ajisrawi/passive-radar-counter-drone/hardware/antenna/ANTENNA.md

# Antennas — multiband passive radar (TV + 4G + 5G)

Generated by `antenna_design.py` (closed-form design equations and array-factor math; all numbers are in
`design.json`). There is no EM simulation behind these numbers: **every element must be checked on a VNA and
trimmed** (see *Tuning*). The pattern figures use an infinite-reflector model, so they show the front
half-space only.

## What one site needs

Each Board A2 build (one per band group) takes 6 SMA inputs:

| A2 input | Antenna | Points at |
|---|---|---|
| CH0 | Reference LPDA | Stack A's transmitter |
| CH1–CH4 | Surveillance panel, 4 elements | The protected sector, away from the transmitters |
| CH5 (the spare) | Second reference LPDA | Stack B's transmitter, when it is on another mast (e.g. UHF: the TV tower for stack A, an LTE B20 site for stack B). If both stacks use the same mast, split CH0's antenna instead, or use CH5 as an elevation element above CH1 |

| Band group | Services | Surveillance panel | Reference |
|---|---|---|---|
| `uhf` 470–821 MHz | DVB-T, LTE B28/B20, 5G n28 | 4 bowtie dipoles, 180 mm pitch | LPDA-U (aluminium) |
| `mid` 1805–2170 MHz | LTE B3, B1 | 4 dipoles, 69 mm pitch | LPDA-H (PCB) |
| `high` 2496–2690 MHz | LTE B7, 5G n41 | 4 dipoles, 56 mm pitch | LPDA-H (PCB) |
| `n78` 3300–3800 MHz | 5G n78 | 4 dipoles, 39 mm pitch | LPDA-H (PCB) |

One LPDA-H design (1.7–4.0 GHz) serves all three 4G/5G groups. Build one per base-station mast used.

## Polarization: +45° slant everywhere

The DVB-T polarization at the site is unknown, so every element and both LPDAs are tilted +45°:
- **4G/5G:** base stations transmit on ±45° cross-polar ports, so a +45° antenna matches one port fully.
- **DVB-T:** a +45° antenna receives either horizontal or vertical TV with a 3 dB loss. That costs about 16% of TV detection range.

If you later learn the TV polarization, you can rotate the UHF elements' stems by 45° to match it. The reflector and pitch stay the same.

## Surveillance element: slant dipole with built-in balun over a flanged reflector

```
     front-face arm (RF) ◄──────┐┌──────► back-face arm (GND)       rotated +45° in the reflector plane
                                ││  ← stem: front strip widens 2.81 → 4 mm, back ground narrows 12 → 4 mm
                                ││     (microstrip-to-parallel-strip taper over the stem height = the balun)
   ════════════════════════════╡╞════════════════════  reflector, slot 16.4 × 2 mm, notches on the stem mark it
                                └┘ edge-mount SMA, behind the reflector
```

- **Board:** FR-4, 1.6 mm, 2 layers, standing at right angles to the reflector. One T-shaped PCB per element.
- **Type:** a double-sided printed dipole, so no vias are needed in the RF path.
- **Front face (net RF):** a 50 Ω microstrip, 2.81 mm wide by OpenBoard's field solver, runs from the SMA up the stem. It widens to a 4 mm parallel strip and becomes the left arm.
- **Back face (net GND):** the microstrip's 12 mm ground narrows to 4 mm along the stem and becomes the right arm.
- **Balun:** the taper runs over the stem height above the reflector, about λ/4. That taper is the balun.

| | `uhf` | `mid` | `high` | `n78` |
|---|---|---|---|---|
| Arm shape | bowtie (w → 2w) | strip | strip | strip |
| Resonance (MHz) | 559 | 1979 | 2591 | 3541 |
| Dipole length, tip to tip (mm) | 221.6 | 54.4 | 40.6 | 29.1 |
| Arm width w at the gap (mm) | 41.0 | 7.6 | 5.8 | 4.2 |
| Arm centre line above reflector (mm) | 120.7 | 37.9 | 28.9 | 21.2 |
| Balun taper length (mm) | 78.7 | 33.1 | 25.0 | 18.1 |
| Element PCB, overall (mm) | 227.6 × 176.7 | 60.4 × 56.7 | 46.6 × 46.8 | 35.1 × 38.3 |
| Reflector plane, from the top edge (mm) | 164.7 | 44.7 | 34.8 | 26.3 |
| Expected match | VSWR < 2 over ~520–821 MHz, < 3 at 470 MHz | VSWR < 2 | VSWR < 2 | VSWR < 2 |

The 54% UHF band is the hard case. The bowtie is sized to resonate at 0.9 × the band centre (559 MHz), so the bottom of the TV band isn't far below resonance. The expected cost is about 1.2 dB of mismatch loss at 470 MHz.

## Panel (reflector) and array

- **Element positions:** 4 elements on one reflector, at the pitch below (λ/2 at the top of each band).
- **Reflector length:** the array length plus 0.75 × the reflector width.
- **Flanges:** folded back along both long edges. With the reflector width of ≥ 0.8 λ, they are what gives the ≥ 20 dB front-to-back that the direct-signal budget needs (DESIGN.md §5).

| | `uhf` | `mid` | `high` | `n78` |
|---|---|---|---|---|
| Pitch d (mm) | 180 | 69 | 56 | 39 |
| Reflector L × W (mm) | 851 × 415 | 298 × 121 | 237 × 93 | 168 × 68 |
| Flange height (mm) | 72 | 23 | 17 | 13 |

Predicted performance (model, band low / centre / high):

| | `uhf` | `mid` | `high` | `n78` |
|---|---|---|---|---|
| Element gain (dBi) | 7.3 / 6.6 / 6.3 | 6.8 / 6.5 / 6.2 | 6.6 / 6.5 / 6.4 | 6.7 / 6.5 / 6.3 |
| Element beamwidth, azimuth (°) | 85 / 95 / 116 | 93 / 97 / 103 | 95 / 97 / 100 | 94 / 98 / 102 |
| Array beam at broadside (°) | 48 / 36 / 27 | 32 / 29 / 26 | 28 / 27 / 26 | 31 / 29 / 27 |
| Sidelobes at broadside (dB) | −33 / −18 / −12 | −16 / −15 / −13 | −15 / −14 / −14 | −16 / −15 / −14 |
| Sidelobes / scan loss steered to ±50° | −10 / 4.3 dB … −10 / 1.6 dB | ≈ −9 / 3 dB | ≈ −9 / 3 dB | ≈ −9 / 3 dB |
| Grating lobes | none | none | none | none |

**Coverage:** the usable sector per panel is **±50°** (100°). Beyond that, sidelobes rise and scan loss passes 3 dB. For 360°, use **4 panels per band**, or several sites. At the bottom of the UHF band (d = 0.28 λ), the beam widens to 48°, so TV direction finding there is coarser. Bistatic-range multilateration across several transmitters (DESIGN.md §7) covers for it.

Figures: `panel_<band>.png` (front view to scale) and `patterns_<band>.png` (element and array patterns at band low/centre/high, steered 0° and 45°).

## Reference antennas: log-periodic dipole arrays (Carrel design, τ = 0.88, σ = 0.16, α = 10.6°)

| | LPDA-U | LPDA-H |
|---|---|---|
| Band | 450–870 MHz | 1700–4000 MHz |
| Dipoles | 11 | 12 |
| Boom length (mm) | 622 | 168 |
| Longest / shortest dipole (mm) | 323 / 90 | 83.3 / 20.4 |
| Build | aluminium twin boom (below) | printed twin boom, FR-4 1.6 mm, 180.1 × 89.3 mm |
| Gain / front-to-back (typical for these τ, σ) | ≈ 7.5 dBi / ≈ 18 dB | ≈ 7.5 dBi / ≈ 18 dB |

Dipole lengths, longest first (mm):
- **LPDA-U:** 323.1, 284.3, 250.2, 220.2, 193.8, 170.5, 150.1, 132.0, 116.2, 102.3, 90.0
- **LPDA-H:** 83.3, 73.3, 64.5, 56.8, 50.0, 44.0, 38.7, 34.0, 30.0, 26.4, 23.2, 20.4

Spacings, from the long end (mm):
- **LPDA-U:** 103.4, 91.0, 80.1, 70.5, 62.0, 54.6, 48.0, 42.3, 37.2, 32.7
- **LPDA-H:** 26.7, 23.5, 20.6, 18.2, 16.0, 14.1, 12.4, 10.9, 9.6, 8.4, 7.4

How they're built:
- **LPDA-U:**
  - two 12 mm square aluminium booms, 8 mm apart;
  - 4 mm rod half-elements alternating between the booms;
  - semi-rigid coax run inside one boom (an "infinite balun"), fed at the short end, with the booms shorted at the long end.
- **LPDA-H:**
  - the same structure printed on FR-4: a 3 mm boom on each face (RF in front, GND behind), with 1.5 mm half-dipoles;
  - each dipole has one half on the front face and one on the back, swapping sides from one dipole to the next (the feed transposition);
  - fed by an edge-mount SMA at the short end. Run the cable back along the boom's centre line, where the dipoles' fields cancel.

**Mounting:** tilt each reference +45° to match the panels, aim it at its transmitter, and mount it on the far side of the mast from the surveillance panels.

**Gain check:** DESIGN.md §5 assumed a 12 dBi reference Yagi, giving a reference SNR of +70.8 dB. With 7.5 dBi it's about +66 dB. That's still well above the requirement of +53.8 dB, which is the direct-signal level in the surveillance channel plus 10 dB. The 4G/5G cells are usually much closer than the TV tower, so their margin is larger.

## Cables and calibration

Board A2's noise source calibrates everything from its input switch onward. **The antenna cables are outside that calibration.**

- **Cables:** use a phase-matched set for CH1–CH4 (±2° at the top of the band, e.g. LMR-240 or RG-402 cut as one batch), of equal length.
- **Residual cable error:** remove it with a one-time far-field calibration. The direct signal from the transmitter, whose bearing is known from the map, is a free calibration source; repeat it after any cable change.
- **Mutual coupling:** about −15 dB between neighbouring elements at λ/2. The same far-field calibration (a coupling matrix measured at a few known bearings) removes it for DOA.

## Tuning (VNA)

1. **Resonance:** trim both arm tips equally (copper and board together) until S11 has its minimum at the resonance in the table. If the resonance comes out low, that's the fix. If it's high, change `dipole_length_mm` in `antenna_design.py` and regenerate.
2. **Match:** the balun has no stub to trim. If S11 is poor across the band, change the 4 mm parallel-strip width (`W_PS` in `antenna_pcbs.py`). Wider lowers the feed impedance. Target VSWR < 2; for UHF, < 3 at 470 MHz is expected.
3. **Front-to-back:** check against the transmitter with the panel facing away. If it's below 20 dB, raise the flanges, or add an RF fence or terrain shielding (DESIGN.md §6.1).
4. **LPDAs:** if the low end is weak, trim the shortest dipoles last. S11 at the low edge is set by the longest dipole.
5. **Radome:** do steps 1–2 with the radome cover fitted, since it pulls resonance down slightly. See `RADOME.md`.

## Radomes

All four surveillance panels share one radome. The UHF panel is on top, the three 4G/5G panels sit in a row below, and there is one aluminium tray and one moulded GRP cover: 3 mm over UHF, 2 mm over the 4G/5G window, with a rib between. Separate per-panel radomes remain an alternative. The LPDA-H gets an ASA paddle radome. Dry loss is under 0.45 dB in every band out to ±50°, and a water film costs up to 2.9 dB at n78. Sizes, losses, wind loads and renders are in `RADOME.md`.

## Limits of this design

- **No EM simulation:** you chose formulas only. Gain, beamwidth and sidelobes come from a thin-dipole, infinite-reflector model. Real panels will have about 1 dB less gain at band edges, and their front-to-back depends on the flange details.
- **Matching estimates** come from published results for printed dipoles of this kind, not from calculation. Plan one test build per band before ordering a full set.
- **Sheet metal is drawing-only:** the reflectors, flanges and LPDA-U are given as dimensions, not CAD files.

## PCBs (OpenBoard)

Generated by `antenna_pcbs.py` from `design.json`, into `pcb/<name>/`. Each folder has:
- the OpenBoard project;
- `fab/<name>-fab.zip` (Gerbers and drill);
- `fab/<name>-BOM.csv` and `fab/<name>-CPL.csv`;
- a copper preview `<name>.png`;
- `<name>_openems.py`, a full-wave openEMS model of the copper with a port at the SMA. You can run it later if you install openEMS.

| Board | Size (mm) | DRC | Parts |
|---|---|---|---|
| `dipole_uhf` | 227.6 × 176.7 | 0 errors | 1 × edge SMA |
| `dipole_mid` | 60.4 × 56.7 | 0 errors | 1 × edge SMA |
| `dipole_high` | 46.6 × 46.8 | 0 errors | 1 × edge SMA |
| `dipole_n78` | 35.1 × 38.3 | 0 errors | 1 × edge SMA |
| `lpda_h` | 180.1 × 89.3 | 0 errors | 1 × edge SMA |

- **Build:** order as FR-4 1.6 mm, 2 layers, 1 oz, any colour.
- **Antenna copper:** fixed copper shapes (static zones), so the Gerbers carry it exactly as drawn.
- **Connector:** an edge-mount SMA for 1.6 mm boards (Samtec SMA-J-P-H-ST-EM1 footprint), soldered on both faces. Its back legs have their own pads, marked DNP so they stay out of the BOM.
- **Quantities per site:** 4 elements per band and panel (×4 panels for 360°), plus 1 LPDA-H per 4G/5G base-station mast used.
- **50 Ω width:** 2.81 mm, field-solved for this stack-up (εr 4.4, 1.53 mm core). The 3.08 mm Hammerstad estimate earlier in this file is superseded.
