ajisrawi/passive-radar-counter-drone/hardware/antenna/lpda_H.png

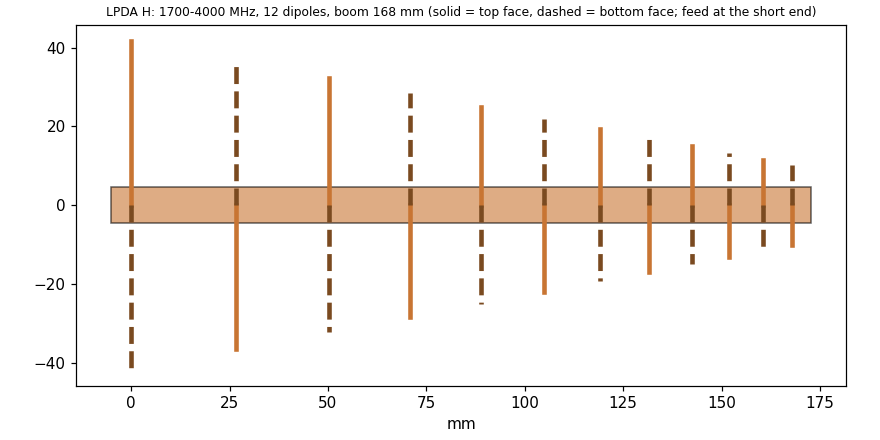
hardware/antenna/lpda_H.png
