ajisrawi/passive-radar-counter-drone/hardware/antenna/lpda_U.png

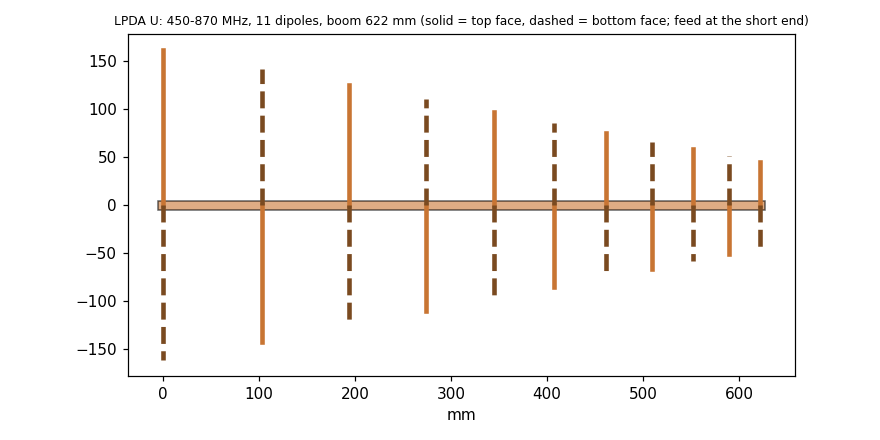
hardware/antenna/lpda_U.png
