ajisrawi/passive-radar-counter-drone/hardware/antenna/panel_high.png

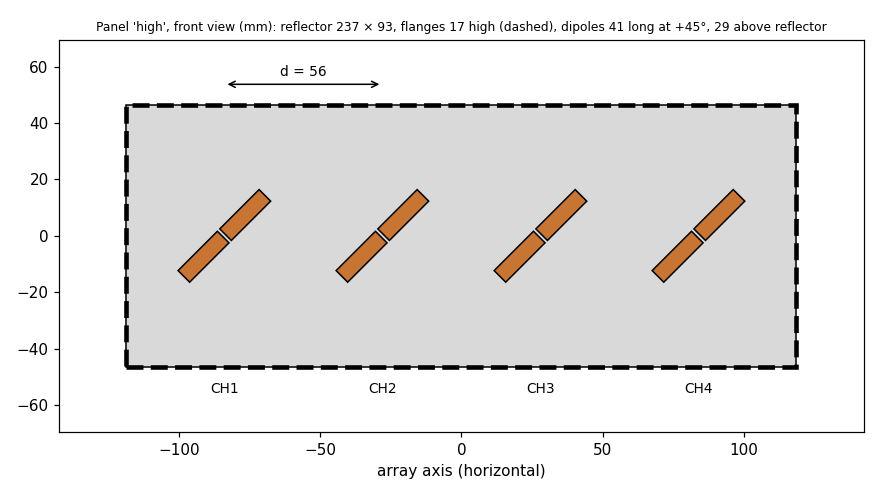
hardware/antenna/panel_high.png
