ajisrawi/passive-radar-counter-drone/hardware/antenna/panel_mid.png

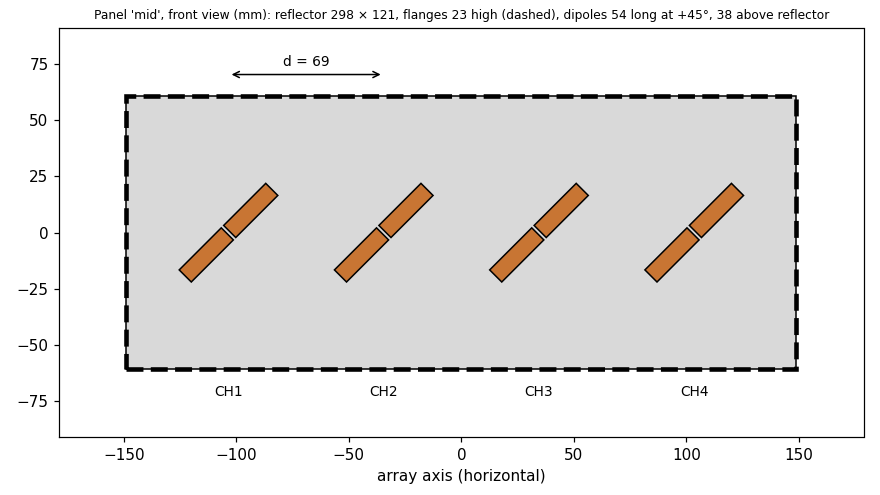
hardware/antenna/panel_mid.png
