ajisrawi/passive-radar-counter-drone/hardware/antenna/panel_n78.png

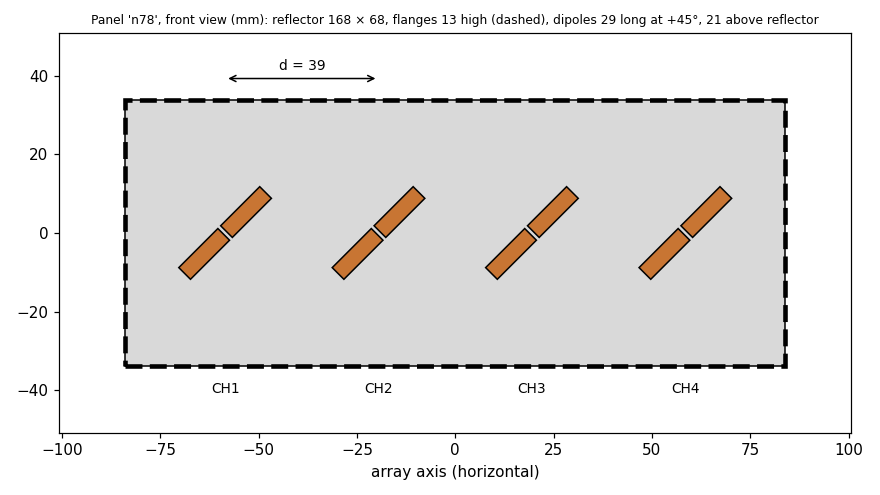
hardware/antenna/panel_n78.png
