ajisrawi/passive-radar-counter-drone/hardware/antenna/panel_uhf.png

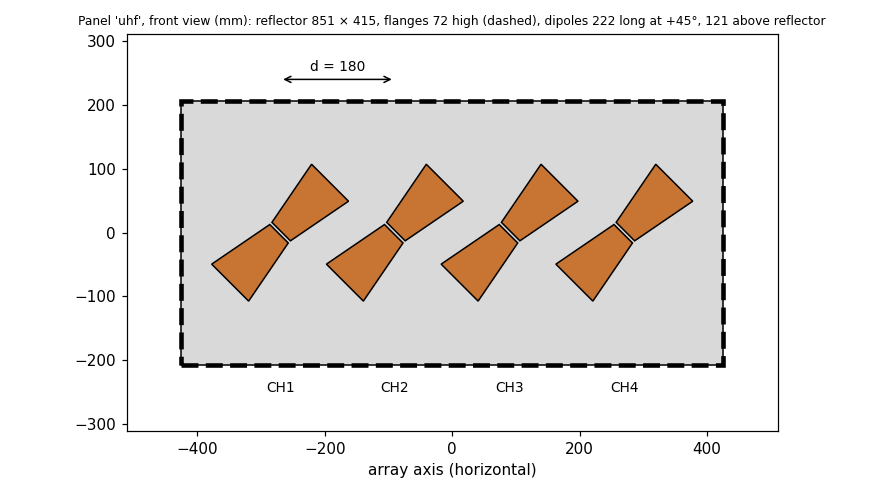
hardware/antenna/panel_uhf.png
