ajisrawi/passive-radar-counter-drone/hardware/antenna/patterns_high.png

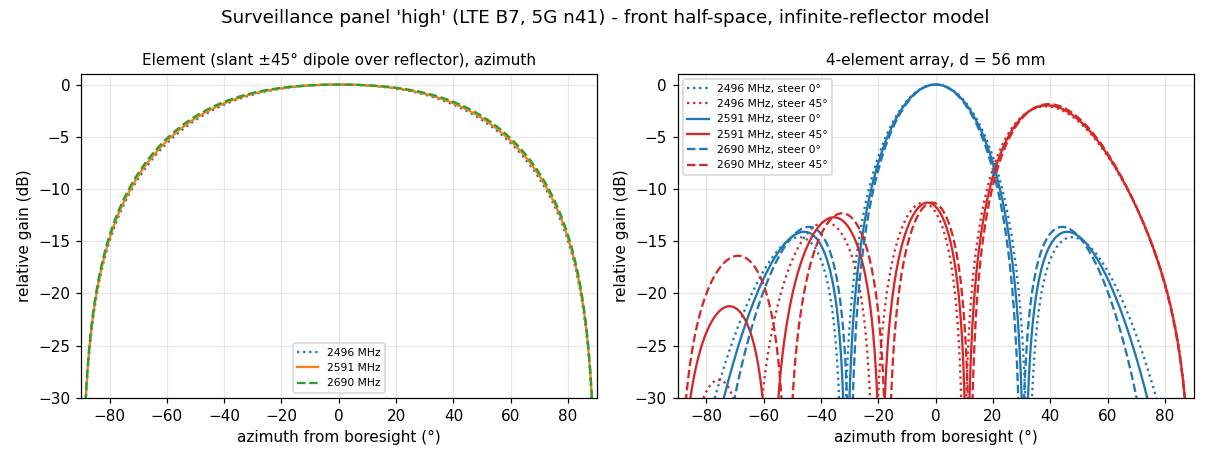
hardware/antenna/patterns_high.png
