ajisrawi/passive-radar-counter-drone/hardware/antenna/patterns_mid.png

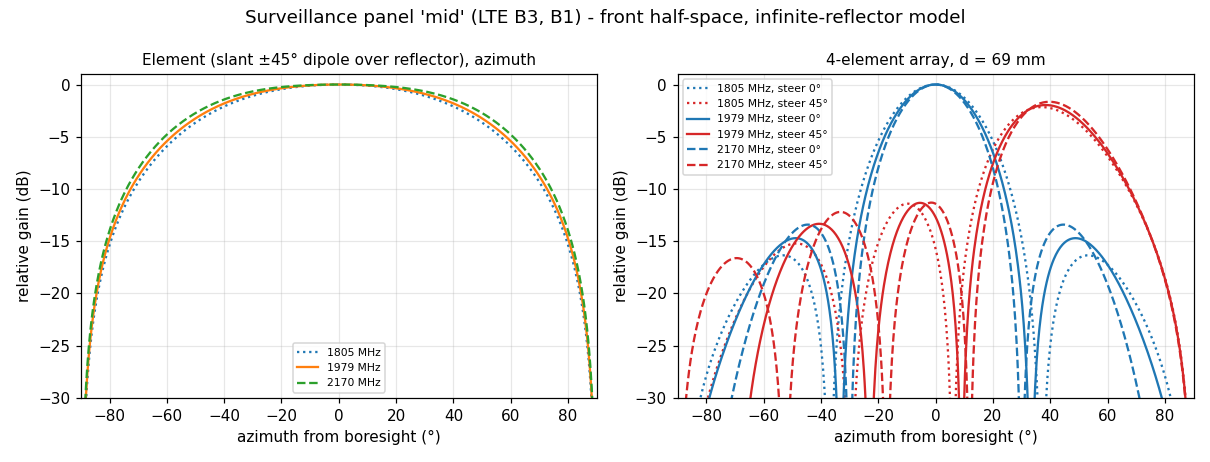
hardware/antenna/patterns_mid.png
