ajisrawi/passive-radar-counter-drone/hardware/enclosure/render_exterior.png

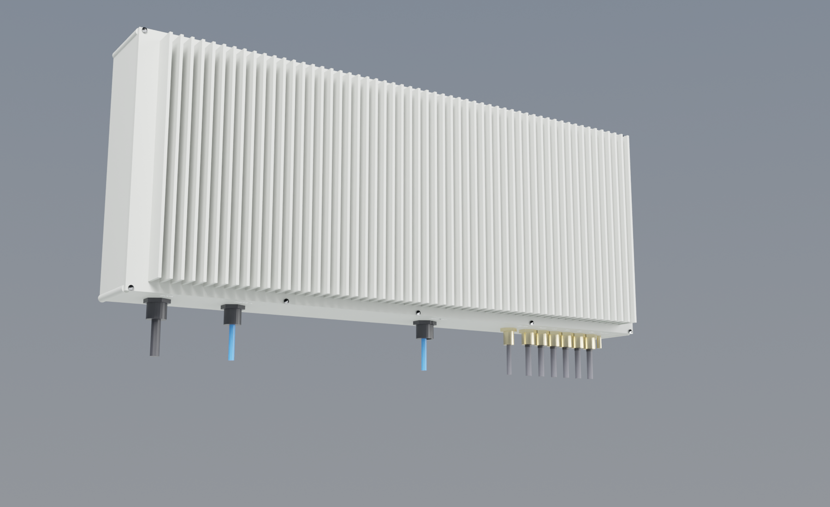
hardware/enclosure/render_exterior.png
