ajisrawi/passive-radar-counter-drone/hardware/enclosure/render_interior.png

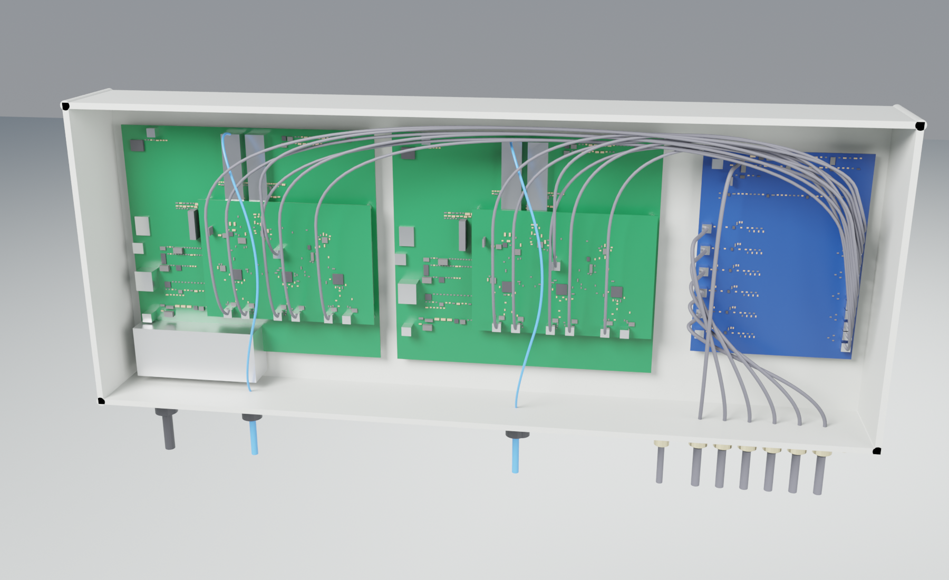
hardware/enclosure/render_interior.png
