ajisrawi/passive-radar-counter-drone/hardware/enclosure/render_mast.png

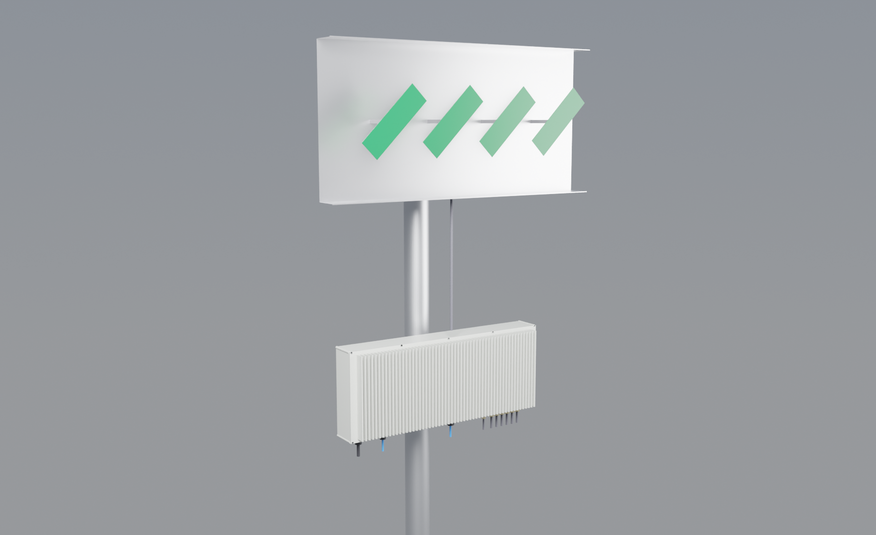
hardware/enclosure/render_mast.png
