ajisrawi/passive-radar-counter-drone/hardware/release/board_a/board_a_bottom.png

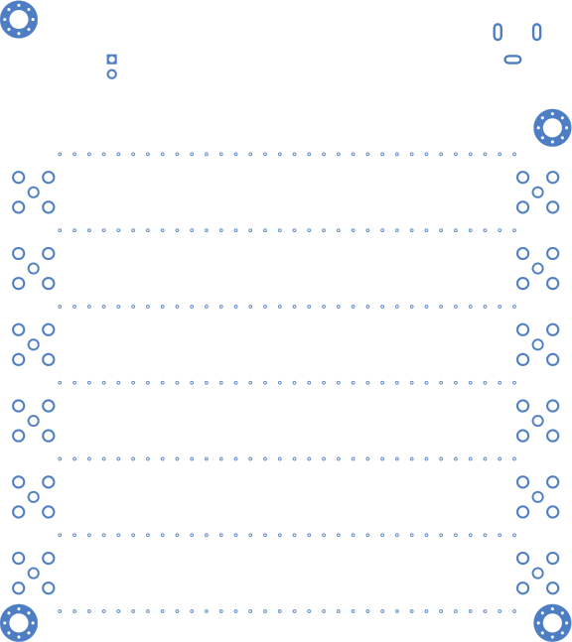
hardware/release/board_a/board_a_bottom.png
