ajisrawi/passive-radar-counter-drone/hardware/release/board_a/board_a_top.png

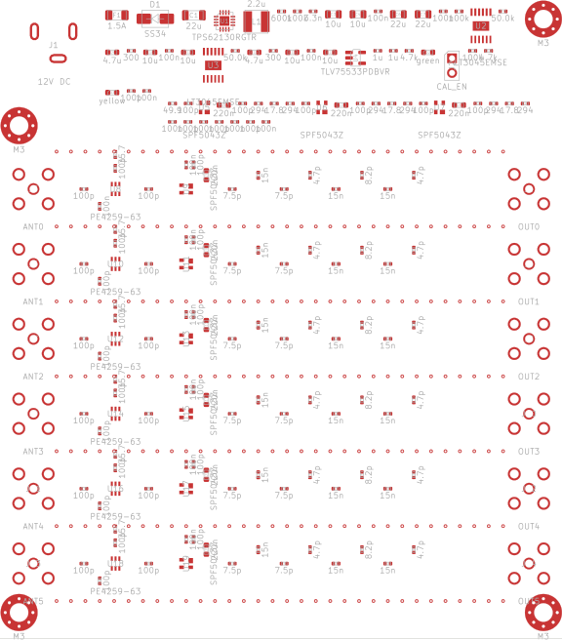
hardware/release/board_a/board_a_top.png
