ajisrawi/passive-radar-counter-drone/hardware/release/board_b/board_b_bottom.png

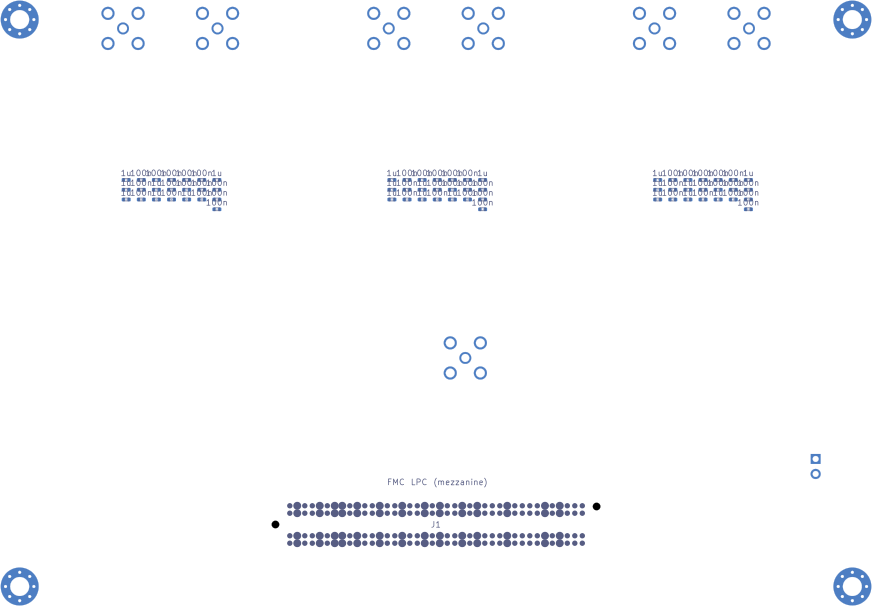
hardware/release/board_b/board_b_bottom.png
