ajisrawi/passive-radar-counter-drone/hardware/release/board_b/board_b_top.png

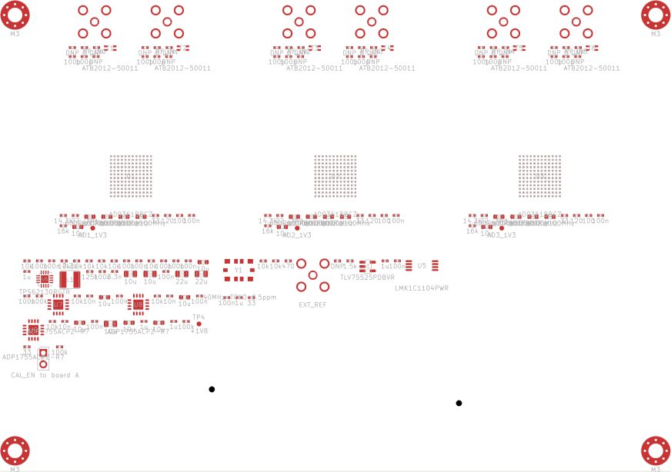
hardware/release/board_b/board_b_top.png
