ajisrawi/passive-radar-counter-drone/hardware/release/board_c/board_c_bottom.png

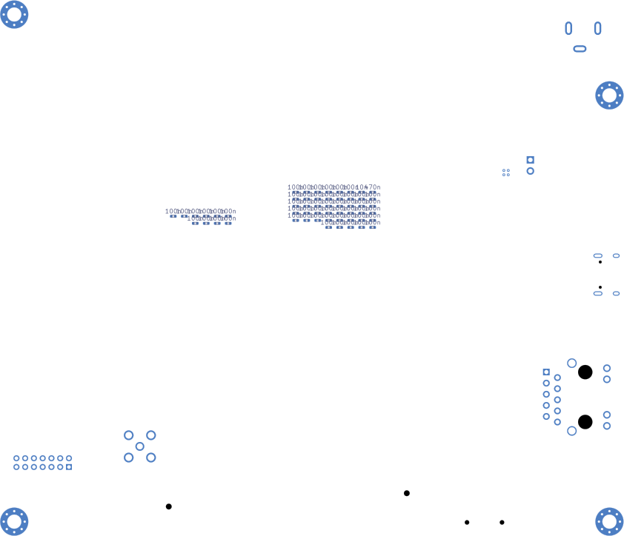
hardware/release/board_c/board_c_bottom.png
