ajisrawi/passive-radar-counter-drone/hardware/release/board_c/board_c_top.png

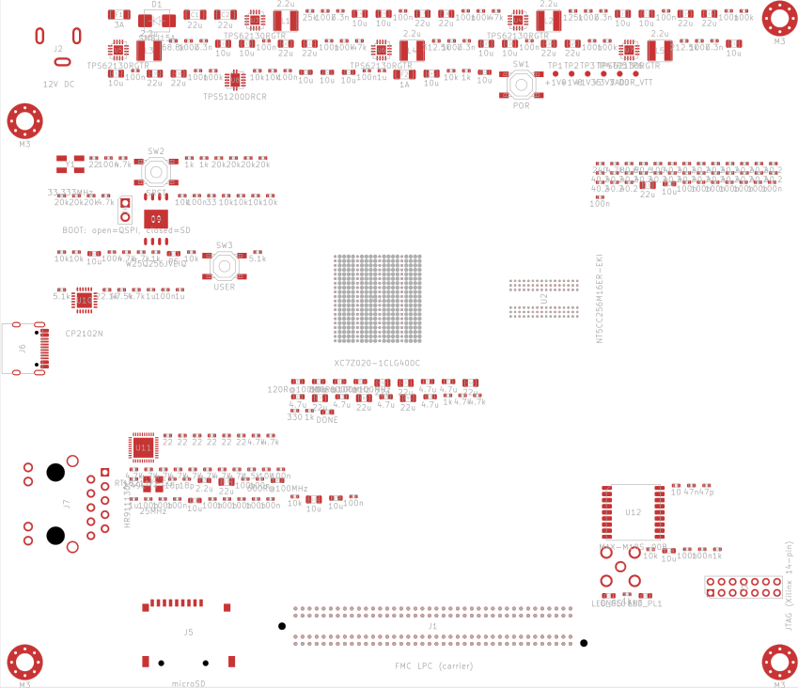
hardware/release/board_c/board_c_top.png
