ajisrawi/passive-radar-counter-drone/hardware/board_c2/basic_fab/board_c2_basic-BOM.csv

Comment | Designator | Footprint | JLCPCB Part #
22u | C1,C2,C3 | C_1206_3216Metric
3.3n | C4,C11,C18,C25,C32,C39,C46 | C_0402_1005Metric
10u | C5,C6,C12,C13,C19,C20,C26,C27,C33,C34,C40,C41,C47,C48,C61,C240 | C_0805_2012Metric
100n | C7,C10,C14,C17,C21,C24,C28,C31,C35,C38,C42,C45,C49,C52,C53,C58,C66,C73,C74,C75,C76,C77,C78,C79,C80,C81,C82,C83,C84,C85,C86,C90,C91,C92,C93,C94,C95,C96,C97,C98,C99,C102,C103,C104,C105,C106,C107,C108,C109,C112,C113,C114,C115,C116,C117,C120,C121,C122,C123,C124,C125,C126,C127,C131,C132,C133,C134,C135,C136,C137,C138,C139,C140,C144,C145,C146,C147,C148,C149,C150,C151,C152,C153,C155,C156,C157,C159,C161,C167,C168,C169,C170,C171,C172,C173,C174,C175,C176,C177,C178,C179,C180,C181,C182,C183,C184,C185,C186,C187,C188,C189,C190,C191,C192,C193,C194,C195,C196,C197,C198,C199,C200,C201,C203,C205,C206,C207,C208,C209,C211,C213,C215,C216,C217,C218,C219,C223,C224,C226,C227,C228,C230,C231,C232,C233,C234,C237,C238,C239,C242 | C_0402_1005Metric | C1525
22u | C8,C9,C15,C16,C22,C23,C29,C30,C36,C37,C43,C44,C50,C51,C59,C69,C70,C87,C100,C110,C118,C128,C141,C163,C164,C202,C204,C210,C212,C222 | C_0805_2012Metric | C45783
10u | C54,C55,C56,C57,C62,C63,C158,C165,C166,C214,C229,C236,C241 | C_0603_1608Metric | C19702
1u | C60,C160,C162,C225 | C_0402_1005Metric | C52923
470n | C64 | C_0402_1005Metric
10n | C65 | C_0402_1005Metric | C15195
47u | C67,C68 | C_1206_3216Metric
4.7u | C71,C72,C88,C89,C101,C111,C119,C129,C130,C142,C143,C154 | C_0603_1608Metric
18p | C220,C221 | C_0402_1005Metric
47p | C235 | C_0402_1005Metric
SMBJ15A | D1 | D_SMB
DONE | D2 | LED_0603_1608Metric
PS | D3 | LED_0603_1608Metric
LED_PL0 | D4 | LED_0603_1608Metric
LED_PL1 | D5 | LED_0603_1608Metric
3A | F1 | Fuse_1206_3216Metric
1A | F2 | Fuse_1206_3216Metric
120R@100MHz | FB1,FB2,FB3,FB4 | L_0603_1608Metric
600R@100MHz | FB5,FB6,FB7 | L_0603_1608Metric
FMC LPC (carrier) | J1 | BGA-160_L56.6-W13.2-R4-C40-P1.27-BR | C2836665
12V DC | J2 | DC-IN-TH_DC-005C-20A | C84007
JTAG (Xilinx 14-pin) | J3 | PinHeader_2x07_P2.00mm_Vertical
BOOT: open=QSPI, closed=SD | J4 | PinHeader_1x02_P2.54mm_Vertical
microSD | J5 | TF-SMD_TF-01A | C91145
USB-C console | J6 | USB_C_Receptacle_HRO_TYPE-C-31-M-12 | C165948
SFP+ port 0 | J7 | Connector_SFP_and_Cage | C305914
SFP+ port 1 | J8 | Connector_SFP_and_Cage | C305914
HR911130C | J9 | RJ45-TH_HR911130C | C50933
GNSS ANT | J10 | SMA-TH_BWSMA-KE-Z001 | C496549
2.2u | L1,L2,L3,L4,L5,L6,L7 | L_Bourns-SRN4018
1u | L8,L9,L10,L11 | L_0805_2012Metric
2.2u | L12 | L_0603_1608Metric
47n | L13 | L_0402_1005Metric
25k | R1,R8 | R_0402_1005Metric
100k | R2,R3,R6,R7,R9,R10,R13,R14,R17,R18,R20,R21,R23,R24 | R_0402_1005Metric | C25741
47k | R4,R11,R15,R25 | R_0402_1005Metric
125k | R5 | R_0402_1005Metric
68.8k | R12 | R_0402_1005Metric
312.5k | R16 | R_0402_1005Metric
212.5k | R19 | R_0402_1005Metric
50k | R22 | R_0402_1005Metric
10k | R26,R27,R28,R29,R30,R31,R52,R54,R55,R56,R57,R58,R59,R65,R118,R136,R139,R142 | R_0402_1005Metric | C25744
1k | R32,R35,R39,R42,R43,R64 | R_0402_1005Metric | C11702
100 | R33,R76,R117 | R_0402_1005Metric
0 | R34 | R_0402_1005Metric | C17168
4.7k | R36,R37,R41,R51,R60,R61,R62,R63,R70,R73,R101,R102,R103,R104,R105,R106,R107,R108,R109,R110,R111,R112,R113,R114,R115,R116,R125,R126,R127,R128,R129,R130,R131,R132,R133,R134 | R_0402_1005Metric | C25900
330 | R38 | R_0402_1005Metric
22 | R40,R119,R120,R121,R122,R123,R124 | R_0402_1005Metric
20k | R44,R45,R46,R47,R48,R49,R50 | R_0402_1005Metric
33 | R53 | R_0402_1005Metric
5.1k | R66,R67 | R_0402_1005Metric | C25905
22.1k | R68 | R_0402_1005Metric
47.5k | R69 | R_0402_1005Metric
240 | R71,R72 | R_0402_1005Metric
80.6 | R74,R75 | R_0402_1005Metric
40.2 | R77,R78,R79,R80,R81,R82,R83,R84,R85,R86,R87,R88,R89,R90,R91,R92,R93,R94,R95,R96,R97,R98,R99,R100 | R_0402_1005Metric
1.5k | R135 | R_0402_1005Metric
2.49k | R137 | R_0402_1005Metric
10 | R138 | R_0402_1005Metric
220 | R140,R141 | R_0402_1005Metric
POR | SW1 | SW_SPST_TL3342
SRST | SW2 | SW_SPST_TL3342
USER | SW3 | SW_SPST_TL3342
XC7Z035-2FFG676I | U1 | FBGA-676_L27.0-W27.0-R26-C26-P1.00-BL | C1884735
NT5CC256M16ER-EKI | U2,U3 | TFBGA-96_L13.0-W8.0-R16-C6-P0.80-TL | C2841153
TPS62130RGTR | U4,U5,U6,U7,U8,U9,U10 | VQFN-16-1EP_3x3mm_P0.5mm_EP1.68x1.68mm | C43590
TPS51200DRCR | U11 | VSON-10-1EP_3x3mm_P0.5mm_EP1.65x2.4mm | C34771
W25Q256JVEIQ | U12 | WSON-8_L8.0-W6.10-P1.27-BL-EP | C97522
CP2102N | U13 | QFN-24_L4.0-W4.0-P0.50-TL-EP2.6 | C969151
TCA9543APWR | U14 | TSSOP-14_L5.0-W4.4-P0.65-LS6.4-BL | C2653307
RTL8211F-CG | U15 | WQFN-40_L5.0-W5.0-P0.4-BL-EP | C187932
MAX-M10S-00B | U16 | ublox_MAX | C4153167
33.333MHz | Y1 | OSC-SMD_4P-L5.0-W3.2-BL_OG8EL89CEI | C5346412
156.25MHz LVDS | Y2 | OSC-SMD_6P-L3.2-W2.5-BL-1 | C7425469
25MHz | Y3 | CRYSTAL-SMD_4P-L3.2-W2.5-BL | C9006
