ajisrawi/passive-radar-counter-drone/hardware/antenna/pcb/dipole_high/fab/dipole_high-BOM.csv

Comment | Designator | Footprint | JLCPCB Part #
SMA edge 1.6mm | J1 | SMA_Samtec_SMA-J-P-H-ST-EM1_EdgeMount
