ajisrawi/passive-radar-counter-drone/hardware/release/board_b/board_b_BOM_JLCPCB.csv

Comment | Designator | Footprint | LCSC Part # | MPN | Qty
100n | C2,C3,C4,C5,C6,C8,C9,C10,C11,C13,C15,C16,C18,C20,C21,C22,C24,C25,C26,C27,C28,C30,C31,C32,C33,C35,C37,C38,C40,C42,C43,C44,C46,C47,C48,C49,C50,C52,C53,C54,C55,C57,C59,C60,C62,C64,C65,C66,C85,C89,C90,C92,C93,C94,C98,C101,C104,C107,C110,C113,C116,C119 | C_0402_1005Metric | C1525 |  | 62
1u | C1,C7,C12,C14,C17,C19,C23,C29,C34,C36,C39,C41,C45,C51,C56,C58,C61,C63,C87,C88,C91,C106,C112,C118,C122,C124 | C_0402_1005Metric | C52923 |  | 26
100p | C67,C68,C70,C71,C73,C74,C76,C77,C79,C80,C82,C83 | C_0402_1005Metric |  |  | 12
10u | C86,C103,C105,C109,C111,C115,C117,C121,C123 | C_0603_1608Metric | C19702 |  | 9
10u | C96,C97,C120 | C_0805_2012Metric |  |  | 3
10n | C102,C108,C114 | C_0402_1005Metric | C15195 |  | 3
22u | C99,C100 | C_0805_2012Metric | C45783 |  | 2
3.3n | C95 | C_0402_1005Metric |  |  | 1
600R@100MHz | FB1,FB2,FB3,FB4,FB5,FB6,FB7,FB8,FB9,FB10,FB11,FB12 | L_0603_1608Metric |  |  | 12
RF_IN0 | J2 | SMA-TH_BWSMA-KE-Z001 | C496549 | BWSMA-KE-Z001 | 1
RF_IN1 | J3 | SMA-TH_BWSMA-KE-Z001 | C496549 | BWSMA-KE-Z001 | 1
RF_IN2 | J4 | SMA-TH_BWSMA-KE-Z001 | C496549 | BWSMA-KE-Z001 | 1
RF_IN3 | J5 | SMA-TH_BWSMA-KE-Z001 | C496549 | BWSMA-KE-Z001 | 1
RF_IN4 | J6 | SMA-TH_BWSMA-KE-Z001 | C496549 | BWSMA-KE-Z001 | 1
RF_IN5 | J7 | SMA-TH_BWSMA-KE-Z001 | C496549 | BWSMA-KE-Z001 | 1
EXT_REF | J8 | SMA-TH_BWSMA-KE-Z001 | C496549 | BWSMA-KE-Z001 | 1
FMC LPC (mezzanine) | J1 | FPC_SMD_ASP-134604-01 | C2830435 | ASP-134604-01 | 1
CAL_EN to board A | J9 | PinHeader_1x02_P2.54mm_Vertical |  |  | 1
2.2u | L1 | L_Bourns-SRN4018 |  | SRN4018-2R2M | 1
10k | R3,R4,R5,R6,R7,R10,R13,R32,R33,R51,R53,R55 | R_0402_1005Metric | C25744 |  | 12
0 | R15,R18,R21,R24,R27,R30 | R_0402_1005Metric | C17168 |  | 6
33 | R37,R40,R43,R46,R57 | R_0402_1005Metric |  |  | 5
100k | R48,R49,R56,R58 | R_0402_1005Metric | C25741 |  | 4
14.3k | R1,R8,R11 | R_0402_1005Metric |  |  | 3
22 | R2,R9,R12 | R_0402_1005Metric |  |  | 3
120 | R38,R41,R44 | R_0402_1005Metric |  |  | 3
100 | R39,R42,R45 | R_0402_1005Metric |  |  | 3
16k | R50,R52,R54 | R_0402_1005Metric |  |  | 3
470 | R34 | R_0402_1005Metric |  |  | 1
1.5k | R36 | R_0402_1005Metric |  |  | 1
125k | R47 | R_0402_1005Metric |  |  | 1
ATB2012-50011 | T1,T2,T3,T4,T5,T6 | XFMR-SMD_ATB2012-50011-T000 | C92015 | ATB2012-50011-T000 | 6
AD9361BBCZ | U1,U2,U3 | CSPBGA-144_L10.0-W10.0-R12-C12-P0.80-BL | C515884 | AD9361BBCZ | 3
ADP1755ACPZ-R7 | U7,U8,U9 | LFCSP-16_L4.0-W4.0-P0.65-BL-EP2.2 | C403695 | ADP1755ACPZ-R7 | 3
TLV75525PDBVR | U4 | SOT-23-5 |  |  | 1
LMK1C1104PWR | U5 | TSSOP-8_L4.4-W3.0-P0.65-LS6.4-TL | C1855734 | LMK1C1104PWR | 1
TPS62130RGTR | U6 | VQFN-16-1EP_3x3mm_P0.5mm_EP1.68x1.68mm | C43590 | TPS62130RGTR | 1
40MHz TCXO 0.5ppm | Y1 | OSC-SMD_10P-L7.0-W5.0-BL | C516506 | BT0507BH3I507BN40B | 1
