ajisrawi/passive-radar-counter-drone/hardware/board_a2/high/fab/board_a2_high-BOM.csv

Comment | Designator | Footprint | JLCPCB Part #
22u | C1 | C_1206_3216Metric
3.3n | C2 | C_0402_1005Metric
10u | C3,C4 | C_0805_2012Metric
100n | C5,C8,C11,C13,C16,C18,C21,C23,C26,C27,C30,C34,C38,C44,C47,C53,C56,C62,C65,C71,C74,C80,C83,C89,C92 | C_0402_1005Metric | C1525
22u | C6,C7 | C_0805_2012Metric | C45783
4.7u | C9,C14,C19 | C_0603_1608Metric
10u | C10,C12,C15,C17,C20,C22 | C_0603_1608Metric | C19702
1u | C24,C25 | C_0402_1005Metric | C52923
22p | C28,C31,C32,C35,C36,C39,C40,C41,C42,C45,C48,C49,C50,C51,C54,C57,C58,C59,C60,C63,C66,C67,C68,C69,C72,C75,C76,C77,C78,C81,C84,C85,C86,C87,C90,C93 | C_0402_1005Metric
100p | C29,C33,C37,C43,C46,C52,C55,C61,C64,C70,C73,C79,C82,C88,C91 | C_0402_1005Metric
SS34 | D1 | D_SMA | C8678
green | D2 | LED_0603_1608Metric
yellow | D3 | LED_0603_1608Metric
1.5A | F1 | Fuse_1206_3216Metric
DEA162495BT-1289A1 | FL1,FL2,FL3,FL4,FL5,FL6 | FILTER-SMD_0603-4P-L1.8-W0.8-L | C432966
12V DC | J1 | DC-IN-TH_DC-005C-20A | C84007
CAL_EN | J2 | PinHeader_1x02_P2.54mm_Vertical
ANT0 | J3 | SMA-TH_BWSMA-KE-Z001 | C496549
OUT0A | J4 | SMA-TH_BWSMA-KE-Z001 | C496549
OUT0B | J5 | SMA-TH_BWSMA-KE-Z001 | C496549
ANT1 | J6 | SMA-TH_BWSMA-KE-Z001 | C496549
OUT1A | J7 | SMA-TH_BWSMA-KE-Z001 | C496549
OUT1B | J8 | SMA-TH_BWSMA-KE-Z001 | C496549
ANT2 | J9 | SMA-TH_BWSMA-KE-Z001 | C496549
OUT2A | J10 | SMA-TH_BWSMA-KE-Z001 | C496549
OUT2B | J11 | SMA-TH_BWSMA-KE-Z001 | C496549
ANT3 | J12 | SMA-TH_BWSMA-KE-Z001 | C496549
OUT3A | J13 | SMA-TH_BWSMA-KE-Z001 | C496549
OUT3B | J14 | SMA-TH_BWSMA-KE-Z001 | C496549
ANT4 | J15 | SMA-TH_BWSMA-KE-Z001 | C496549
OUT4A | J16 | SMA-TH_BWSMA-KE-Z001 | C496549
OUT4B | J17 | SMA-TH_BWSMA-KE-Z001 | C496549
ANT5 | J18 | SMA-TH_BWSMA-KE-Z001 | C496549
OUT5A | J19 | SMA-TH_BWSMA-KE-Z001 | C496549
OUT5B | J20 | SMA-TH_BWSMA-KE-Z001 | C496549
2.2u | L1 | L_Bourns-SRN4018
100n | L2,L3,L4,L5,L6,L7,L8,L9,L10,L11,L12,L13,L14,L15,L16 | L_0603_1608Metric
600k | R1 | R_0402_1005Metric
100k | R2,R3,R11 | R_0402_1005Metric | C25741
50.0k | R4,R6,R8 | R_0402_1005Metric
300 | R5,R7,R9 | R_0402_1005Metric
4.7k | R10,R12 | R_0402_1005Metric | C25900
49.9 | R13 | R_0402_1005Metric
294 | R14,R16,R17,R19,R20,R22 | R_0402_1005Metric
17.8 | R15,R18,R21 | R_0402_1005Metric
35.7 | R23,R24,R25,R26,R27,R28 | R_0402_1005Metric
16.5 | R29,R30,R31,R32,R33,R34,R35,R36,R37,R38,R39,R40,R41,R42,R43,R44,R45,R46 | R_0402_1005Metric
TPS62130RGTR | U1 | VQFN-16-1EP_3x3mm_P0.5mm_EP1.68x1.68mm | C43590
LT3045EMSE | U2,U3,U4 | MSOP-12_L4.0-W3.0-P0.65-LS4.9-BL-EP | C580012
TLV75533PDBVR | U5 | SOT-23-5 | C404027
SN74LVC1G04DBVR | U6 | SOT-23-5_L3.0-W1.7-P0.95-LS2.8-BR | C7827
SPF5043Z | U7,U8,U9,U11,U12,U14,U15,U17,U18,U20,U21,U23,U24,U26,U27 | SOT343_L2.0-W1.3-P1.30-LS2.1-BL | C470902
SKY13351-378LF | U10,U13,U16,U19,U22,U25 | DFN-6_L1.0-W1.0-P0.35-BL-EP0.15 | C129189
