ajisrawi/passive-radar-counter-drone/(list of files, cad)

Other CAD files:
hardware/antenna/radome.blend
hardware/enclosure/enclosure.blend
hardware/enclosure/enclosure_all.blend
