ajisrawi/passive-radar-counter-drone/hardware/board_a/board_a_schematic.pdf

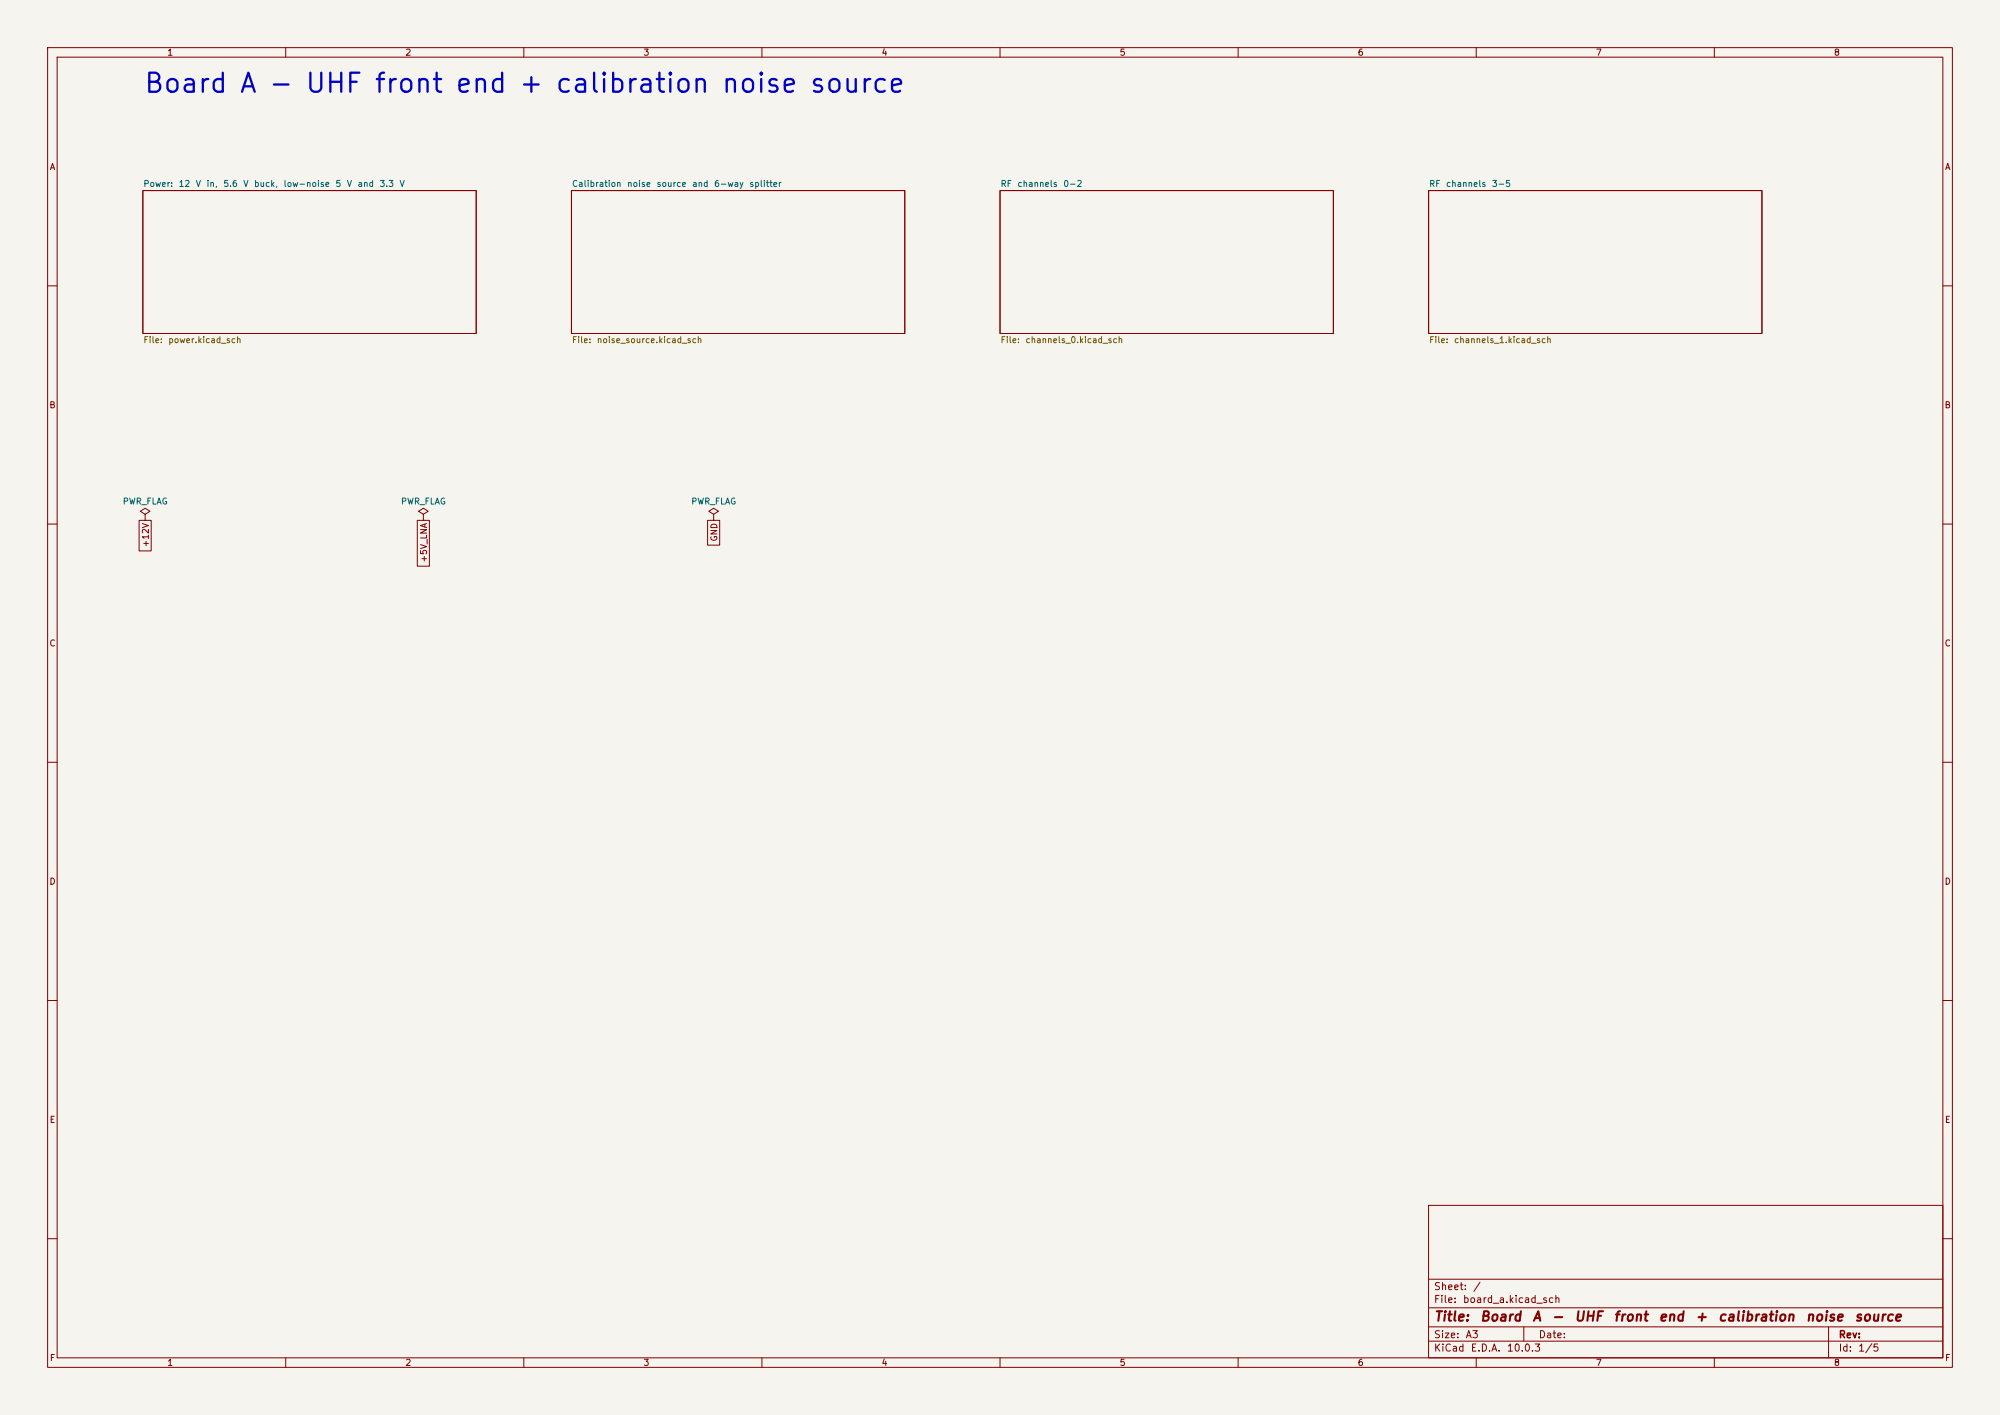
[picture p37: page 1]

Board A - UHF front end + calibration noise source

File: channels_1.kicad_sch Power: 12 V in, 5.6 V buck, low-noise 5 V and 3.3 V

Sheet: /
File: board_a.kicad_sch
Title: Board A - UHF front end + calibration noise source

Size: A3 | Rev:
KiCad E.D.A. 10.0.3 | Id: 1/5 | F Date:

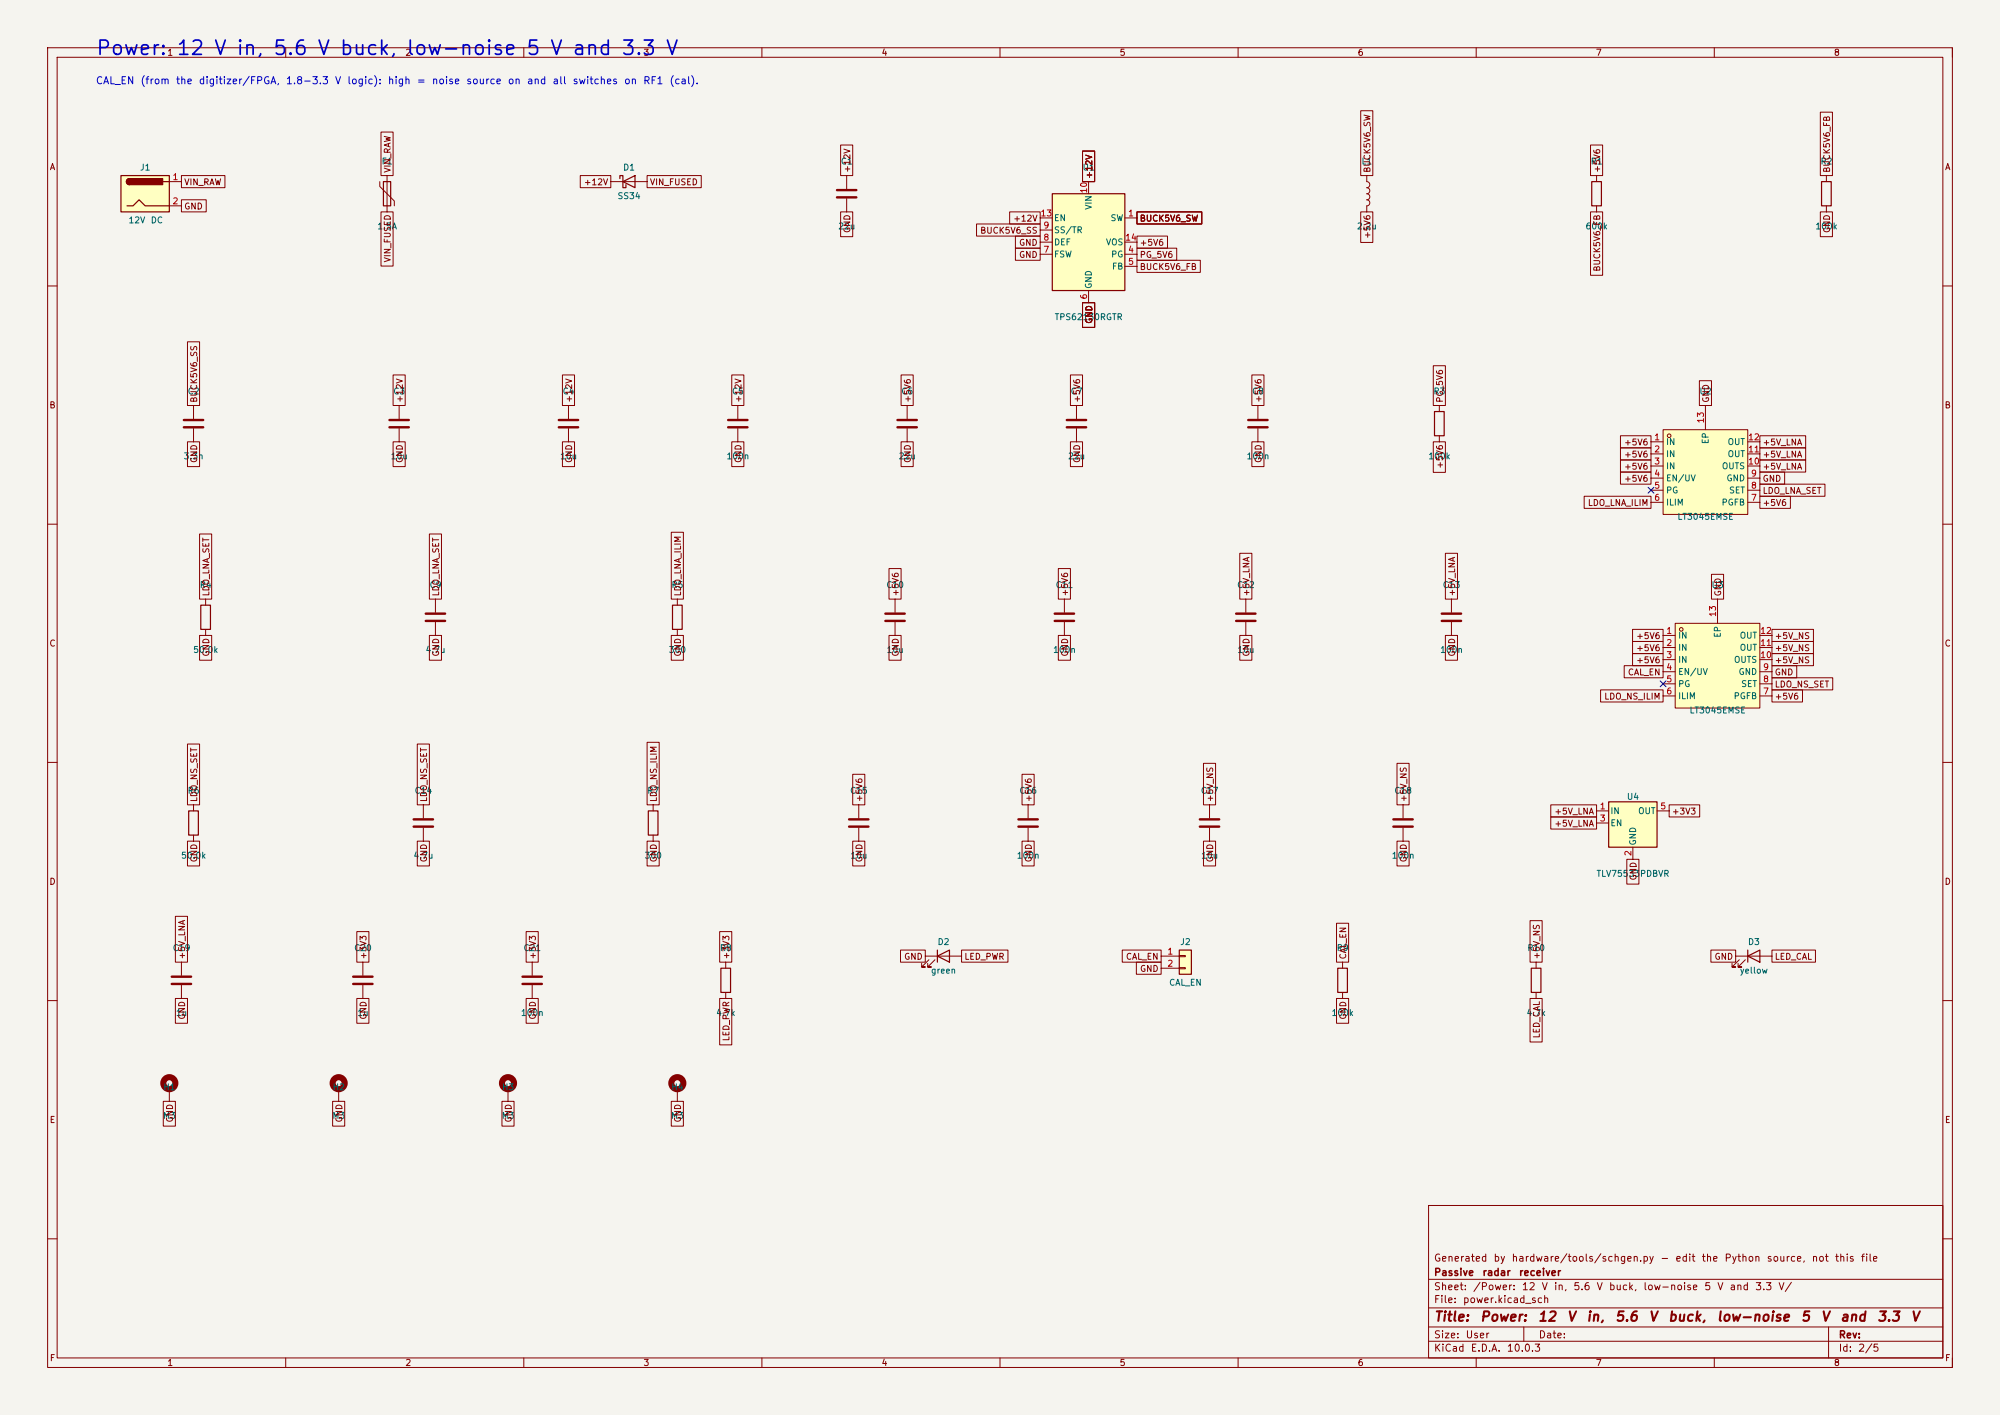
[picture p38: page 2]

CAL_EN (from the digitizer/FPGA, 1.8-3.3 V logic): high = noise source on and all switches on RF1 (cal).

Generated by hardware/tools/schgen.py - edit the Python source, not this file
Passive radar receiver
Sheet: /Power: 12 V in, 5.6 V buck, low-noise 5 V and 3.3 V/
File: power.kicad_sch
Title: Power: 12 V in, 5.6 V buck, low-noise 5 V and 3.3 V

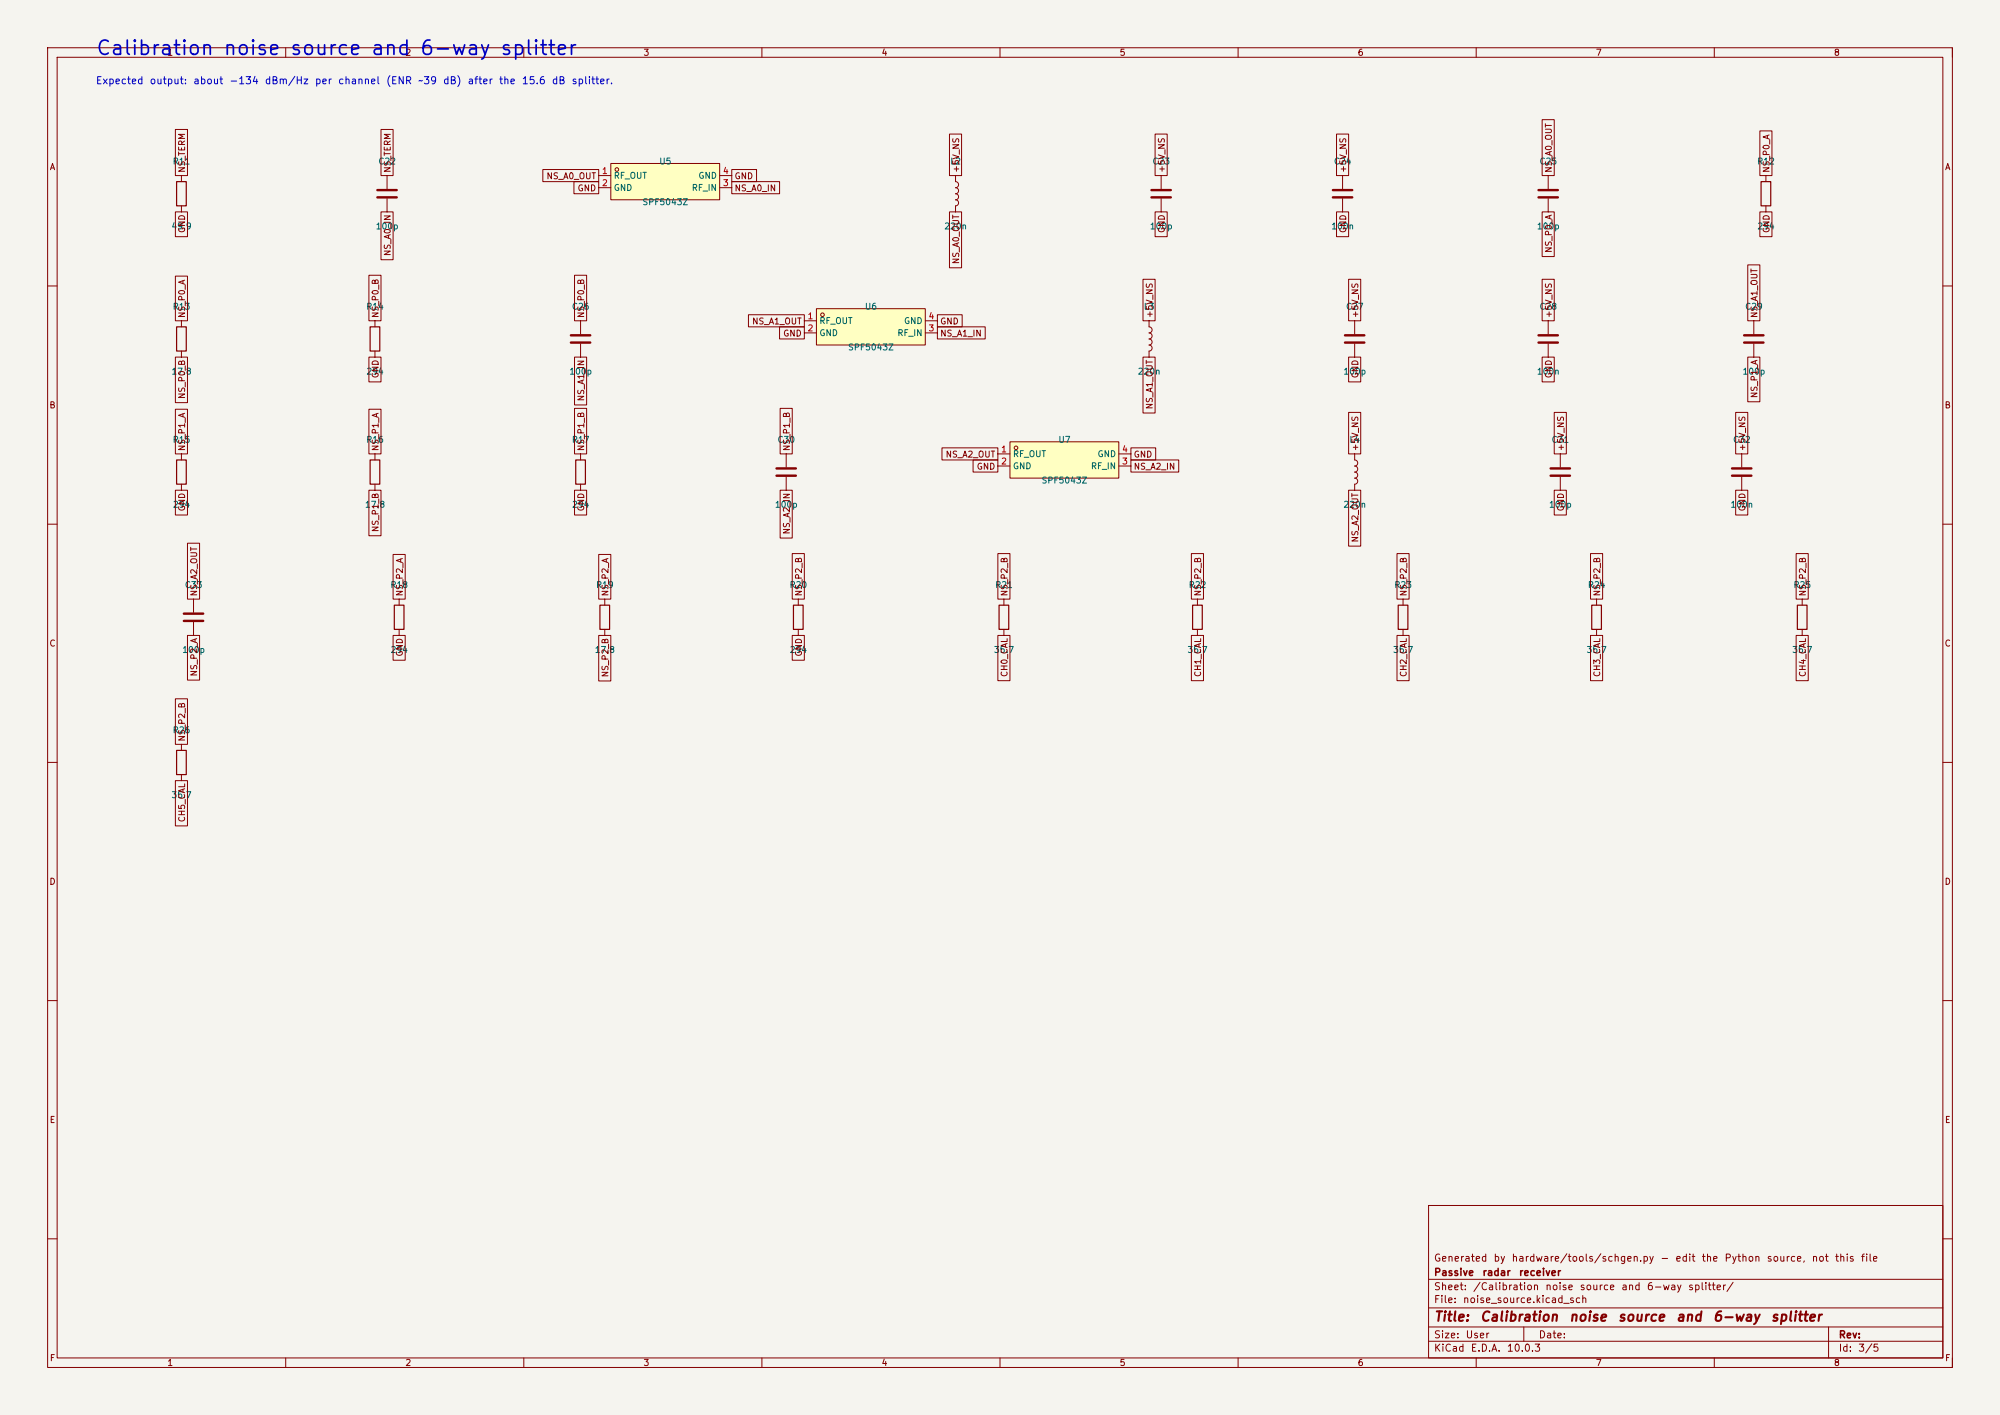
[picture p39: page 3]

Expected output: about -134 dBm/Hz per channel (ENR ~39 dB) after the 15.6 dB splitter.

Generated by hardware/tools/schgen.py - edit the Python source, not this file
Passive radar receiver
Sheet: /Calibration noise source and 6-way splitter/
File: noise_source.kicad_sch
Title: Calibration noise source and 6-way splitter

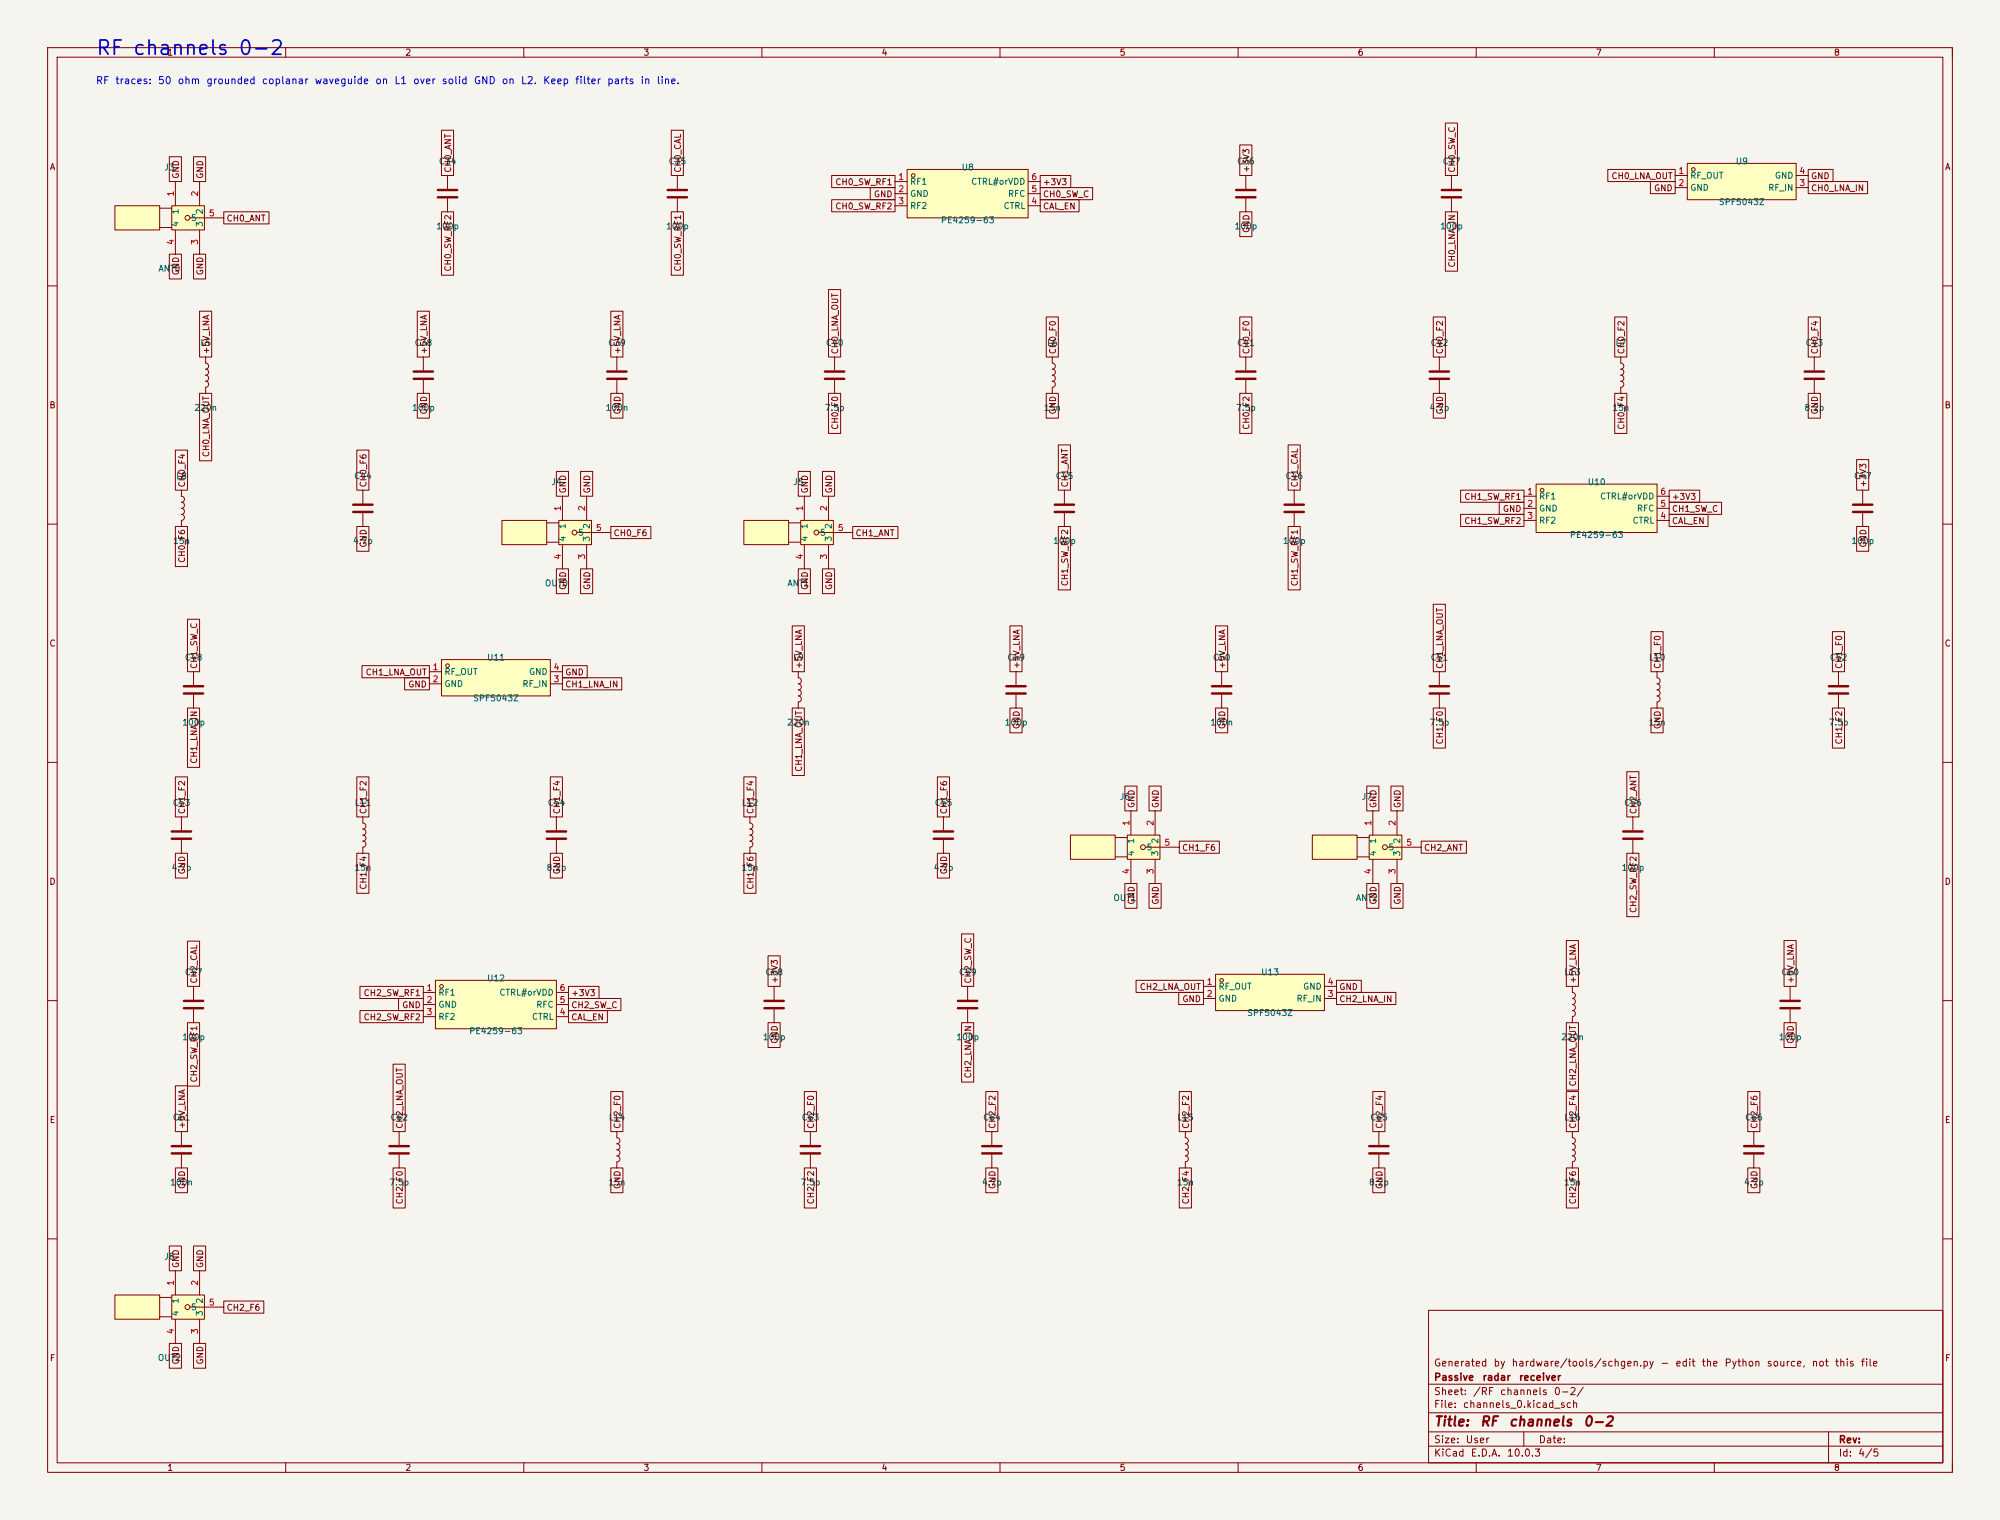
[picture p40: page 4]

RF traces: 50 ohm grounded coplanar waveguide on L1 over solid GND on L2. Keep filter parts in line.

Generated by hardware/tools/schgen.py - edit the Python source, not this file
Passive radar receiver
Sheet: /RF channels 0-2/
File: channels_0.kicad_sch
Title: RF channels 0-2

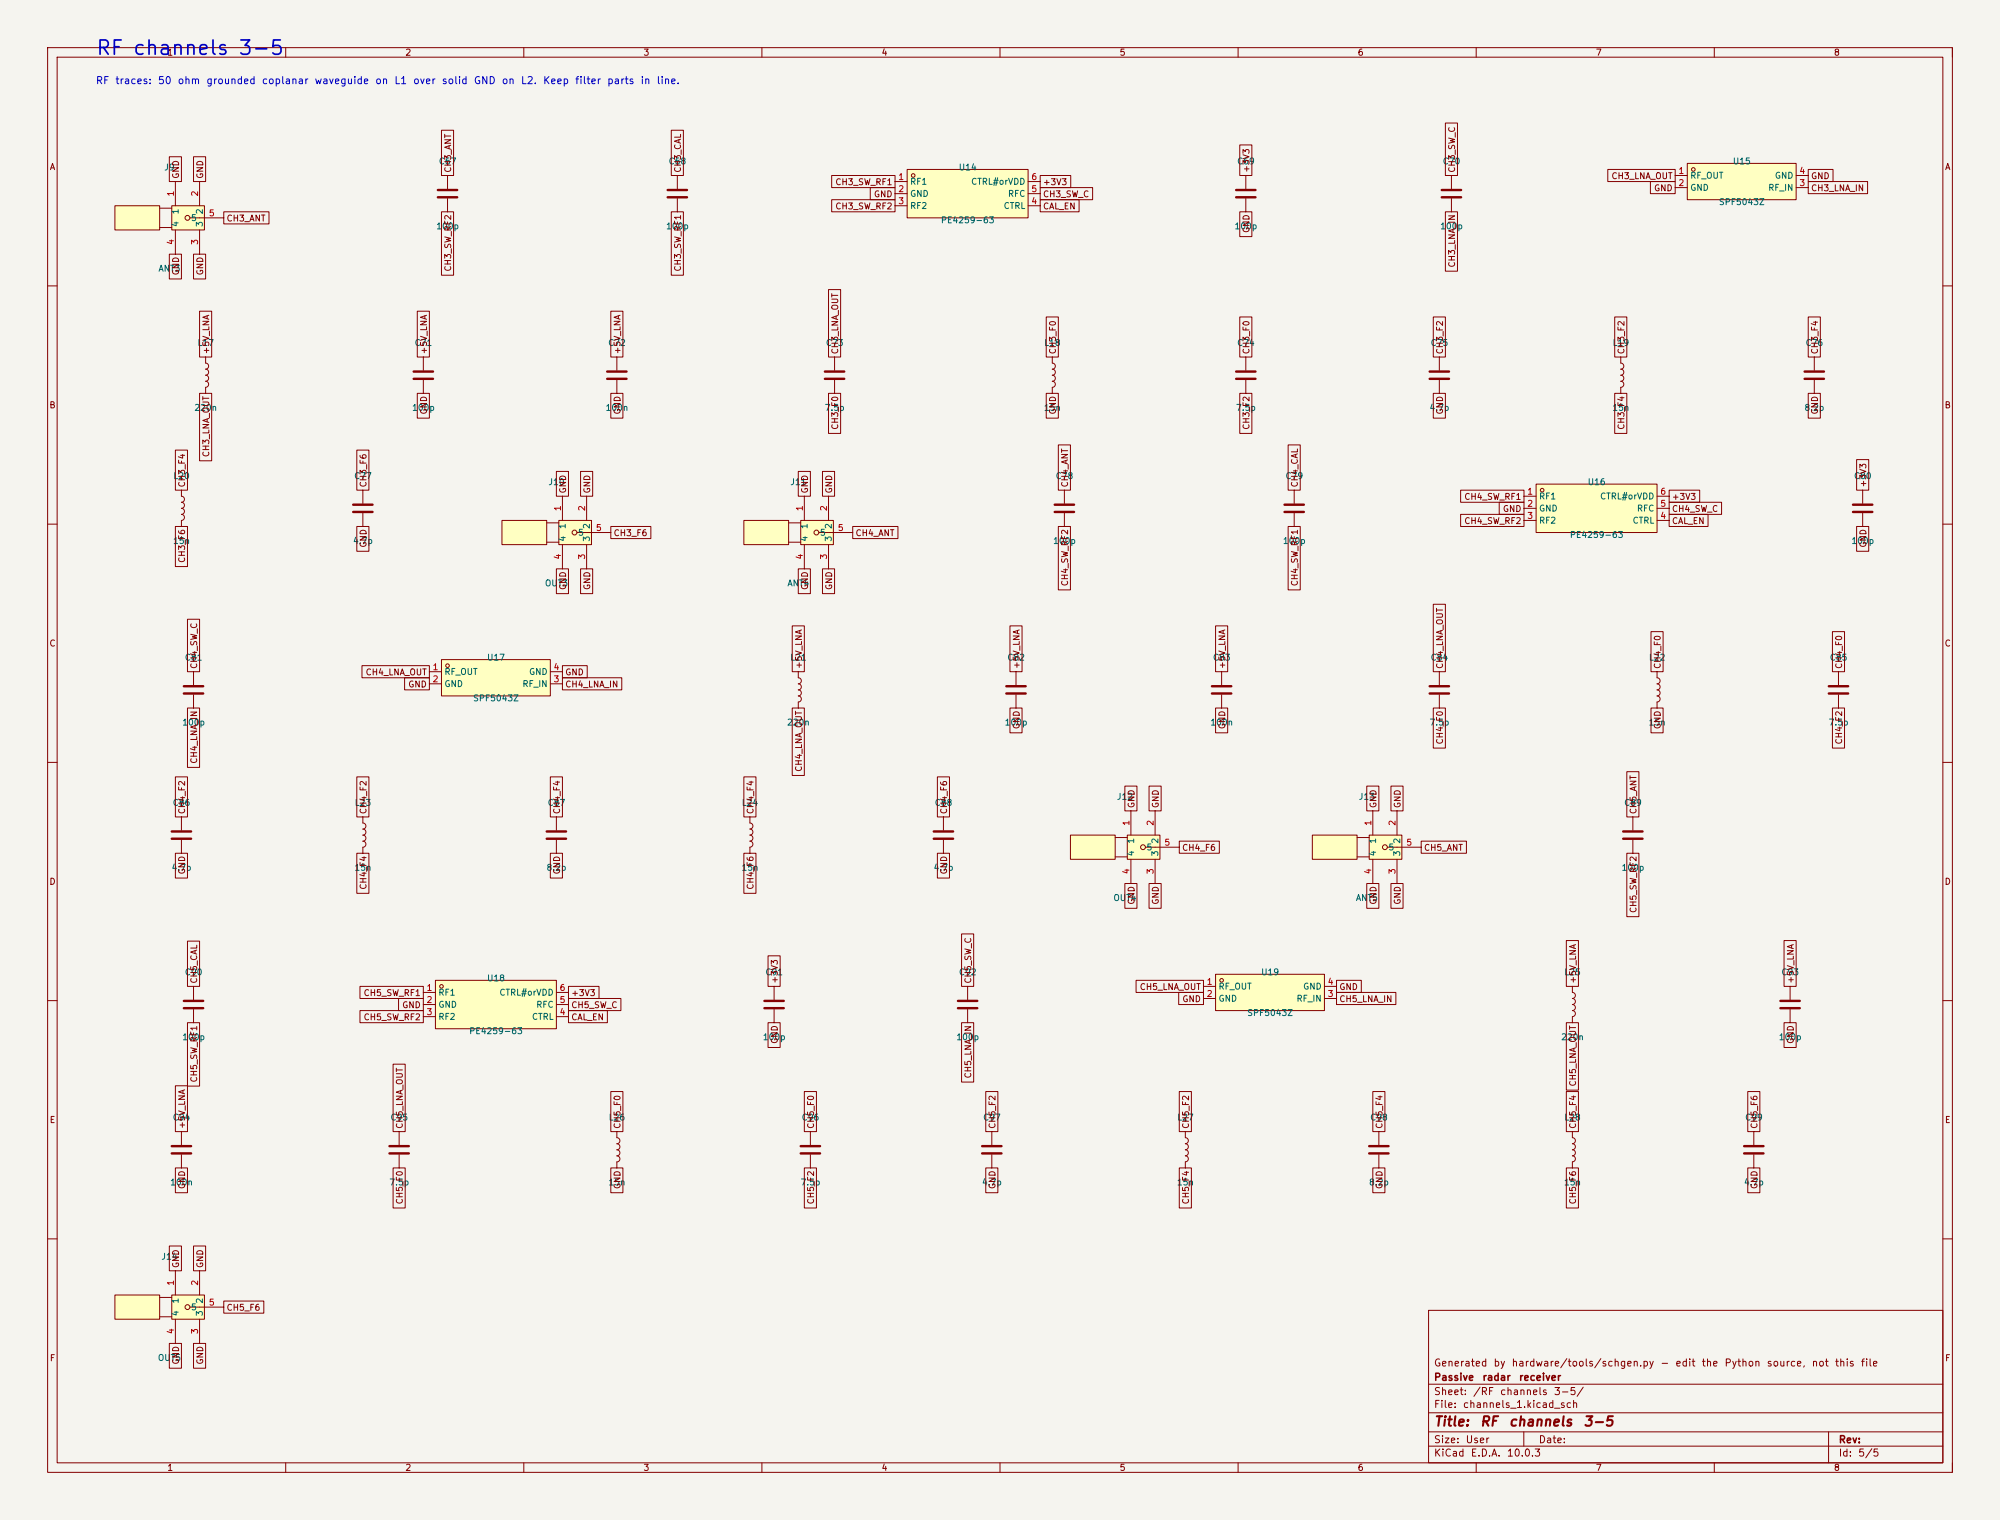
[picture p41: page 5]
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

Generated by hardware/tools/schgen.py - edit the Python source, not this file
Passive radar receiver
Sheet: /RF channels 3-5/
File: channels_1.kicad_sch
Title: RF channels 3-5
