ajisrawi/passive-radar-counter-drone/hardware/release/board_b/board_b_schematic.pdf

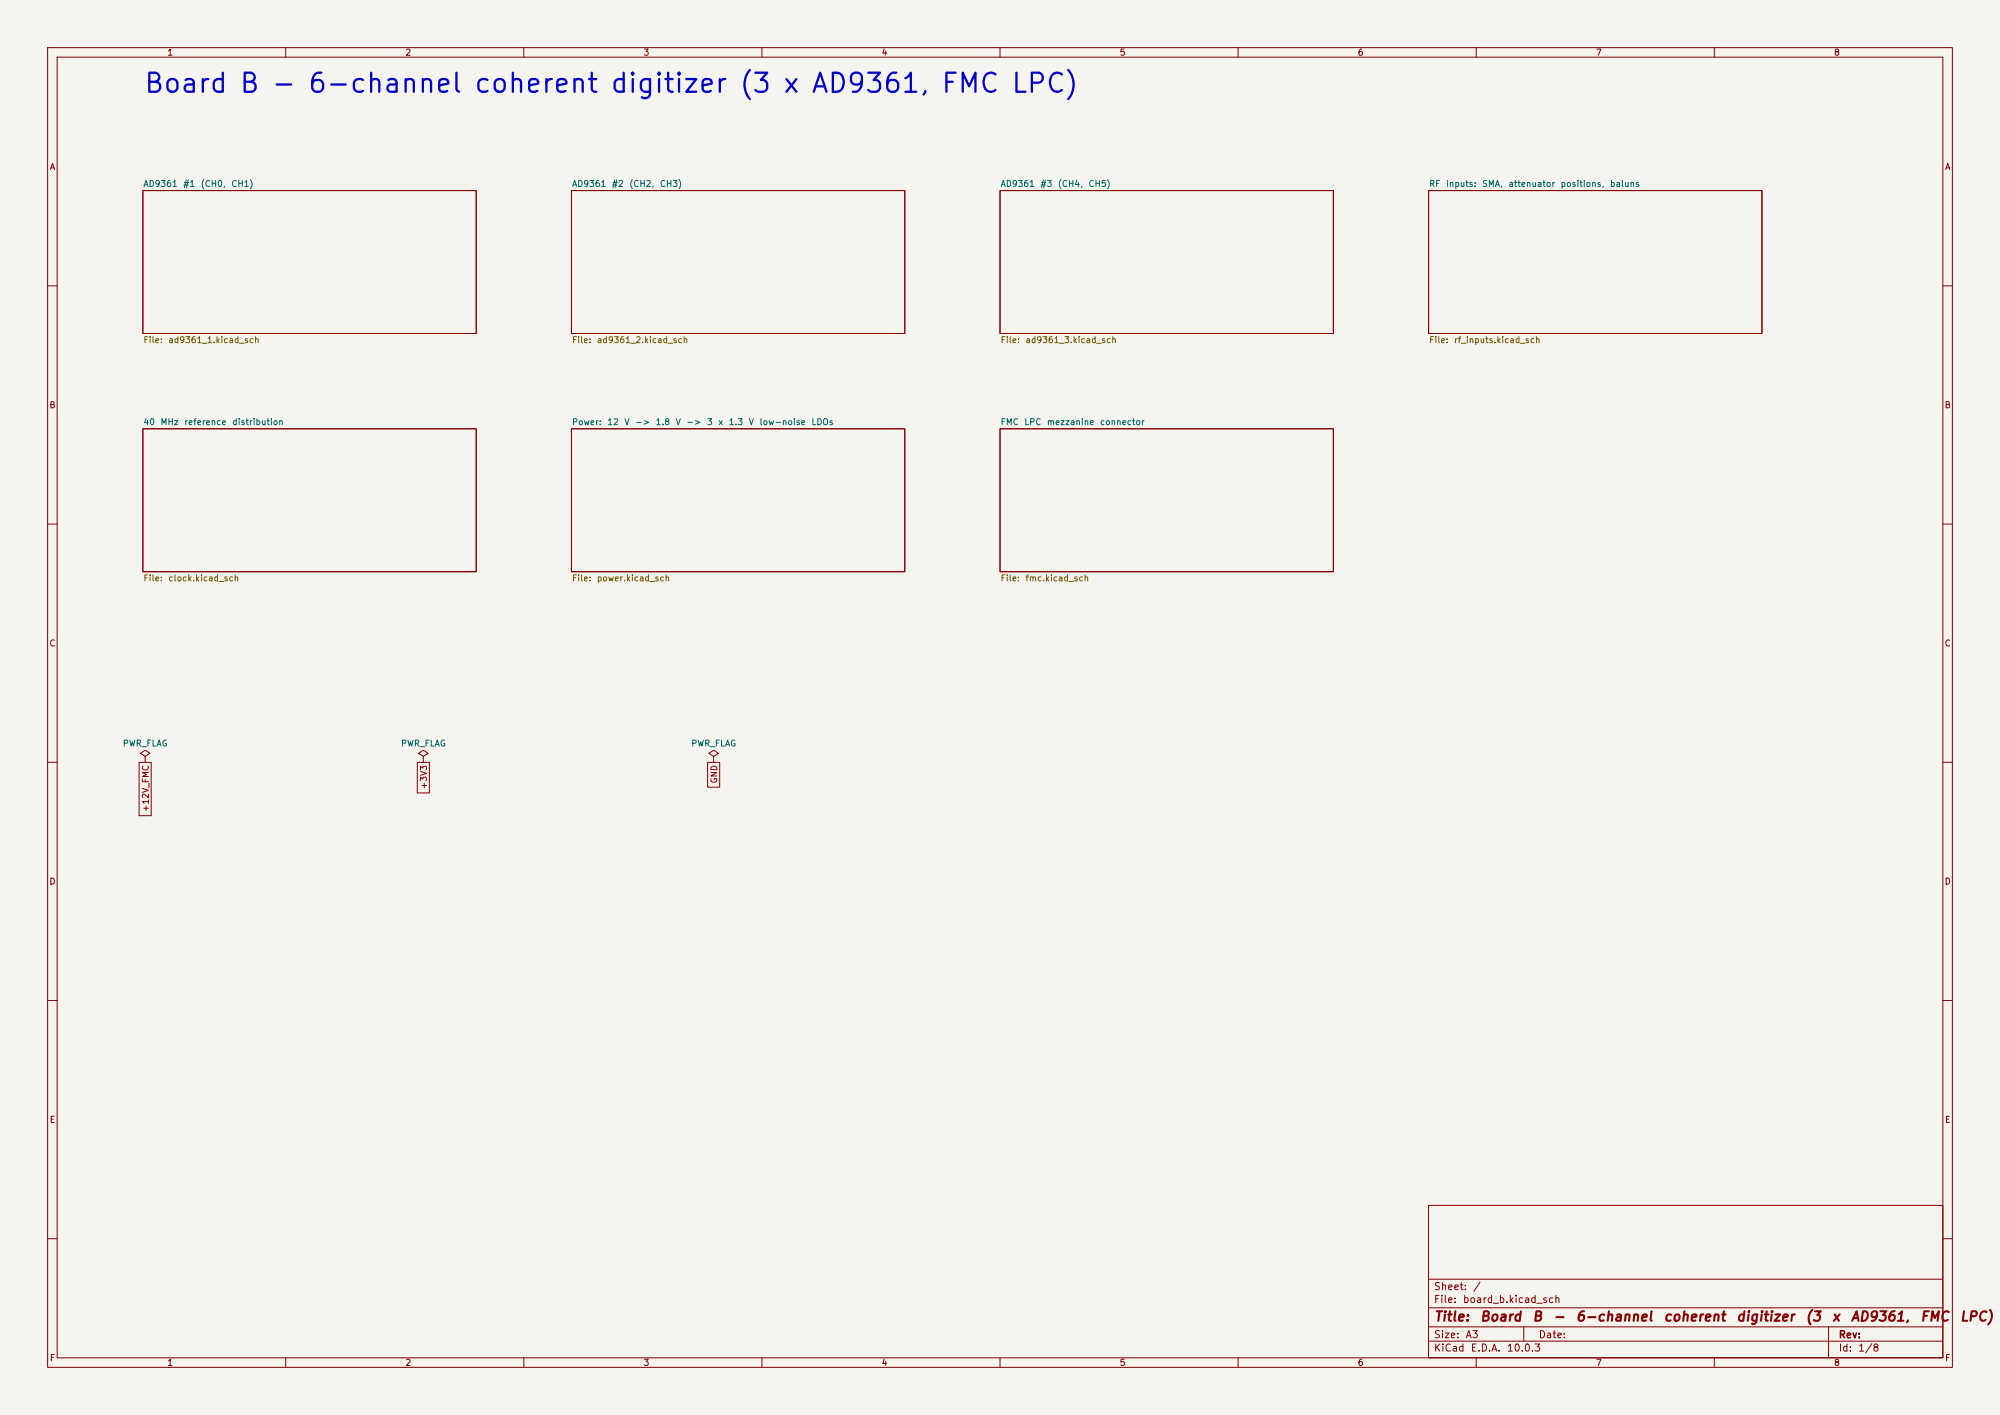
[picture p46: page 1]

Board B - 6-channel coherent digitizer (3 x AD9361, FMC LPC)

AD9361 #1 (CH0, CH1) File: ad9361_1.kicad_sch 40 MHz reference distribution

FMC LPC mezzanine connector File: fmc.kicad_sch

Sheet: /
File: board_b.kicad_sch
Title: Board B - 6-channel coherent digitizer (3 x AD9361, FMC LPC)

Size: A3 | Rev:
KiCad E.D.A. 10.0.3 | Id: 1/8 | F Date:

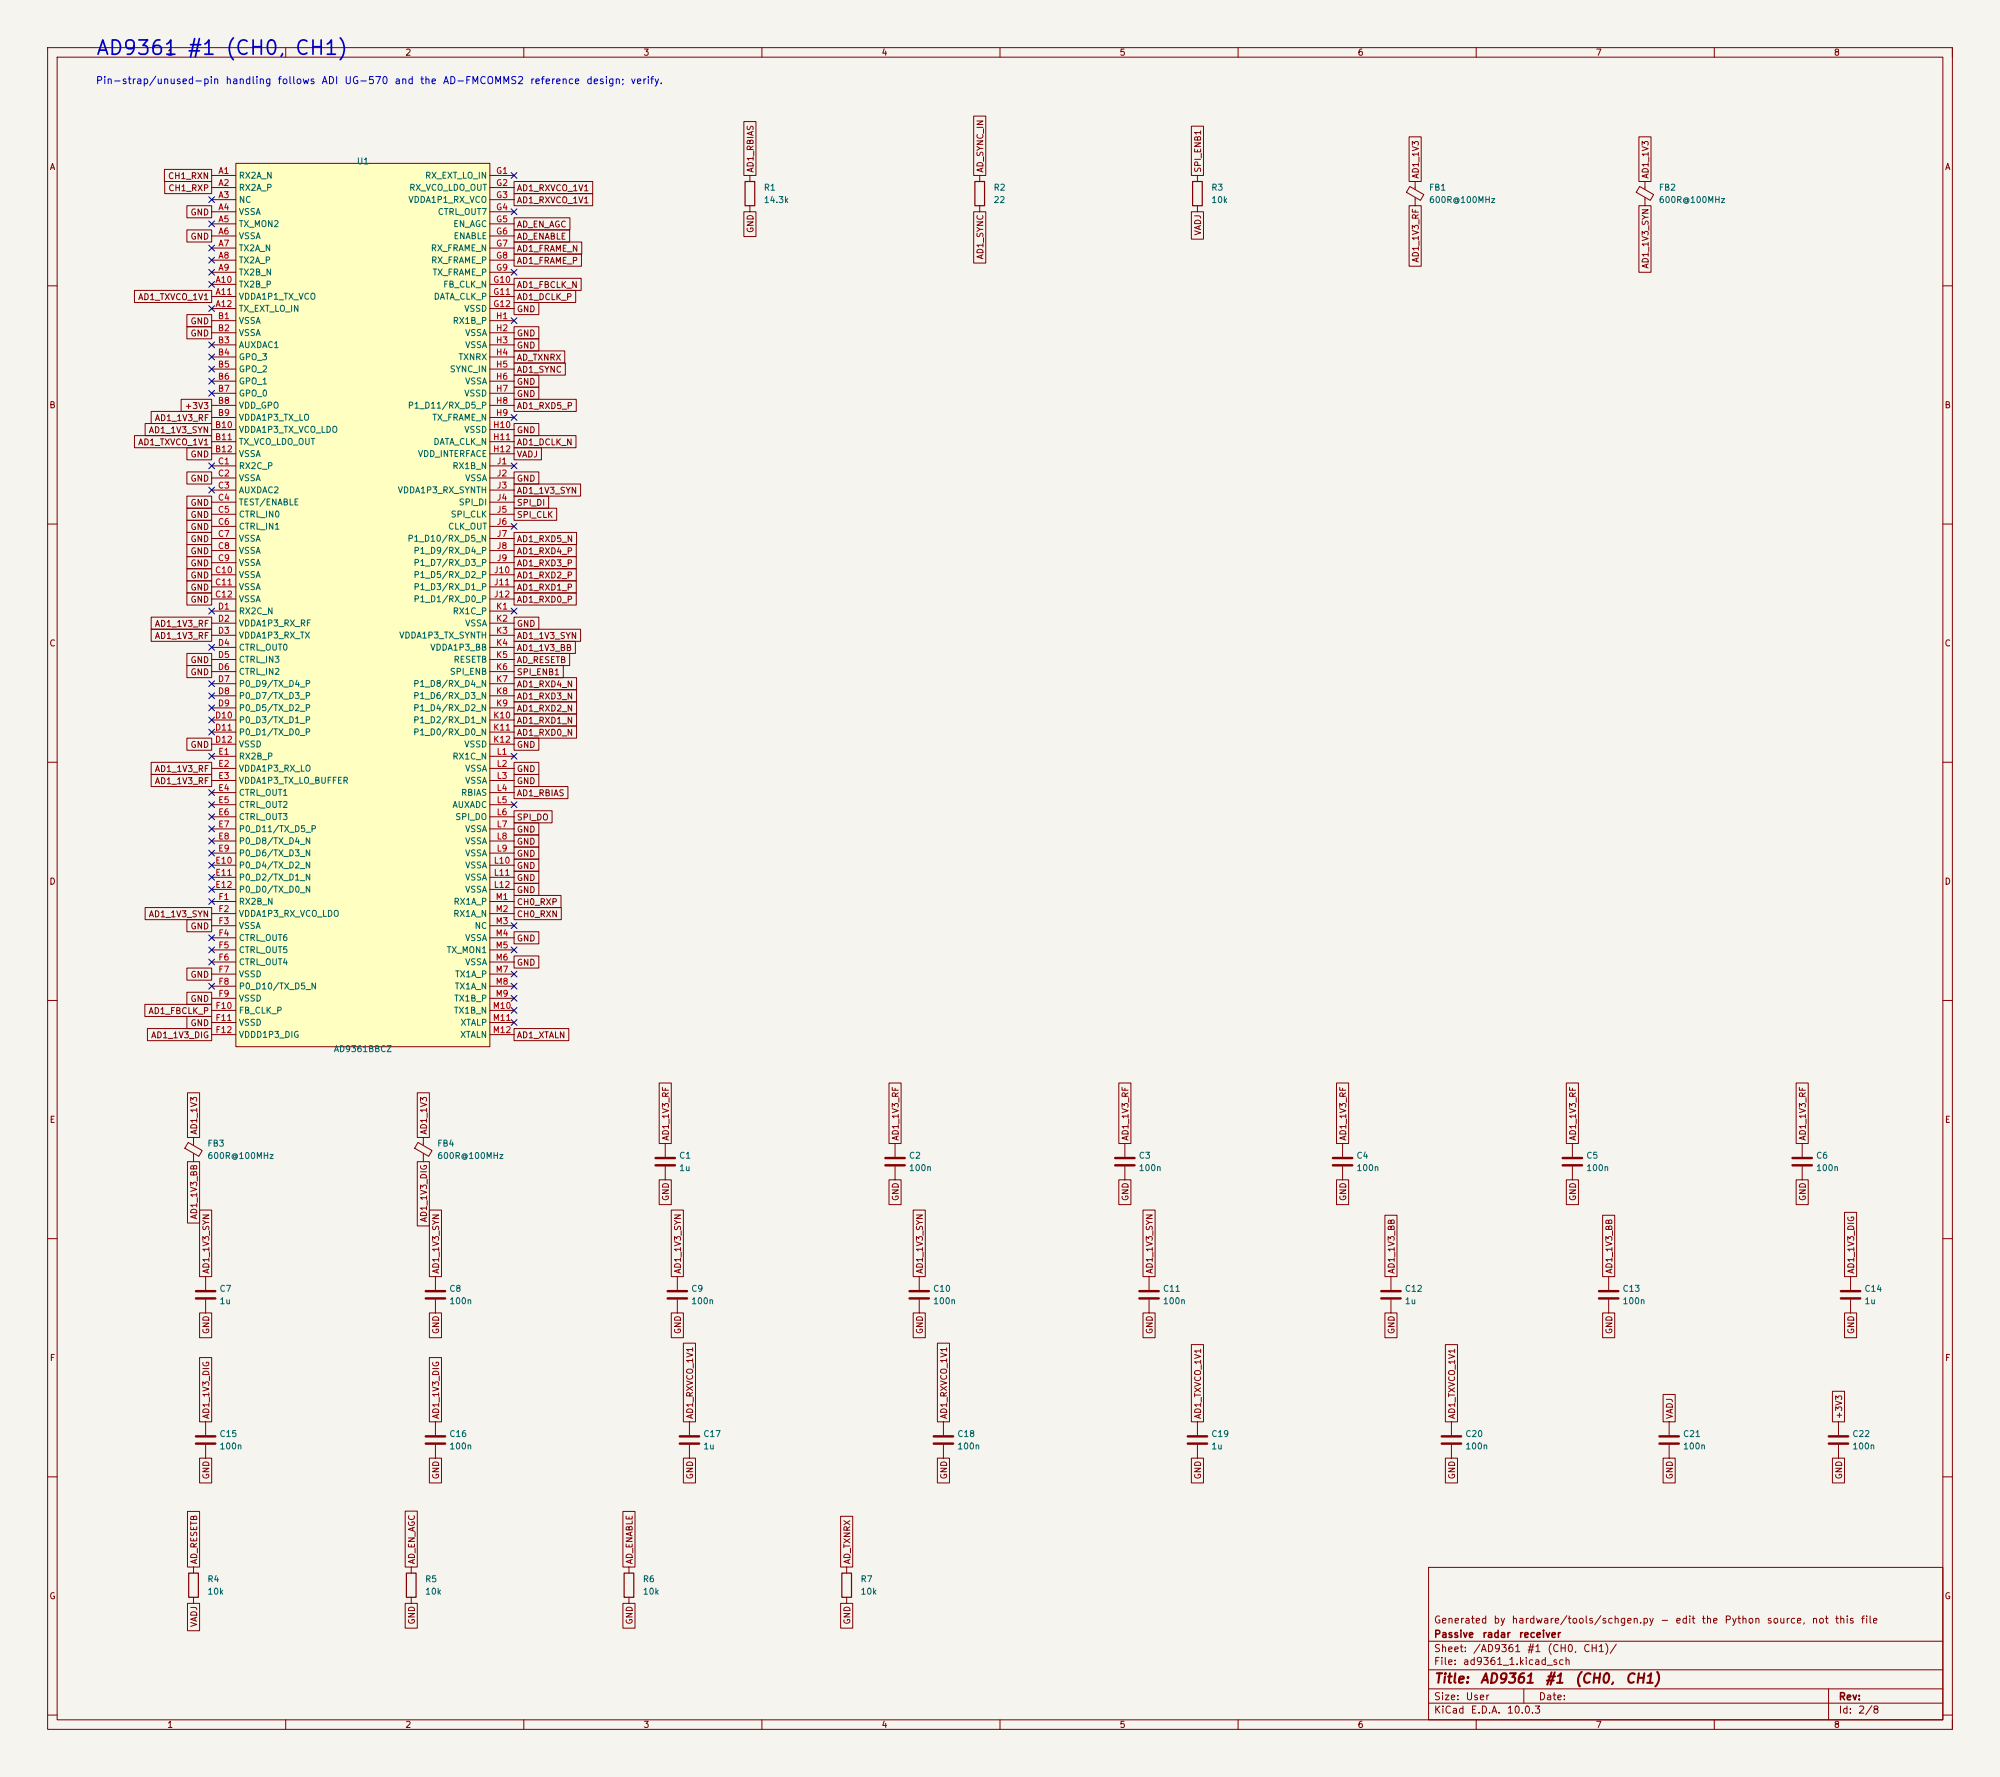
[picture p47: page 2]

Pin-strap/unused-pin handling follows ADI UG-570 and the AD-FMCOMMS2 reference design; verify.

Generated by hardware/tools/schgen.py - edit the Python source, not this file
Passive radar receiver
Sheet: /AD9361 #1 (CH0, CH1)/
File: ad9361_1.kicad_sch
Title: AD9361 #1 (CH0, CH1)

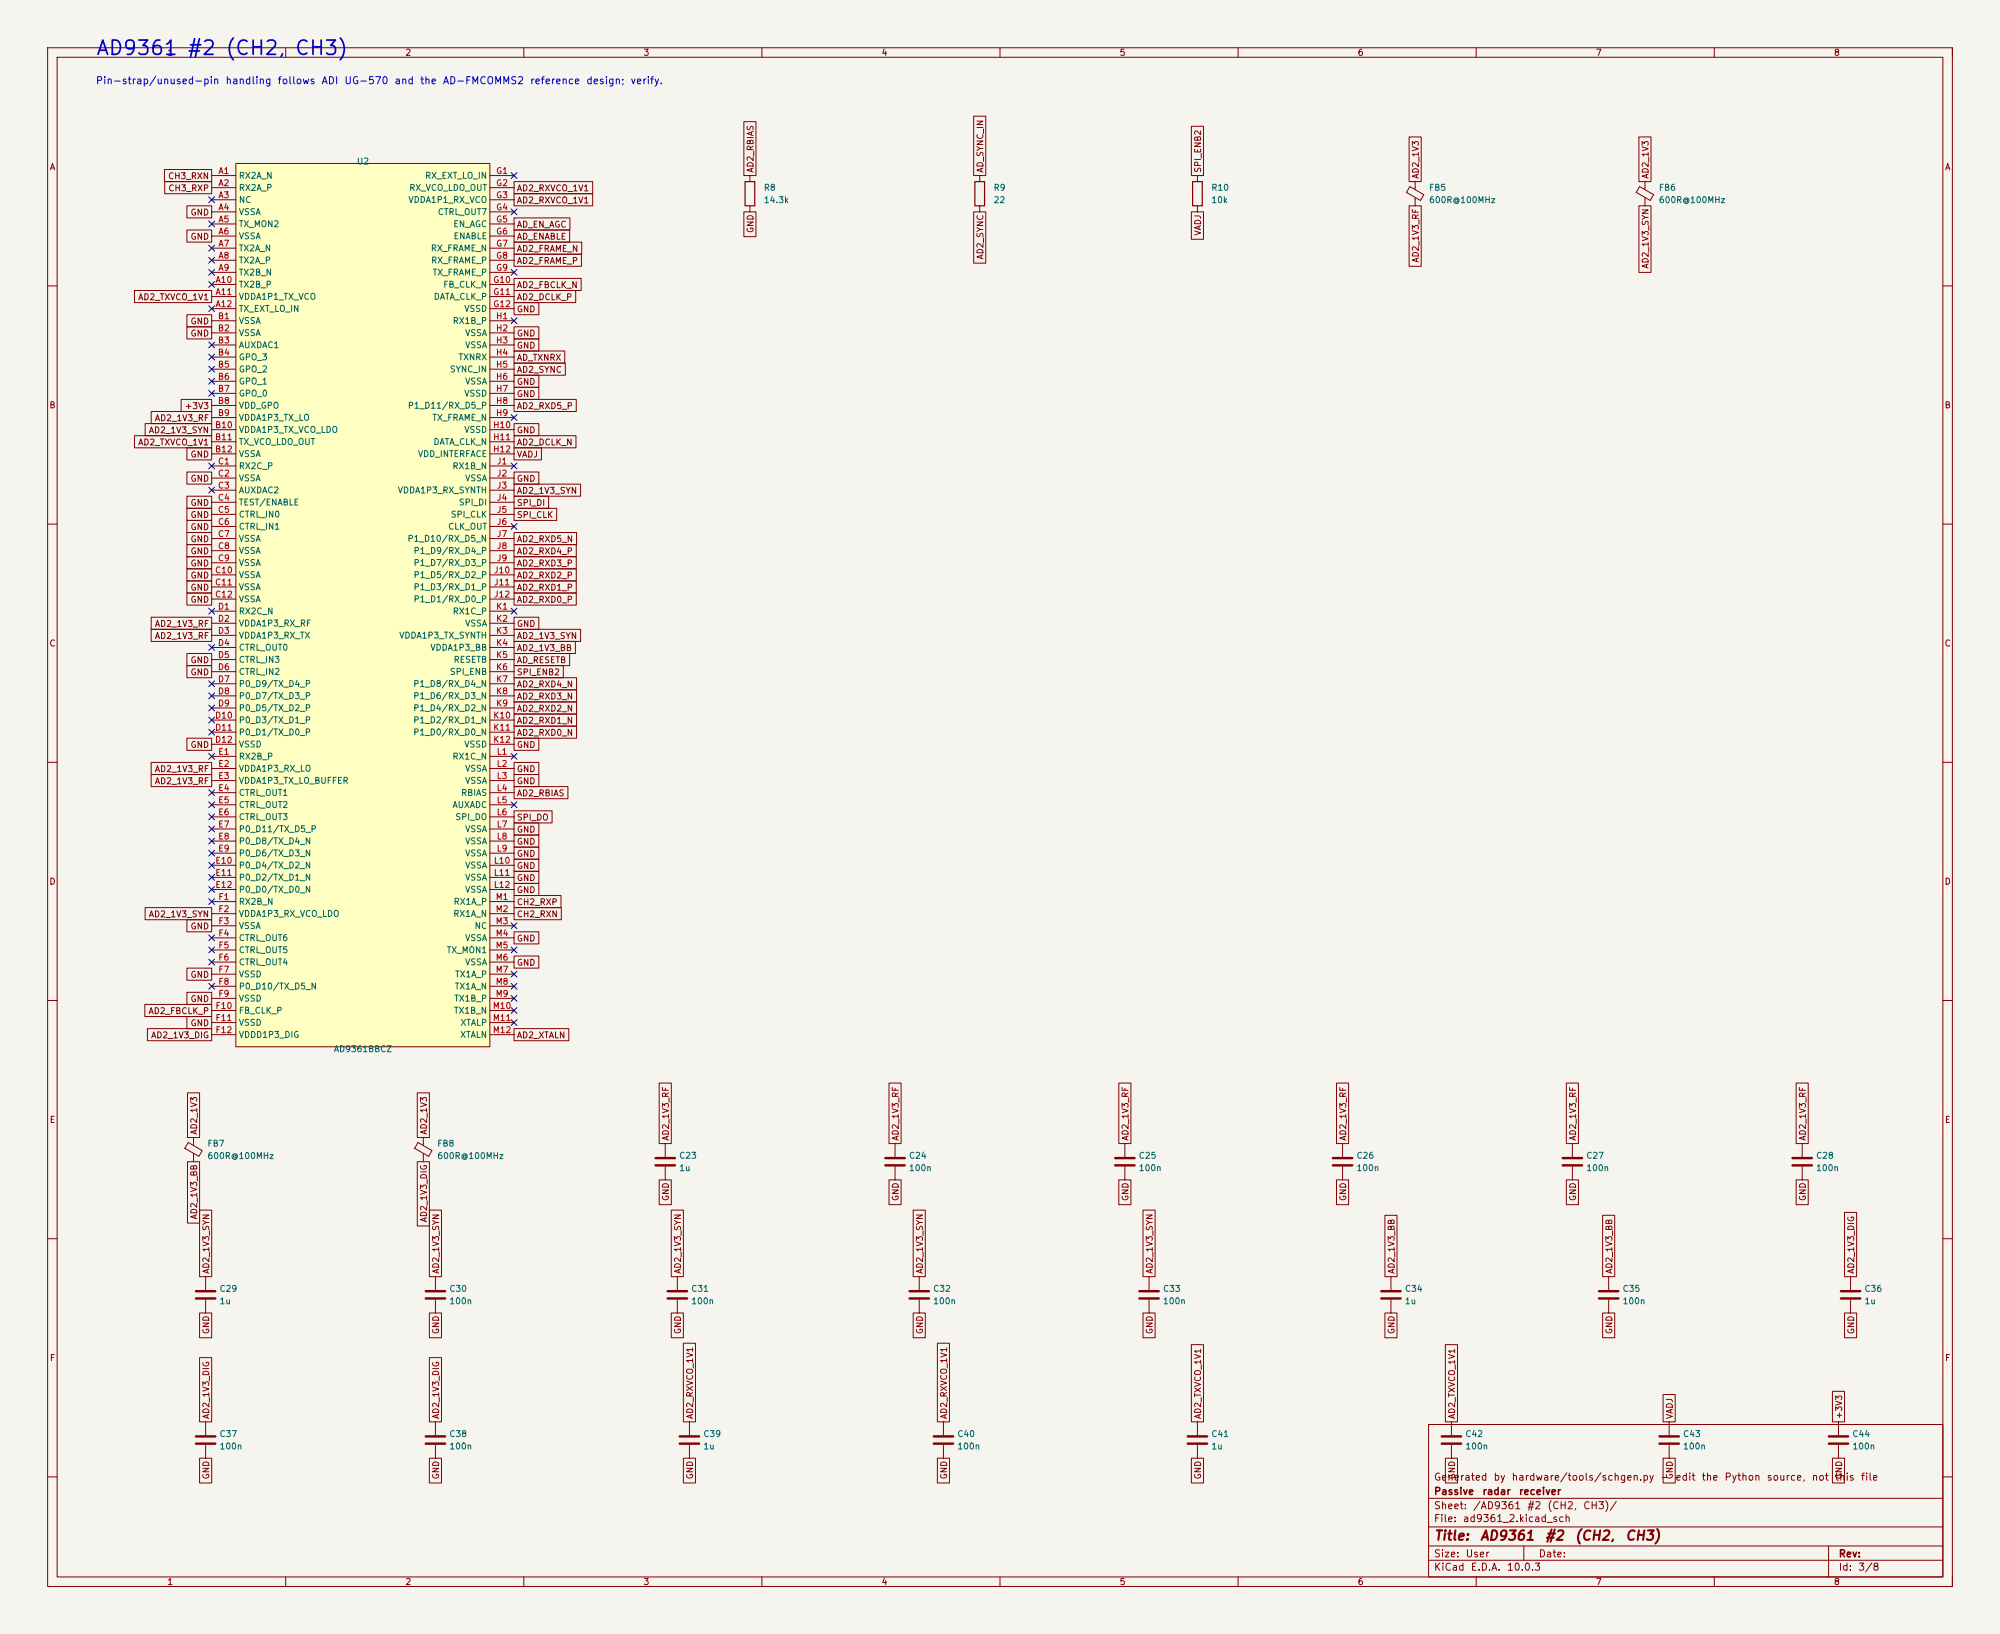
[picture p48: page 3]

Pin-strap/unused-pin handling follows ADI UG-570 and the AD-FMCOMMS2 reference design; verify.

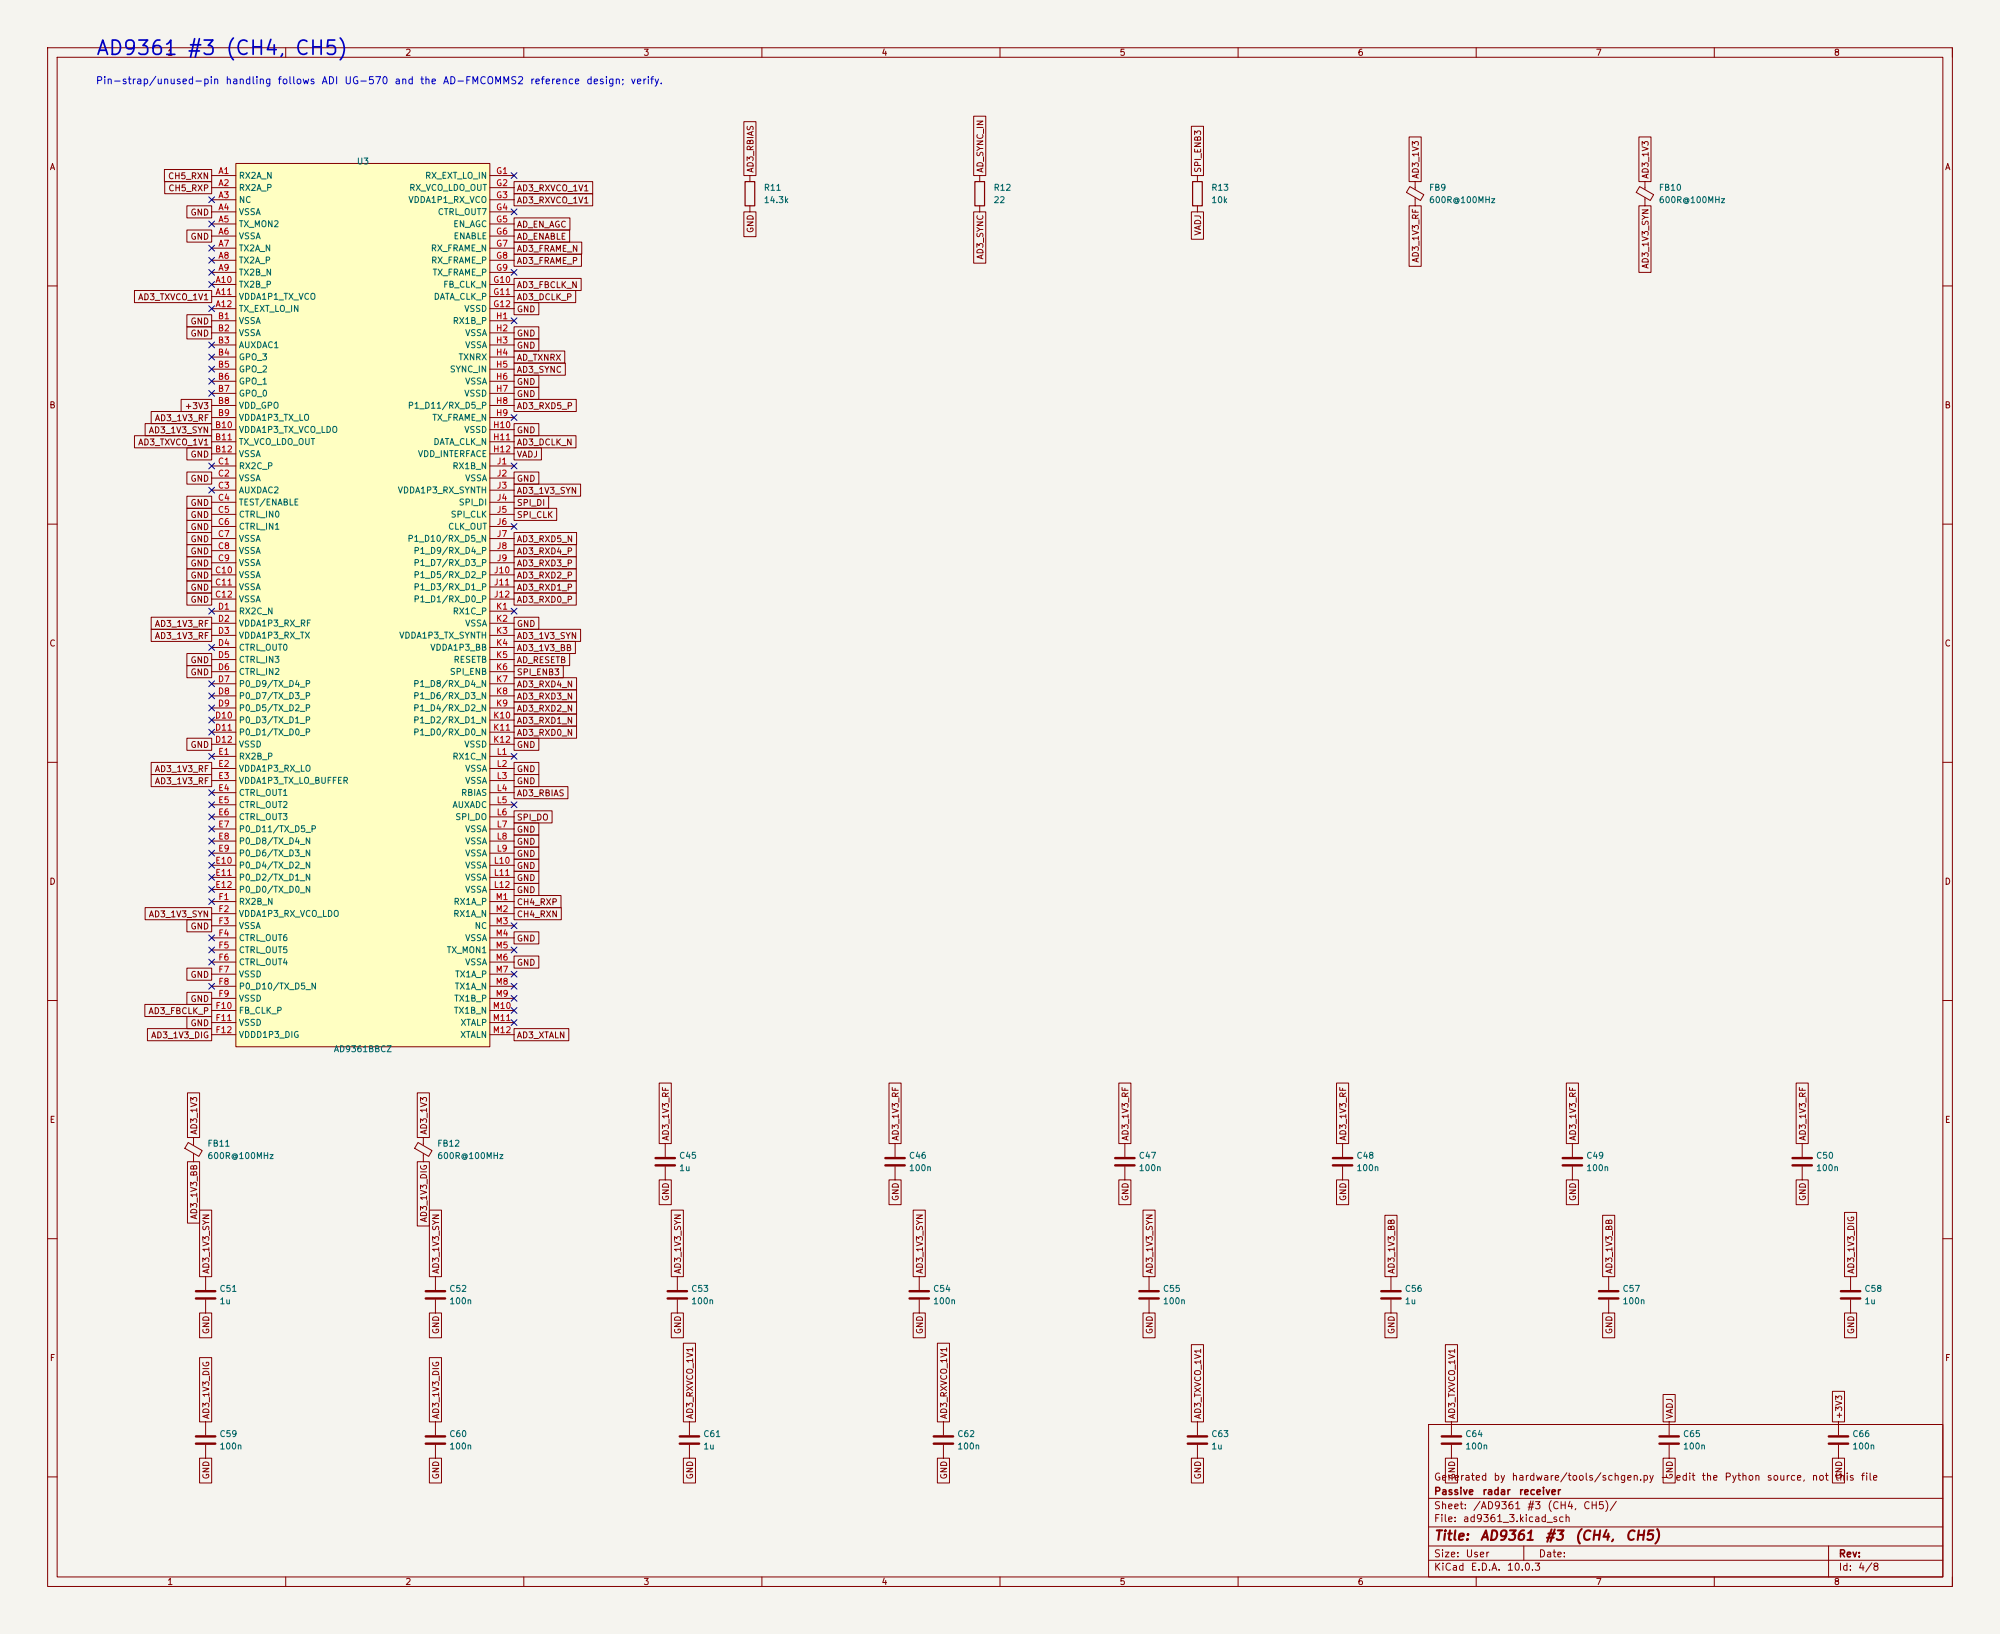
[picture p49: page 4]

Pin-strap/unused-pin handling follows ADI UG-570 and the AD-FMCOMMS2 reference design; verify.

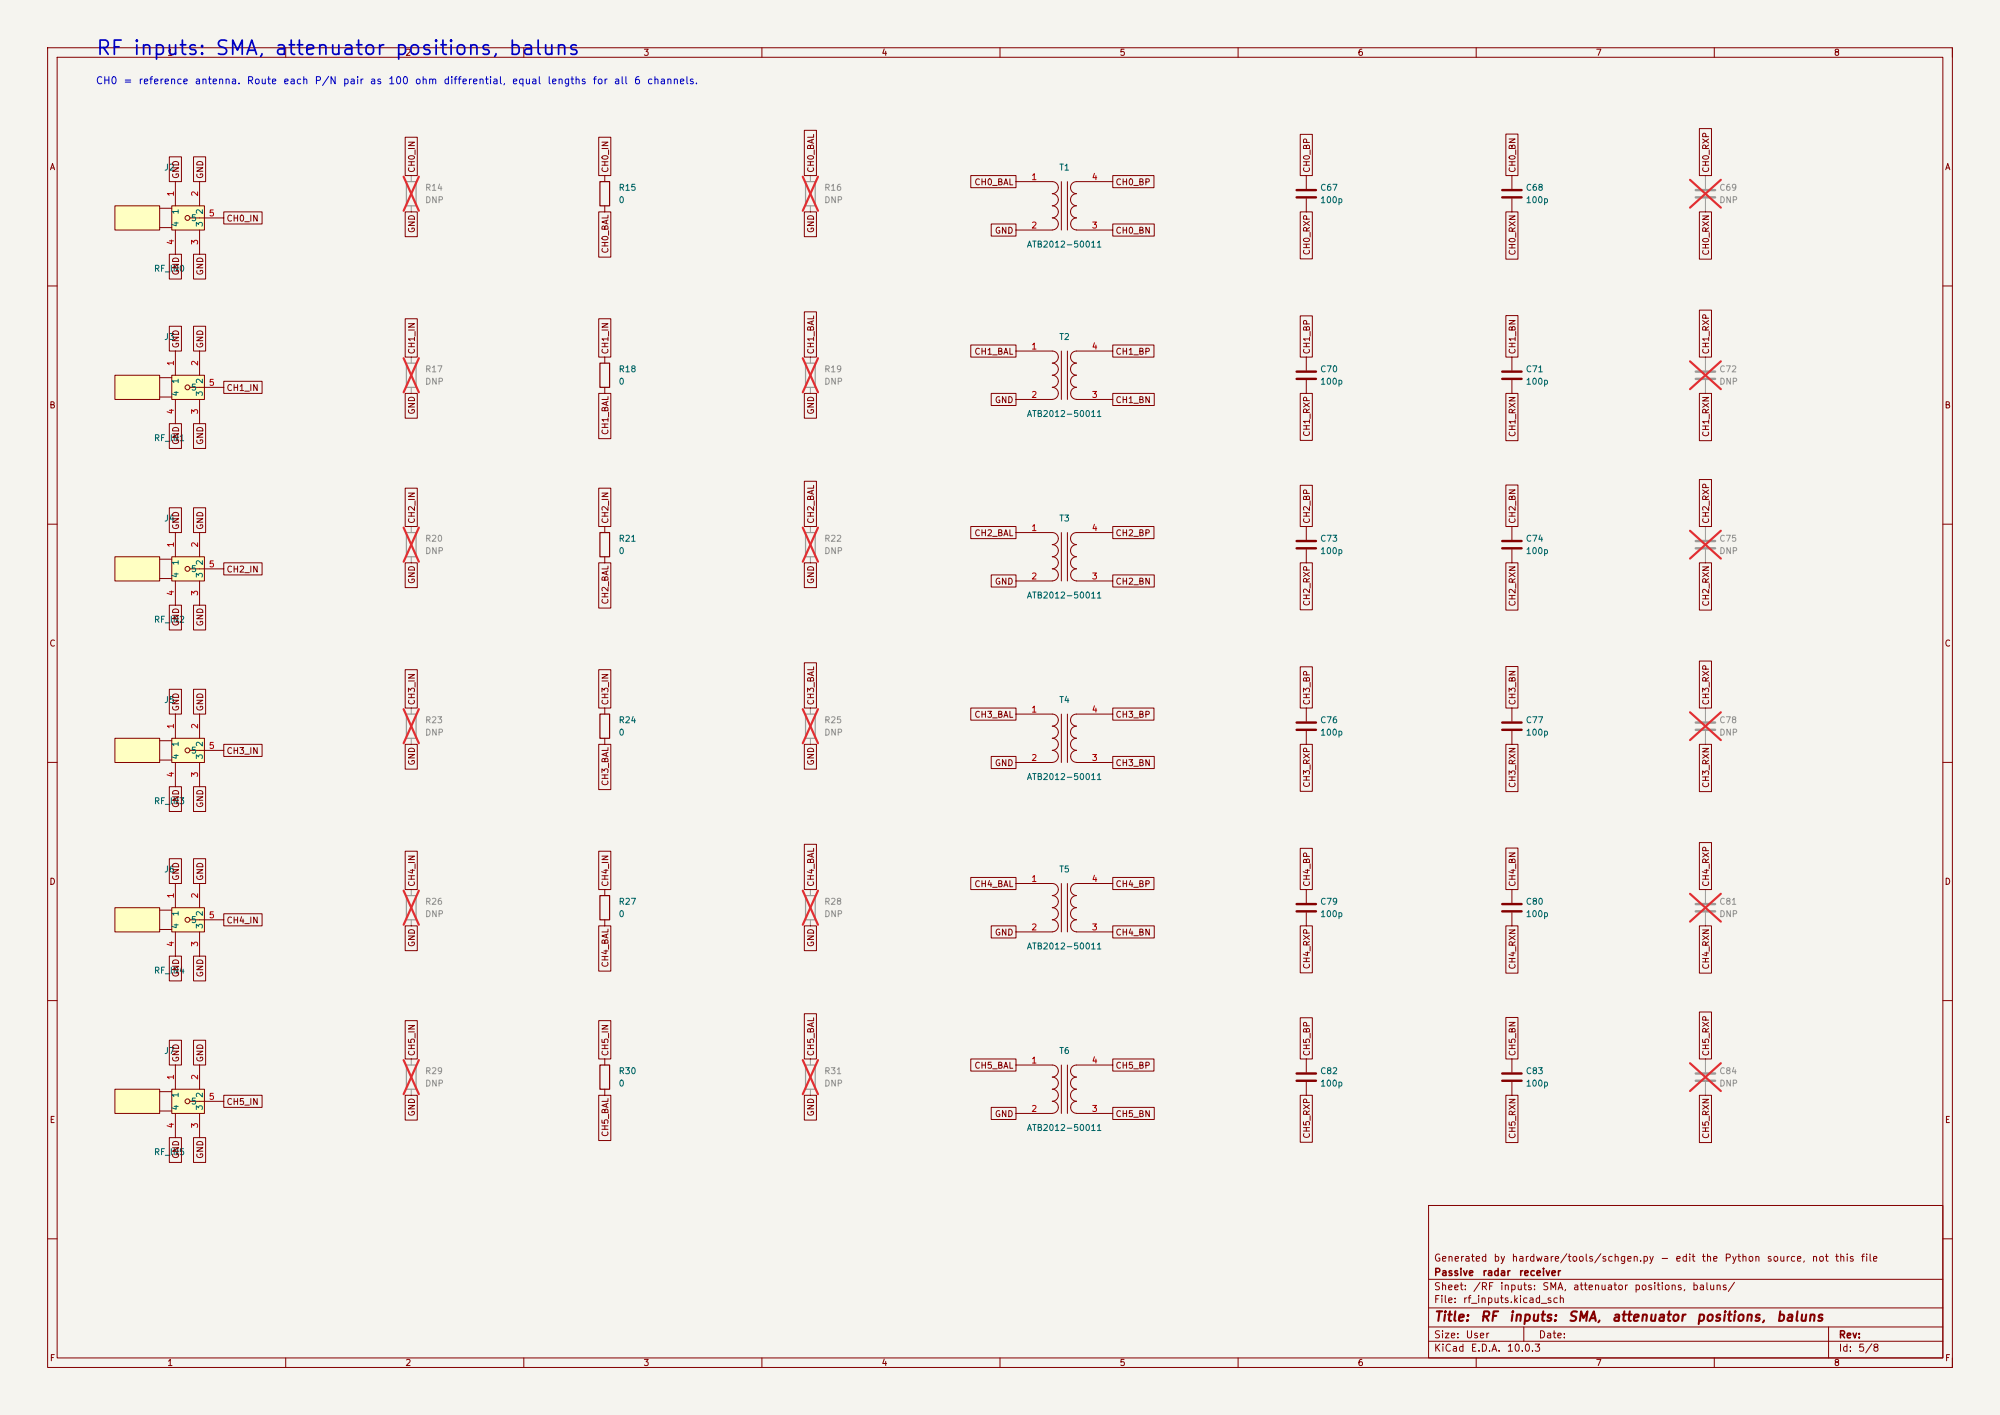
[picture p50: page 5]

RF inputs: SMA, attenuator positions, baluns

CH0 = reference antenna. Route each P/N pair as 100 ohm differential, equal lengths for all 6 channels.

Generated by hardware/tools/schgen.py - edit the Python source, not this file
Passive radar receiver
Sheet: /RF inputs: SMA, attenuator positions, baluns/
File: rf_inputs.kicad_sch
Title: RF inputs: SMA, attenuator positions, baluns

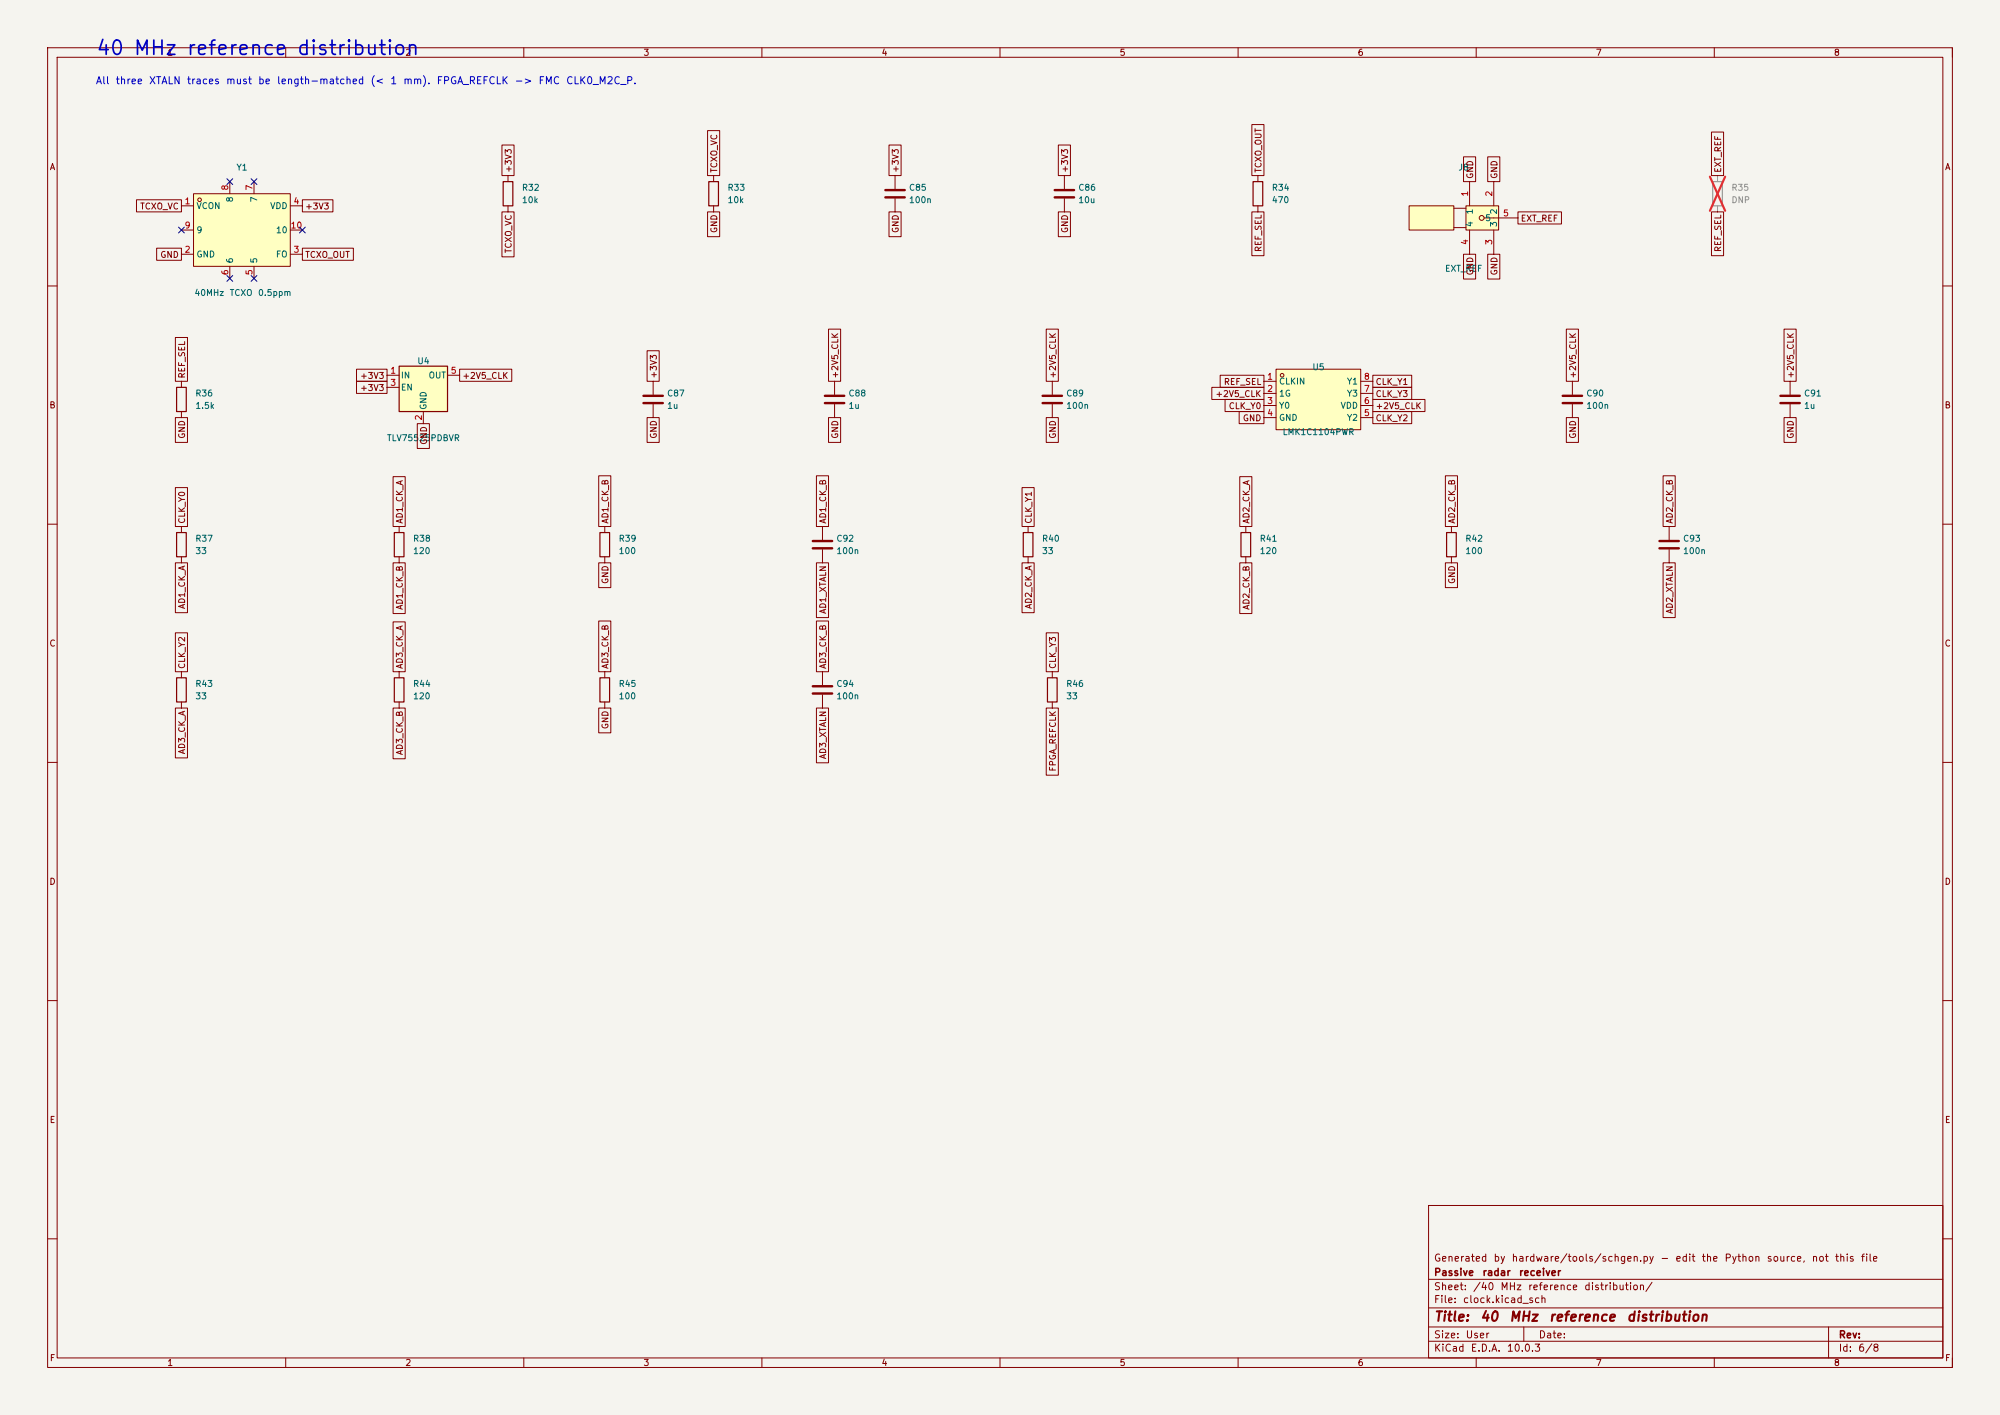
[picture p51: page 6]

All three XTALN traces must be length-matched (< 1 mm). FPGA_REFCLK -> FMC CLK0_M2C_P.

Generated by hardware/tools/schgen.py - edit the Python source, not this file
Passive radar receiver
Sheet: /40 MHz reference distribution/
File: clock.kicad_sch
Title: 40 MHz reference distribution

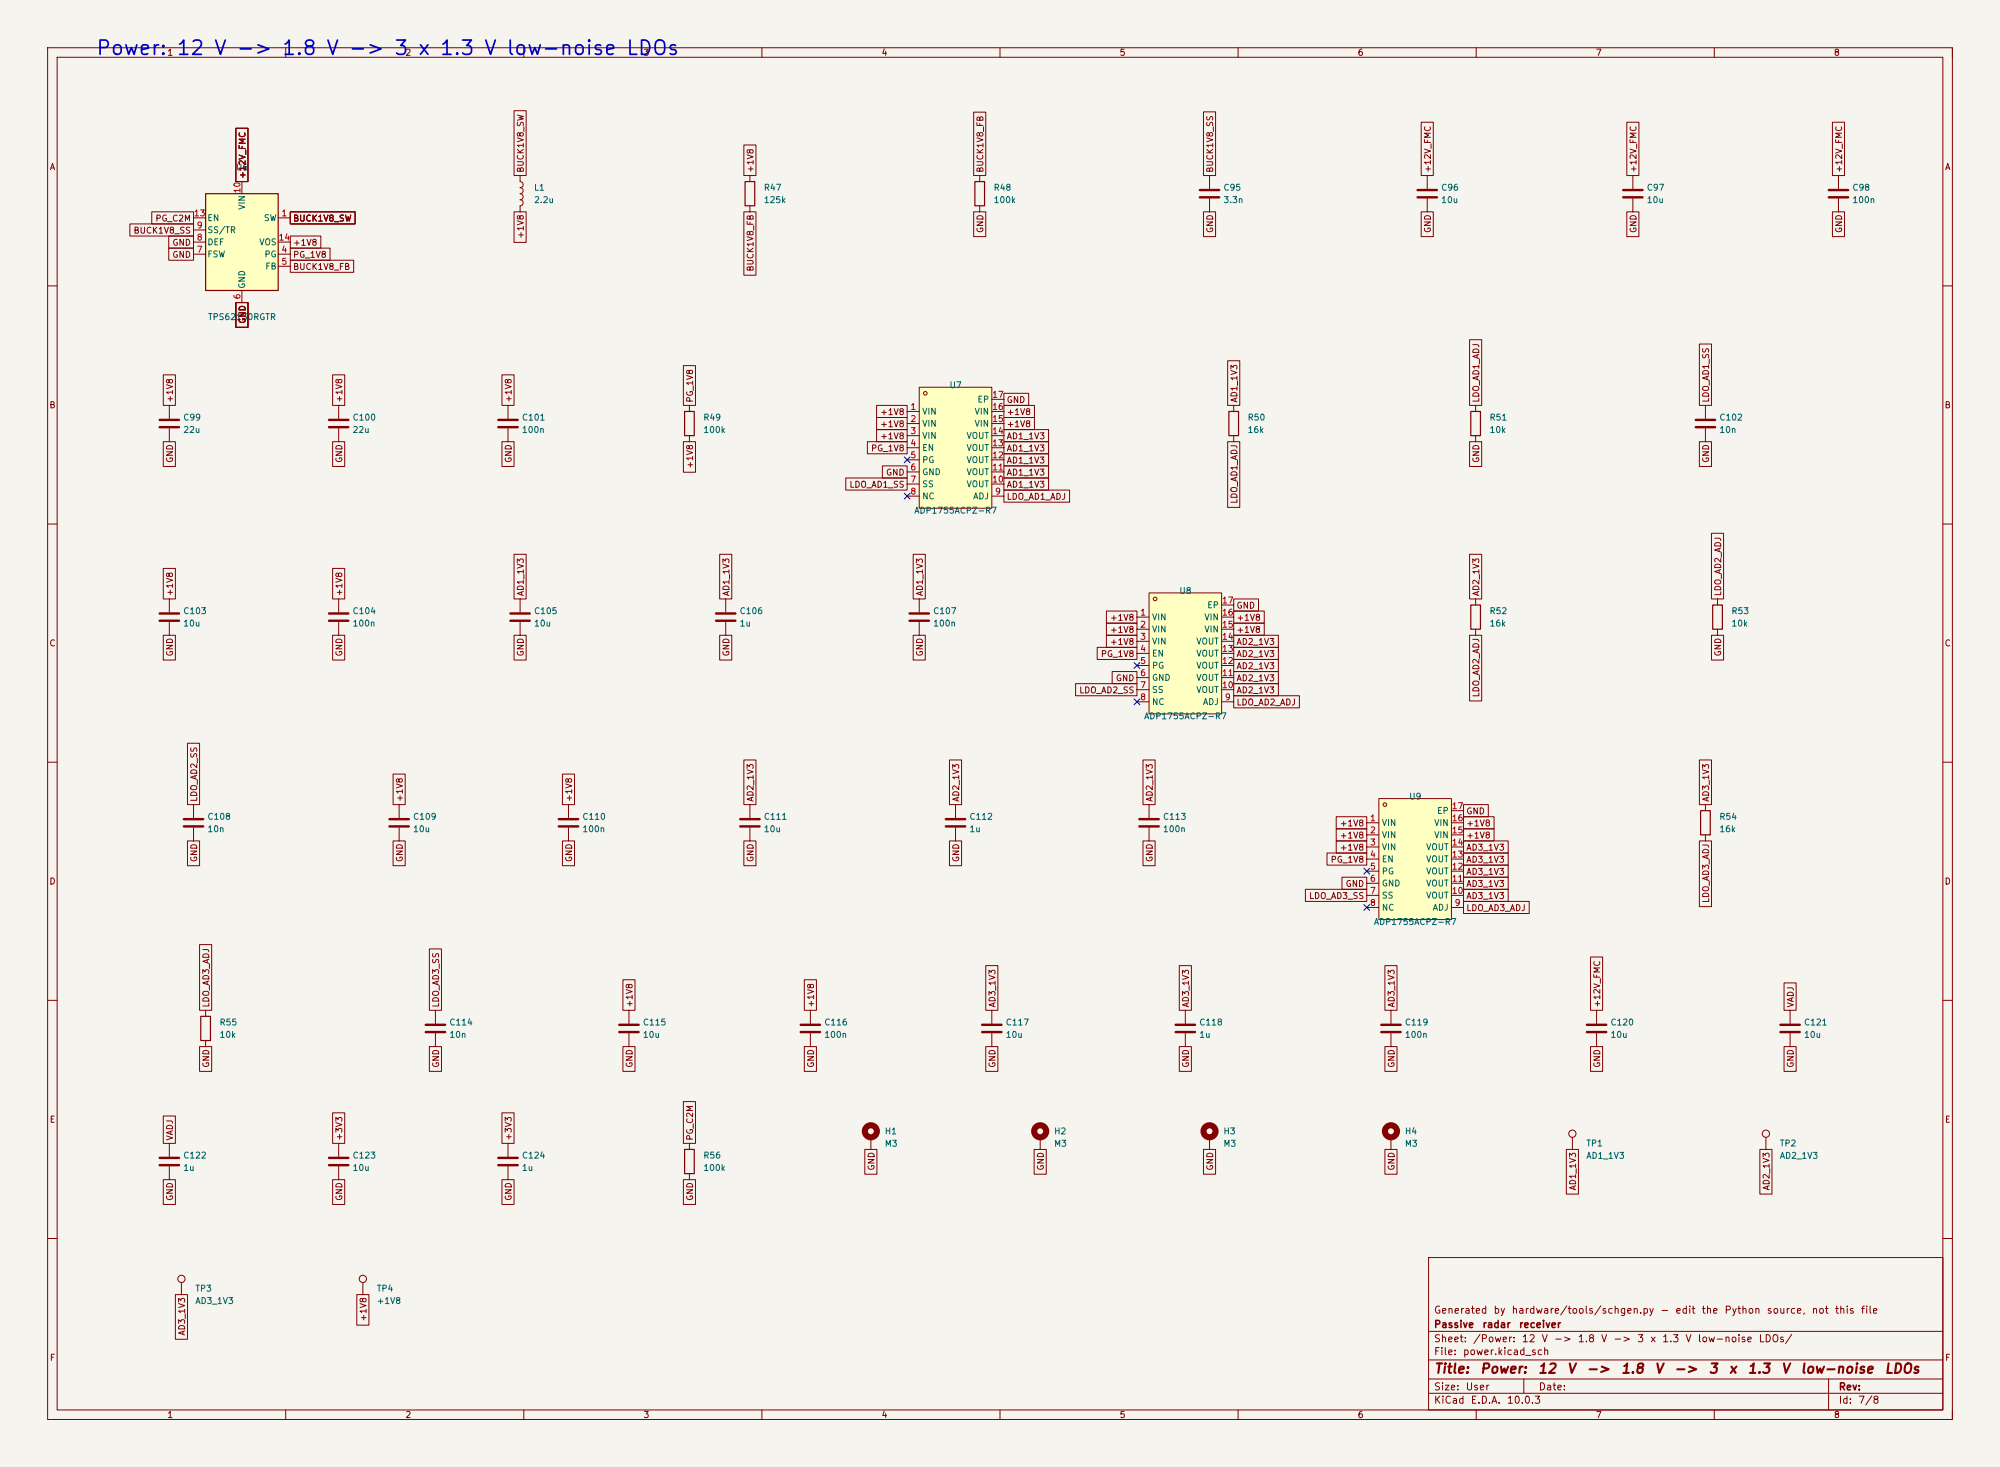
[picture p52: page 7]

Power: 12 V -> 1.8 V -> 3 x 1.3 V low-noise LDOs

VOUT 10 VOUT 11 VOUT 12 VOUT 13 VOUT 14 VIN 15 VIN 16 EP 17 U7

VOUT 10 VOUT 11 VOUT 12 VOUT 13 VOUT 14 VIN 15 VIN 16 EP 17 U8

VOUT 10 VOUT 11 VOUT 12 VOUT 13 VOUT 14 VIN 15 VIN 16 EP 17 U9

Generated by hardware/tools/schgen.py - edit the Python source, not this file
Passive radar receiver
Sheet: /Power: 12 V -> 1.8 V -> 3 x 1.3 V low-noise LDOs/
File: power.kicad_sch
Title: Power: 12 V -> 1.8 V -> 3 x 1.3 V low-noise LDOs

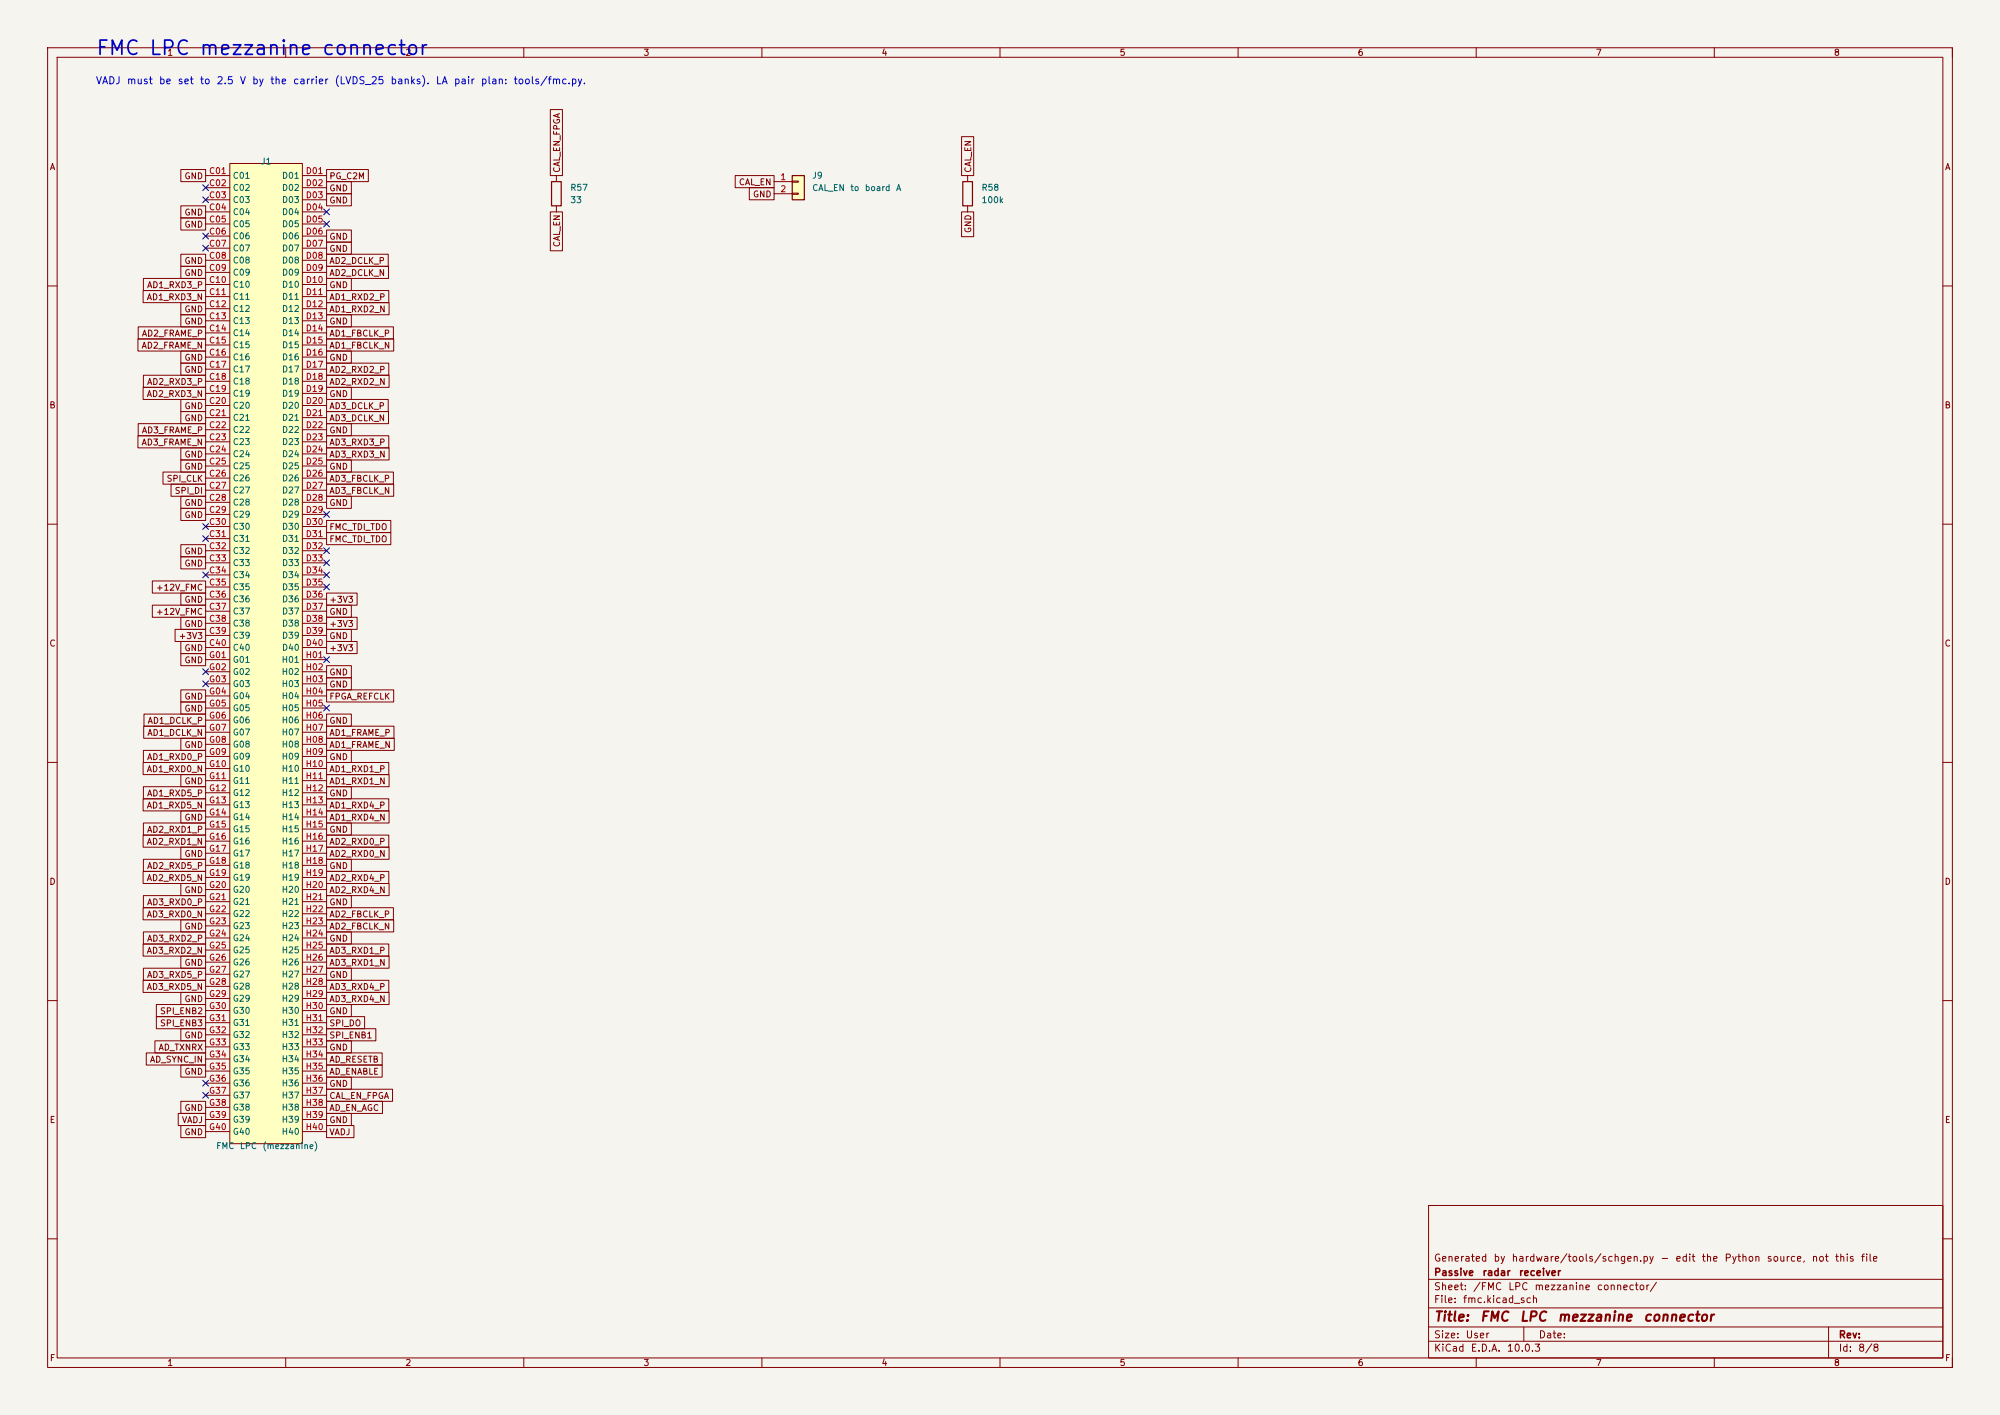
[picture p53: page 8]

FMC LPC mezzanine connector
GND

VADJ must be set to 2.5 V by the carrier (LVDS_25 banks). LA pair plan: tools/fmc.py.

Generated by hardware/tools/schgen.py - edit the Python source, not this file
Passive radar receiver
Sheet: /FMC LPC mezzanine connector/
File: fmc.kicad_sch
Title: FMC LPC mezzanine connector
