ajisrawi/passive-radar-counter-drone/hardware/release/board_c/board_c_schematic.pdf

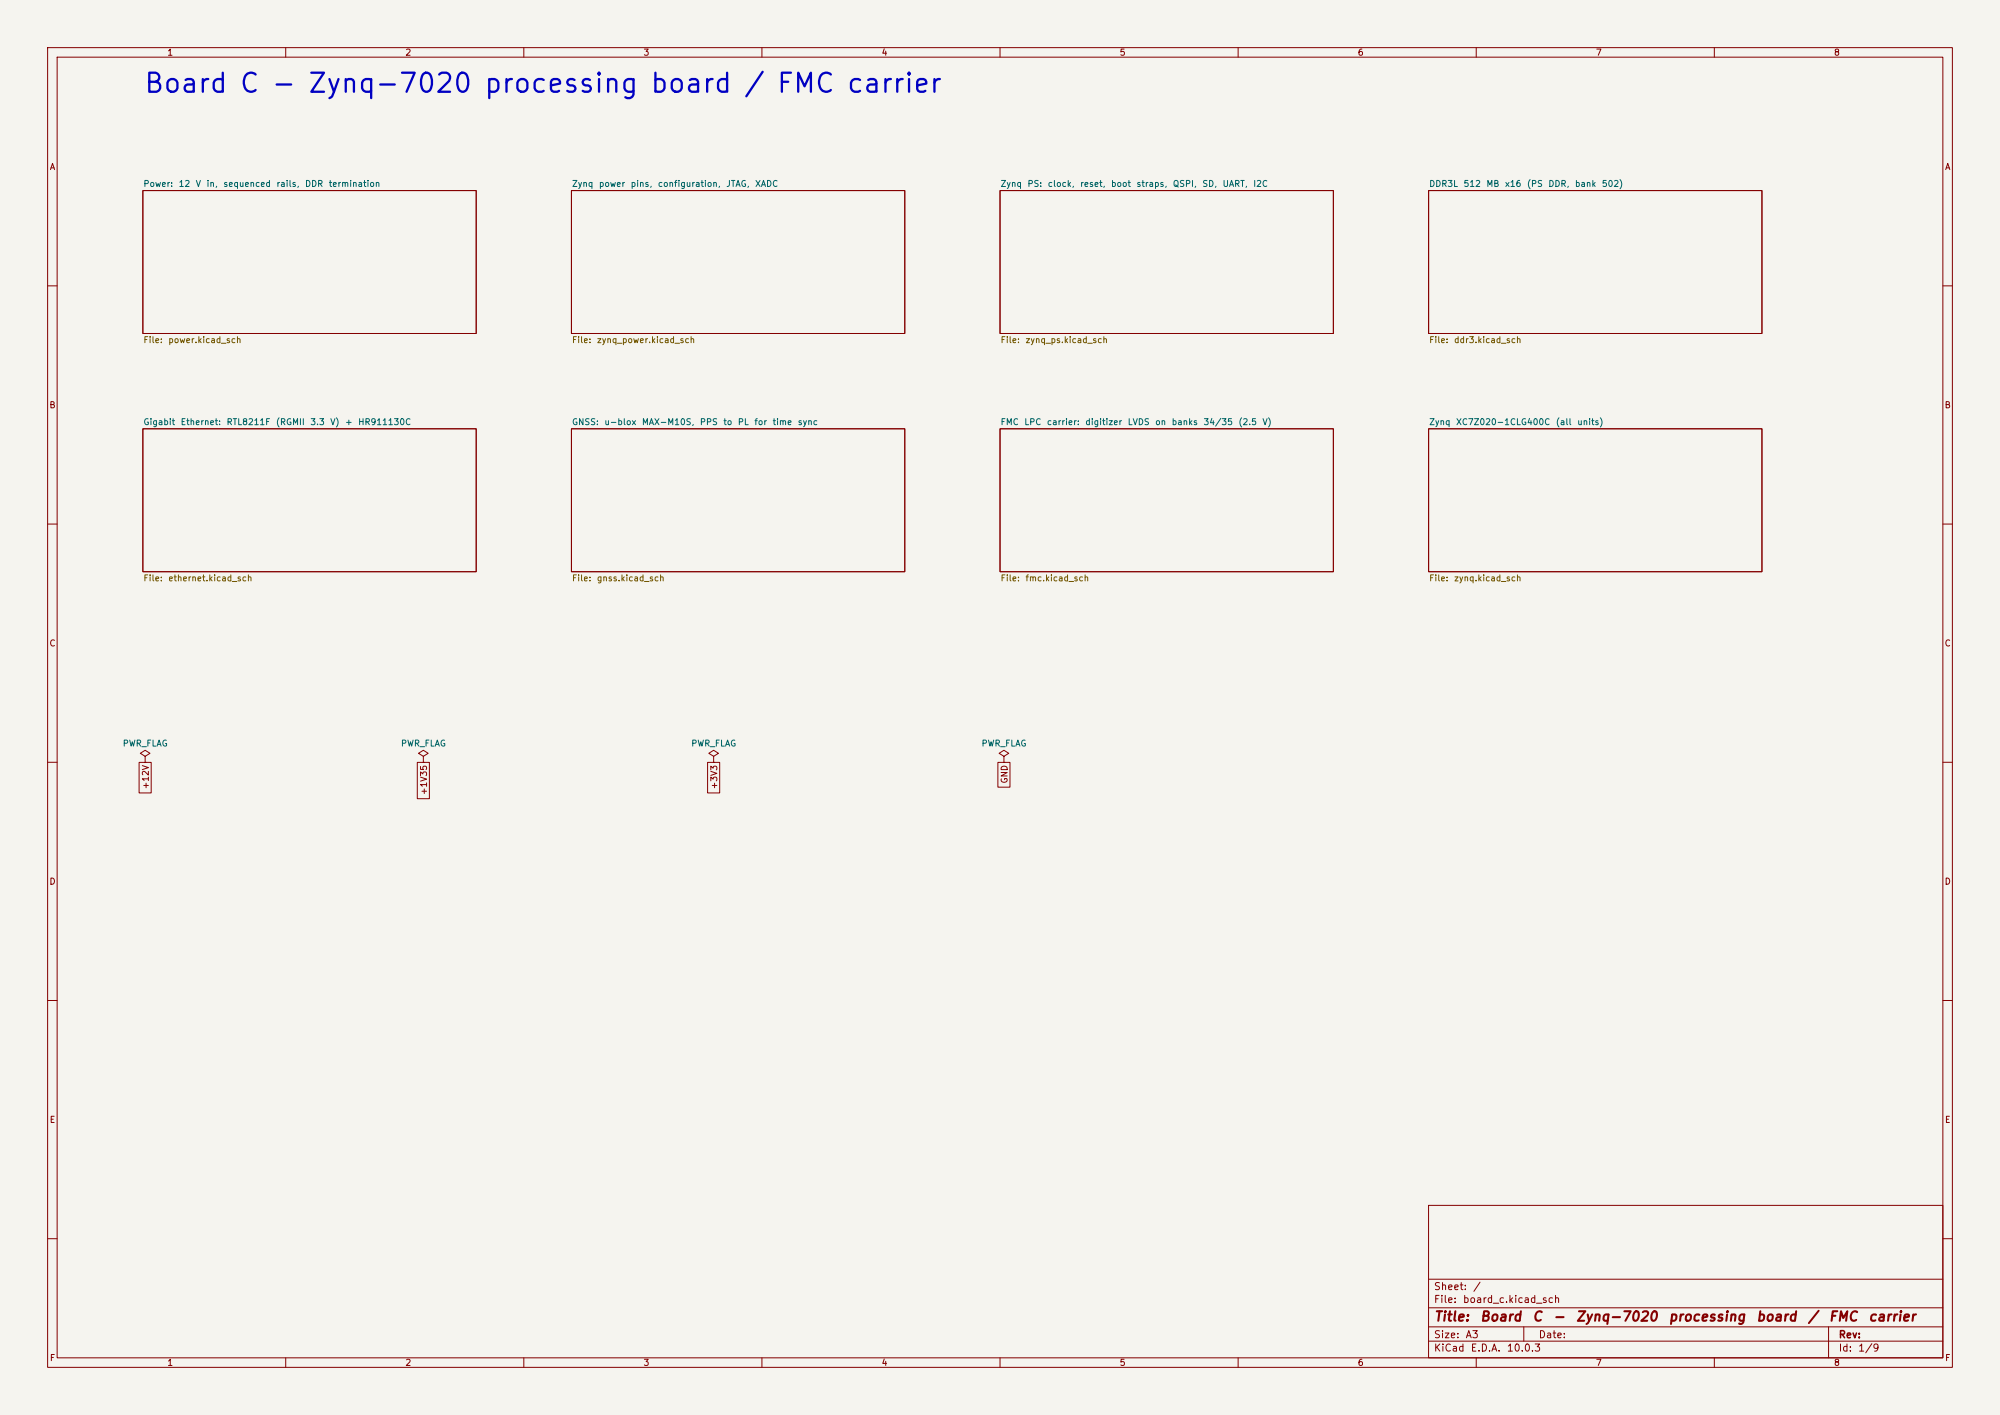
[picture p54: page 1]

Board C - Zynq-7020 processing board / FMC carrier

Zynq power pins, configuration, JTAG, XADC

Zynq PS: clock, reset, boot straps, QSPI, SD, UART, I2C

Sheet: /
File: board_c.kicad_sch
Title: Board C - Zynq-7020 processing board / FMC carrier

Size: A3 | Rev:
KiCad E.D.A. 10.0.3 | Id: 1/9 | F Date:

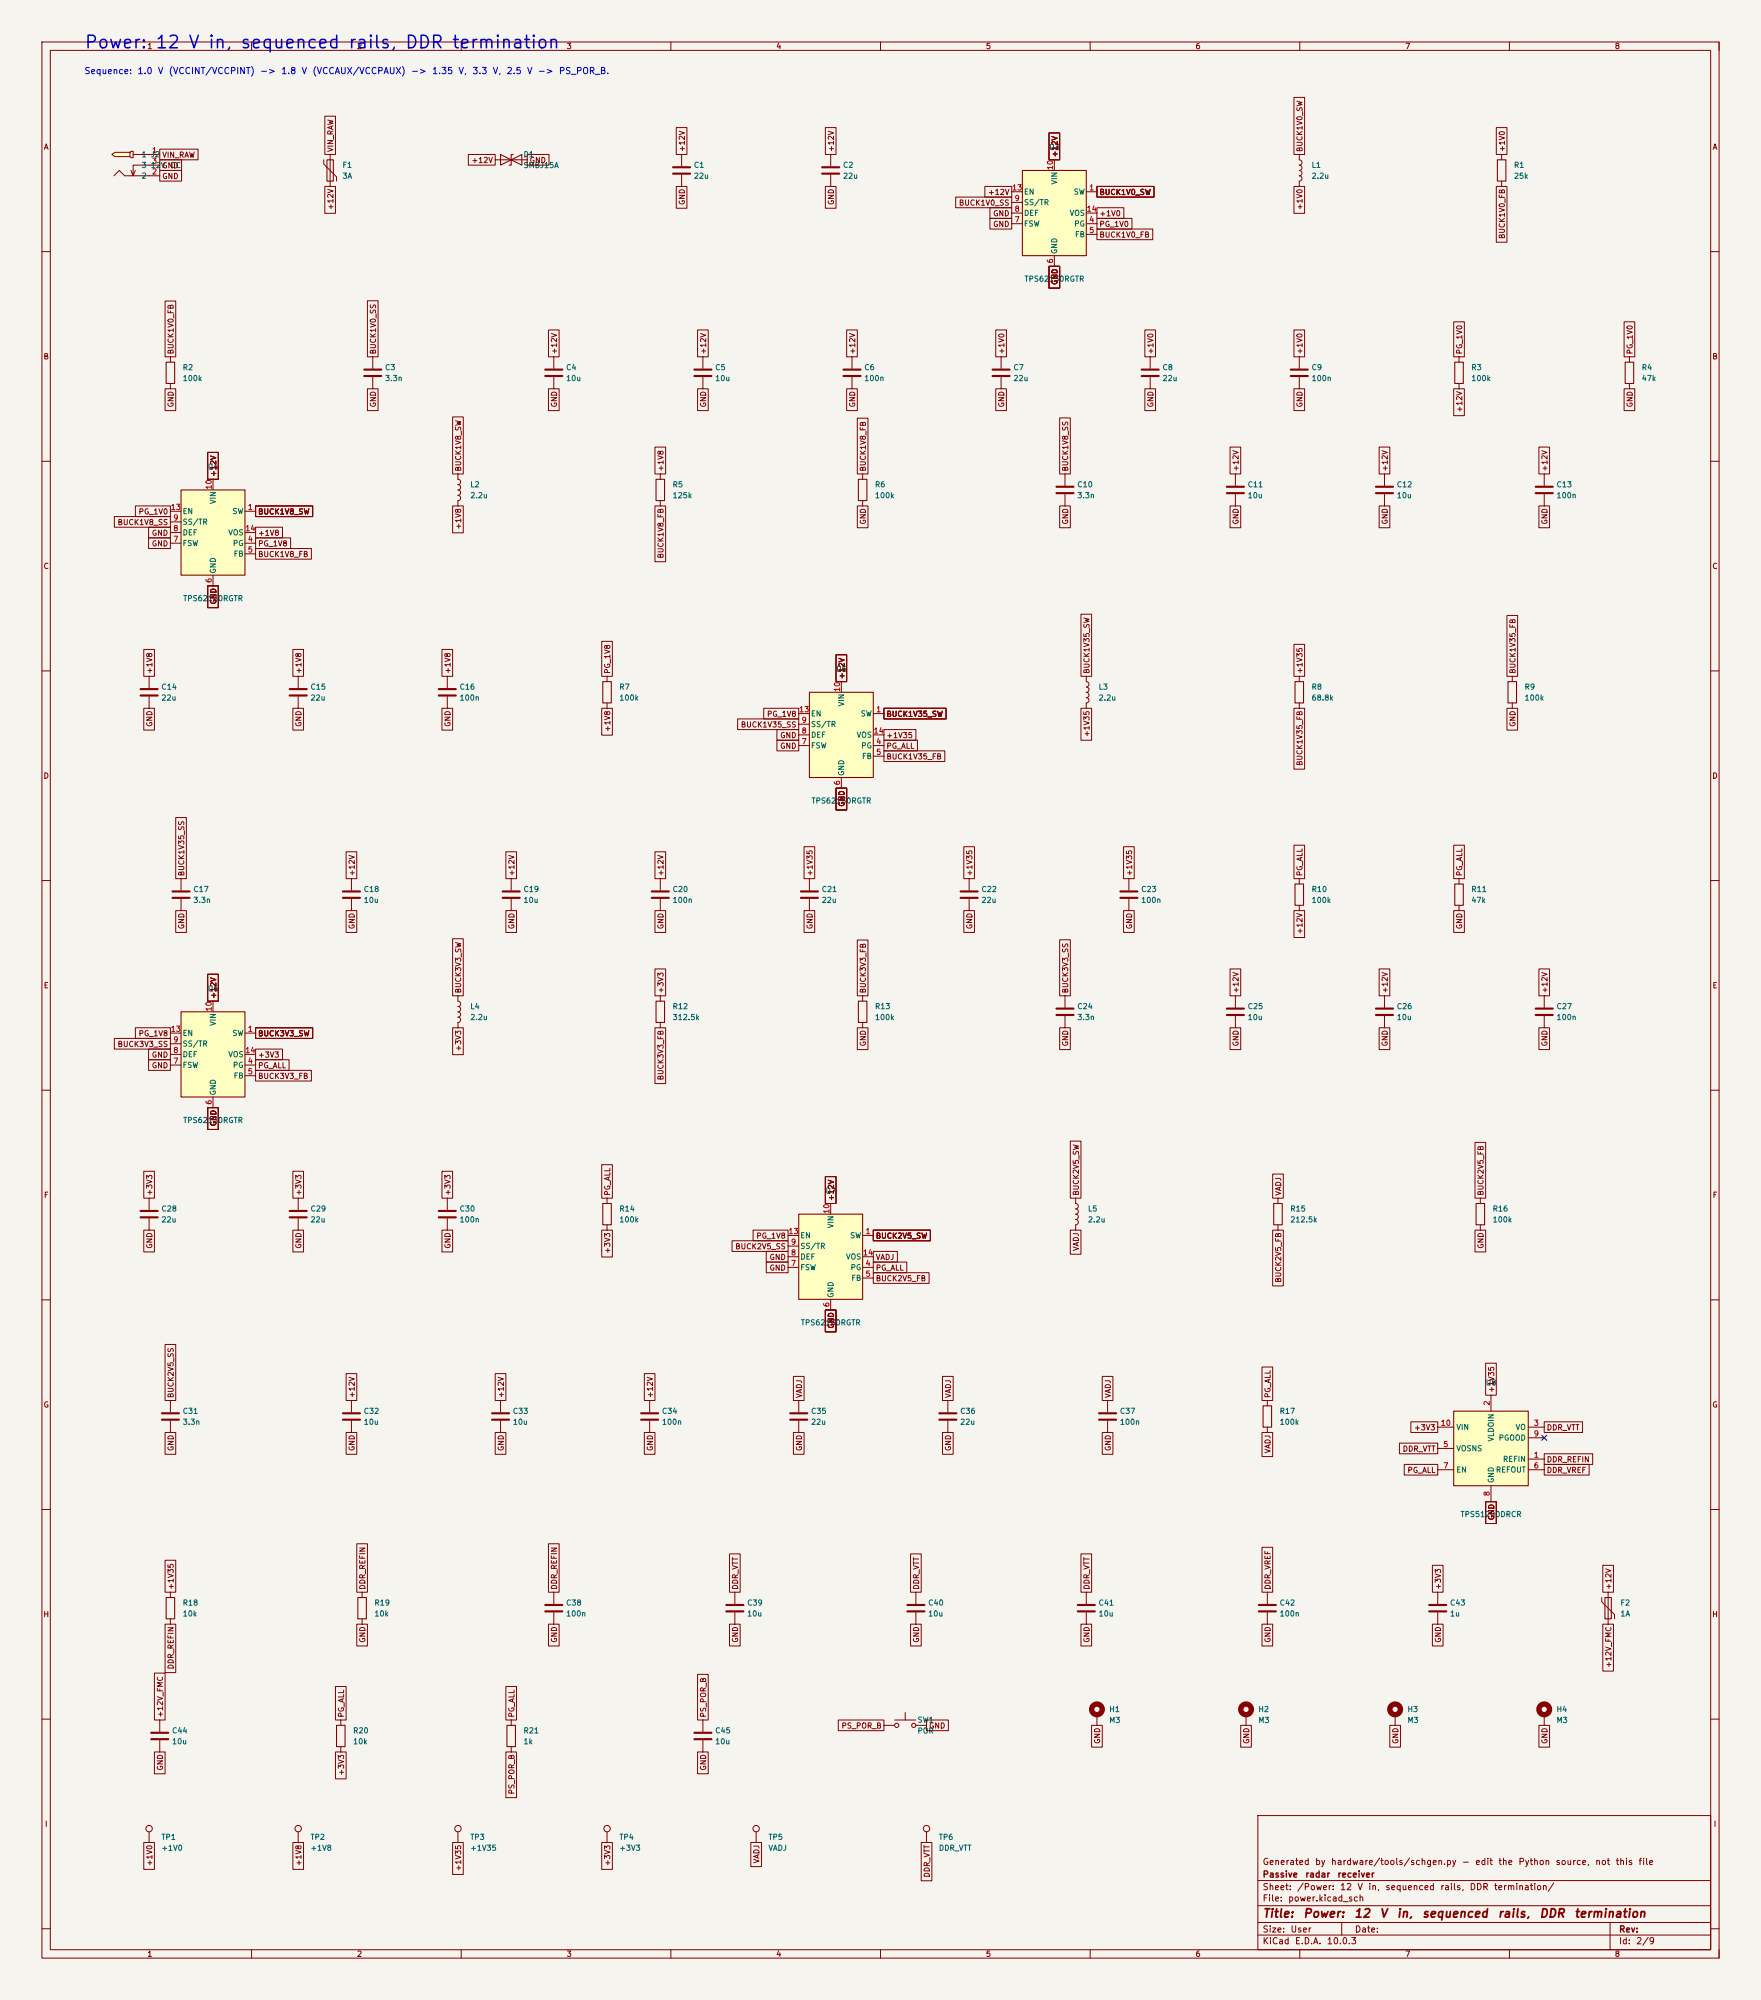
[picture p55: page 2]

Power: 12 V in, sequenced rails, DDR termination

Sequence: 1.0 V (VCCINT/VCCPINT) -> 1.8 V (VCCAUX/VCCPAUX) -> 1.35 V, 3.3 V, 2.5 V -> PS_POR_B.

Generated by hardware/tools/schgen.py - edit the Python source, not this file
Passive radar receiver
Sheet: /Power: 12 V in, sequenced rails, DDR termination/
File: power.kicad_sch
Title: Power: 12 V in, sequenced rails, DDR termination

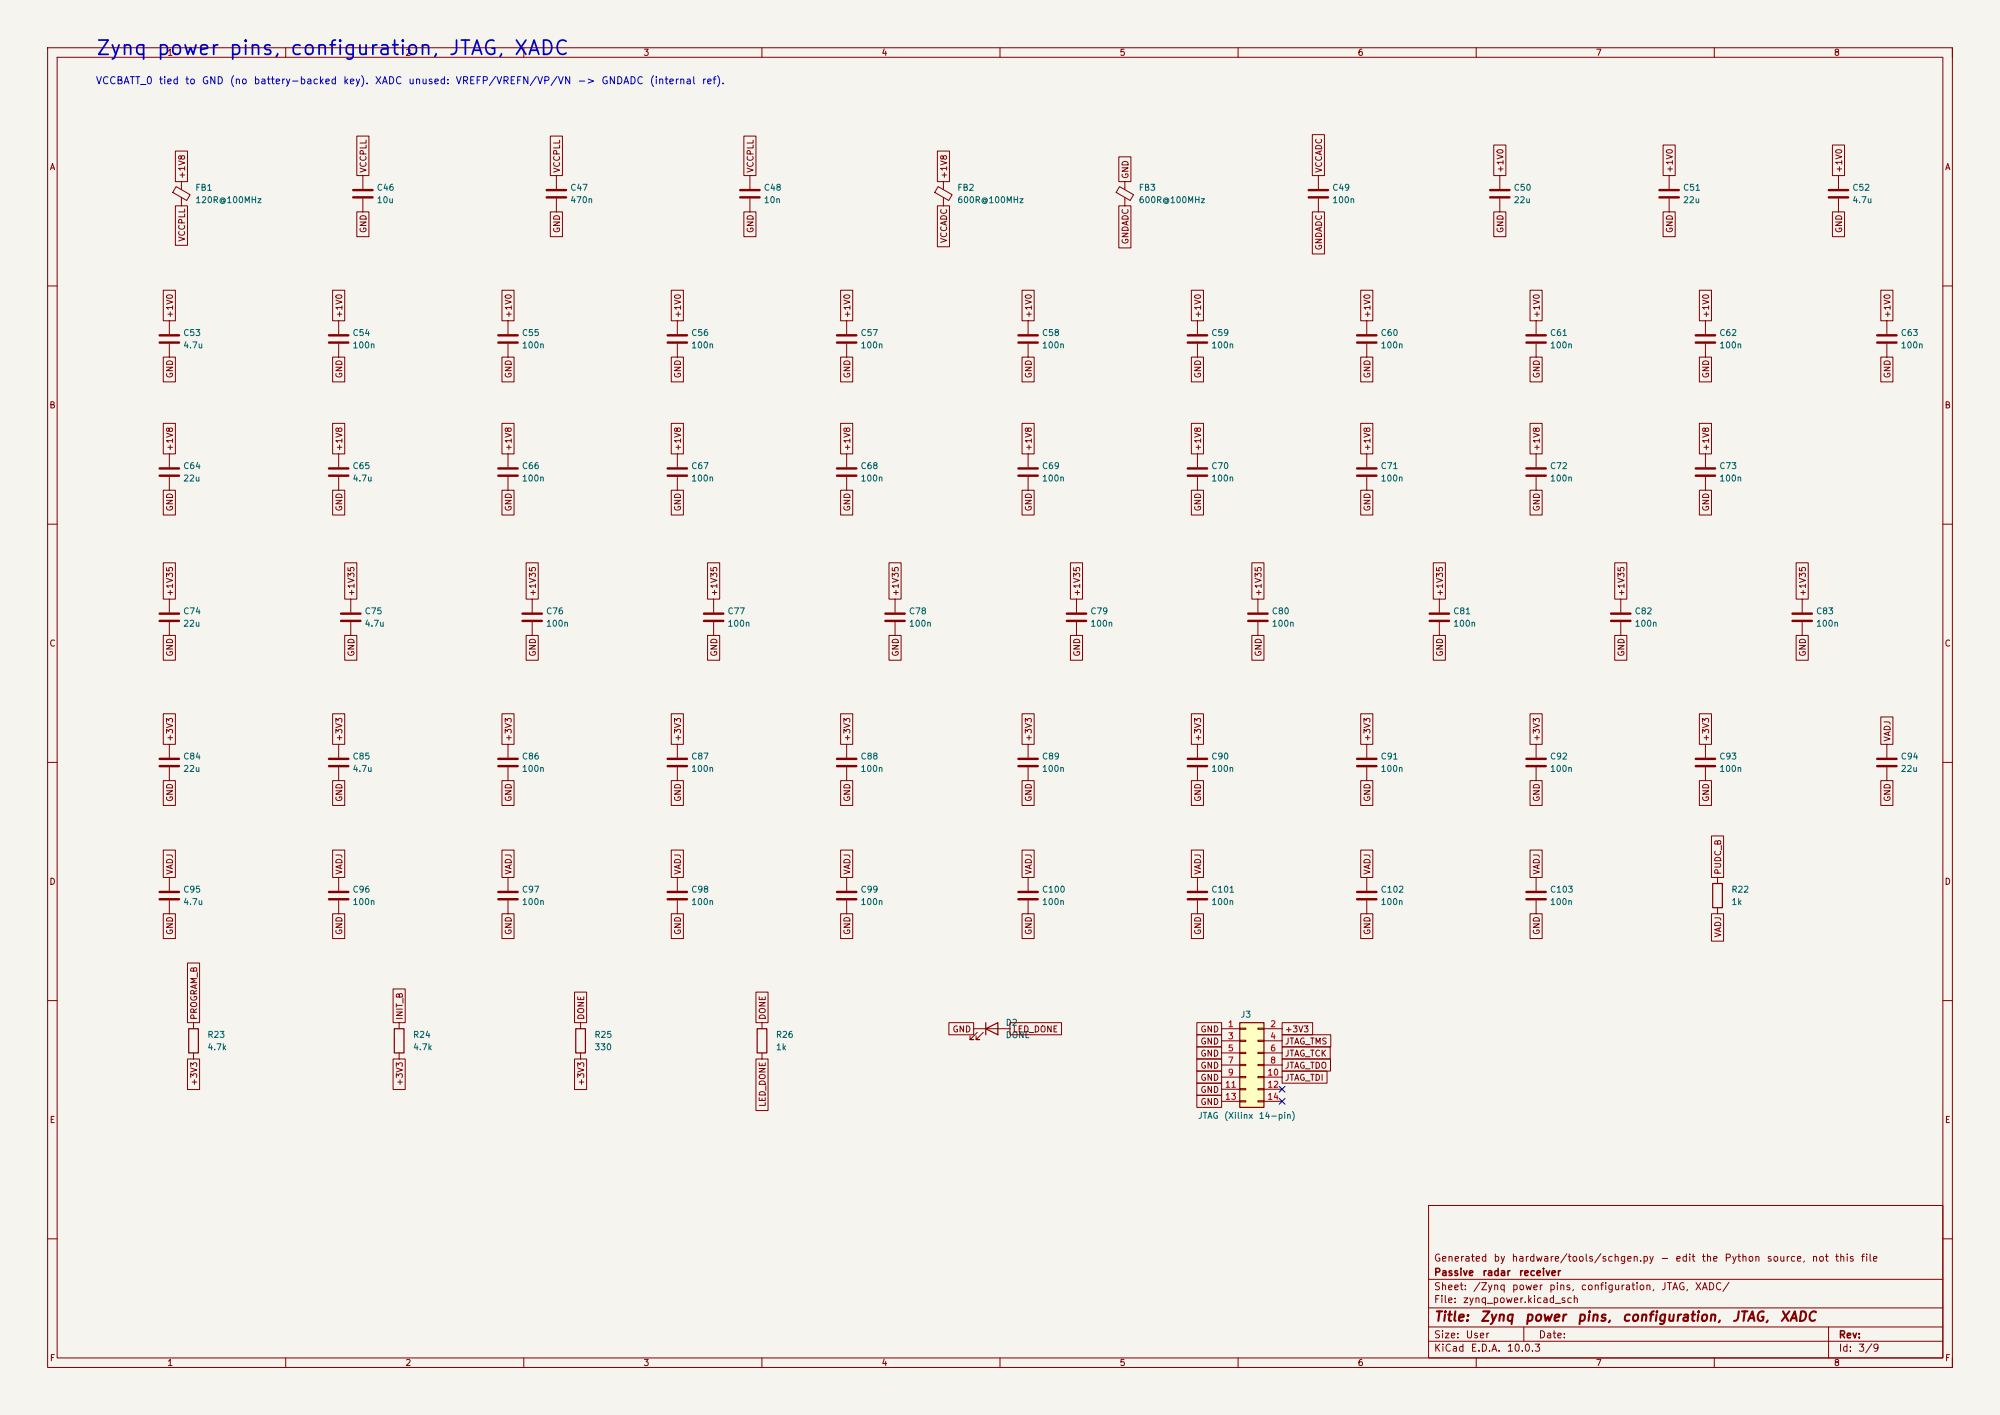
[picture p56: page 3]

VCCBATT_0 tied to GND (no battery-backed key). XADC unused: VREFP/VREFN/VP/VN -> GNDADC (internal ref).

Generated by hardware/tools/schgen.py - edit the Python source, not this file
Passive radar receiver
Sheet: /Zynq power pins, configuration, JTAG, XADC/
File: zynq_power.kicad_sch
Title: Zynq power pins, configuration, JTAG, XADC

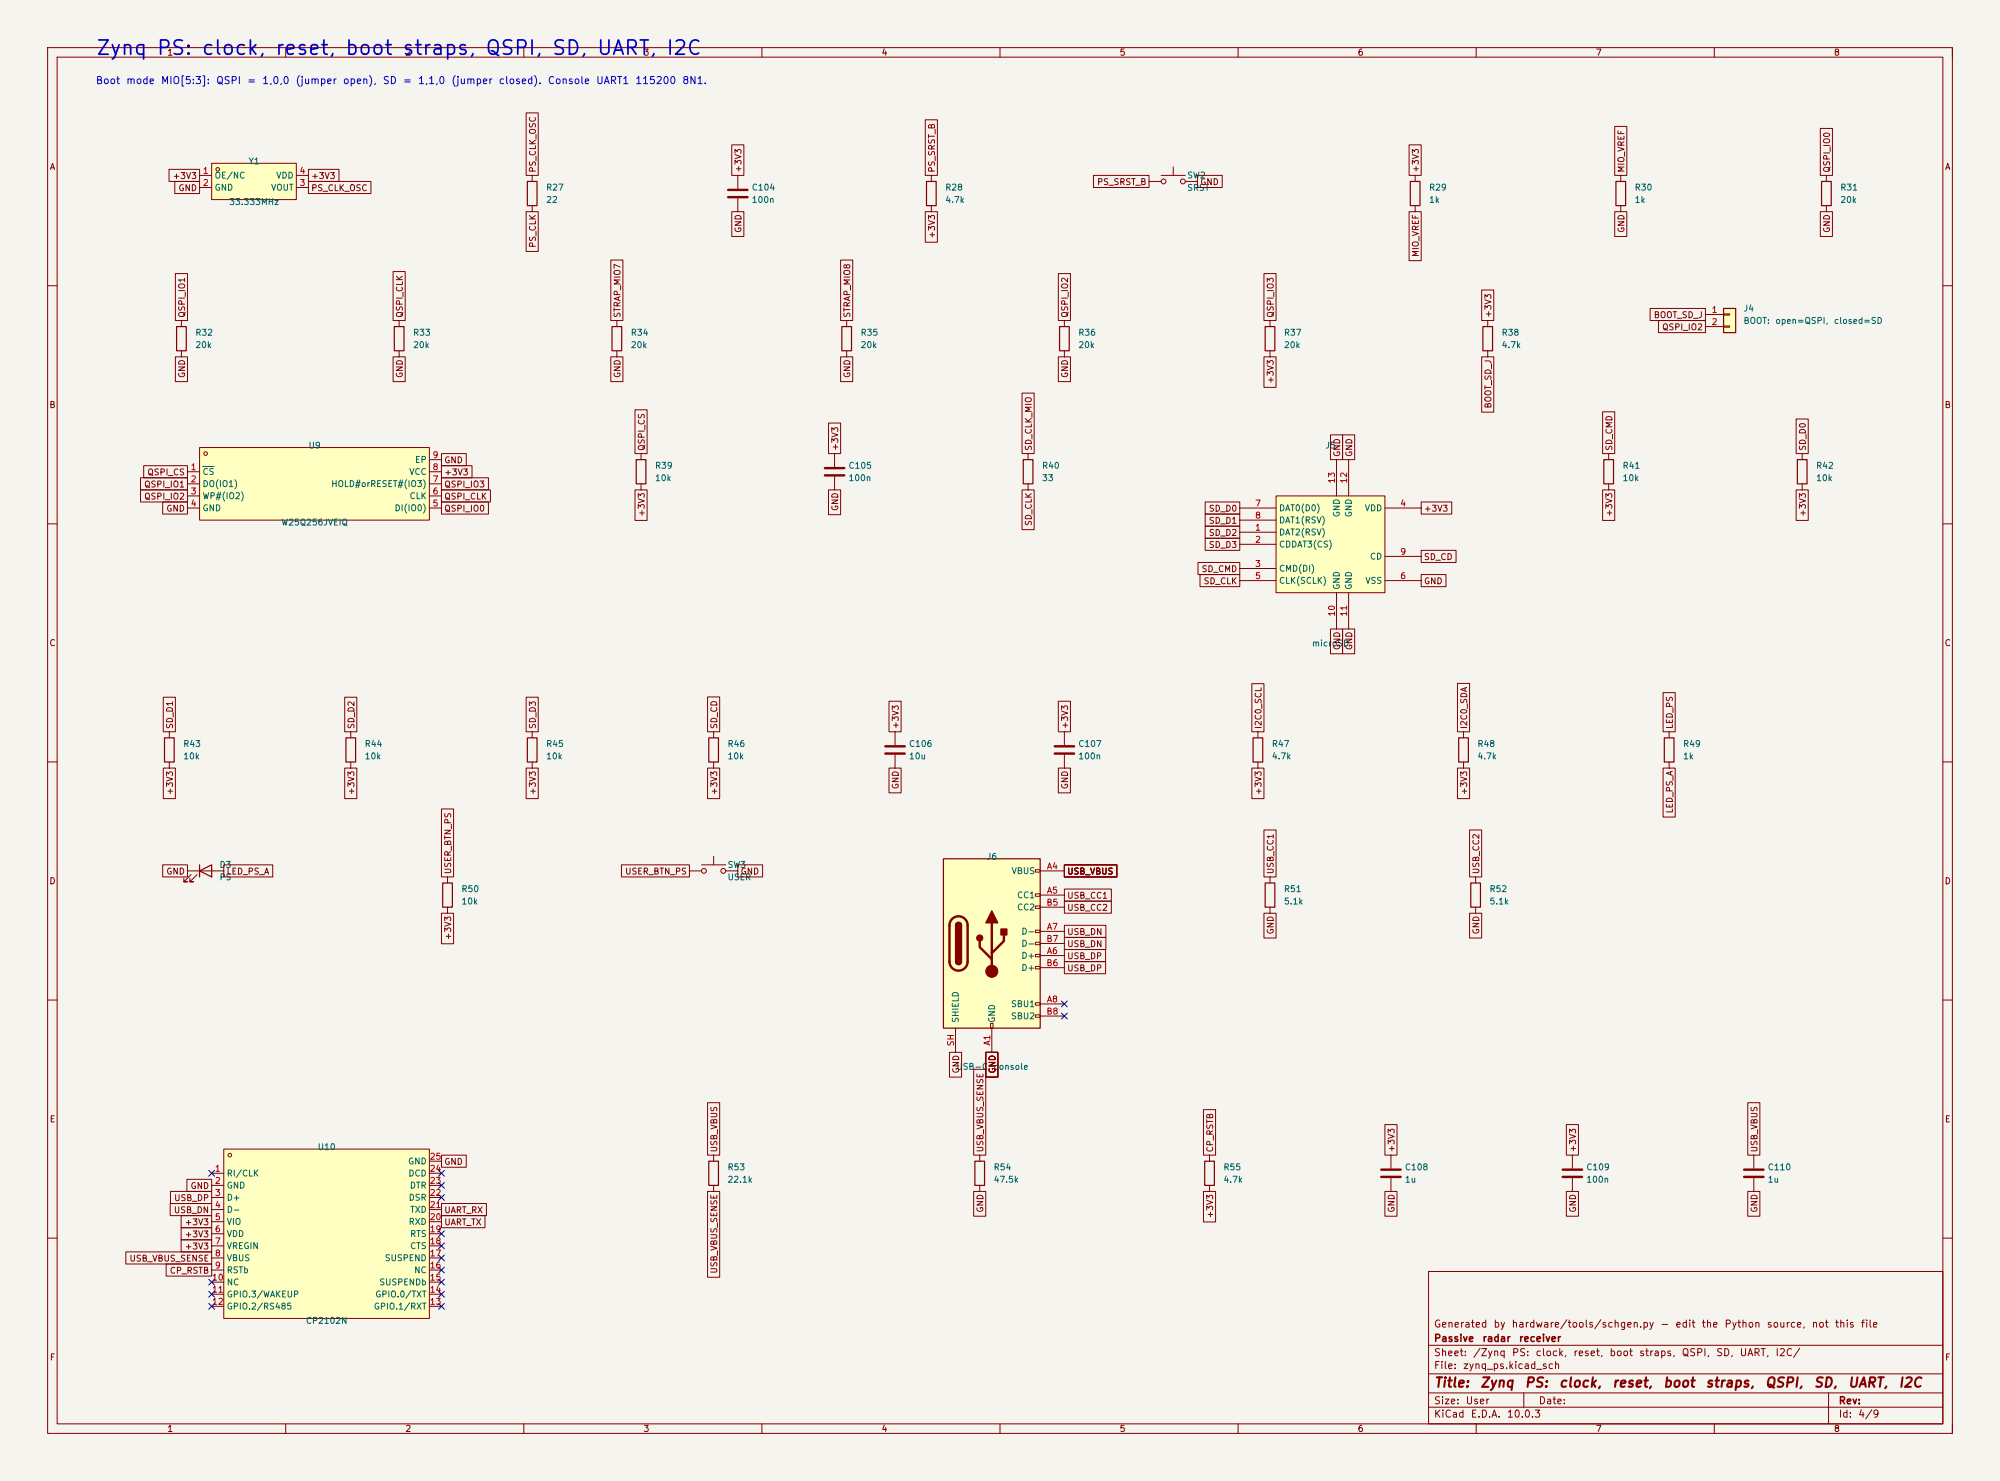
[picture p57: page 4]

Zynq PS: clock, reset, boot straps, QSPI, SD, UART, I2C

Boot mode MIO[5:3]: QSPI = 1,0,0 (jumper open), SD = 1,1,0 (jumper closed). Console UART1 115200 8N1.

J4BOOT: open=QSPI, closed=SD

Generated by hardware/tools/schgen.py - edit the Python source, not this file
Passive radar receiver
Sheet: /Zynq PS: clock, reset, boot straps, QSPI, SD, UART, I2C/
File: zynq_ps.kicad_sch
Title: Zynq PS: clock, reset, boot straps, QSPI, SD, UART, I2C

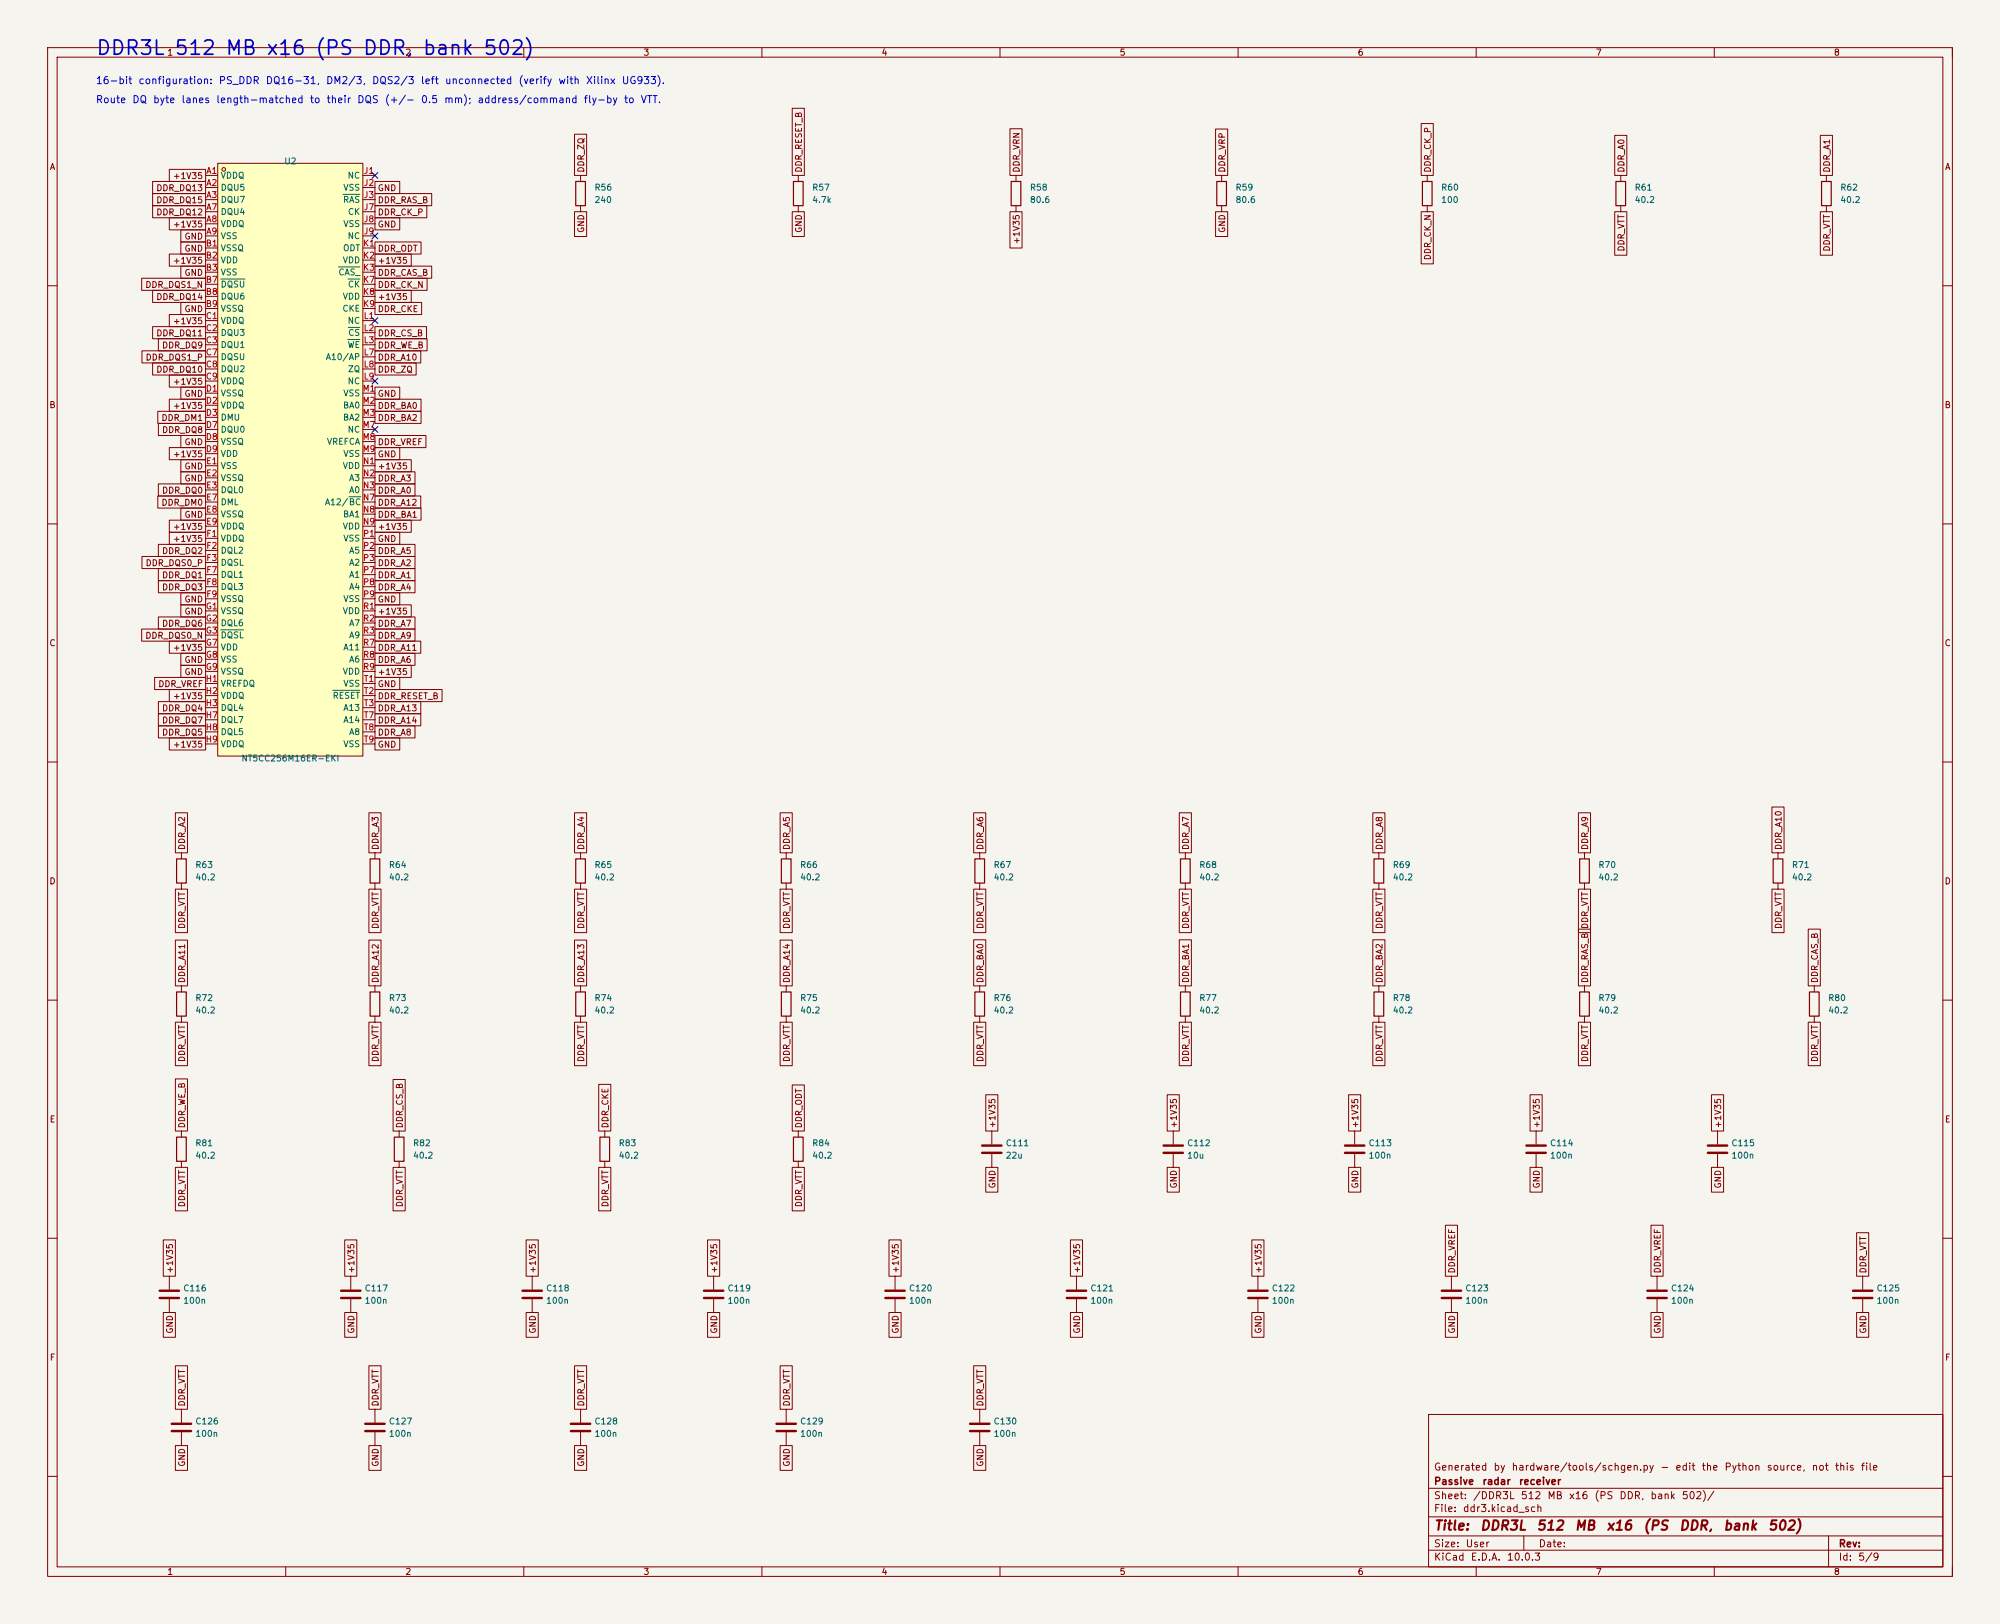
[picture p58: page 5]

DDR3L 512 MB x16 (PS DDR, bank 502)
GND +1V35 DDR_A6 DDR_A11 DDR_A7 DDR_A9 DDR_DQ5 DDR_DQ7 DDR_DQ4 +1V35 DDR_VREF GND

16-bit configuration: PS_DDR DQ16-31, DM2/3, DQS2/3 left unconnected (verify with Xilinx UG933).

Route DQ byte lanes length-matched to their DQS (+/- 0.5 mm); address/command fly-by to VTT.

VDD K8 CKE K9 NC L1 CS L2 WE L3

Generated by hardware/tools/schgen.py - edit the Python source, not this file
Passive radar receiver
Sheet: /DDR3L 512 MB x16 (PS DDR, bank 502)/
File: ddr3.kicad_sch
Title: DDR3L 512 MB x16 (PS DDR, bank 502)

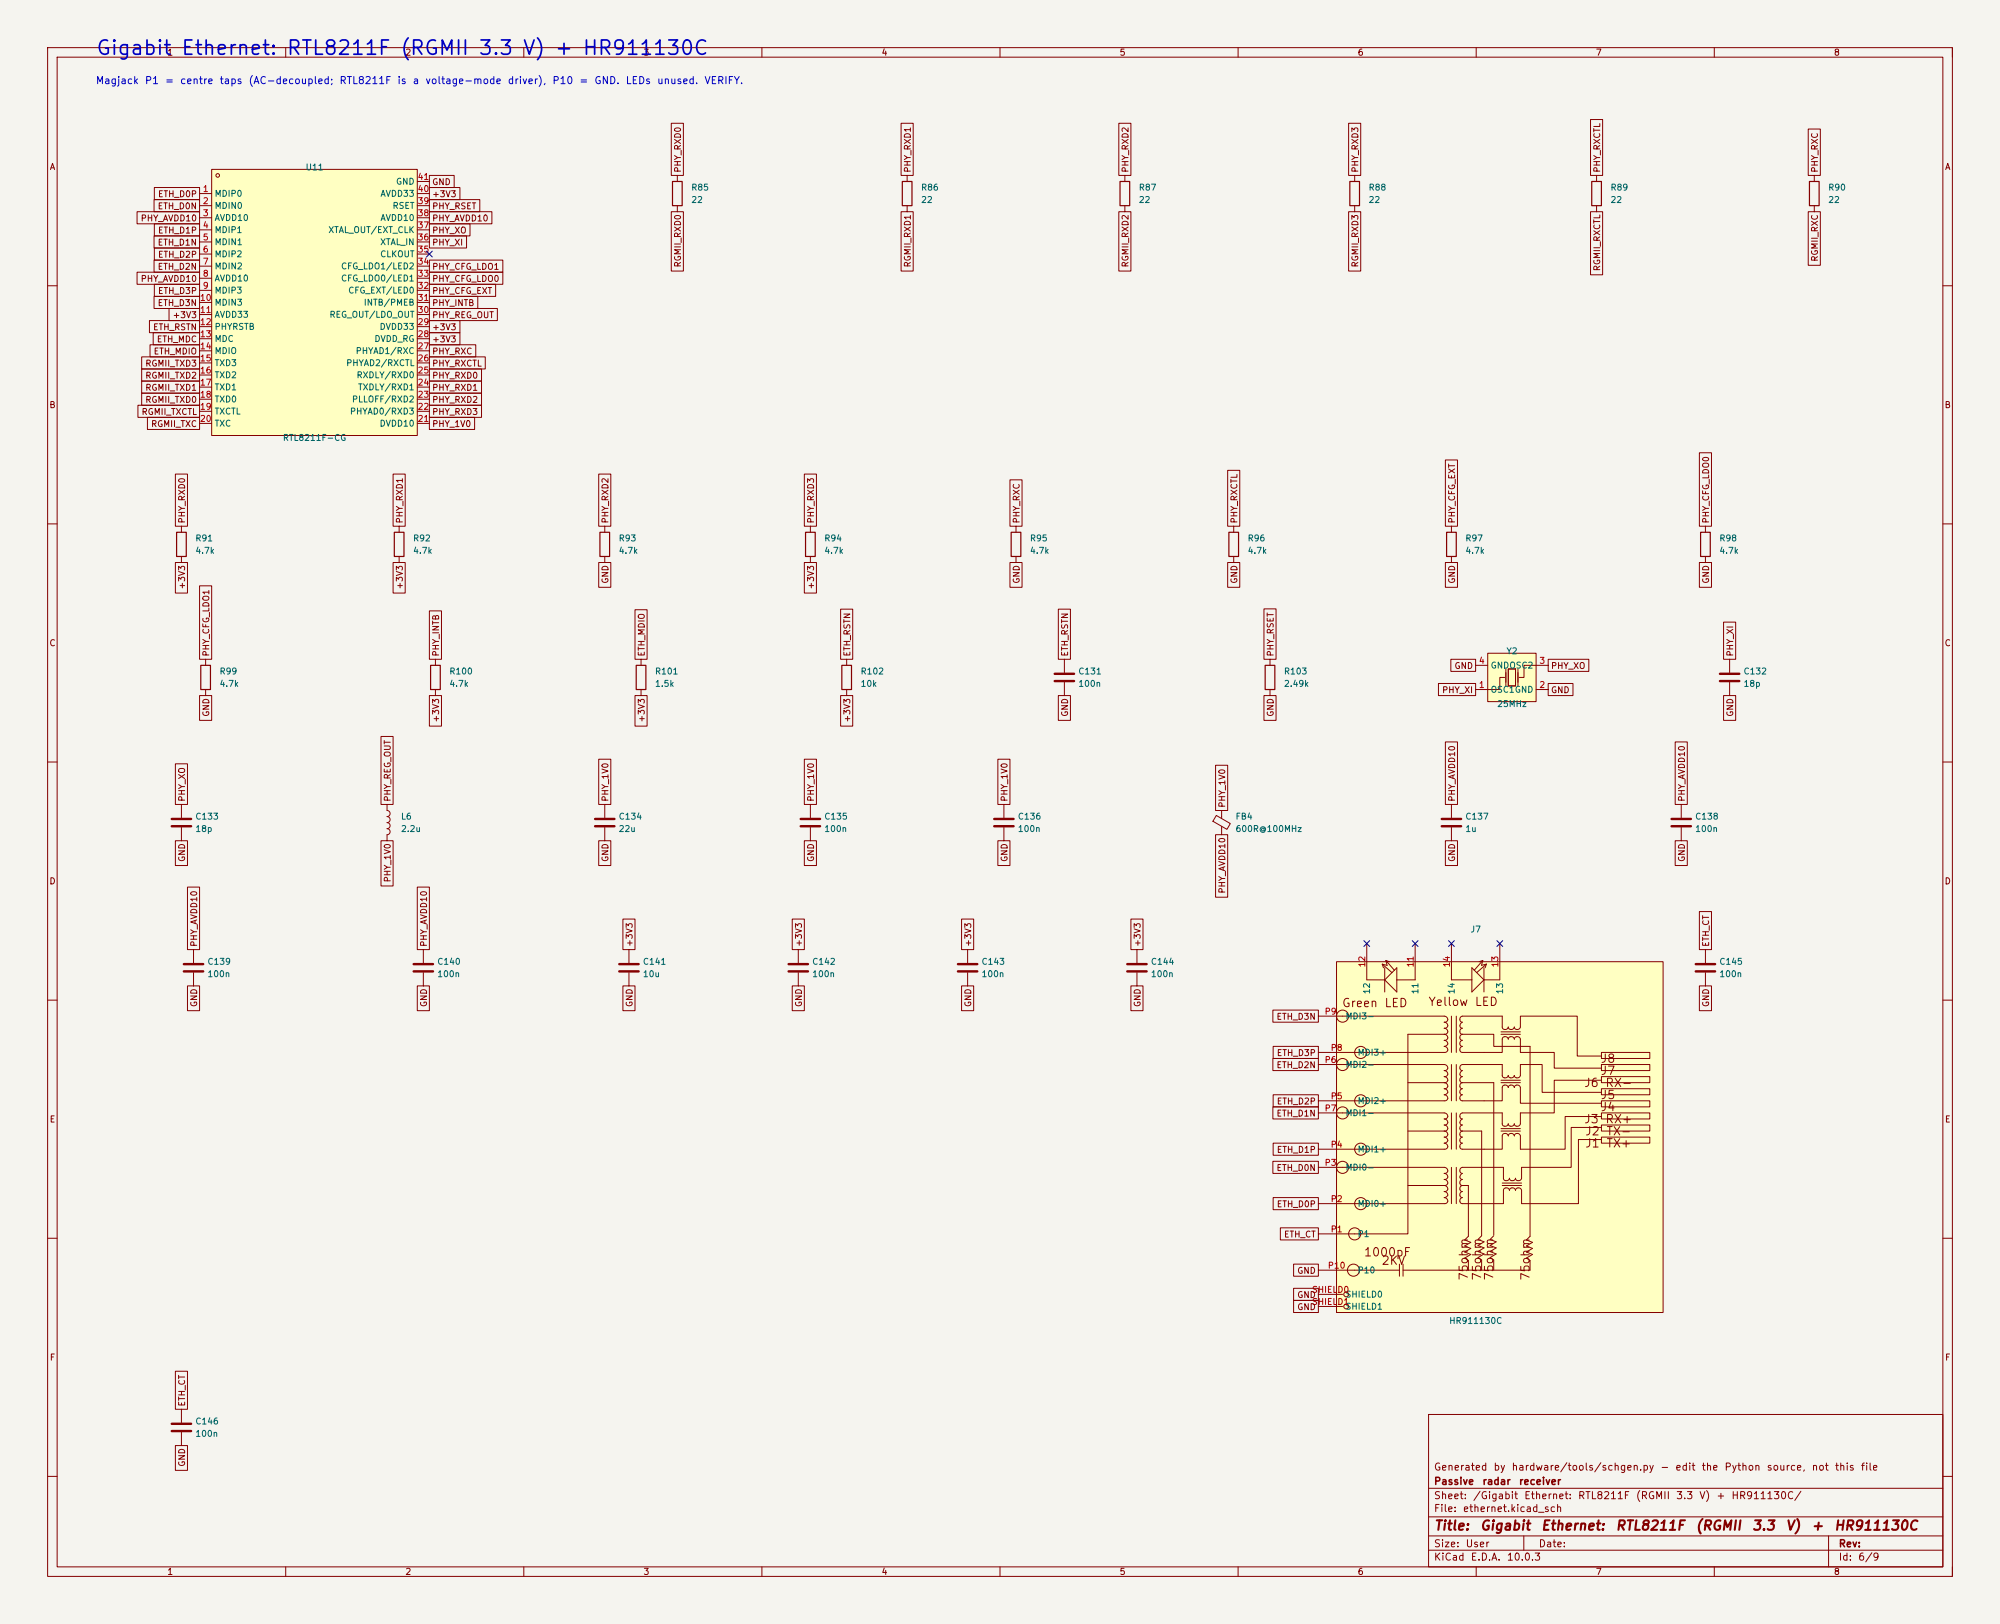
[picture p59: page 6]

Magjack P1 = centre taps (AC-decoupled; RTL8211F is a voltage-mode driver), P10 = GND. LEDs unused. VERIFY.

Generated by hardware/tools/schgen.py - edit the Python source, not this file
Passive radar receiver
Sheet: /Gigabit Ethernet: RTL8211F (RGMII 3.3 V) + HR911130C/
File: ethernet.kicad_sch
Title: Gigabit Ethernet: RTL8211F (RGMII 3.3 V) + HR911130C

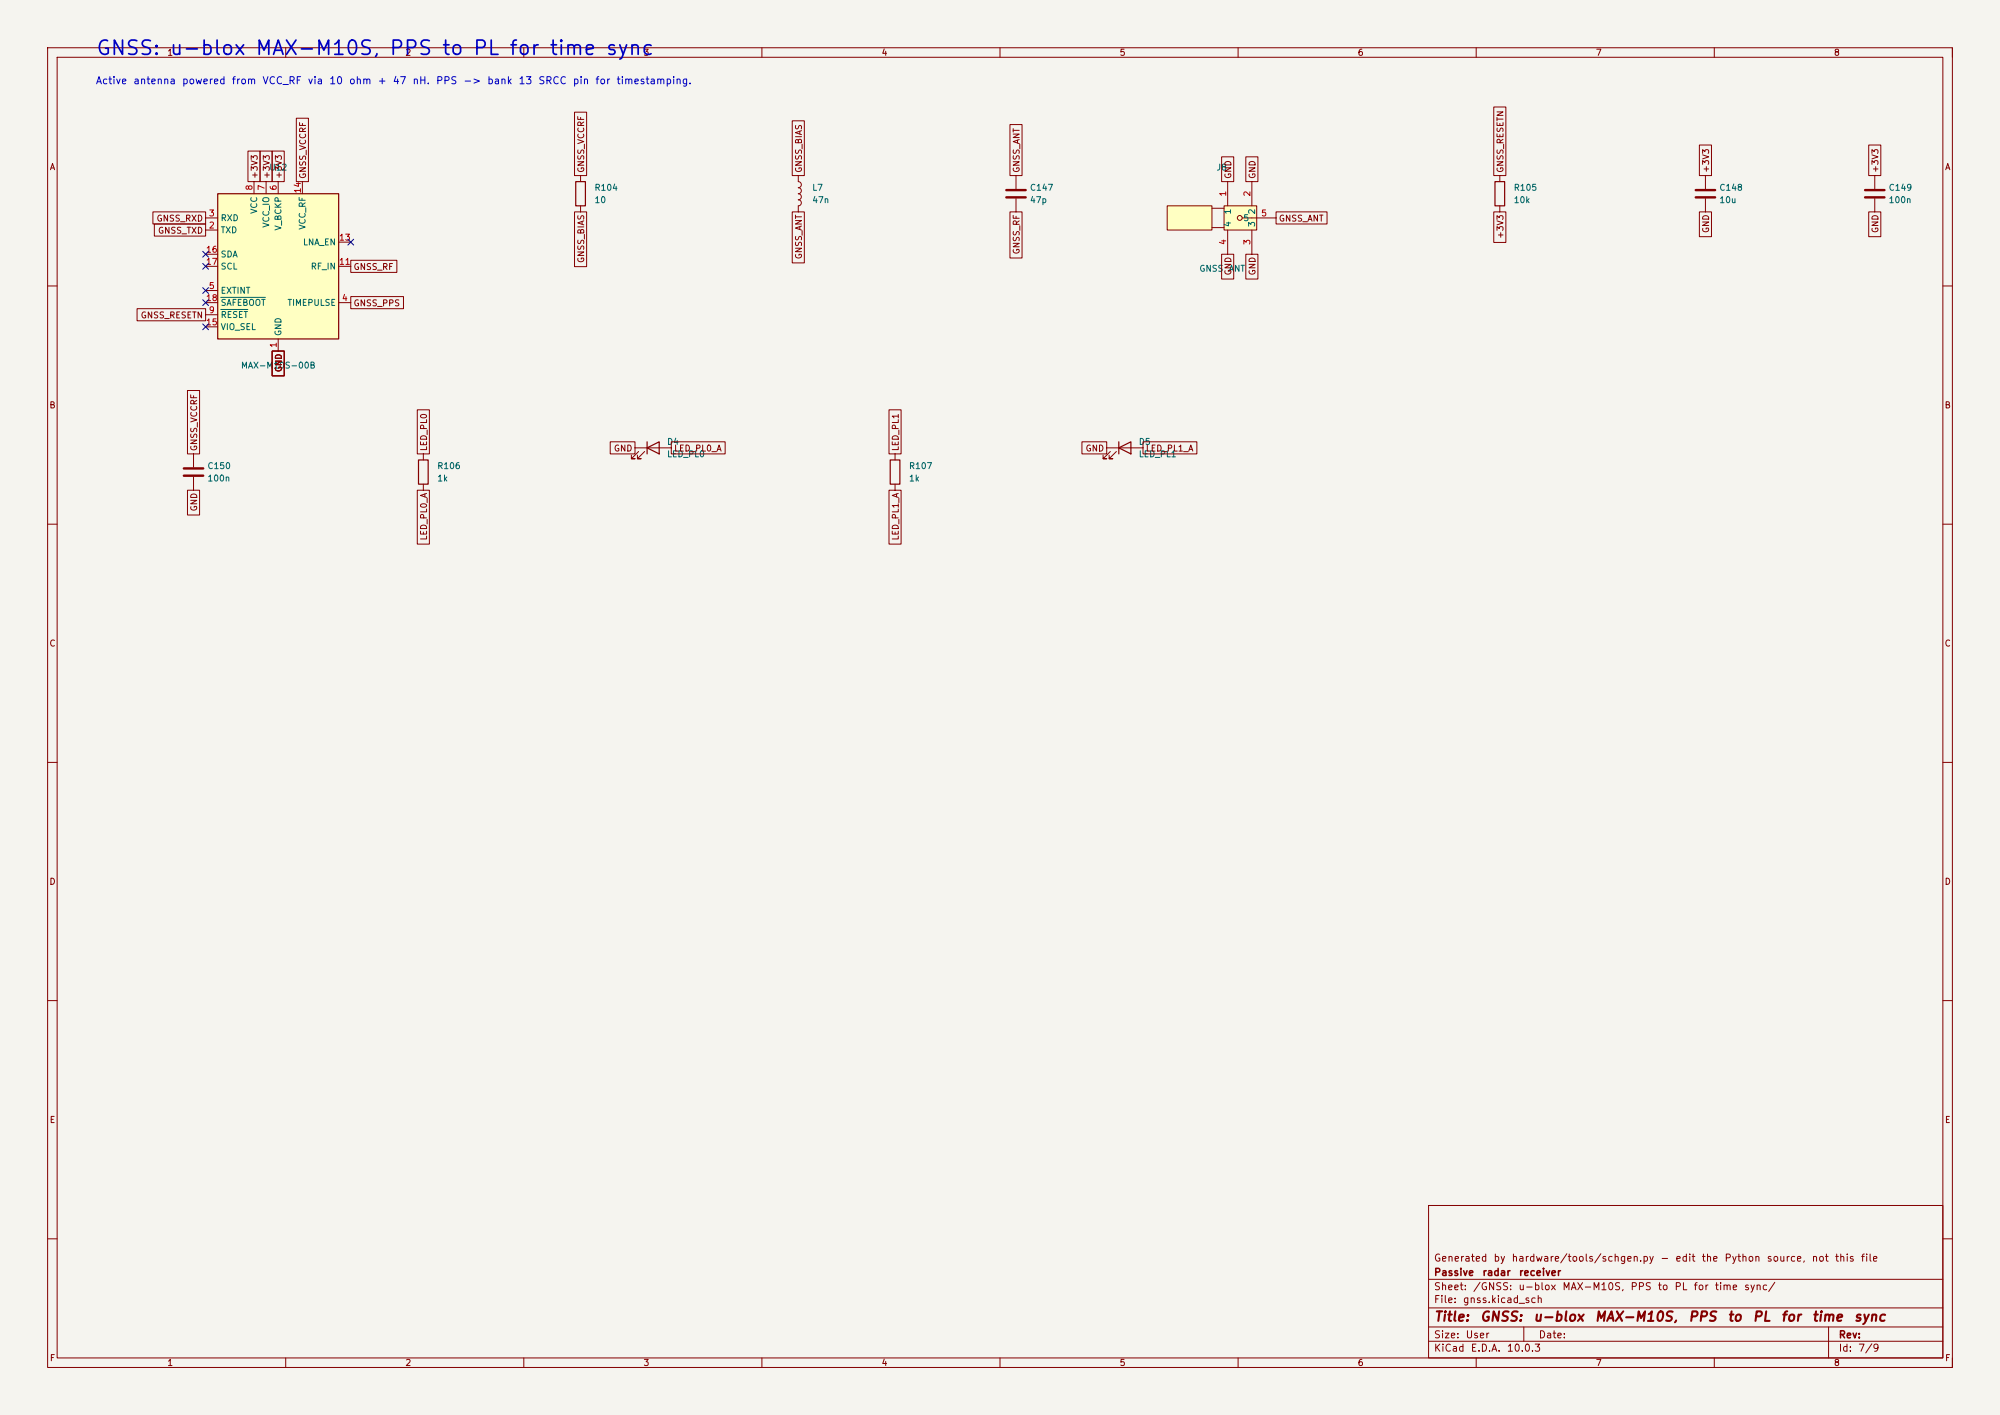
[picture p60: page 7]

GNSS: u-blox MAX-M10S, PPS to PL for time sync

Active antenna powered from VCC_RF via 10 ohm + 47 nH. PPS -> bank 13 SRCC pin for timestamping.

Generated by hardware/tools/schgen.py - edit the Python source, not this file
Passive radar receiver
Sheet: /GNSS: u-blox MAX-M10S, PPS to PL for time sync/
File: gnss.kicad_sch
Title: GNSS: u-blox MAX-M10S, PPS to PL for time sync

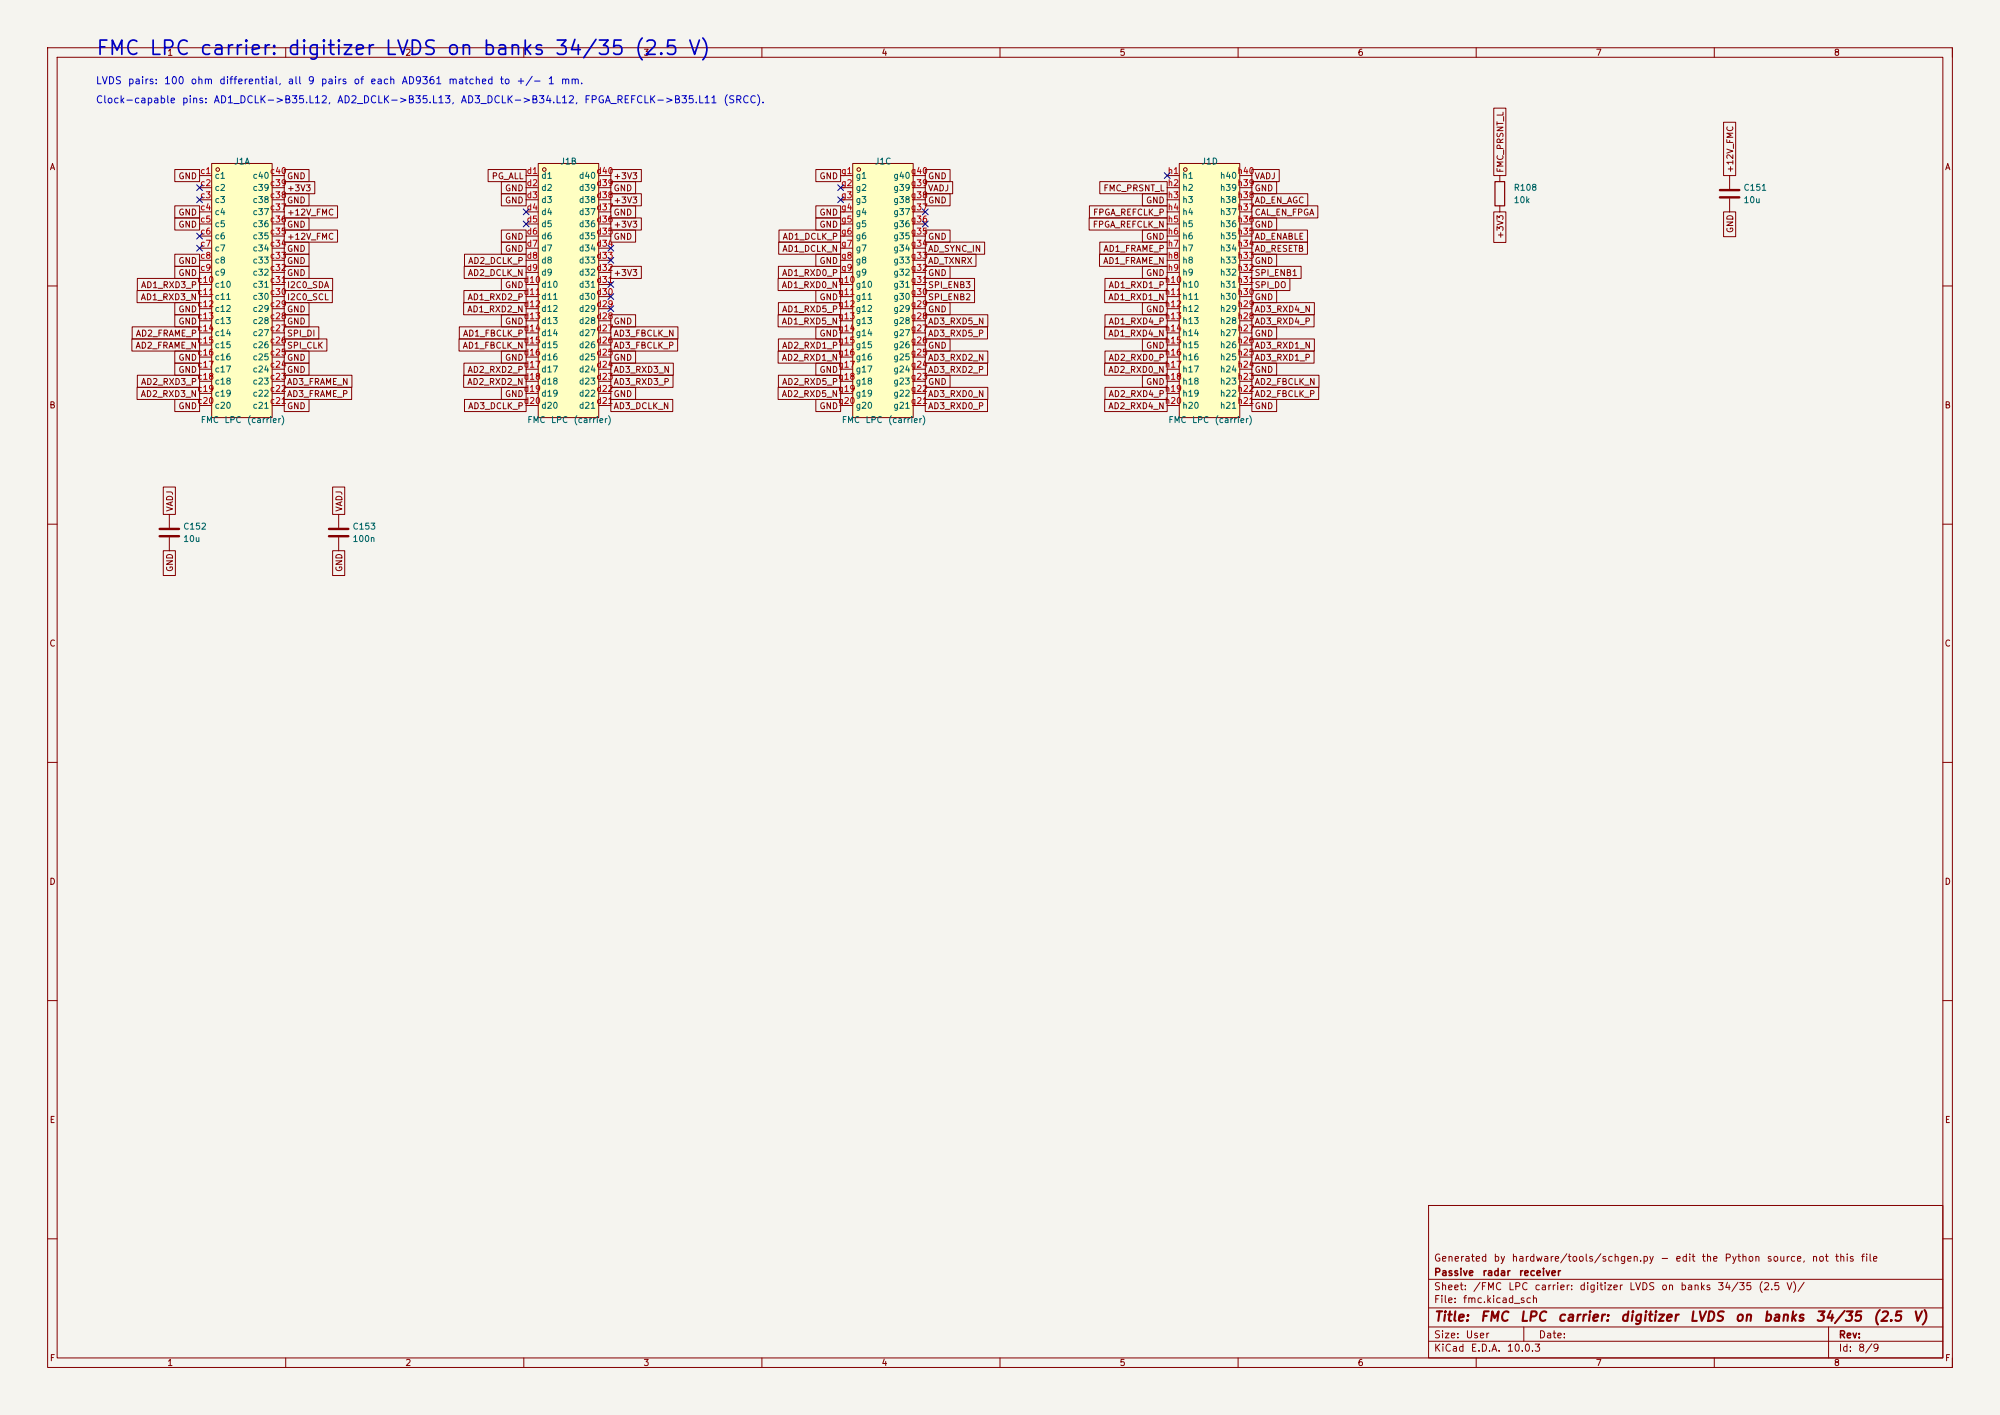
[picture p61: page 8]

LVDS pairs: 100 ohm differential, all 9 pairs of each AD9361 matched to +/- 1 mm. Clock-capable pins: AD1_DCLK->B35.L12, AD2_DCLK->B35.L13, AD3_DCLK->B34.L12, FPGA_REFCLK->B35.L11 (SRCC).

SPI_CLK
FMC LPC (carrier) GND

Generated by hardware/tools/schgen.py - edit the Python source, not this file
Passive radar receiver
Sheet: /FMC LPC carrier: digitizer LVDS on banks 34/35 (2.5 V)/
File: fmc.kicad_sch
Title: FMC LPC carrier: digitizer LVDS on banks 34/35 (2.5 V)

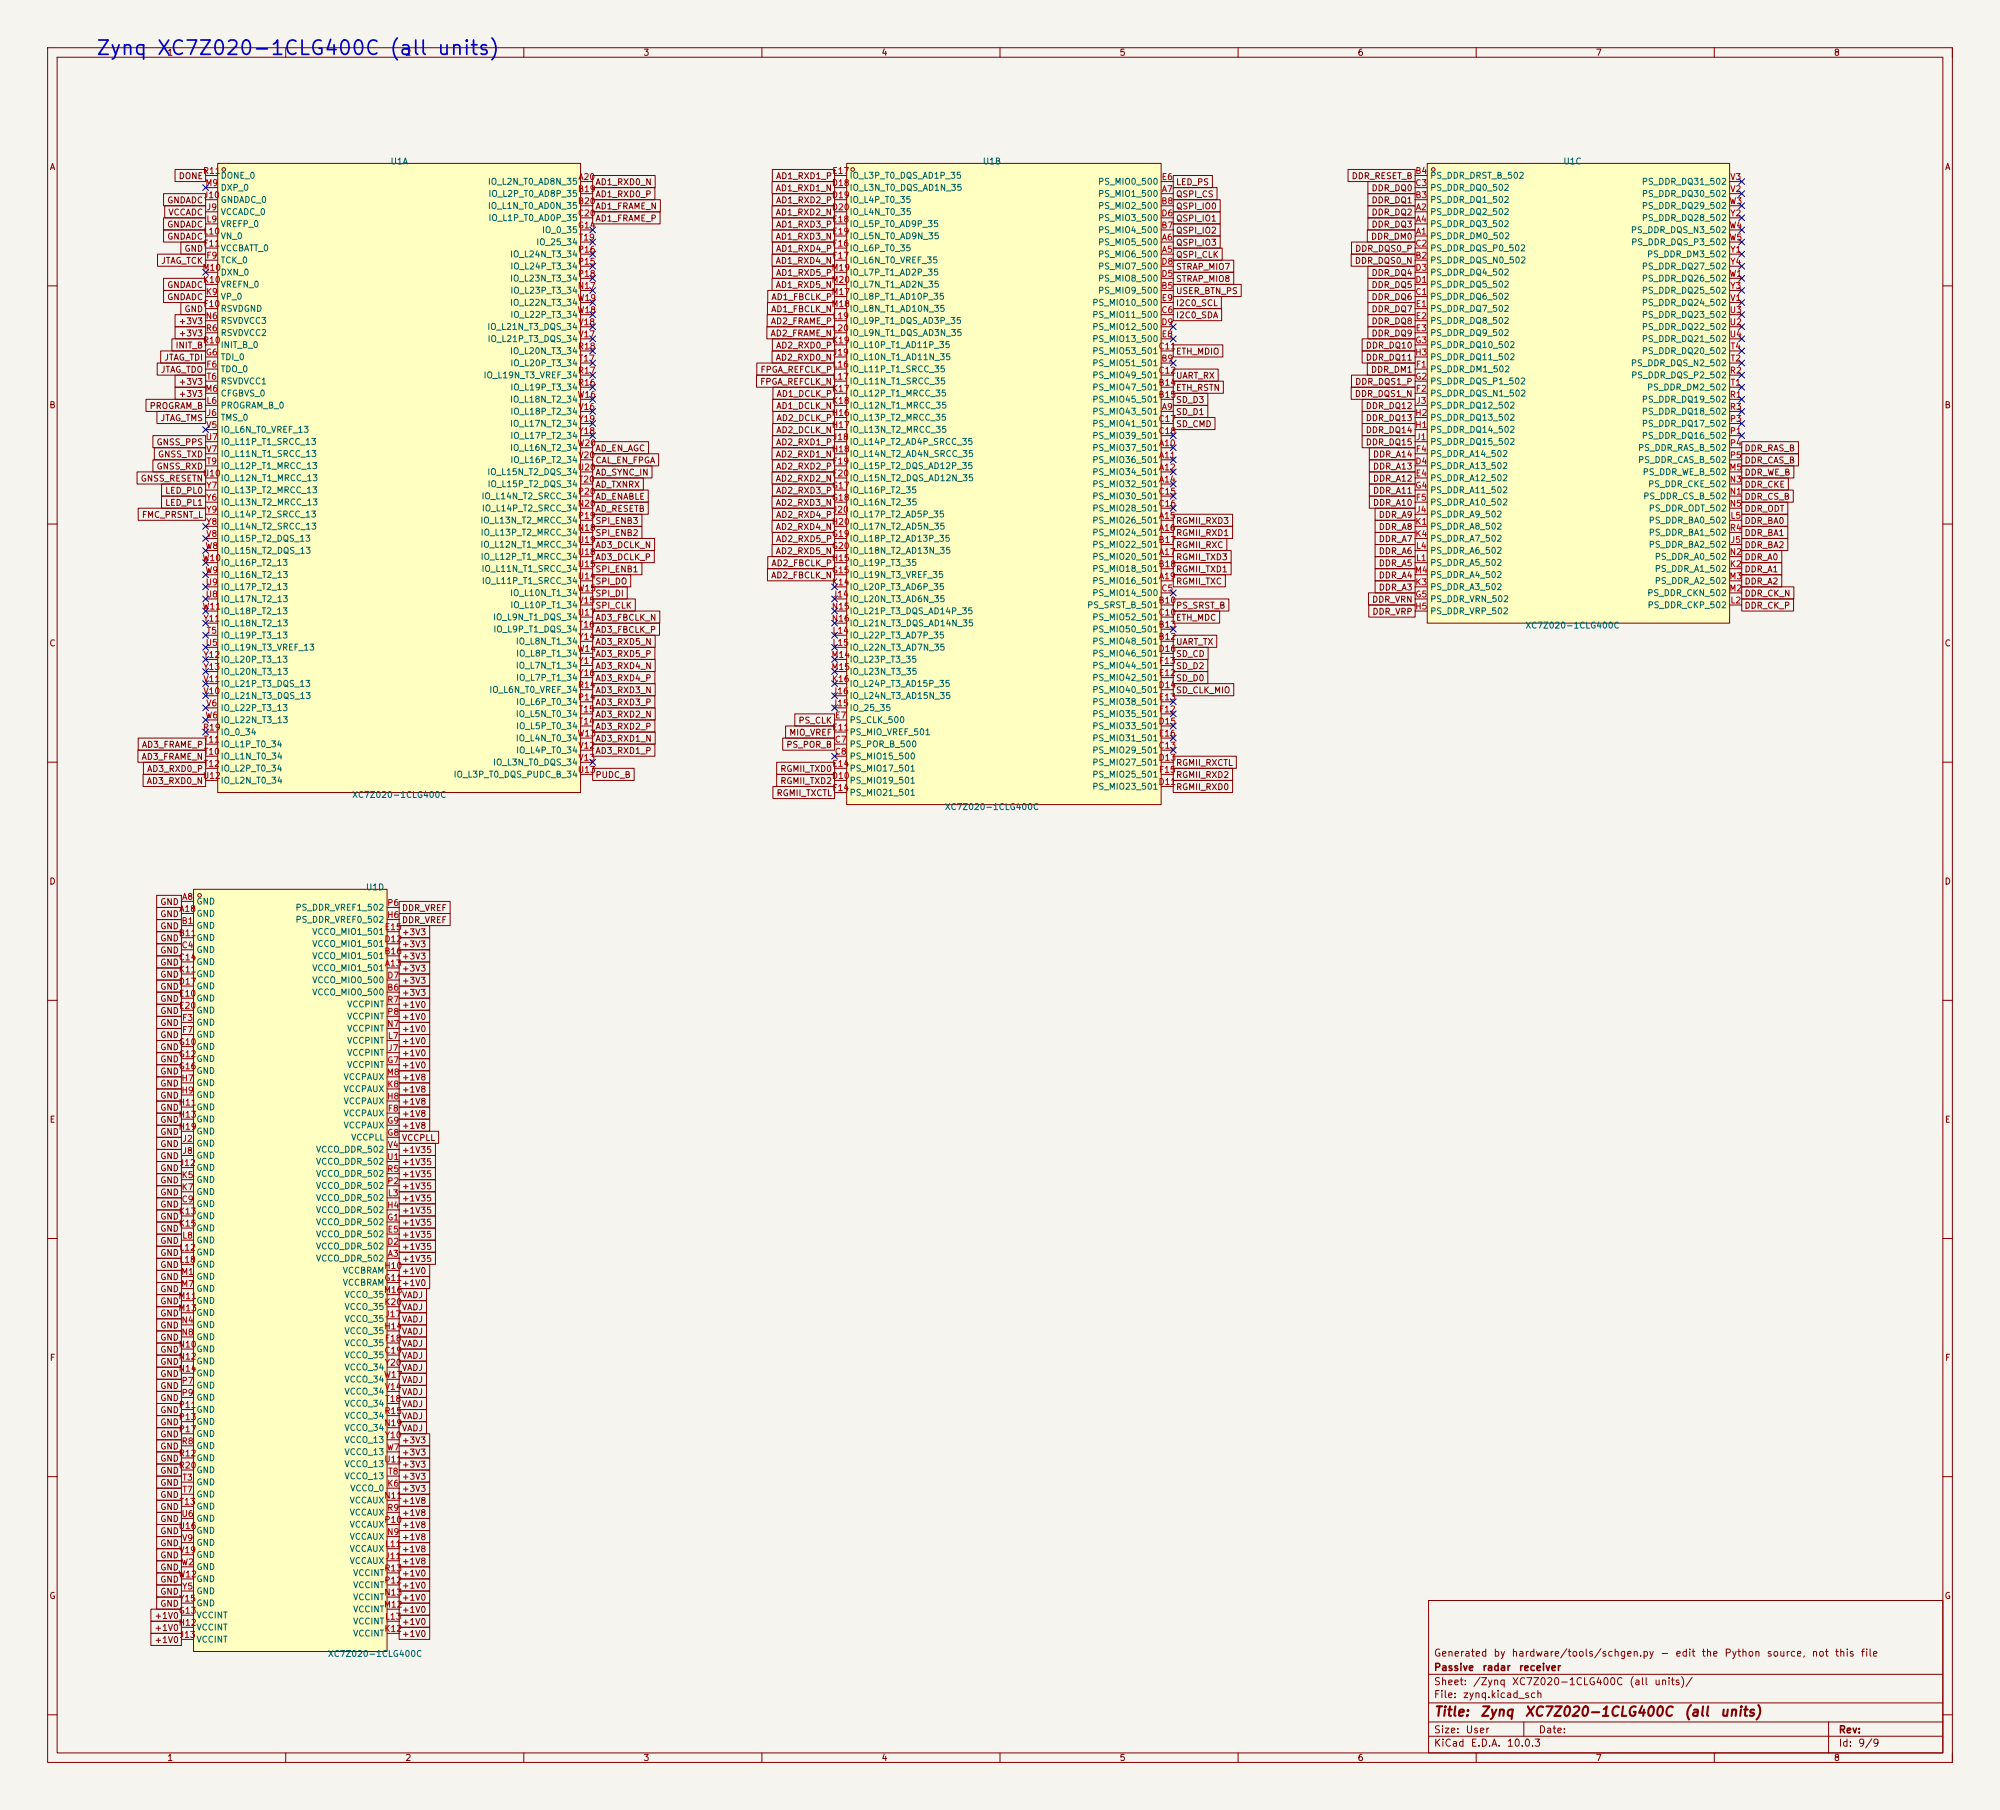
[picture p62: page 9]

VADJ VADJ VADJ VADJ VADJ VADJ VADJ VADJ VADJ VADJ +1V0

Generated by hardware/tools/schgen.py - edit the Python source, not this file
Passive radar receiver
Sheet: /Zynq XC7Z020-1CLG400C (all units)/
File: zynq.kicad_sch
Title: Zynq XC7Z020-1CLG400C (all units)
