ajisrawi/passive-radar-counter-drone/(list of files, drawings)

Other design files:
hardware/antenna/pcb/pcb_report.json
hardware/board_a/archive_100x112/board_a.dsn
hardware/board_a/drc_easyeda_routed.json
hardware/board_a/easyeda_export/board_a_easyeda_import/board_a/board_a.pcbdoc
hardware/board_a/easyeda_export/board_a_easyeda_import/board_a/board_a/board_a.schdoc
hardware/board_a/easyeda_export/board_a_easyeda_import/channels_0/channels_0.schdoc
hardware/board_a/easyeda_export/board_a_easyeda_import/channels_1/channels_1.schdoc
hardware/board_a/easyeda_export/board_a_easyeda_import/noise_source/noise_source.schdoc
hardware/board_a/easyeda_export/board_a_easyeda_import/power/power.schdoc
hardware/board_a/route/board_a.dsn
hardware/board_a/route/board_a_fix.dsn
hardware/board_a/route/board_a_pass2.dsn
hardware/board_b/route/board_b.dsn
hardware/board_b/route/board_b_clean.dsn
hardware/board_b/route/board_b_prev_1022_1729.dsn
hardware/board_b/route/board_b_redesign.dsn
hardware/board_c/archive_145x125/board_c.dsn
hardware/board_c/route/board_c.dsn
hardware/board_c/route/board_c_from_openboard.dsn
hardware/board_c/route/board_c_lowdensity_microvia.dsn
hardware/board_c/route/board_c_lowdensity_microvia_v2_check.dsn
hardware/board_c/route/board_c_v3fix_clean.dsn
hardware/board_c/route/board_c_v4.dsn
