ajisrawi/passive-radar-counter-drone/hardware/board_b/board_b.kicad_pcb

## KiCad design hardware/board_b/board_b.kicad_pcb (2026-10-28)

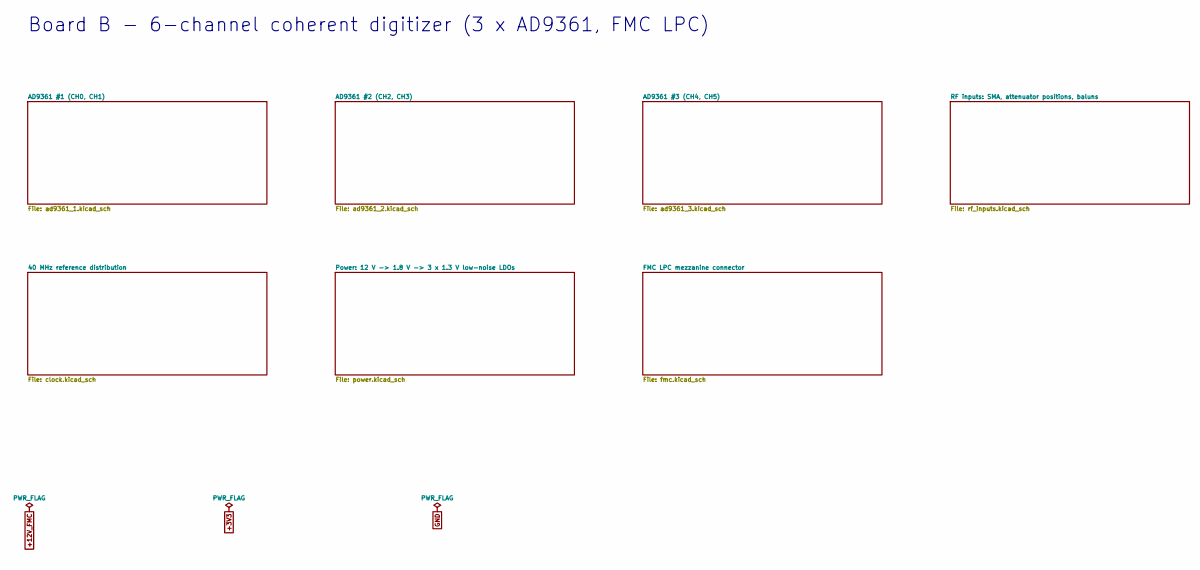
[picture p63: schematic board_b.kicad_sch, Board B - 6-channel coherent digitizer (3 x AD9361, FMC LPC)]

Notes on the sheet:
Board B - 6-channel coherent digitizer (3 x AD9361, FMC LPC)

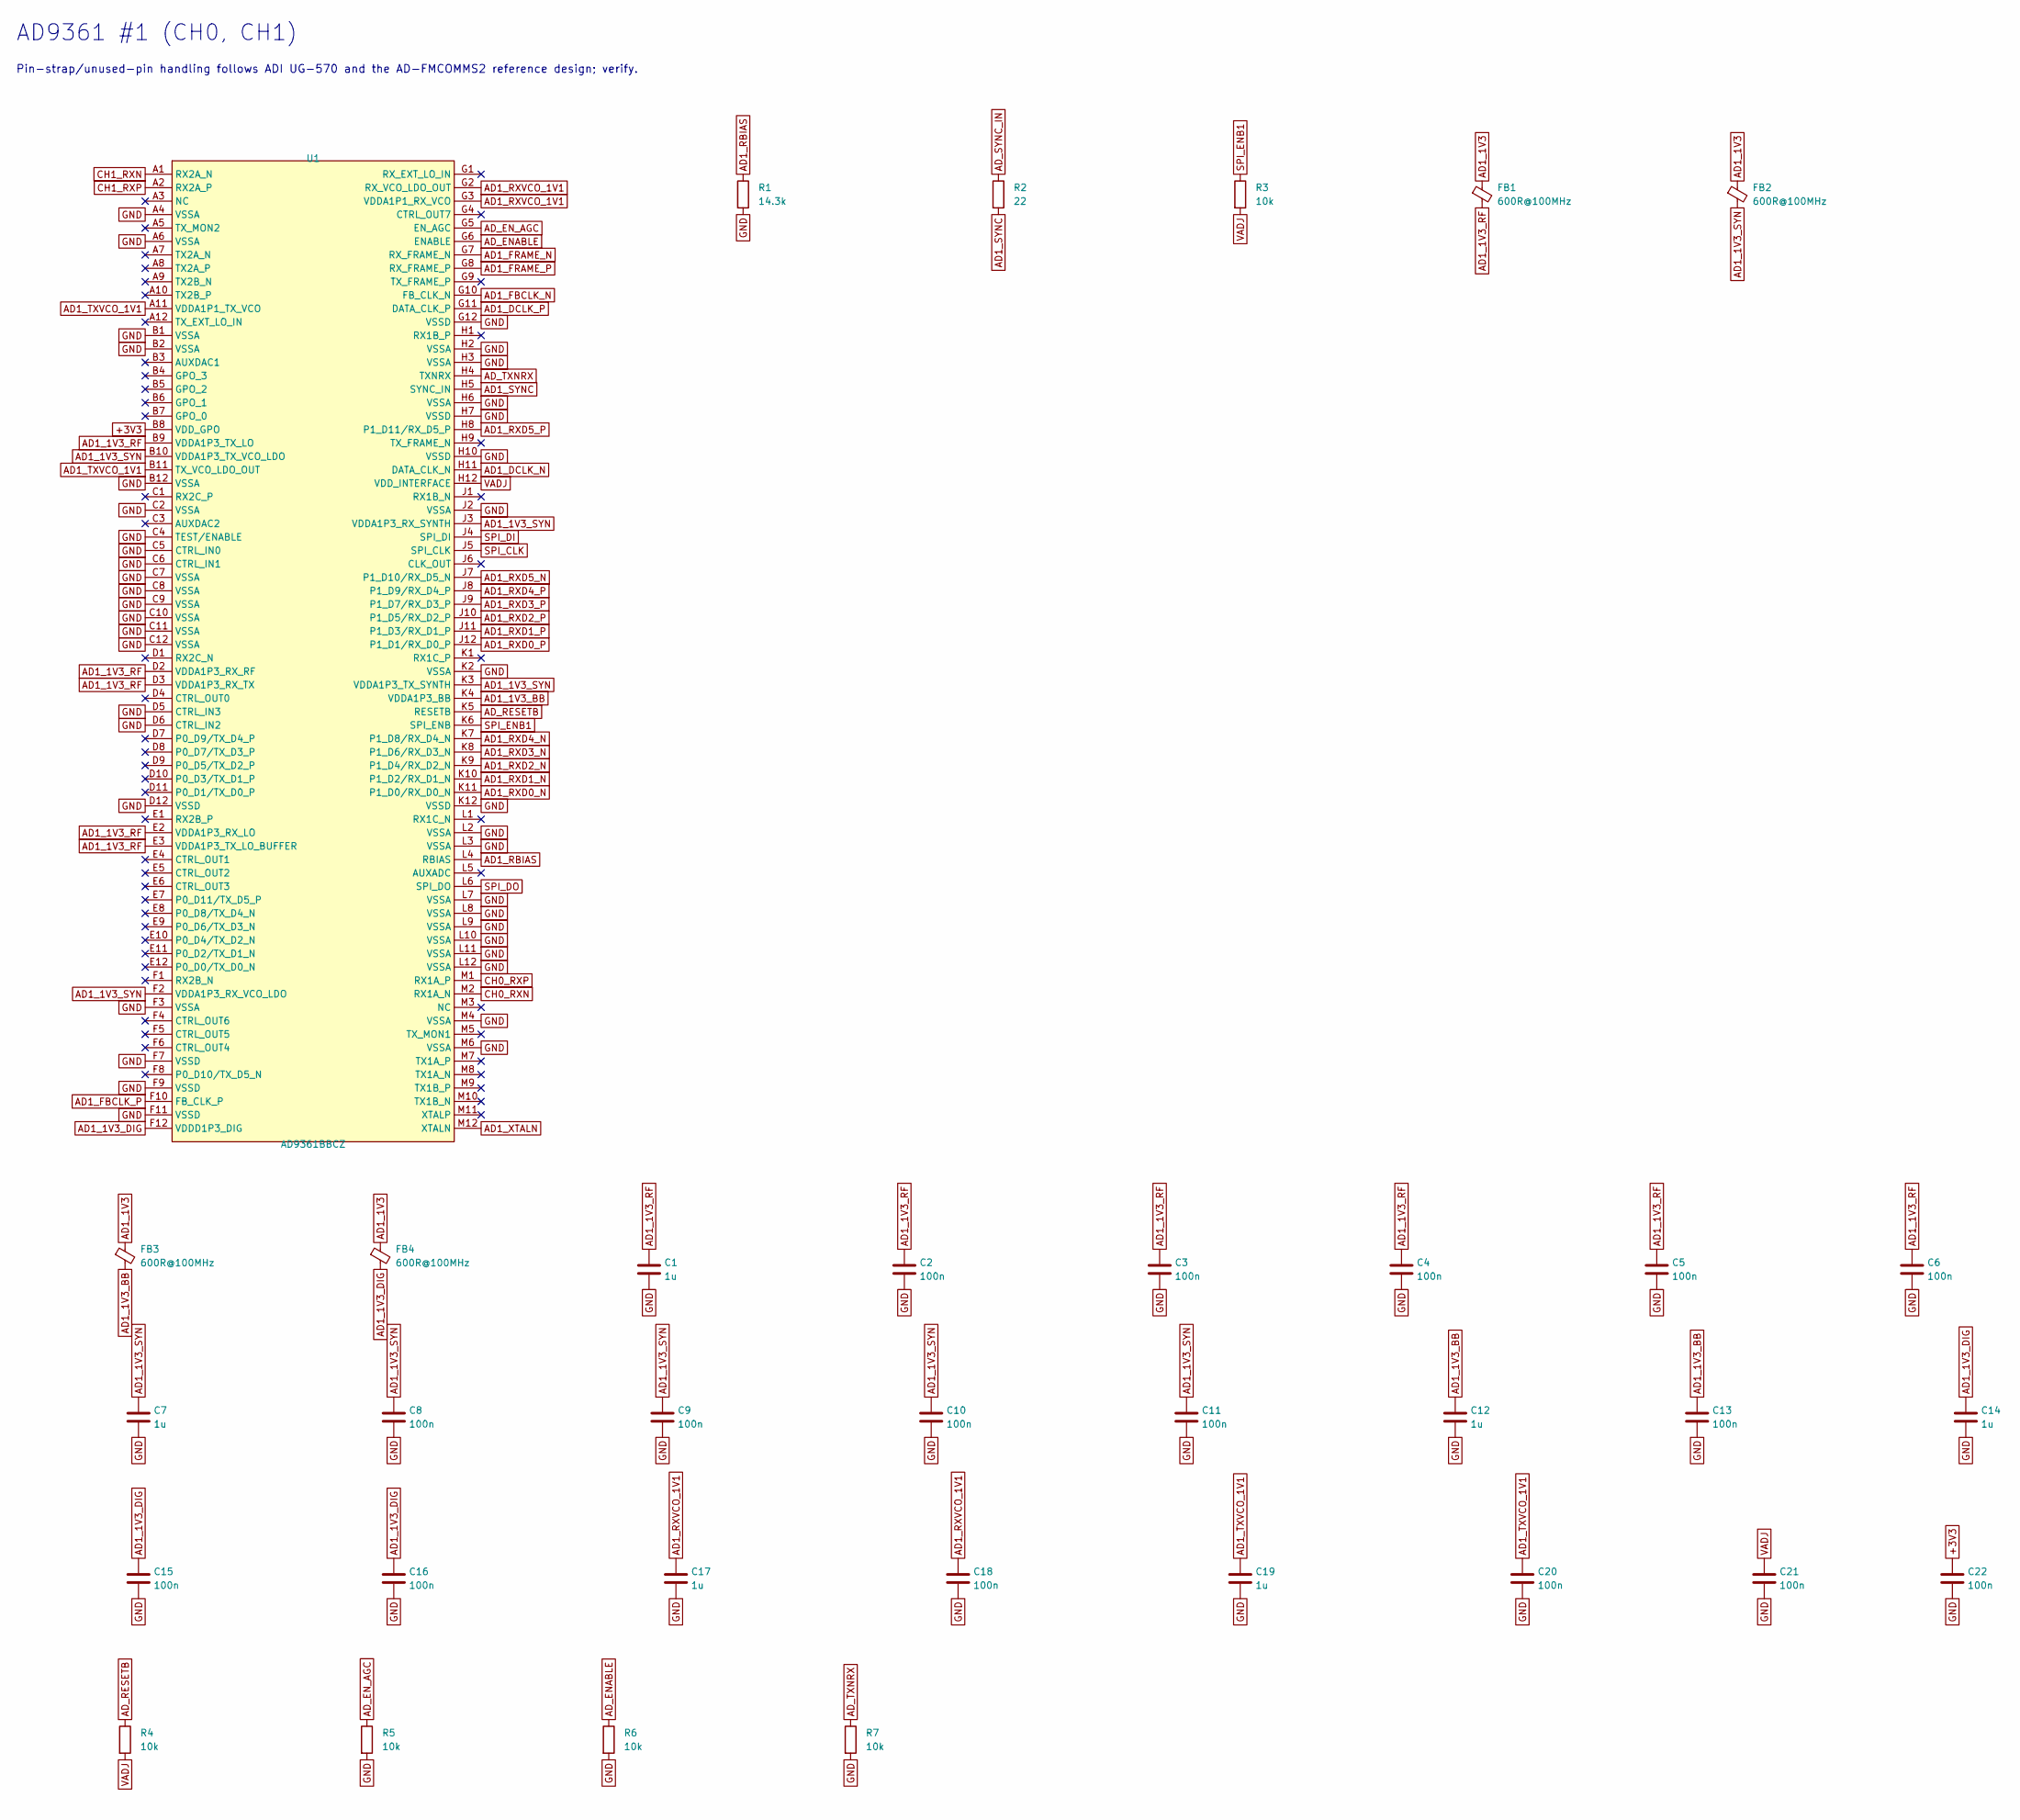
[picture p64: schematic ad9361_1.kicad_sch, AD9361 #1 (CH0, CH1)]

Parts:
C1, C7, C12, C14, C17, C19: 1u; C_0402_1005Metric; LCSC C52923
C2, C3, C4, C5, C6, C8, C9, C10, C11, C13, C15, C16, C18, C20, C21, C22: 100n; C_0402_1005Metric; LCSC C1525
FB1, FB2, FB3, FB4: 600R@100MHz; L_0603_1608Metric
R1: 14.3k; R_0402_1005Metric; Tolerance 1%
R2: 22; R_0402_1005Metric
R3, R4, R5, R6, R7: 10k; R_0402_1005Metric; LCSC C25744
U1: AD9361BBCZ; CSPBGA-144_L10.0-W10.0-R12-C12-P0.80-BL; MPN AD9361BBCZ; LCSC C515884

Connections:
+3V3: C22.1, U1.B8 (VDD_GPO); also elsewhere on the board
AD1_1V3: FB1.1, FB2.1, FB3.1, FB4.1; also elsewhere on the board
AD1_1V3_BB: C12.1, C13.1, FB3.2, U1.K4 (VDDA1P3_BB)
AD1_1V3_DIG: C14.1, C15.1, C16.1, FB4.2, U1.F12 (VDDD1P3_DIG)
AD1_1V3_RF: C1.1, C2.1, C3.1, C4.1, C5.1, C6.1, FB1.2, U1.B9 (VDDA1P3_TX_LO), U1.D2 (VDDA1P3_RX_RF), U1.D3 (VDDA1P3_RX_TX), U1.E2 (VDDA1P3_RX_LO), U1.E3 (VDDA1P3_TX_LO_BUFFER)
AD1_1V3_SYN: C7.1, C8.1, C9.1, C10.1, C11.1, FB2.2, U1.B10 (VDDA1P3_TX_VCO_LDO), U1.F2 (VDDA1P3_RX_VCO_LDO), U1.J3 (VDDA1P3_RX_SYNTH), U1.K3 (VDDA1P3_TX_SYNTH)
AD1_DCLK_N: U1.H11 (DATA_CLK_N); also elsewhere on the board
AD1_DCLK_P: U1.G11 (DATA_CLK_P); also elsewhere on the board
AD1_FBCLK_N: U1.G10 (FB_CLK_N); also elsewhere on the board
AD1_FBCLK_P: U1.F10 (FB_CLK_P); also elsewhere on the board
AD1_FRAME_N: U1.G7 (RX_FRAME_N); also elsewhere on the board
AD1_FRAME_P: U1.G8 (RX_FRAME_P); also elsewhere on the board
AD1_RBIAS: R1.1, U1.L4 (RBIAS)
AD1_RXD0_N: U1.K11 (P1_D0/RX_D0_N); also elsewhere on the board
AD1_RXD0_P: U1.J12 (P1_D1/RX_D0_P); also elsewhere on the board
AD1_RXD1_N: U1.K10 (P1_D2/RX_D1_N); also elsewhere on the board
AD1_RXD1_P: U1.J11 (P1_D3/RX_D1_P); also elsewhere on the board
AD1_RXD2_N: U1.K9 (P1_D4/RX_D2_N); also elsewhere on the board
AD1_RXD2_P: U1.J10 (P1_D5/RX_D2_P); also elsewhere on the board
AD1_RXD3_N: U1.K8 (P1_D6/RX_D3_N); also elsewhere on the board
AD1_RXD3_P: U1.J9 (P1_D7/RX_D3_P); also elsewhere on the board
AD1_RXD4_N: U1.K7 (P1_D8/RX_D4_N); also elsewhere on the board
AD1_RXD4_P: U1.J8 (P1_D9/RX_D4_P); also elsewhere on the board
AD1_RXD5_N: U1.J7 (P1_D10/RX_D5_N); also elsewhere on the board
AD1_RXD5_P: U1.H8 (P1_D11/RX_D5_P); also elsewhere on the board
AD1_RXVCO_1V1: C17.1, C18.1, U1.G2 (RX_VCO_LDO_OUT), U1.G3 (VDDA1P1_RX_VCO)
AD1_SYNC: R2.2, U1.H5 (SYNC_IN)
AD1_TXVCO_1V1: C19.1, C20.1, U1.A11 (VDDA1P1_TX_VCO), U1.B11 (TX_VCO_LDO_OUT)
AD1_XTALN: U1.M12 (XTALN); also elsewhere on the board
AD_ENABLE: R6.1, U1.G6 (ENABLE); also elsewhere on the board
AD_EN_AGC: R5.1, U1.G5 (EN_AGC); also elsewhere on the board
AD_RESETB: R4.1, U1.K5 (RESETB); also elsewhere on the board
AD_SYNC_IN: R2.1; also elsewhere on the board
AD_TXNRX: R7.1, U1.H4 (TXNRX); also elsewhere on the board
CH0_RXN: U1.M2 (RX1A_N); also elsewhere on the board
CH0_RXP: U1.M1 (RX1A_P); also elsewhere on the board
CH1_RXN: U1.A1 (RX2A_N); also elsewhere on the board
CH1_RXP: U1.A2 (RX2A_P); also elsewhere on the board
GND: C1.2, C2.2, C3.2, C4.2, C5.2, C6.2, C7.2, C8.2, C9.2, C10.2, C11.2, C12.2, C13.2, C14.2, C15.2, C16.2, C17.2, C18.2, C19.2, C20.2, C21.2, C22.2, R1.2, R5.2, R6.2, R7.2, U1.A4 (VSSA), U1.A6 (VSSA), U1.B1 (VSSA), U1.B2 (VSSA), U1.B12 (VSSA), U1.C2 (VSSA), U1.C4 (TEST/ENABLE), U1.C5 (CTRL_IN0), U1.C6 (CTRL_IN1), U1.C7 (VSSA), U1.C8 (VSSA), U1.C9 (VSSA), U1.C10 (VSSA), U1.C11 (VSSA), U1.C12 (VSSA), U1.D5 (CTRL_IN3), U1.D6 (CTRL_IN2), U1.D12 (VSSD), U1.F3 (VSSA), U1.F7 (VSSD), U1.F9 (VSSD), U1.F11 (VSSD), U1.G12 (VSSD), U1.H2 (VSSA), U1.H3 (VSSA), U1.H6 (VSSA), U1.H7 (VSSD), U1.H10 (VSSD), U1.J2 (VSSA), U1.K2 (VSSA), U1.K12 (VSSD), U1.L2 (VSSA), U1.L3 (VSSA), U1.L7 (VSSA), U1.L8 (VSSA), U1.L9 (VSSA), U1.L10 (VSSA), U1.L11 (VSSA), U1.L12 (VSSA), U1.M4 (VSSA), U1.M6 (VSSA); also elsewhere on the board
SPI_CLK: U1.J5 (SPI_CLK); also elsewhere on the board
SPI_DI: U1.J4 (SPI_DI); also elsewhere on the board
SPI_DO: U1.L6 (SPI_DO); also elsewhere on the board
SPI_ENB1: R3.1, U1.K6 (SPI_ENB); also elsewhere on the board
VADJ: C21.1, R3.2, R4.2, U1.H12 (VDD_INTERFACE); also elsewhere on the board

Notes on the sheet:
AD9361 #1 (CH0, CH1)
Pin-strap/unused-pin handling follows ADI UG-570 and the AD-FMCOMMS2 reference design; verify.

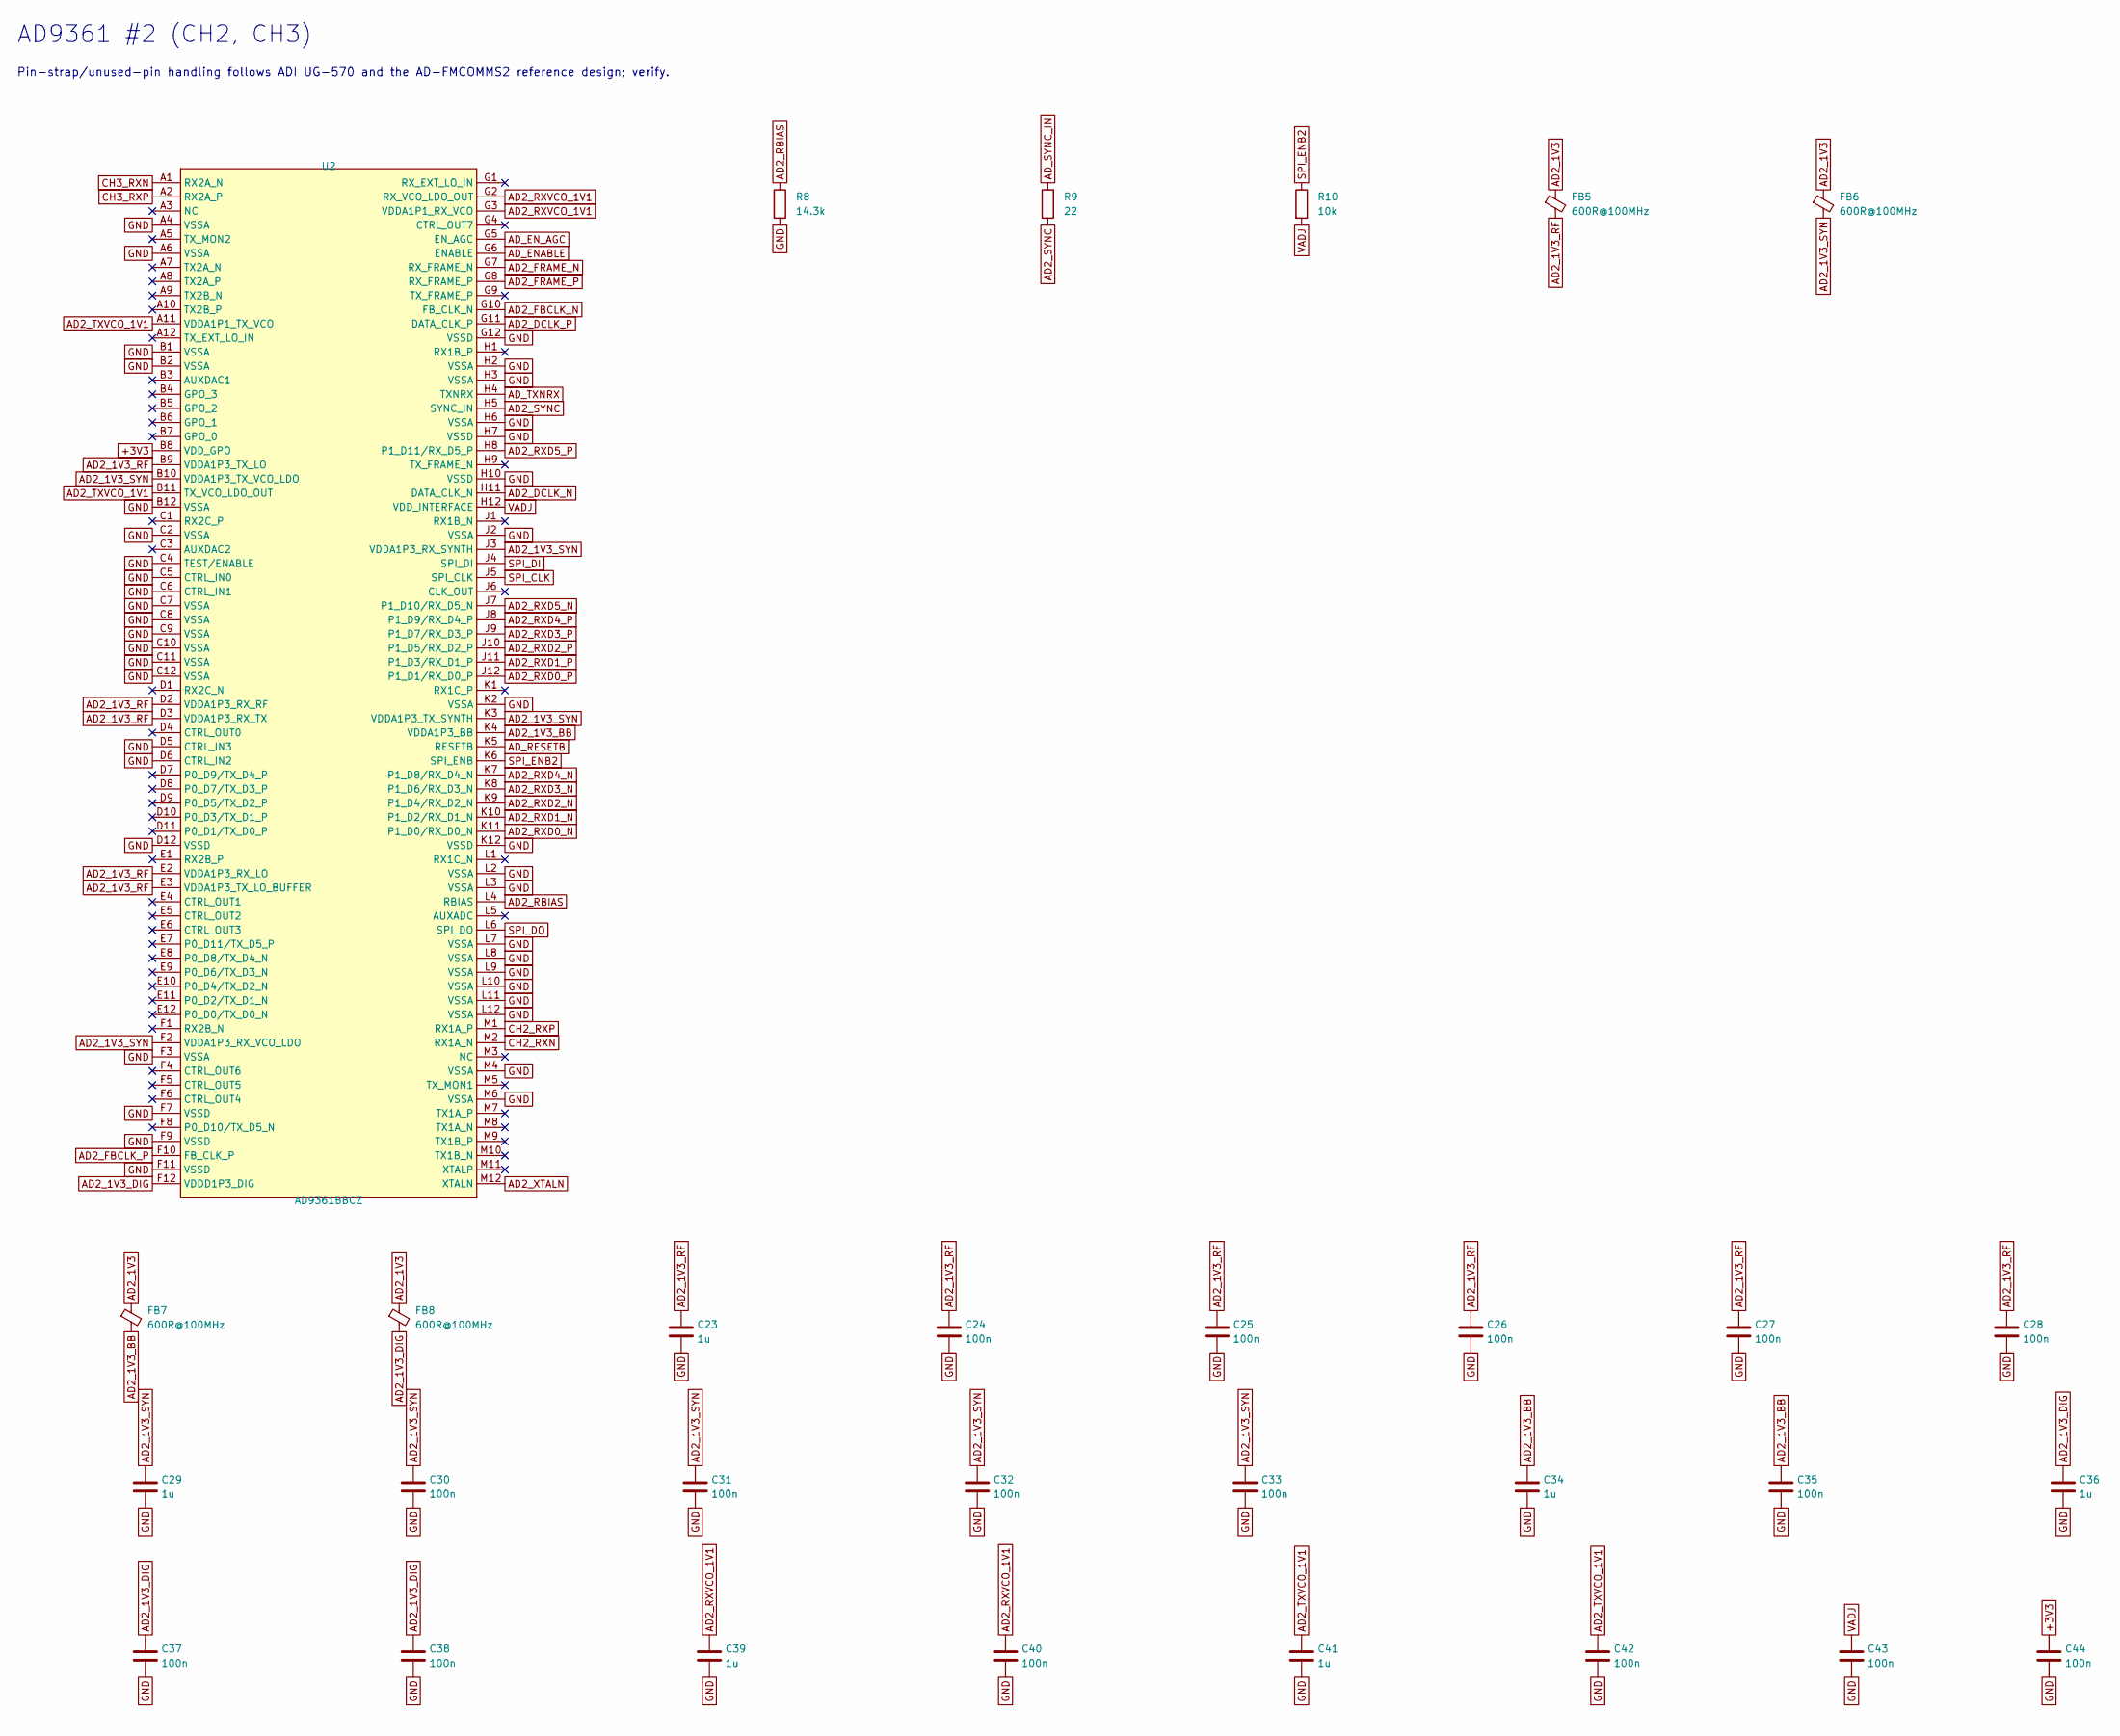
[picture p65: schematic ad9361_2.kicad_sch, AD9361 #2 (CH2, CH3)]

Parts:
C23, C29, C34, C36, C39, C41: 1u; C_0402_1005Metric; LCSC C52923
C24, C25, C26, C27, C28, C30, C31, C32, C33, C35, C37, C38, C40, C42, C43, C44: 100n; C_0402_1005Metric; LCSC C1525
FB5, FB6, FB7, FB8: 600R@100MHz; L_0603_1608Metric
R8: 14.3k; R_0402_1005Metric; Tolerance 1%
R9: 22; R_0402_1005Metric
R10: 10k; R_0402_1005Metric; LCSC C25744
U2: AD9361BBCZ; CSPBGA-144_L10.0-W10.0-R12-C12-P0.80-BL; MPN AD9361BBCZ; LCSC C515884

Connections:
+3V3: C44.1, U2.B8 (VDD_GPO); also elsewhere on the board
AD2_1V3: FB5.1, FB6.1, FB7.1, FB8.1; also elsewhere on the board
AD2_1V3_BB: C34.1, C35.1, FB7.2, U2.K4 (VDDA1P3_BB)
AD2_1V3_DIG: C36.1, C37.1, C38.1, FB8.2, U2.F12 (VDDD1P3_DIG)
AD2_1V3_RF: C23.1, C24.1, C25.1, C26.1, C27.1, C28.1, FB5.2, U2.B9 (VDDA1P3_TX_LO), U2.D2 (VDDA1P3_RX_RF), U2.D3 (VDDA1P3_RX_TX), U2.E2 (VDDA1P3_RX_LO), U2.E3 (VDDA1P3_TX_LO_BUFFER)
AD2_1V3_SYN: C29.1, C30.1, C31.1, C32.1, C33.1, FB6.2, U2.B10 (VDDA1P3_TX_VCO_LDO), U2.F2 (VDDA1P3_RX_VCO_LDO), U2.J3 (VDDA1P3_RX_SYNTH), U2.K3 (VDDA1P3_TX_SYNTH)
AD2_DCLK_N: U2.H11 (DATA_CLK_N); also elsewhere on the board
AD2_DCLK_P: U2.G11 (DATA_CLK_P); also elsewhere on the board
AD2_FBCLK_N: U2.G10 (FB_CLK_N); also elsewhere on the board
AD2_FBCLK_P: U2.F10 (FB_CLK_P); also elsewhere on the board
AD2_FRAME_N: U2.G7 (RX_FRAME_N); also elsewhere on the board
AD2_FRAME_P: U2.G8 (RX_FRAME_P); also elsewhere on the board
AD2_RBIAS: R8.1, U2.L4 (RBIAS)
AD2_RXD0_N: U2.K11 (P1_D0/RX_D0_N); also elsewhere on the board
AD2_RXD0_P: U2.J12 (P1_D1/RX_D0_P); also elsewhere on the board
AD2_RXD1_N: U2.K10 (P1_D2/RX_D1_N); also elsewhere on the board
AD2_RXD1_P: U2.J11 (P1_D3/RX_D1_P); also elsewhere on the board
AD2_RXD2_N: U2.K9 (P1_D4/RX_D2_N); also elsewhere on the board
AD2_RXD2_P: U2.J10 (P1_D5/RX_D2_P); also elsewhere on the board
AD2_RXD3_N: U2.K8 (P1_D6/RX_D3_N); also elsewhere on the board
AD2_RXD3_P: U2.J9 (P1_D7/RX_D3_P); also elsewhere on the board
AD2_RXD4_N: U2.K7 (P1_D8/RX_D4_N); also elsewhere on the board
AD2_RXD4_P: U2.J8 (P1_D9/RX_D4_P); also elsewhere on the board
AD2_RXD5_N: U2.J7 (P1_D10/RX_D5_N); also elsewhere on the board
AD2_RXD5_P: U2.H8 (P1_D11/RX_D5_P); also elsewhere on the board
AD2_RXVCO_1V1: C39.1, C40.1, U2.G2 (RX_VCO_LDO_OUT), U2.G3 (VDDA1P1_RX_VCO)
AD2_SYNC: R9.2, U2.H5 (SYNC_IN)
AD2_TXVCO_1V1: C41.1, C42.1, U2.A11 (VDDA1P1_TX_VCO), U2.B11 (TX_VCO_LDO_OUT)
AD2_XTALN: U2.M12 (XTALN); also elsewhere on the board
AD_ENABLE: U2.G6 (ENABLE); also elsewhere on the board
AD_EN_AGC: U2.G5 (EN_AGC); also elsewhere on the board
AD_RESETB: U2.K5 (RESETB); also elsewhere on the board
AD_SYNC_IN: R9.1; also elsewhere on the board
AD_TXNRX: U2.H4 (TXNRX); also elsewhere on the board
CH2_RXN: U2.M2 (RX1A_N); also elsewhere on the board
CH2_RXP: U2.M1 (RX1A_P); also elsewhere on the board
CH3_RXN: U2.A1 (RX2A_N); also elsewhere on the board
CH3_RXP: U2.A2 (RX2A_P); also elsewhere on the board
GND: C23.2, C24.2, C25.2, C26.2, C27.2, C28.2, C29.2, C30.2, C31.2, C32.2, C33.2, C34.2, C35.2, C36.2, C37.2, C38.2, C39.2, C40.2, C41.2, C42.2, C43.2, C44.2, R8.2, U2.A4 (VSSA), U2.A6 (VSSA), U2.B1 (VSSA), U2.B2 (VSSA), U2.B12 (VSSA), U2.C2 (VSSA), U2.C4 (TEST/ENABLE), U2.C5 (CTRL_IN0), U2.C6 (CTRL_IN1), U2.C7 (VSSA), U2.C8 (VSSA), U2.C9 (VSSA), U2.C10 (VSSA), U2.C11 (VSSA), U2.C12 (VSSA), U2.D5 (CTRL_IN3), U2.D6 (CTRL_IN2), U2.D12 (VSSD), U2.F3 (VSSA), U2.F7 (VSSD), U2.F9 (VSSD), U2.F11 (VSSD), U2.G12 (VSSD), U2.H2 (VSSA), U2.H3 (VSSA), U2.H6 (VSSA), U2.H7 (VSSD), U2.H10 (VSSD), U2.J2 (VSSA), U2.K2 (VSSA), U2.K12 (VSSD), U2.L2 (VSSA), U2.L3 (VSSA), U2.L7 (VSSA), U2.L8 (VSSA), U2.L9 (VSSA), U2.L10 (VSSA), U2.L11 (VSSA), U2.L12 (VSSA), U2.M4 (VSSA), U2.M6 (VSSA); also elsewhere on the board
SPI_CLK: U2.J5 (SPI_CLK); also elsewhere on the board
SPI_DI: U2.J4 (SPI_DI); also elsewhere on the board
SPI_DO: U2.L6 (SPI_DO); also elsewhere on the board
SPI_ENB2: R10.1, U2.K6 (SPI_ENB); also elsewhere on the board
VADJ: C43.1, R10.2, U2.H12 (VDD_INTERFACE); also elsewhere on the board

Notes on the sheet:
AD9361 #2 (CH2, CH3)
Pin-strap/unused-pin handling follows ADI UG-570 and the AD-FMCOMMS2 reference design; verify.

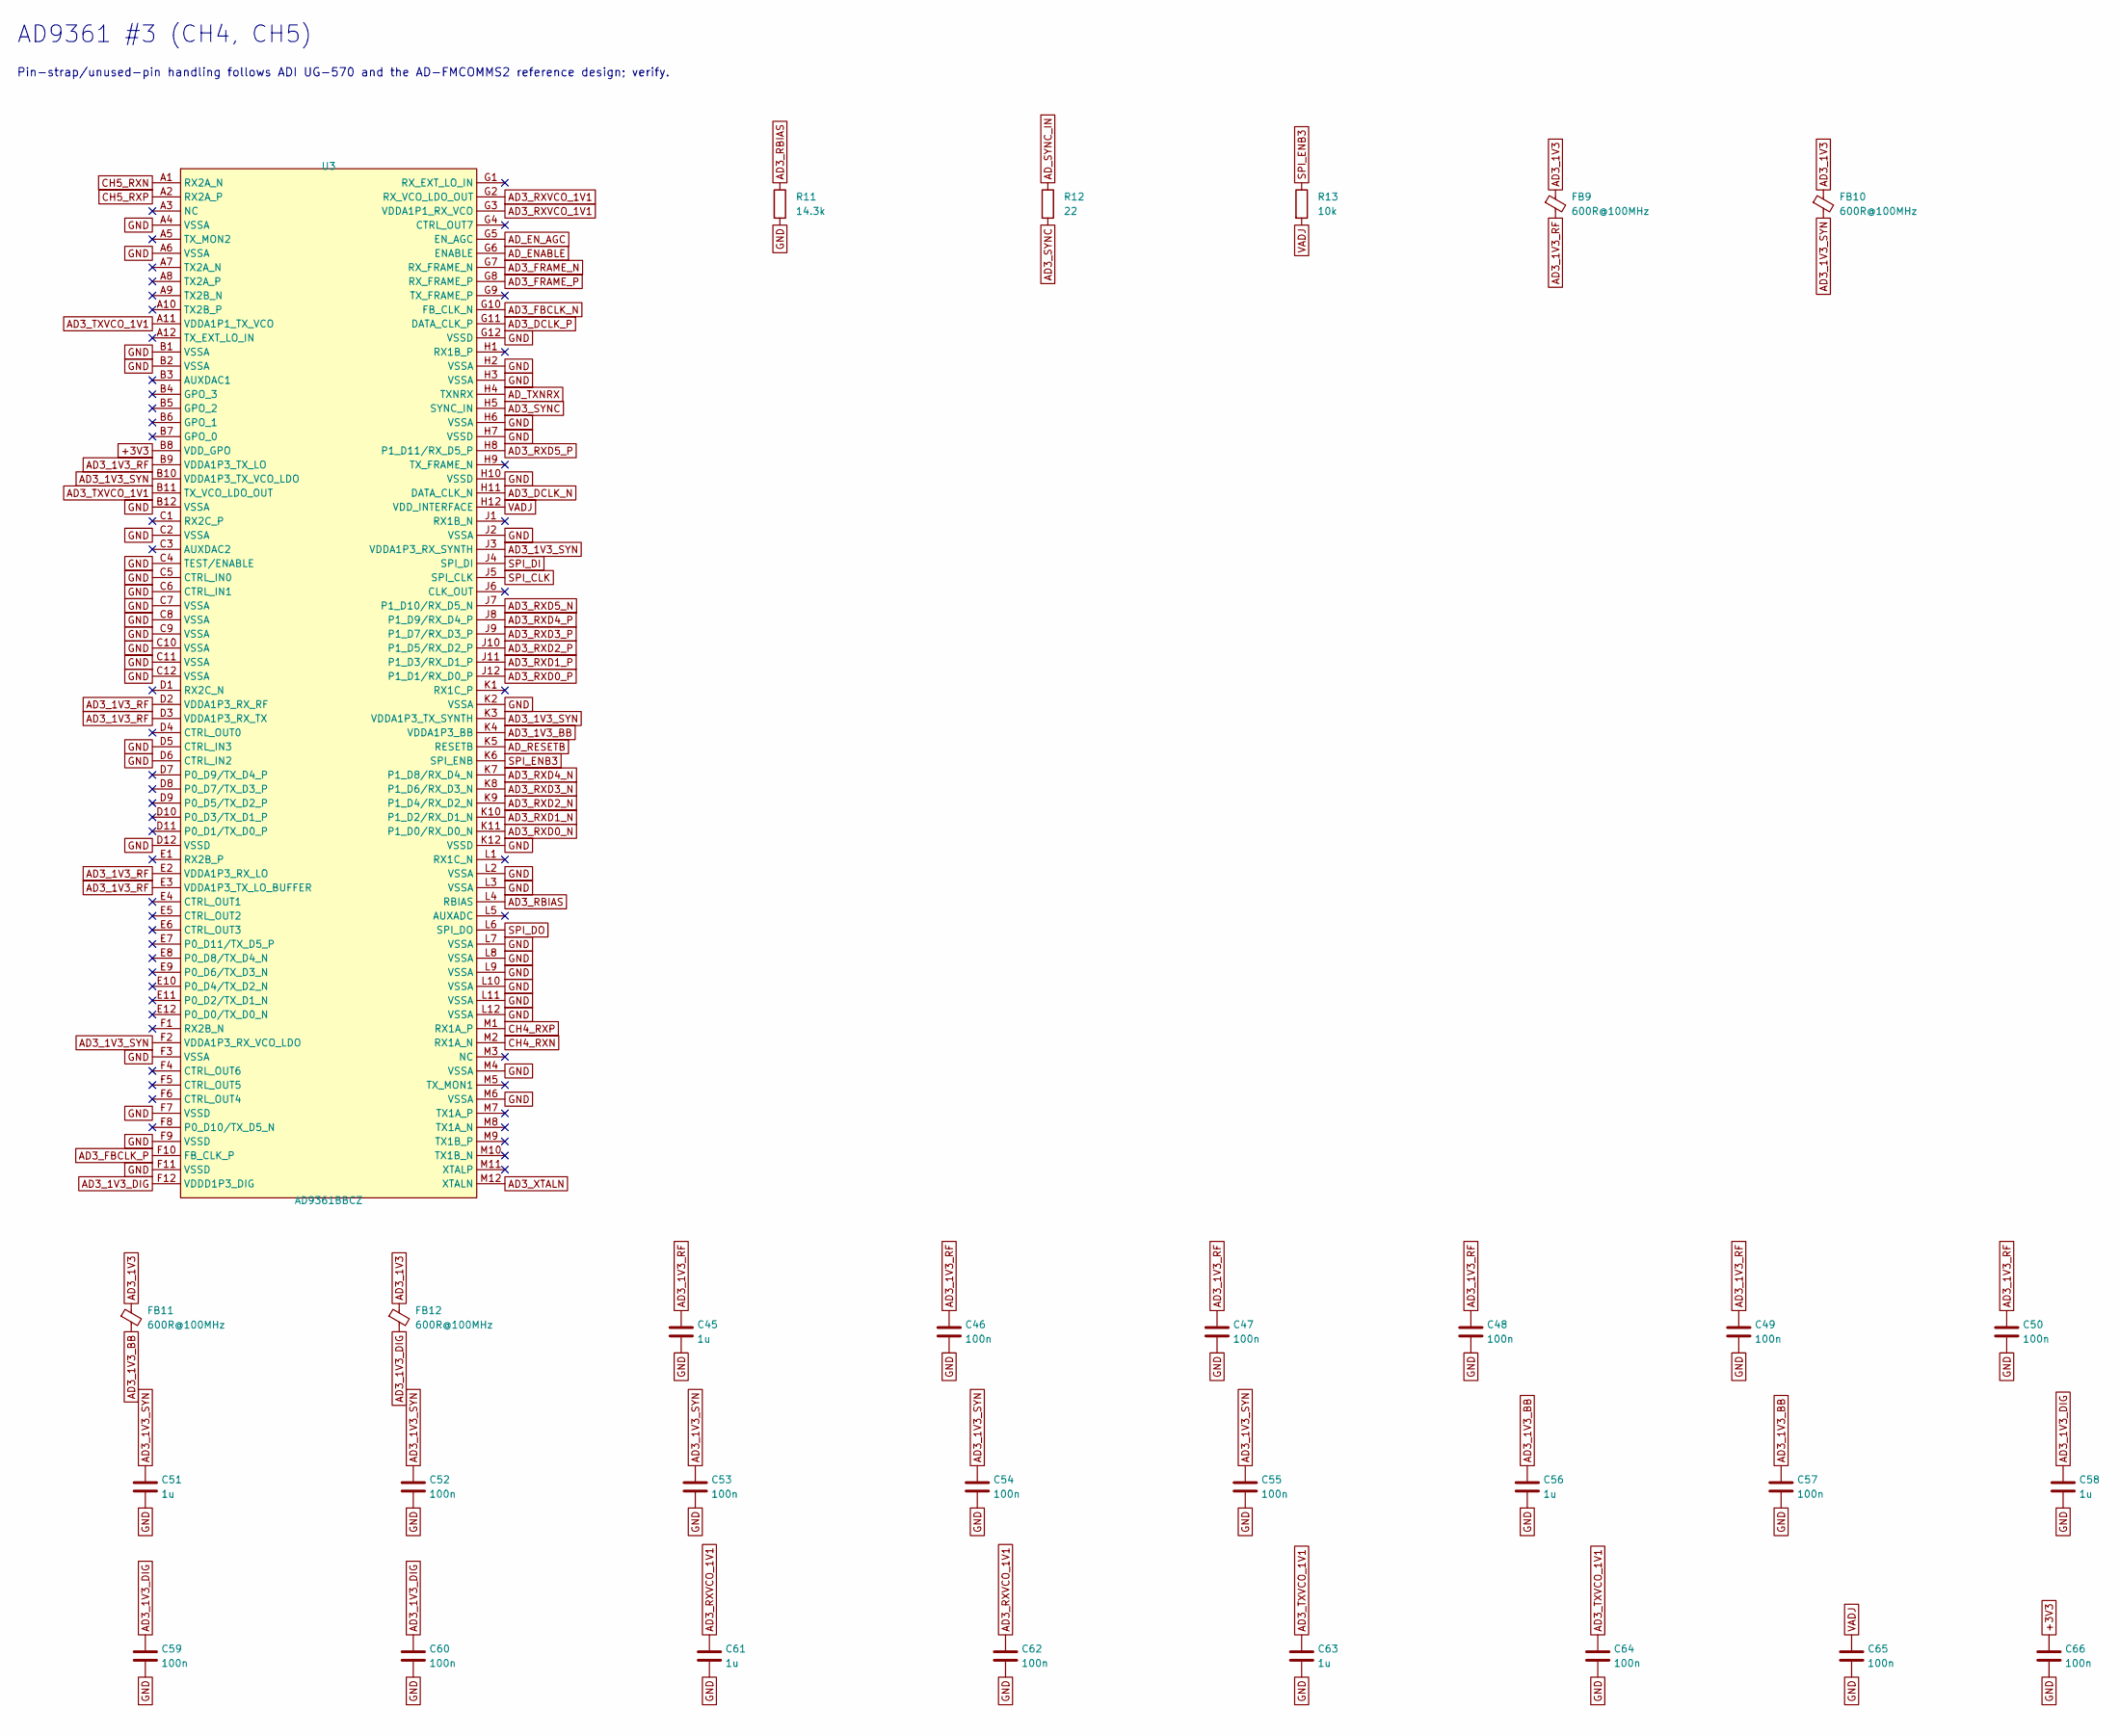
[picture p66: schematic ad9361_3.kicad_sch, AD9361 #3 (CH4, CH5)]

Parts:
C45, C51, C56, C58, C61, C63: 1u; C_0402_1005Metric; LCSC C52923
C46, C47, C48, C49, C50, C52, C53, C54, C55, C57, C59, C60, C62, C64, C65, C66: 100n; C_0402_1005Metric; LCSC C1525
FB9, FB10, FB11, FB12: 600R@100MHz; L_0603_1608Metric
R11: 14.3k; R_0402_1005Metric; Tolerance 1%
R12: 22; R_0402_1005Metric
R13: 10k; R_0402_1005Metric; LCSC C25744
U3: AD9361BBCZ; CSPBGA-144_L10.0-W10.0-R12-C12-P0.80-BL; MPN AD9361BBCZ; LCSC C515884

Connections:
+3V3: C66.1, U3.B8 (VDD_GPO); also elsewhere on the board
AD3_1V3: FB9.1, FB10.1, FB11.1, FB12.1; also elsewhere on the board
AD3_1V3_BB: C56.1, C57.1, FB11.2, U3.K4 (VDDA1P3_BB)
AD3_1V3_DIG: C58.1, C59.1, C60.1, FB12.2, U3.F12 (VDDD1P3_DIG)
AD3_1V3_RF: C45.1, C46.1, C47.1, C48.1, C49.1, C50.1, FB9.2, U3.B9 (VDDA1P3_TX_LO), U3.D2 (VDDA1P3_RX_RF), U3.D3 (VDDA1P3_RX_TX), U3.E2 (VDDA1P3_RX_LO), U3.E3 (VDDA1P3_TX_LO_BUFFER)
AD3_1V3_SYN: C51.1, C52.1, C53.1, C54.1, C55.1, FB10.2, U3.B10 (VDDA1P3_TX_VCO_LDO), U3.F2 (VDDA1P3_RX_VCO_LDO), U3.J3 (VDDA1P3_RX_SYNTH), U3.K3 (VDDA1P3_TX_SYNTH)
AD3_DCLK_N: U3.H11 (DATA_CLK_N); also elsewhere on the board
AD3_DCLK_P: U3.G11 (DATA_CLK_P); also elsewhere on the board
AD3_FBCLK_N: U3.G10 (FB_CLK_N); also elsewhere on the board
AD3_FBCLK_P: U3.F10 (FB_CLK_P); also elsewhere on the board
AD3_FRAME_N: U3.G7 (RX_FRAME_N); also elsewhere on the board
AD3_FRAME_P: U3.G8 (RX_FRAME_P); also elsewhere on the board
AD3_RBIAS: R11.1, U3.L4 (RBIAS)
AD3_RXD0_N: U3.K11 (P1_D0/RX_D0_N); also elsewhere on the board
AD3_RXD0_P: U3.J12 (P1_D1/RX_D0_P); also elsewhere on the board
AD3_RXD1_N: U3.K10 (P1_D2/RX_D1_N); also elsewhere on the board
AD3_RXD1_P: U3.J11 (P1_D3/RX_D1_P); also elsewhere on the board
AD3_RXD2_N: U3.K9 (P1_D4/RX_D2_N); also elsewhere on the board
AD3_RXD2_P: U3.J10 (P1_D5/RX_D2_P); also elsewhere on the board
AD3_RXD3_N: U3.K8 (P1_D6/RX_D3_N); also elsewhere on the board
AD3_RXD3_P: U3.J9 (P1_D7/RX_D3_P); also elsewhere on the board
AD3_RXD4_N: U3.K7 (P1_D8/RX_D4_N); also elsewhere on the board
AD3_RXD4_P: U3.J8 (P1_D9/RX_D4_P); also elsewhere on the board
AD3_RXD5_N: U3.J7 (P1_D10/RX_D5_N); also elsewhere on the board
AD3_RXD5_P: U3.H8 (P1_D11/RX_D5_P); also elsewhere on the board
AD3_RXVCO_1V1: C61.1, C62.1, U3.G2 (RX_VCO_LDO_OUT), U3.G3 (VDDA1P1_RX_VCO)
AD3_SYNC: R12.2, U3.H5 (SYNC_IN)
AD3_TXVCO_1V1: C63.1, C64.1, U3.A11 (VDDA1P1_TX_VCO), U3.B11 (TX_VCO_LDO_OUT)
AD3_XTALN: U3.M12 (XTALN); also elsewhere on the board
AD_ENABLE: U3.G6 (ENABLE); also elsewhere on the board
AD_EN_AGC: U3.G5 (EN_AGC); also elsewhere on the board
AD_RESETB: U3.K5 (RESETB); also elsewhere on the board
AD_SYNC_IN: R12.1; also elsewhere on the board
AD_TXNRX: U3.H4 (TXNRX); also elsewhere on the board
CH4_RXN: U3.M2 (RX1A_N); also elsewhere on the board
CH4_RXP: U3.M1 (RX1A_P); also elsewhere on the board
CH5_RXN: U3.A1 (RX2A_N); also elsewhere on the board
CH5_RXP: U3.A2 (RX2A_P); also elsewhere on the board
GND: C45.2, C46.2, C47.2, C48.2, C49.2, C50.2, C51.2, C52.2, C53.2, C54.2, C55.2, C56.2, C57.2, C58.2, C59.2, C60.2, C61.2, C62.2, C63.2, C64.2, C65.2, C66.2, R11.2, U3.A4 (VSSA), U3.A6 (VSSA), U3.B1 (VSSA), U3.B2 (VSSA), U3.B12 (VSSA), U3.C2 (VSSA), U3.C4 (TEST/ENABLE), U3.C5 (CTRL_IN0), U3.C6 (CTRL_IN1), U3.C7 (VSSA), U3.C8 (VSSA), U3.C9 (VSSA), U3.C10 (VSSA), U3.C11 (VSSA), U3.C12 (VSSA), U3.D5 (CTRL_IN3), U3.D6 (CTRL_IN2), U3.D12 (VSSD), U3.F3 (VSSA), U3.F7 (VSSD), U3.F9 (VSSD), U3.F11 (VSSD), U3.G12 (VSSD), U3.H2 (VSSA), U3.H3 (VSSA), U3.H6 (VSSA), U3.H7 (VSSD), U3.H10 (VSSD), U3.J2 (VSSA), U3.K2 (VSSA), U3.K12 (VSSD), U3.L2 (VSSA), U3.L3 (VSSA), U3.L7 (VSSA), U3.L8 (VSSA), U3.L9 (VSSA), U3.L10 (VSSA), U3.L11 (VSSA), U3.L12 (VSSA), U3.M4 (VSSA), U3.M6 (VSSA); also elsewhere on the board
SPI_CLK: U3.J5 (SPI_CLK); also elsewhere on the board
SPI_DI: U3.J4 (SPI_DI); also elsewhere on the board
SPI_DO: U3.L6 (SPI_DO); also elsewhere on the board
SPI_ENB3: R13.1, U3.K6 (SPI_ENB); also elsewhere on the board
VADJ: C65.1, R13.2, U3.H12 (VDD_INTERFACE); also elsewhere on the board

Notes on the sheet:
AD9361 #3 (CH4, CH5)
Pin-strap/unused-pin handling follows ADI UG-570 and the AD-FMCOMMS2 reference design; verify.
