ajisrawi/passive-radar-counter-drone/hardware/board_b/board_b.kicad_pcb

## KiCad design hardware/board_b/board_b.kicad_pcb (continued)

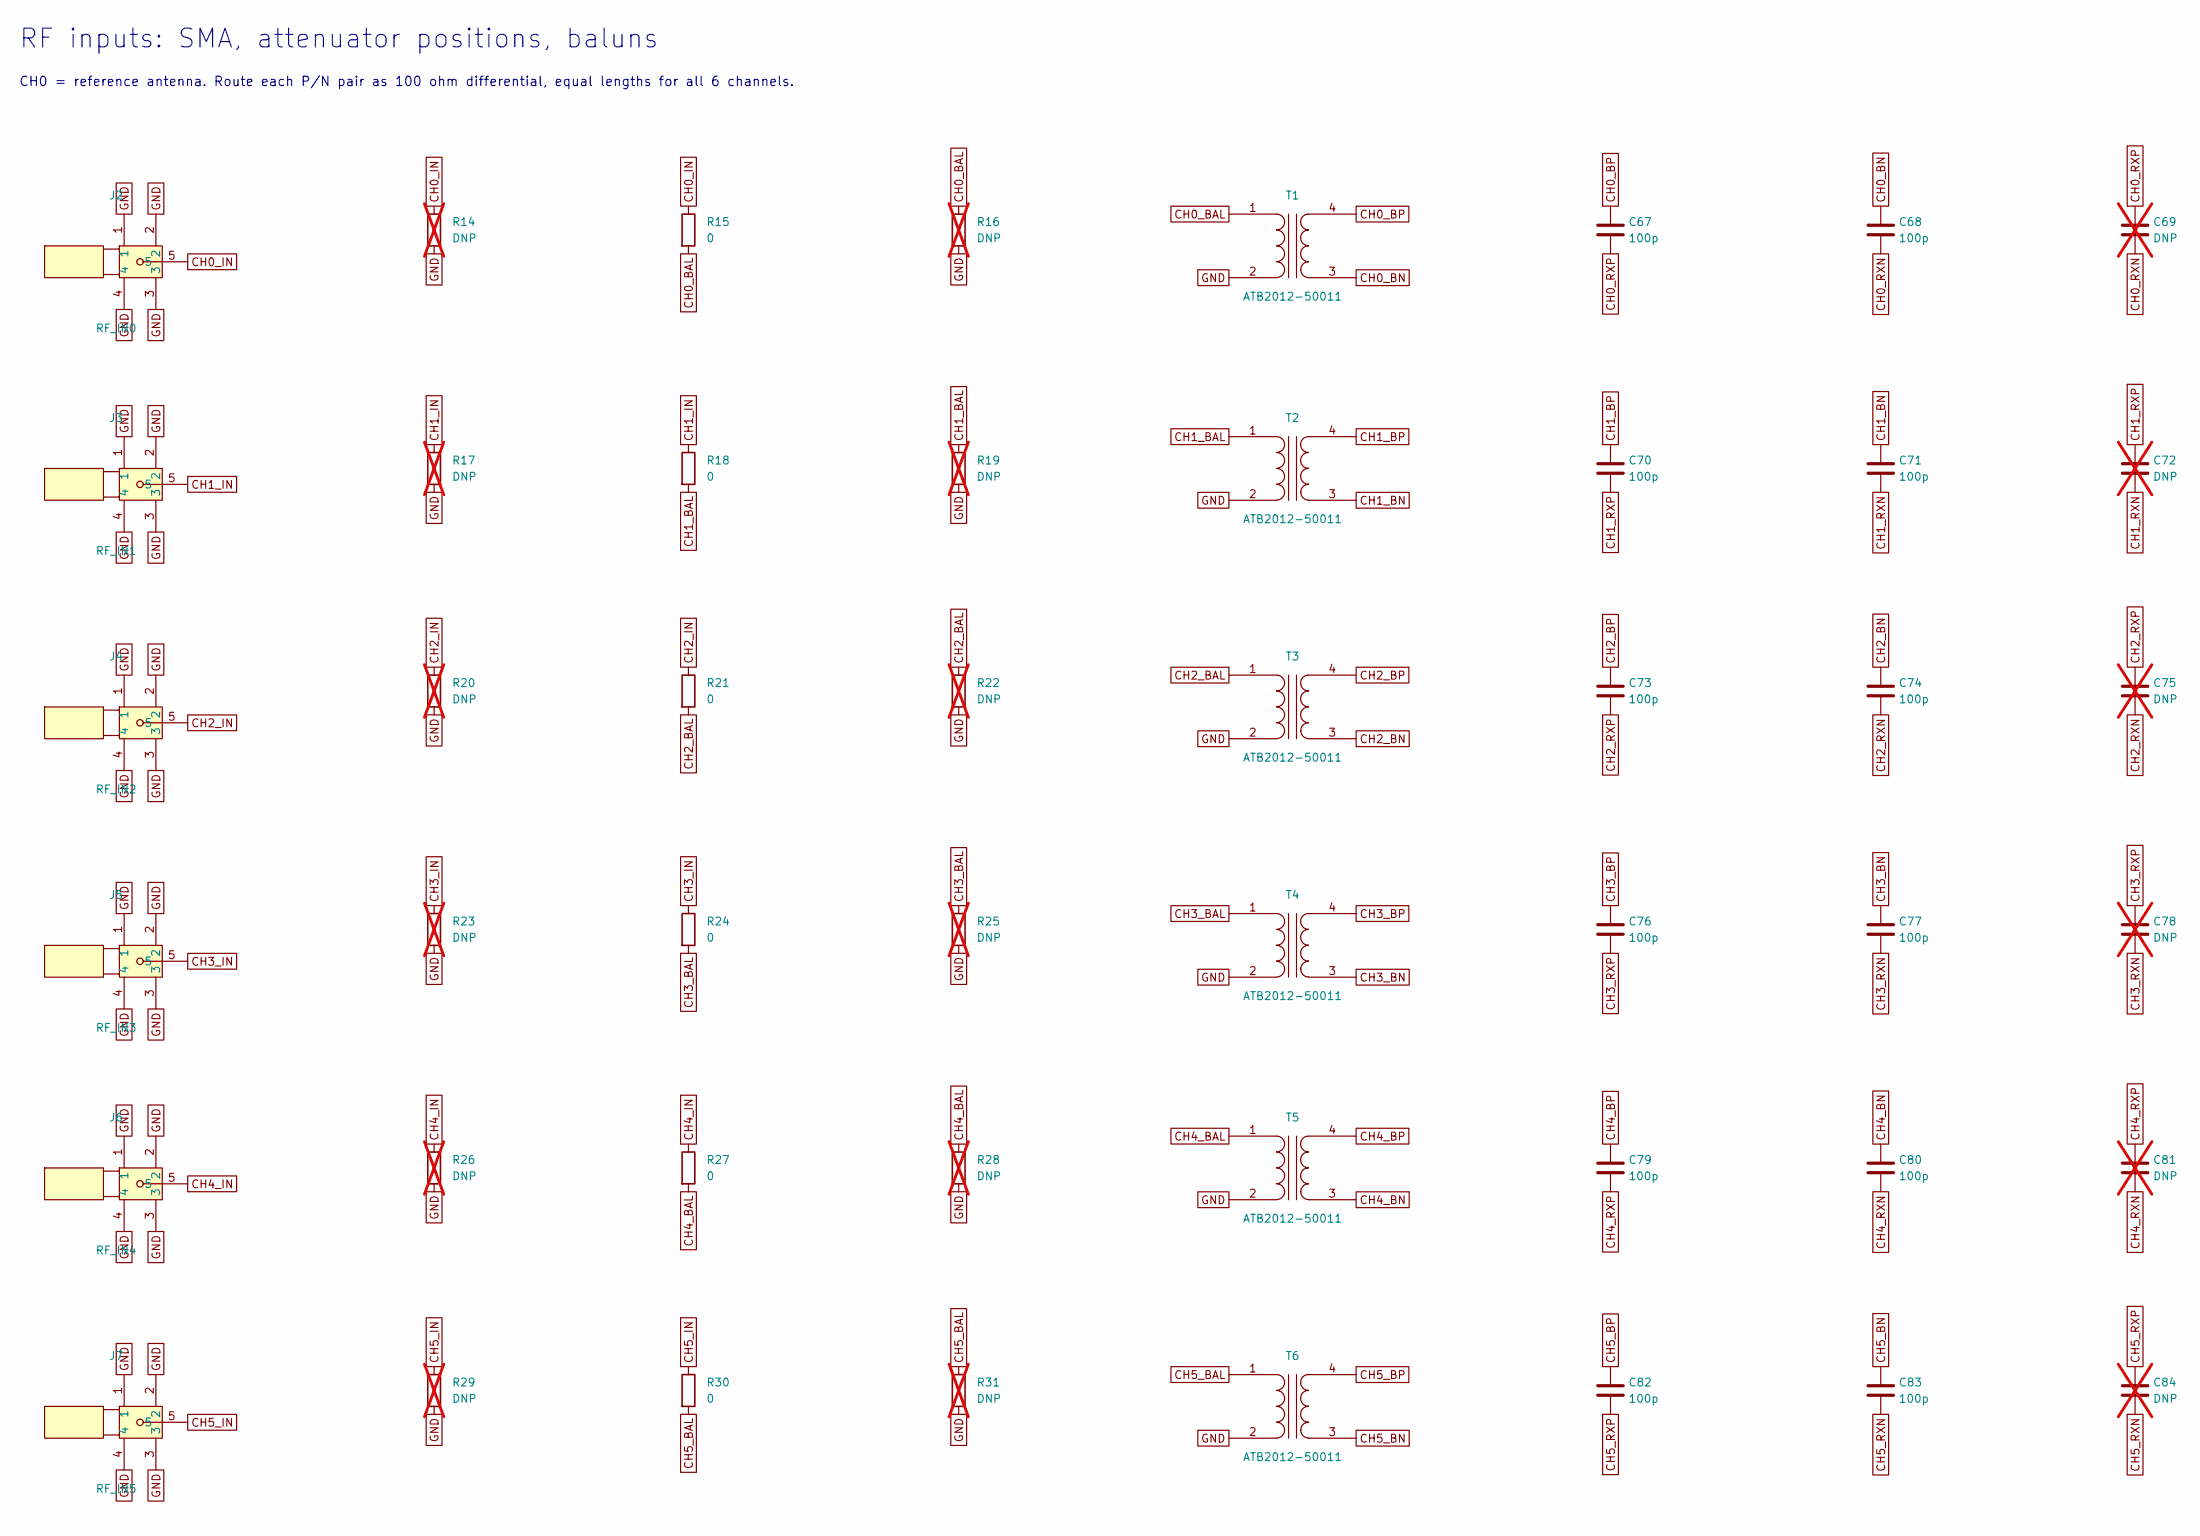
[picture p67: schematic rf_inputs.kicad_sch, RF inputs: SMA, attenuator positions, baluns]

Parts:
C67, C68, C70, C71, C73, C74, C76, C77, C79, C80, C82, C83: 100p; C_0402_1005Metric
C69, C72, C75, C78, C81, C84: DNP; C_0402_1005Metric; not fitted
J2: RF_IN0; SMA-TH_BWSMA-KE-Z001; MPN BWSMA-KE-Z001; LCSC C496549
J3: RF_IN1; SMA-TH_BWSMA-KE-Z001; MPN BWSMA-KE-Z001; LCSC C496549
J4: RF_IN2; SMA-TH_BWSMA-KE-Z001; MPN BWSMA-KE-Z001; LCSC C496549
J5: RF_IN3; SMA-TH_BWSMA-KE-Z001; MPN BWSMA-KE-Z001; LCSC C496549
J6: RF_IN4; SMA-TH_BWSMA-KE-Z001; MPN BWSMA-KE-Z001; LCSC C496549
J7: RF_IN5; SMA-TH_BWSMA-KE-Z001; MPN BWSMA-KE-Z001; LCSC C496549
R14, R16, R17, R19, R20, R22, R23, R25, R26, R28, R29, R31: DNP; R_0402_1005Metric; not fitted
R15, R18, R21, R24, R27, R30: 0; R_0402_1005Metric; LCSC C17168
T1, T2, T3, T4, T5, T6: ATB2012-50011; XFMR-SMD_ATB2012-50011-T000; MPN ATB2012-50011-T000; LCSC C92015

Connections:
CH0_BAL: R15.2, R16.1, T1.1 (AA)
CH0_BN: C68.1, T1.3 (SA)
CH0_BP: C67.1, T1.4 (SB)
CH0_IN: J2.5, R14.1, R15.1
CH0_RXN: C68.2, C69.2; also elsewhere on the board
CH0_RXP: C67.2, C69.1; also elsewhere on the board
CH1_BAL: R18.2, R19.1, T2.1 (AA)
CH1_BN: C71.1, T2.3 (SA)
CH1_BP: C70.1, T2.4 (SB)
CH1_IN: J3.5, R17.1, R18.1
CH1_RXN: C71.2, C72.2; also elsewhere on the board
CH1_RXP: C70.2, C72.1; also elsewhere on the board
CH2_BAL: R21.2, R22.1, T3.1 (AA)
CH2_BN: C74.1, T3.3 (SA)
CH2_BP: C73.1, T3.4 (SB)
CH2_IN: J4.5, R20.1, R21.1
CH2_RXN: C74.2, C75.2; also elsewhere on the board
CH2_RXP: C73.2, C75.1; also elsewhere on the board
CH3_BAL: R24.2, R25.1, T4.1 (AA)
CH3_BN: C77.1, T4.3 (SA)
CH3_BP: C76.1, T4.4 (SB)
CH3_IN: J5.5, R23.1, R24.1
CH3_RXN: C77.2, C78.2; also elsewhere on the board
CH3_RXP: C76.2, C78.1; also elsewhere on the board
CH4_BAL: R27.2, R28.1, T5.1 (AA)
CH4_BN: C80.1, T5.3 (SA)
CH4_BP: C79.1, T5.4 (SB)
CH4_IN: J6.5, R26.1, R27.1
CH4_RXN: C80.2, C81.2; also elsewhere on the board
CH4_RXP: C79.2, C81.1; also elsewhere on the board
CH5_BAL: R30.2, R31.1, T6.1 (AA)
CH5_BN: C83.1, T6.3 (SA)
CH5_BP: C82.1, T6.4 (SB)
CH5_IN: J7.5, R29.1, R30.1
CH5_RXN: C83.2, C84.2; also elsewhere on the board
CH5_RXP: C82.2, C84.1; also elsewhere on the board
GND: J2.1, J2.2, J2.3, J2.4, J3.1, J3.2, J3.3, J3.4, J4.1, J4.2, J4.3, J4.4, J5.1, J5.2, J5.3, J5.4, J6.1, J6.2, J6.3, J6.4, J7.1, J7.2, J7.3, J7.4, R14.2, R16.2, R17.2, R19.2, R20.2, R22.2, R23.2, R25.2, R26.2, R28.2, R29.2, R31.2, T1.2 (AB), T2.2 (AB), T3.2 (AB), T4.2 (AB), T5.2 (AB), T6.2 (AB); also elsewhere on the board

Notes on the sheet:
RF inputs: SMA, attenuator positions, baluns
CH0 = reference antenna. Route each P/N pair as 100 ohm differential, equal lengths for all 6 channels.

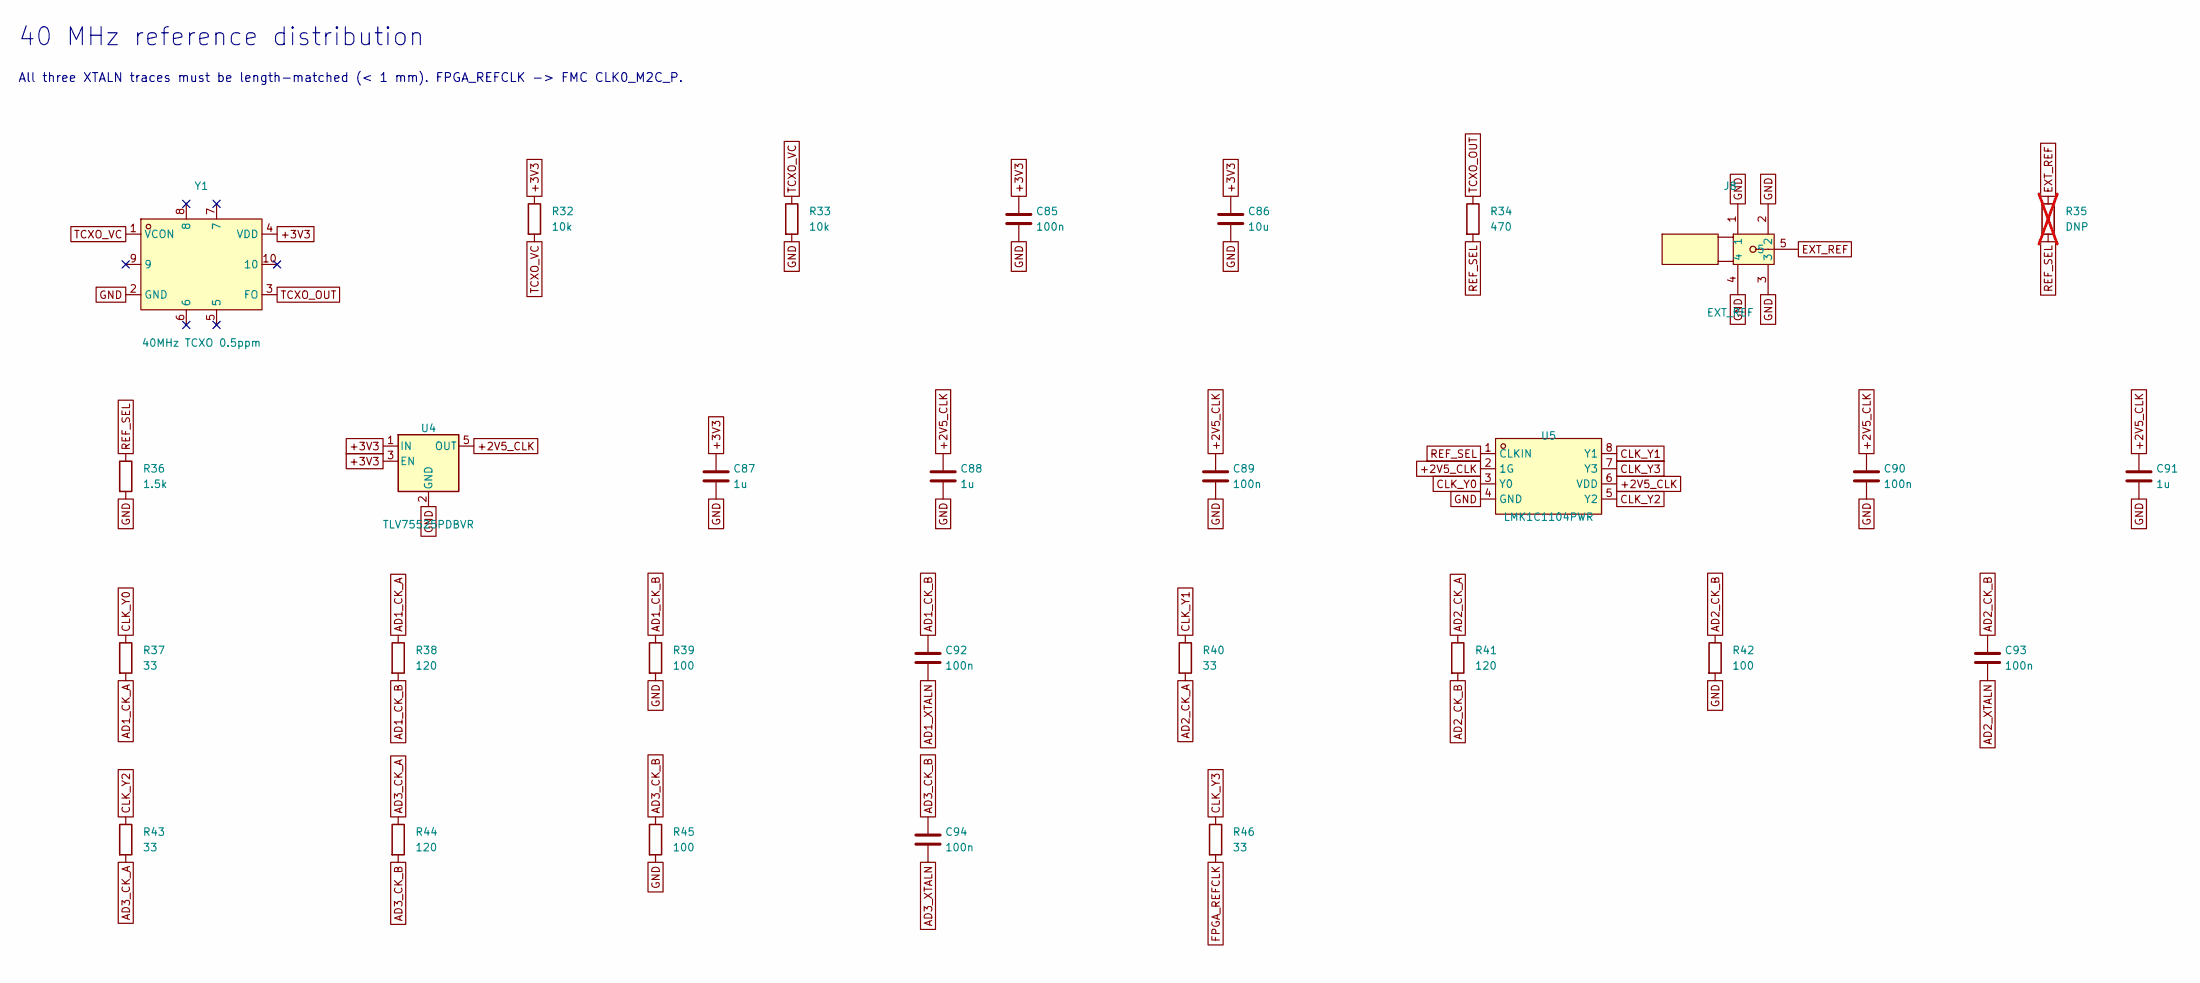
[picture p68: schematic clock.kicad_sch, 40 MHz reference distribution]

Parts:
C85, C89, C90, C92, C93, C94: 100n; C_0402_1005Metric; LCSC C1525
C86: 10u; C_0603_1608Metric; LCSC C19702
C87, C88, C91: 1u; C_0402_1005Metric; LCSC C52923
J8: EXT_REF; SMA-TH_BWSMA-KE-Z001; MPN BWSMA-KE-Z001; LCSC C496549
R32, R33: 10k; R_0402_1005Metric; LCSC C25744
R34: 470; R_0402_1005Metric
R35: DNP; R_0402_1005Metric; not fitted
R36: 1.5k; R_0402_1005Metric
R37, R40, R43, R46: 33; R_0402_1005Metric
R38, R41, R44: 120; R_0402_1005Metric
R39, R42, R45: 100; R_0402_1005Metric
U4: TLV75525PDBVR; SOT-23-5
U5: LMK1C1104PWR; TSSOP-8_L4.4-W3.0-P0.65-LS6.4-TL; MPN LMK1C1104PWR; LCSC C1855734
Y1: 40MHz TCXO 0.5ppm; OSC-SMD_10P-L7.0-W5.0-BL; MPN BT0507BH3I507BN40B; LCSC C516506

Connections:
+2V5_CLK: C88.1, C89.1, C90.1, C91.1, U4.5 (OUT), U5.2 (1G), U5.6 (VDD)
+3V3: C85.1, C86.1, C87.1, R32.1, U4.1 (IN), U4.3 (EN), Y1.4 (VDD); also elsewhere on the board
AD1_CK_A: R37.2, R38.1
AD1_CK_B: C92.1, R38.2, R39.1
AD1_XTALN: C92.2; also elsewhere on the board
AD2_CK_A: R40.2, R41.1
AD2_CK_B: C93.1, R41.2, R42.1
AD2_XTALN: C93.2; also elsewhere on the board
AD3_CK_A: R43.2, R44.1
AD3_CK_B: C94.1, R44.2, R45.1
AD3_XTALN: C94.2; also elsewhere on the board
CLK_Y0: R37.1, U5.3 (Y0)
CLK_Y1: R40.1, U5.8 (Y1)
CLK_Y2: R43.1, U5.5 (Y2)
CLK_Y3: R46.1, U5.7 (Y3)
EXT_REF: J8.5, R35.1
FPGA_REFCLK: R46.2; also elsewhere on the board
GND: C85.2, C86.2, C87.2, C88.2, C89.2, C90.2, C91.2, J8.1, J8.2, J8.3, J8.4, R33.2, R36.2, R39.2, R42.2, R45.2, U4.2 (GND), U5.4 (GND), Y1.2 (GND); also elsewhere on the board
REF_SEL: R34.2, R35.2, R36.1, U5.1 (CLKIN)
TCXO_OUT: R34.1, Y1.3 (FO)
TCXO_VC: R32.2, R33.1, Y1.1 (VCON)

Notes on the sheet:
40 MHz reference distribution
All three XTALN traces must be length-matched (< 1 mm). FPGA_REFCLK -> FMC CLK0_M2C_P.

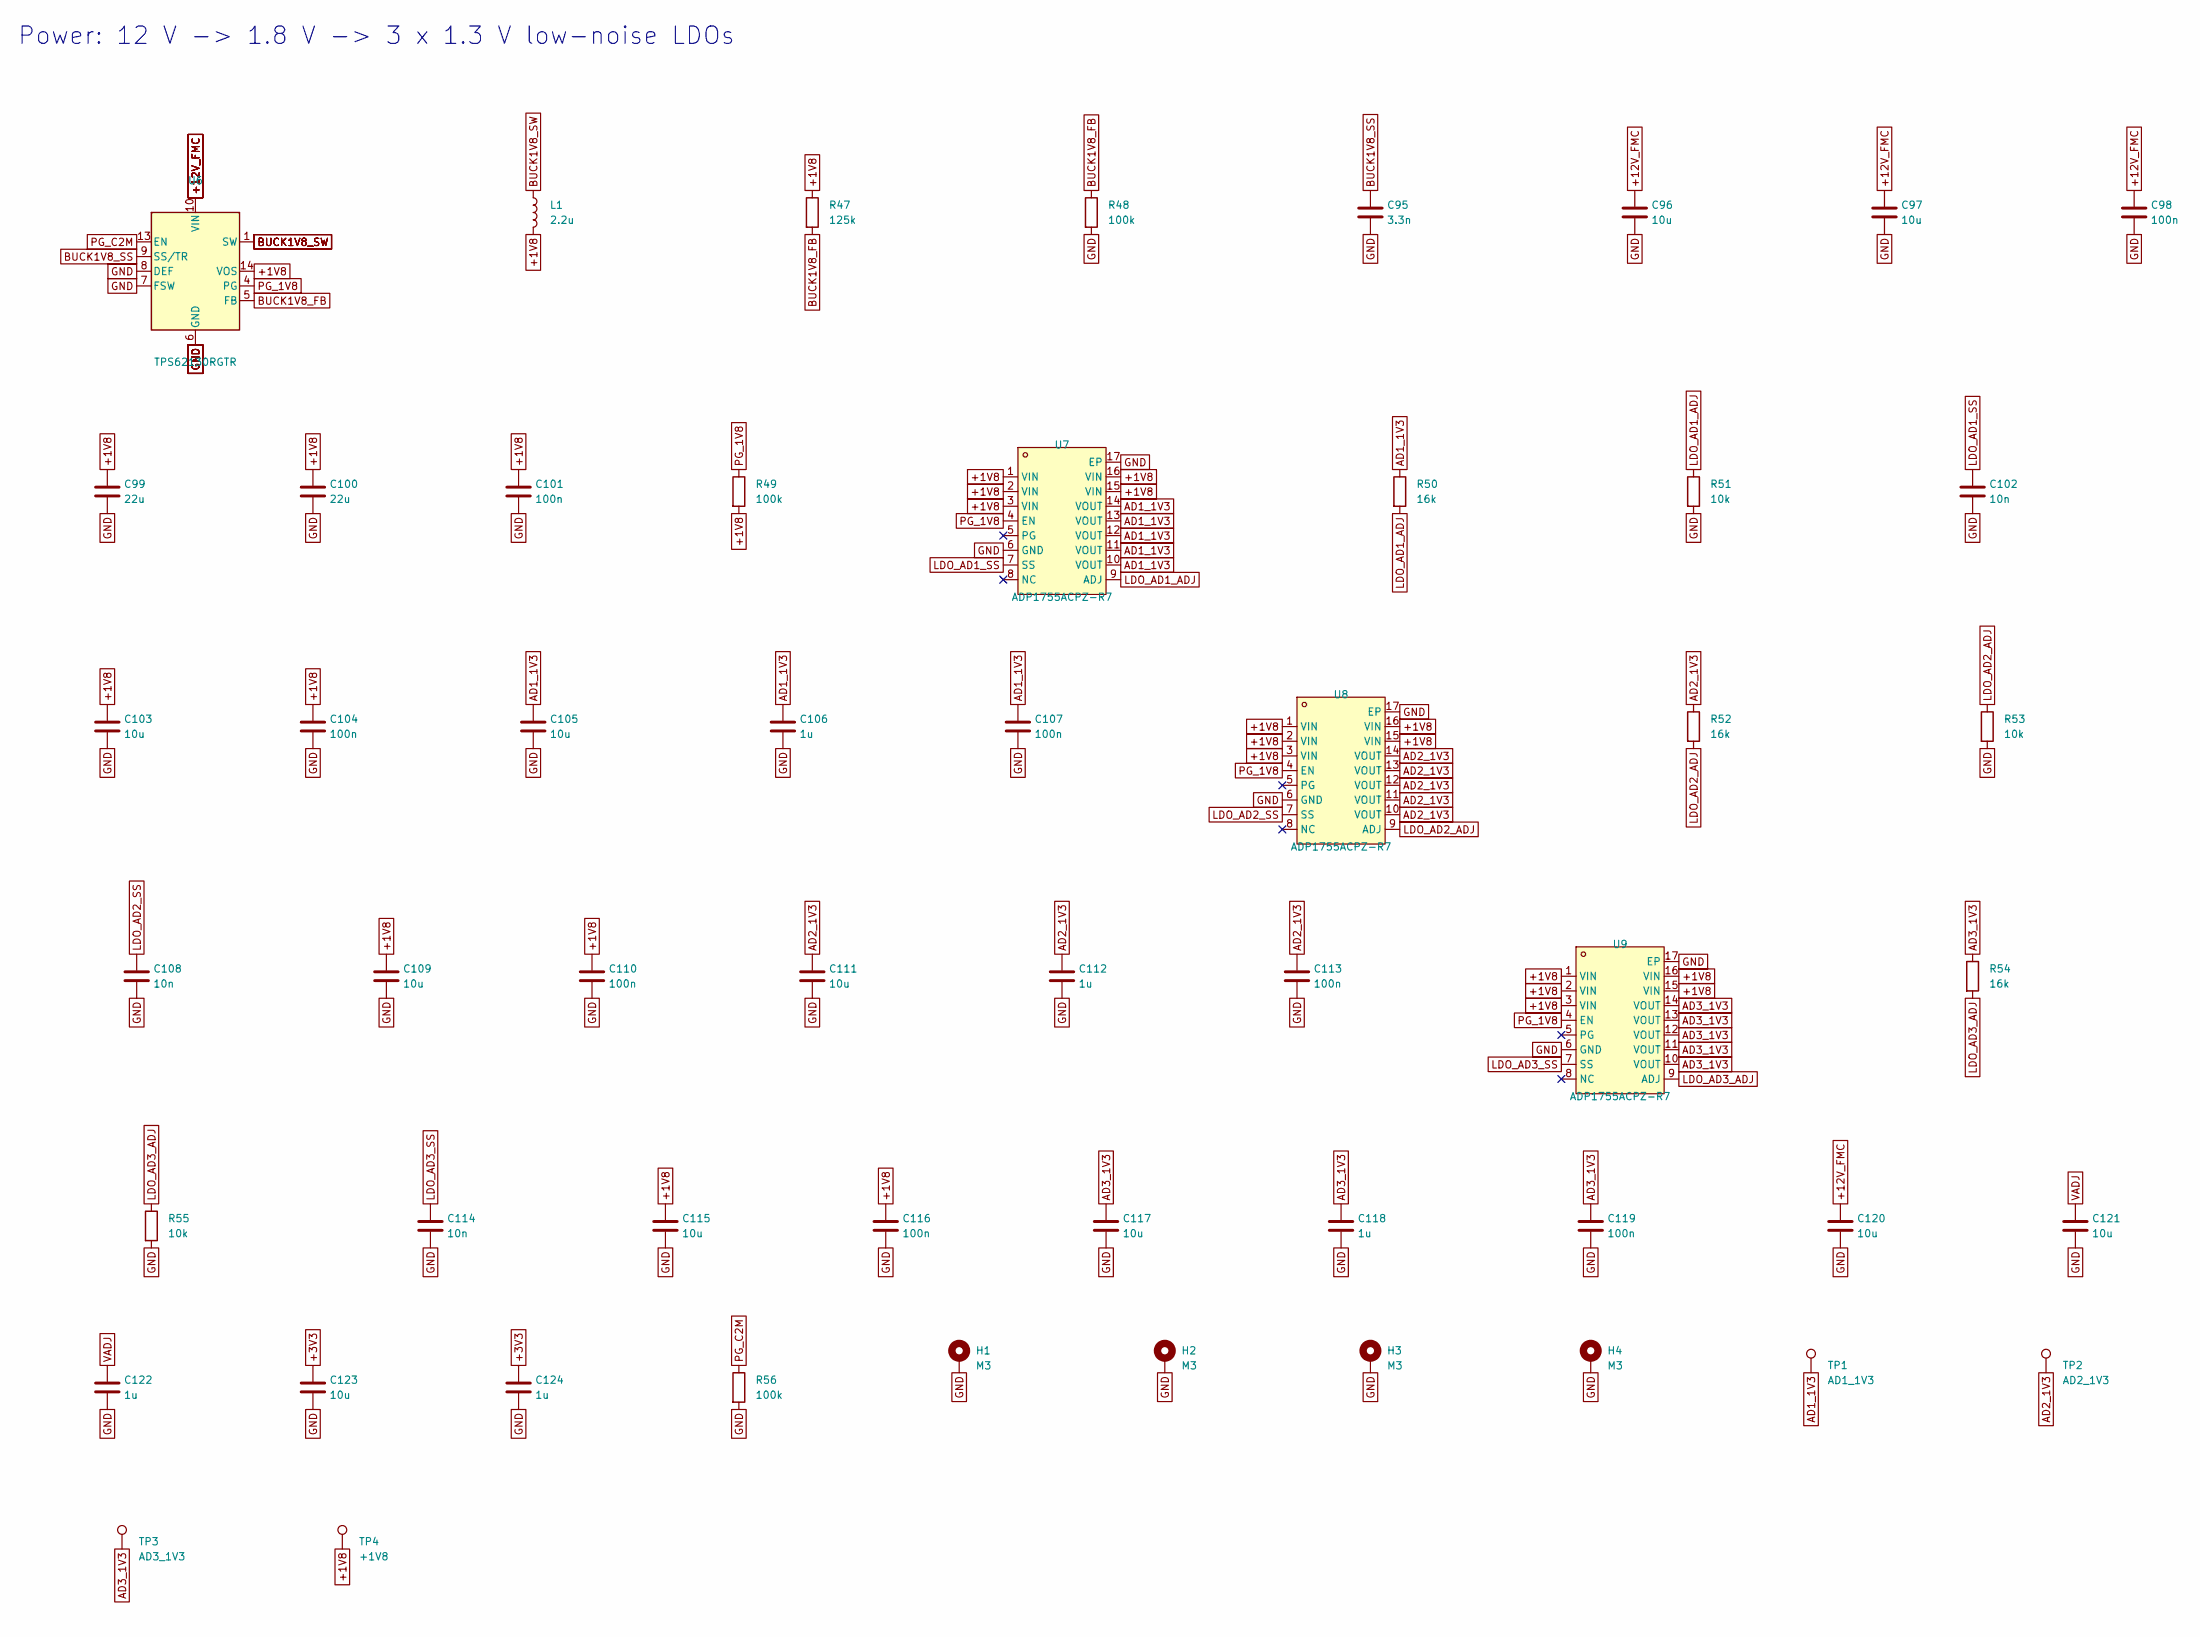
[picture p69: schematic power.kicad_sch, Power: 12 V -> 1.8 V -> 3 x 1.3 V low-noise LDOs]

Parts:
C95: 3.3n; C_0402_1005Metric
C96, C97, C120: 10u; C_0805_2012Metric
C98, C101, C104, C107, C110, C113, C116, C119: 100n; C_0402_1005Metric; LCSC C1525
C99, C100: 22u; C_0805_2012Metric; LCSC C45783
C102, C108, C114: 10n; C_0402_1005Metric; LCSC C15195
C103, C105, C109, C111, C115, C117, C121, C123: 10u; C_0603_1608Metric; LCSC C19702
C106, C112, C118, C122, C124: 1u; C_0402_1005Metric; LCSC C52923
H1, H2, H3, H4: M3; MountingHole_3.2mm_M3_Pad_Via
L1: 2.2u; L_Bourns-SRN4018; MPN SRN4018-2R2M
R47: 125k; R_0402_1005Metric
R48, R49, R56: 100k; R_0402_1005Metric; LCSC C25741
R50, R52, R54: 16k; R_0402_1005Metric; Tolerance 1%
R51, R53, R55: 10k; R_0402_1005Metric; Tolerance 1%; LCSC C25744
TP1: AD1_1V3; TestPoint_Pad_D1.0mm
TP2: AD2_1V3; TestPoint_Pad_D1.0mm
TP3: AD3_1V3; TestPoint_Pad_D1.0mm
TP4: +1V8; TestPoint_Pad_D1.0mm
U6: TPS62130RGTR; VQFN-16-1EP_3x3mm_P0.5mm_EP1.68x1.68mm; MPN TPS62130RGTR; LCSC C43590
U7, U8, U9: ADP1755ACPZ-R7; LFCSP-16_L4.0-W4.0-P0.65-BL-EP2.2; MPN ADP1755ACPZ-R7; LCSC C403695

Connections:
+1V8: C99.1, C100.1, C101.1, C103.1, C104.1, C109.1, C110.1, C115.1, C116.1, L1.2, R47.1, R49.2, TP4.1, U6.14 (VOS), U7.1 (VIN), U7.2 (VIN), U7.3 (VIN), U7.15 (VIN), U7.16 (VIN), U8.1 (VIN), U8.2 (VIN), U8.3 (VIN), U8.15 (VIN), U8.16 (VIN), U9.1 (VIN), U9.2 (VIN), U9.3 (VIN), U9.15 (VIN), U9.16 (VIN)
+3V3: C123.1, C124.1; also elsewhere on the board
+12V_FMC: C96.1, C97.1, C98.1, C120.1, U6.10 (VIN), U6.11 (VIN), U6.12 (VIN); also elsewhere on the board
AD1_1V3: C105.1, C106.1, C107.1, R50.1, TP1.1, U7.10 (VOUT), U7.11 (VOUT), U7.12 (VOUT), U7.13 (VOUT), U7.14 (VOUT); also elsewhere on the board
AD2_1V3: C111.1, C112.1, C113.1, R52.1, TP2.1, U8.10 (VOUT), U8.11 (VOUT), U8.12 (VOUT), U8.13 (VOUT), U8.14 (VOUT); also elsewhere on the board
AD3_1V3: C117.1, C118.1, C119.1, R54.1, TP3.1, U9.10 (VOUT), U9.11 (VOUT), U9.12 (VOUT), U9.13 (VOUT), U9.14 (VOUT); also elsewhere on the board
BUCK1V8_FB: R47.2, R48.1, U6.5 (FB)
BUCK1V8_SS: C95.1, U6.9 (SS/TR)
BUCK1V8_SW: L1.1, U6.1 (SW), U6.2 (SW), U6.3 (SW)
GND: C95.2, C96.2, C97.2, C98.2, C99.2, C100.2, C101.2, C102.2, C103.2, C104.2, C105.2, C106.2, C107.2, C108.2, C109.2, C110.2, C111.2, C112.2, C113.2, C114.2, C115.2, C116.2, C117.2, C118.2, C119.2, C120.2, C121.2, C122.2, C123.2, C124.2, H1.1, H2.1, H3.1, H4.1, R48.2, R51.2, R53.2, R55.2, R56.2, U6.6 (GND), U6.7 (FSW), U6.8 (DEF), U6.15 (GND), U6.16 (GND), U6.17 (GND), U7.6 (GND), U7.17 (EP), U8.6 (GND), U8.17 (EP), U9.6 (GND), U9.17 (EP); also elsewhere on the board
LDO_AD1_ADJ: R50.2, R51.1, U7.9 (ADJ)
LDO_AD1_SS: C102.1, U7.7 (SS)
LDO_AD2_ADJ: R52.2, R53.1, U8.9 (ADJ)
LDO_AD2_SS: C108.1, U8.7 (SS)
LDO_AD3_ADJ: R54.2, R55.1, U9.9 (ADJ)
LDO_AD3_SS: C114.1, U9.7 (SS)
PG_1V8: R49.1, U6.4 (PG), U7.4 (EN), U8.4 (EN), U9.4 (EN)
PG_C2M: R56.1, U6.13 (EN); also elsewhere on the board
VADJ: C121.1, C122.1; also elsewhere on the board

Notes on the sheet:
Power: 12 V -> 1.8 V -> 3 x 1.3 V low-noise LDOs

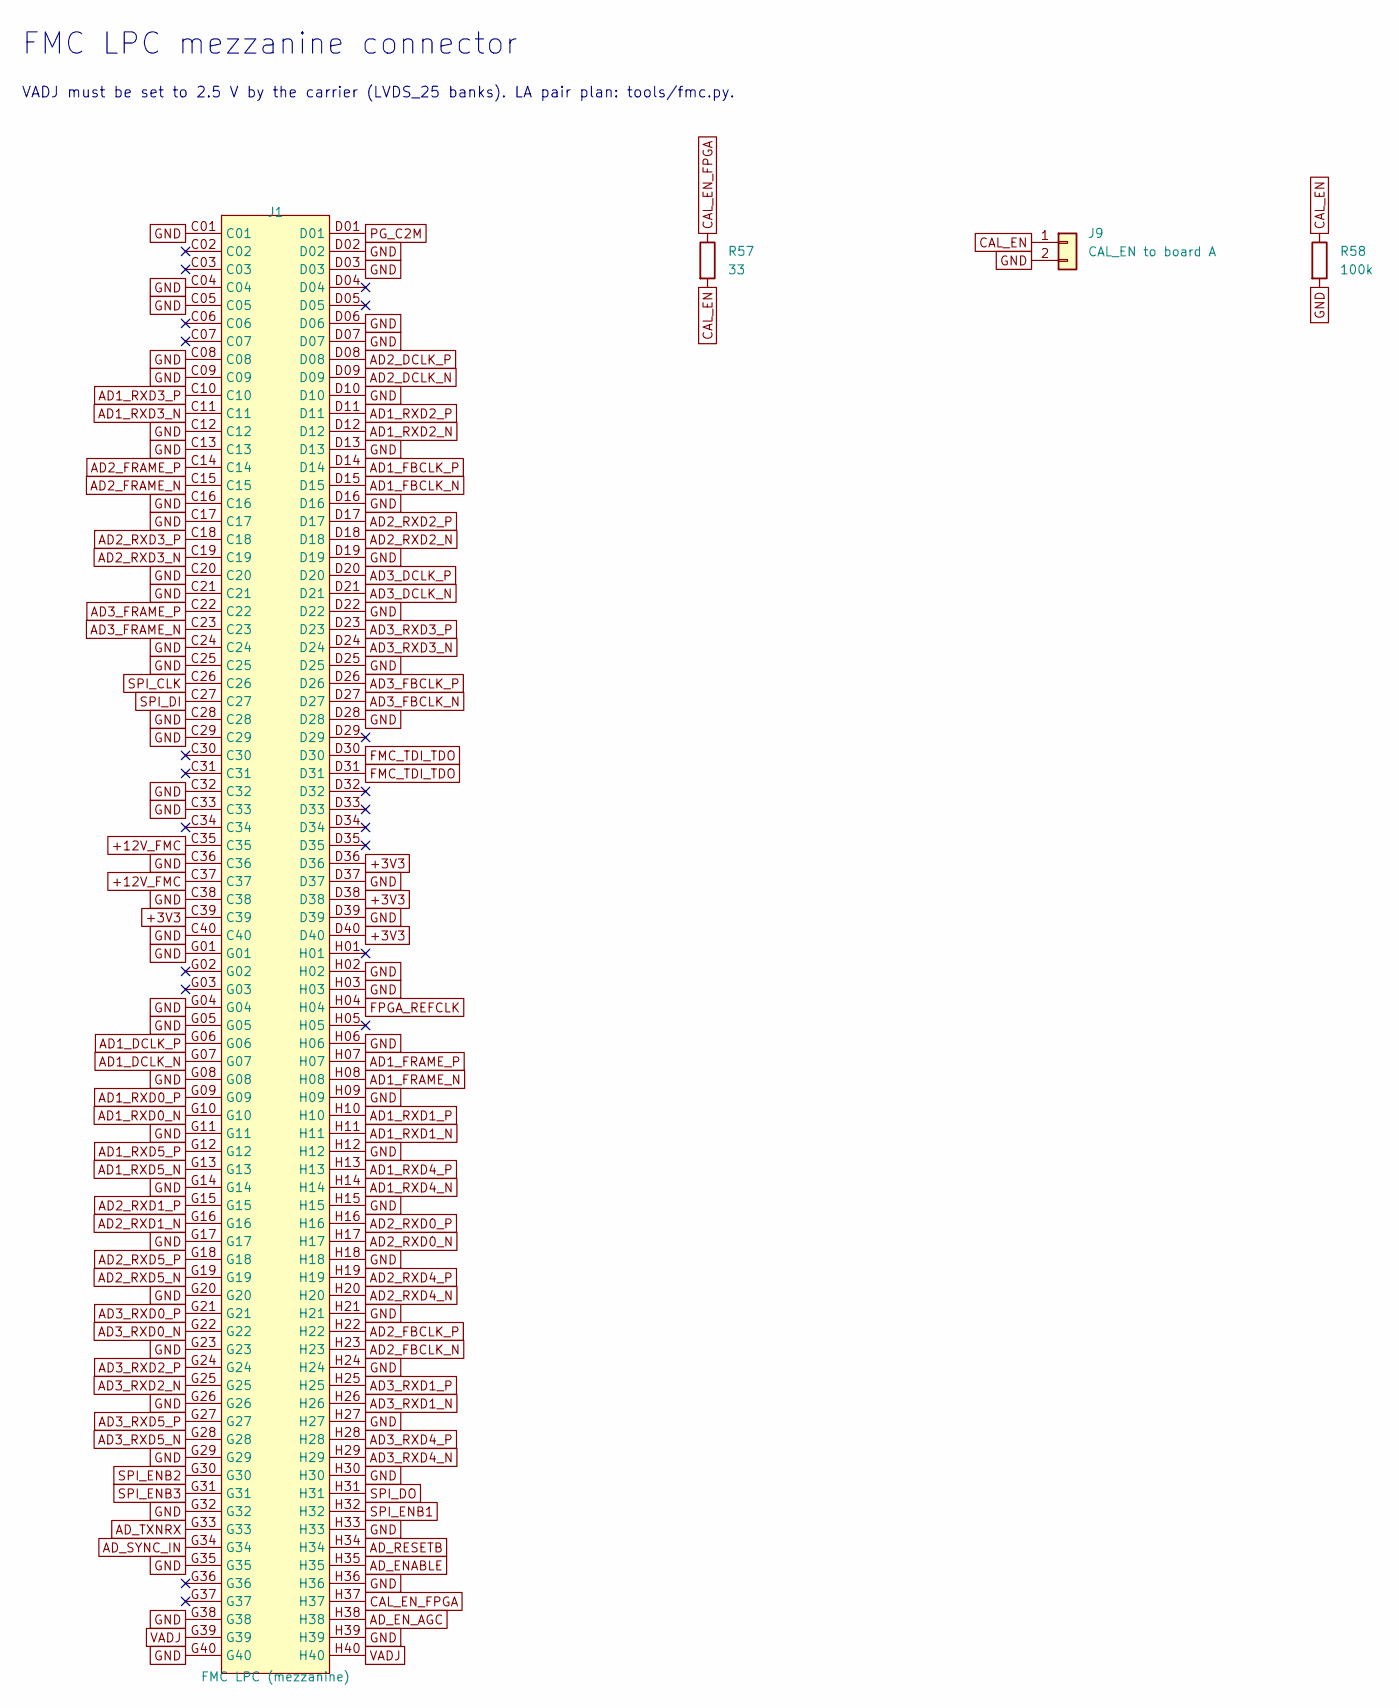
[picture p70: schematic fmc.kicad_sch, FMC LPC mezzanine connector]

Parts:
J1: FMC LPC (mezzanine); FPC_SMD_ASP-134604-01; MPN ASP-134604-01; LCSC C2830435
J9: CAL_EN to board A; PinHeader_1x02_P2.54mm_Vertical
R57: 33; R_0402_1005Metric
R58: 100k; R_0402_1005Metric; LCSC C25741

Connections:
+3V3: J1.C39, J1.D36, J1.D38, J1.D40; also elsewhere on the board
+12V_FMC: J1.C35, J1.C37; also elsewhere on the board
AD1_DCLK_N: J1.G07; also elsewhere on the board
AD1_DCLK_P: J1.G06; also elsewhere on the board
AD1_FBCLK_N: J1.D15; also elsewhere on the board
AD1_FBCLK_P: J1.D14; also elsewhere on the board
AD1_FRAME_N: J1.H08; also elsewhere on the board
AD1_FRAME_P: J1.H07; also elsewhere on the board
AD1_RXD0_N: J1.G10; also elsewhere on the board
AD1_RXD0_P: J1.G09; also elsewhere on the board
AD1_RXD1_N: J1.H11; also elsewhere on the board
AD1_RXD1_P: J1.H10; also elsewhere on the board
AD1_RXD2_N: J1.D12; also elsewhere on the board
AD1_RXD2_P: J1.D11; also elsewhere on the board
AD1_RXD3_N: J1.C11; also elsewhere on the board
AD1_RXD3_P: J1.C10; also elsewhere on the board
AD1_RXD4_N: J1.H14; also elsewhere on the board
AD1_RXD4_P: J1.H13; also elsewhere on the board
AD1_RXD5_N: J1.G13; also elsewhere on the board
AD1_RXD5_P: J1.G12; also elsewhere on the board
AD2_DCLK_N: J1.D09; also elsewhere on the board
AD2_DCLK_P: J1.D08; also elsewhere on the board
AD2_FBCLK_N: J1.H23; also elsewhere on the board
AD2_FBCLK_P: J1.H22; also elsewhere on the board
AD2_FRAME_N: J1.C15; also elsewhere on the board
AD2_FRAME_P: J1.C14; also elsewhere on the board
AD2_RXD0_N: J1.H17; also elsewhere on the board
AD2_RXD0_P: J1.H16; also elsewhere on the board
AD2_RXD1_N: J1.G16; also elsewhere on the board
AD2_RXD1_P: J1.G15; also elsewhere on the board
AD2_RXD2_N: J1.D18; also elsewhere on the board
AD2_RXD2_P: J1.D17; also elsewhere on the board
AD2_RXD3_N: J1.C19; also elsewhere on the board
AD2_RXD3_P: J1.C18; also elsewhere on the board
AD2_RXD4_N: J1.H20; also elsewhere on the board
AD2_RXD4_P: J1.H19; also elsewhere on the board
AD2_RXD5_N: J1.G19; also elsewhere on the board
AD2_RXD5_P: J1.G18; also elsewhere on the board
AD3_DCLK_N: J1.D21; also elsewhere on the board
AD3_DCLK_P: J1.D20; also elsewhere on the board
AD3_FBCLK_N: J1.D27; also elsewhere on the board
AD3_FBCLK_P: J1.D26; also elsewhere on the board
AD3_FRAME_N: J1.C23; also elsewhere on the board
AD3_FRAME_P: J1.C22; also elsewhere on the board
AD3_RXD0_N: J1.G22; also elsewhere on the board
AD3_RXD0_P: J1.G21; also elsewhere on the board
AD3_RXD1_N: J1.H26; also elsewhere on the board
AD3_RXD1_P: J1.H25; also elsewhere on the board
AD3_RXD2_N: J1.G25; also elsewhere on the board
AD3_RXD2_P: J1.G24; also elsewhere on the board
AD3_RXD3_N: J1.D24; also elsewhere on the board
AD3_RXD3_P: J1.D23; also elsewhere on the board
AD3_RXD4_N: J1.H29; also elsewhere on the board
AD3_RXD4_P: J1.H28; also elsewhere on the board
AD3_RXD5_N: J1.G28; also elsewhere on the board
AD3_RXD5_P: J1.G27; also elsewhere on the board
AD_ENABLE: J1.H35; also elsewhere on the board
AD_EN_AGC: J1.H38; also elsewhere on the board
AD_RESETB: J1.H34; also elsewhere on the board
AD_SYNC_IN: J1.G34; also elsewhere on the board
AD_TXNRX: J1.G33; also elsewhere on the board
CAL_EN: J9.1, R57.2, R58.1
CAL_EN_FPGA: J1.H37, R57.1
FMC_TDI_TDO: J1.D30, J1.D31
FPGA_REFCLK: J1.H04; also elsewhere on the board
GND: J1.C01, J1.C04, J1.C05, J1.C08, J1.C09, J1.C12, J1.C13, J1.C16, J1.C17, J1.C20, J1.C21, J1.C24, J1.C25, J1.C28, J1.C29, J1.C32, J1.C33, J1.C36, J1.C38, J1.C40, J1.D02, J1.D03, J1.D06, J1.D07, J1.D10, J1.D13, J1.D16, J1.D19, J1.D22, J1.D25, J1.D28, J1.D37, J1.D39, J1.G01, J1.G04, J1.G05, J1.G08, J1.G11, J1.G14, J1.G17, J1.G20, J1.G23, J1.G26, J1.G29, J1.G32, J1.G35, J1.G38, J1.G40, J1.H02, J1.H03, J1.H06, J1.H09, J1.H12, J1.H15, J1.H18, J1.H21, J1.H24, J1.H27, J1.H30, J1.H33, J1.H36, J1.H39, J9.2, R58.2; also elsewhere on the board
PG_C2M: J1.D01; also elsewhere on the board
SPI_CLK: J1.C26; also elsewhere on the board
SPI_DI: J1.C27; also elsewhere on the board
SPI_DO: J1.H31; also elsewhere on the board
SPI_ENB1: J1.H32; also elsewhere on the board
SPI_ENB2: J1.G30; also elsewhere on the board
SPI_ENB3: J1.G31; also elsewhere on the board
VADJ: J1.G39, J1.H40; also elsewhere on the board

Notes on the sheet:
FMC LPC mezzanine connector
VADJ must be set to 2.5 V by the carrier (LVDS_25 banks). LA pair plan: tools/fmc.py.

Board: 8 copper layers, 228 parts (67 on the bottom side), 166 nets, no tracks yet.
