ajisrawi/passive-radar-counter-drone/hardware/board_a/board_a.kicad_pcb

## KiCad design hardware/board_a/board_a.kicad_pcb (2026-10-28)

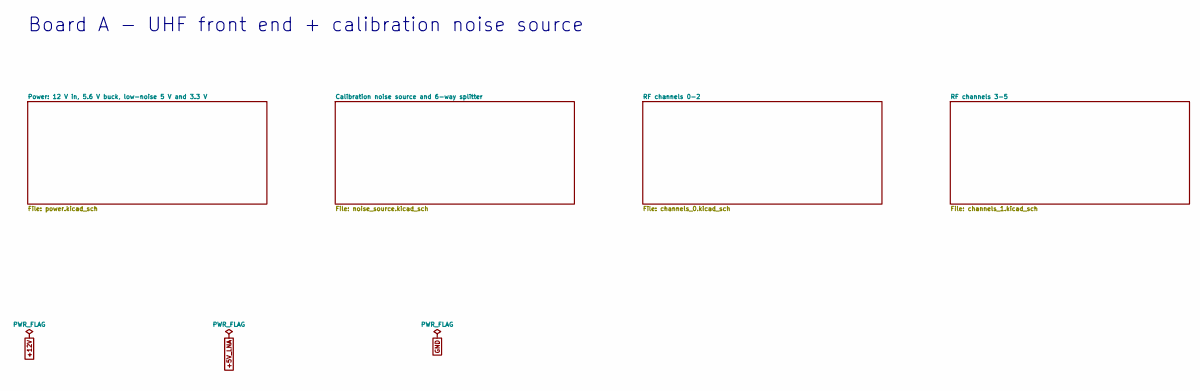
[picture p71: schematic board_a.kicad_sch, Board A - UHF front end + calibration noise source]

Notes on the sheet:
Board A - UHF front end + calibration noise source
