ajisrawi/passive-radar-counter-drone/hardware/board_a/board_a.kicad_pcb

## KiCad design hardware/board_a/board_a.kicad_pcb (continued)

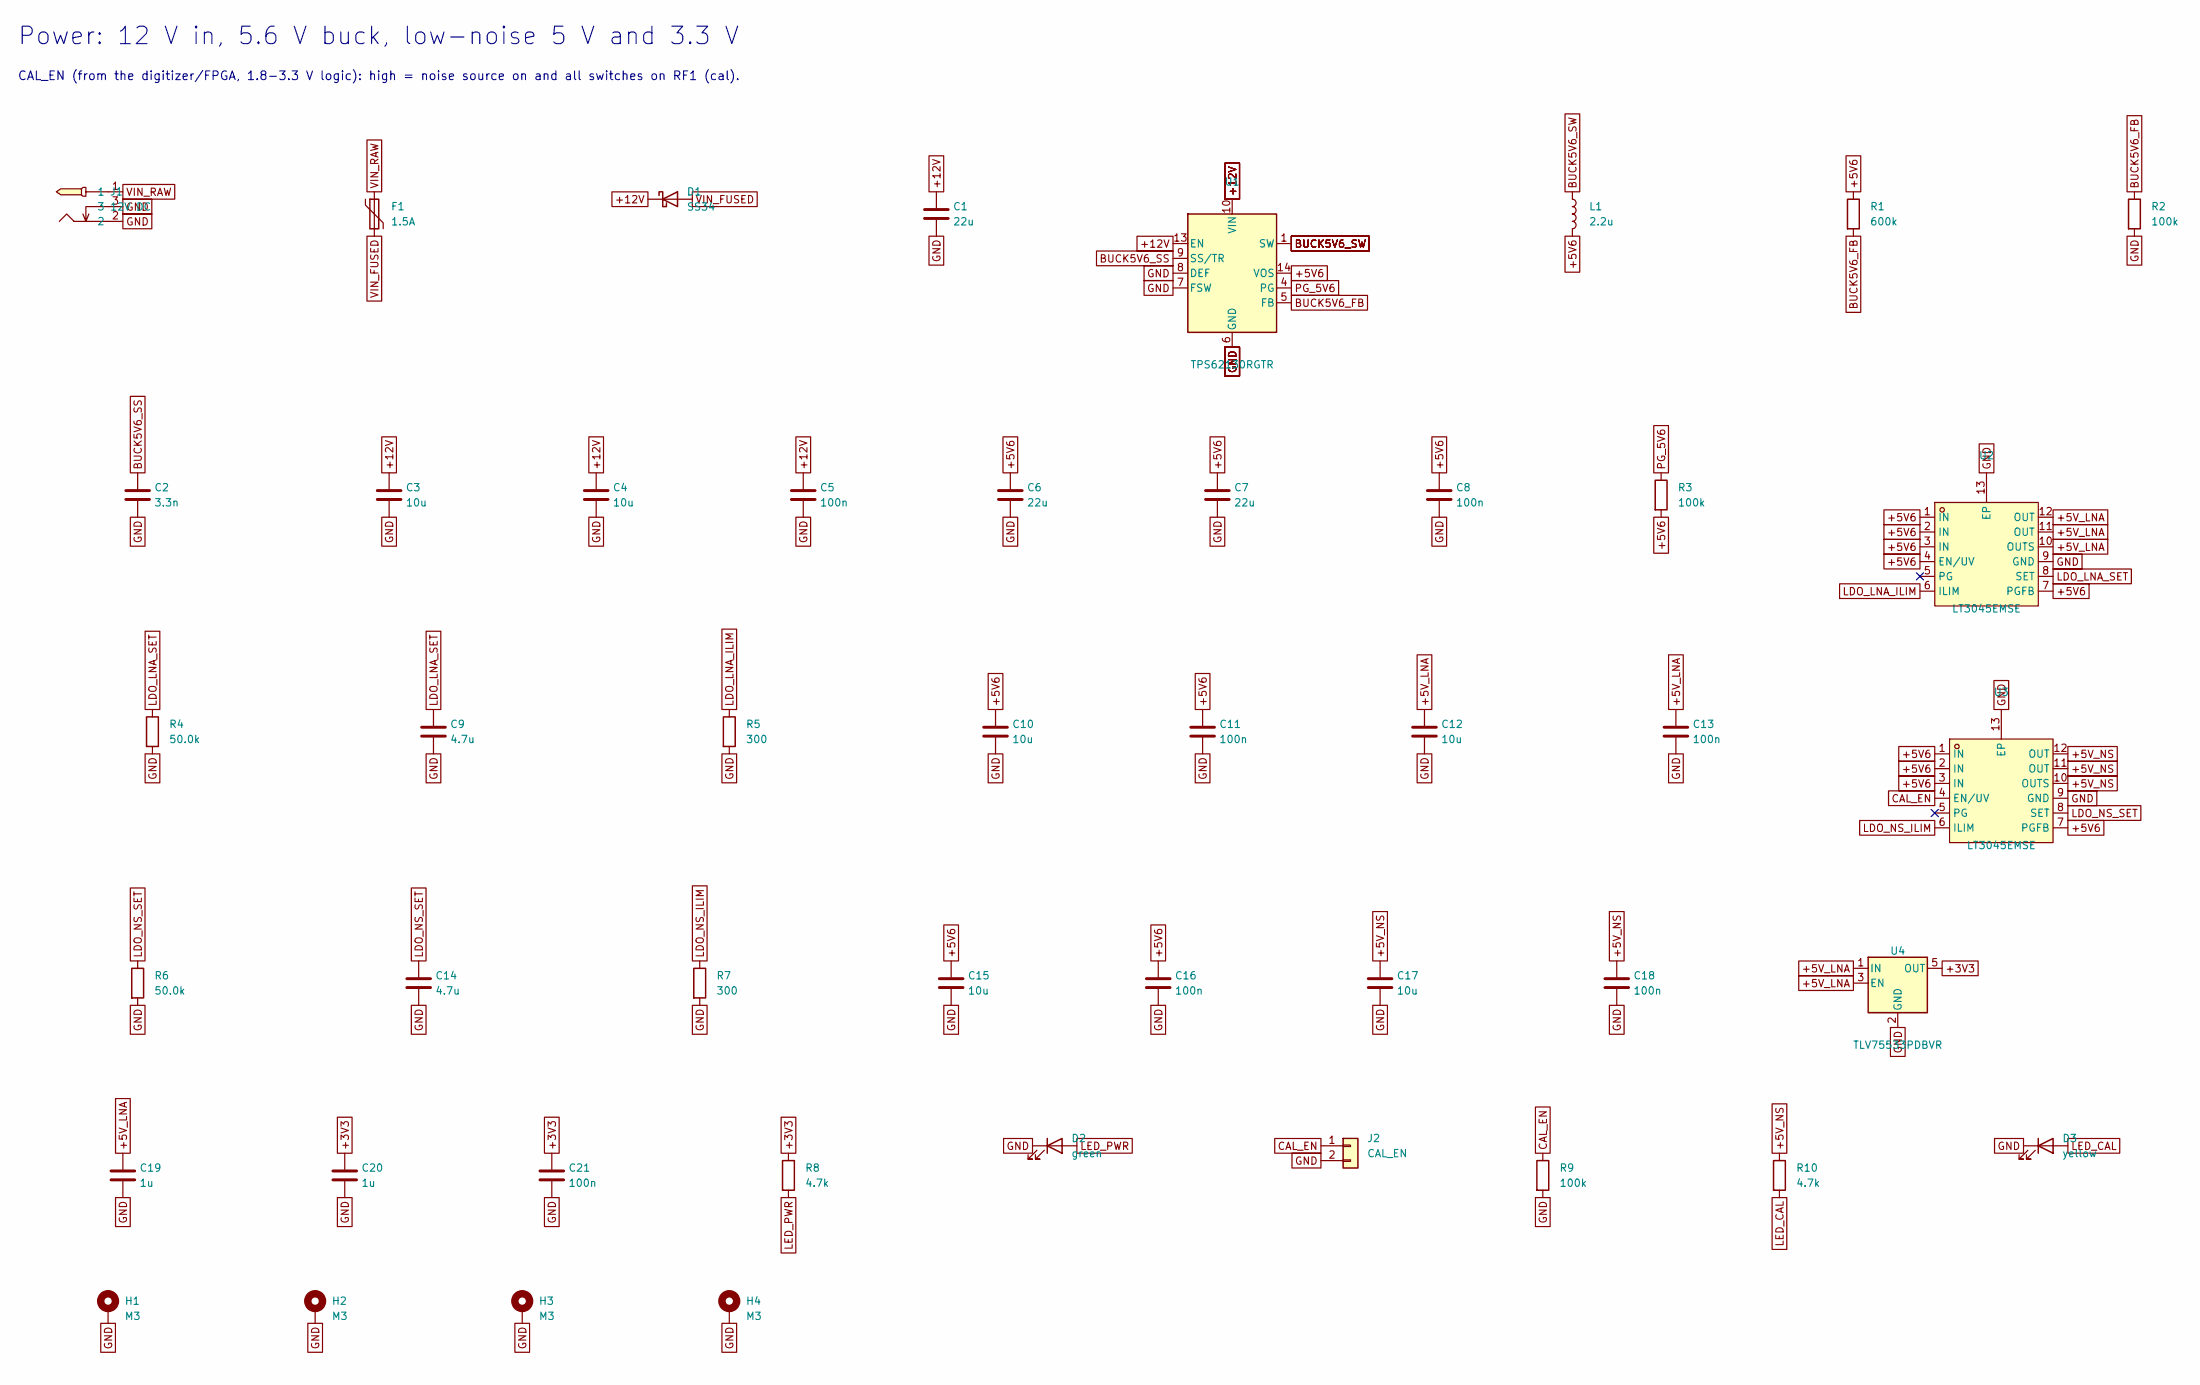
[picture p72: schematic power.kicad_sch, Power: 12 V in, 5.6 V buck, low-noise 5 V and 3.3 V]

Parts:
C1: 22u; C_1206_3216Metric
C2: 3.3n; C_0402_1005Metric
C3, C4: 10u; C_0805_2012Metric
C5, C8, C11, C13, C16, C18, C21: 100n; C_0402_1005Metric; LCSC C1525
C6, C7: 22u; C_0805_2012Metric; LCSC C45783
C9, C14: 4.7u; C_0603_1608Metric
C10, C12, C15, C17: 10u; C_0603_1608Metric; LCSC C19702
C19, C20: 1u; C_0402_1005Metric; LCSC C52923
D1: SS34; D_SMA; MPN SS34; LCSC C8678
D2: green; LED_0603_1608Metric
D3: yellow; LED_0603_1608Metric
F1: 1.5A; Fuse_1206_3216Metric
H1, H2, H3, H4: M3; MountingHole_3.2mm_M3_Pad_Via
J1: 12V DC; DC-IN-TH_DC-005C-20A; MPN DC-005C-20A; LCSC C84007
J2: CAL_EN; PinHeader_1x02_P2.54mm_Vertical
L1: 2.2u; L_Bourns-SRN4018; MPN SRN4018-2R2M
R1: 600k; R_0402_1005Metric
R2, R3, R9: 100k; R_0402_1005Metric; LCSC C25741
R4, R6: 50.0k; R_0402_1005Metric; Tolerance 0.1%
R5, R7: 300; R_0402_1005Metric
R8, R10: 4.7k; R_0402_1005Metric; LCSC C25900
U1: TPS62130RGTR; VQFN-16-1EP_3x3mm_P0.5mm_EP1.68x1.68mm; MPN TPS62130RGTR; LCSC C43590
U2, U3: LT3045EMSE; MSOP-12_L4.0-W3.0-P0.65-LS4.9-BL-EP; MPN LT3045EMSE#PBF; LCSC C580012
U4: TLV75533PDBVR; SOT-23-5; LCSC C404027

Connections:
+3V3: C20.1, C21.1, R8.1, U4.5 (OUT); also elsewhere on the board
+5V6: C6.1, C7.1, C8.1, C10.1, C11.1, C15.1, C16.1, L1.2, R1.1, R3.2, U1.14 (VOS), U2.1 (IN), U2.2 (IN), U2.3 (IN), U2.4 (EN/UV), U2.7 (PGFB), U3.1 (IN), U3.2 (IN), U3.3 (IN), U3.7 (PGFB)
+5V_LNA: C12.1, C13.1, C19.1, U2.10 (OUTS), U2.11 (OUT), U2.12 (OUT), U4.1 (IN), U4.3 (EN); also elsewhere on the board
+5V_NS: C17.1, C18.1, R10.1, U3.10 (OUTS), U3.11 (OUT), U3.12 (OUT); also elsewhere on the board
+12V: C1.1, C3.1, C4.1, C5.1, D1.1 (K), U1.10 (VIN), U1.11 (VIN), U1.12 (VIN), U1.13 (EN)
BUCK5V6_FB: R1.2, R2.1, U1.5 (FB)
BUCK5V6_SS: C2.1, U1.9 (SS/TR)
BUCK5V6_SW: L1.1, U1.1 (SW), U1.2 (SW), U1.3 (SW)
CAL_EN: J2.1, R9.1, U3.4 (EN/UV); also elsewhere on the board
GND: C1.2, C2.2, C3.2, C4.2, C5.2, C6.2, C7.2, C8.2, C9.2, C10.2, C11.2, C12.2, C13.2, C14.2, C15.2, C16.2, C17.2, C18.2, C19.2, C20.2, C21.2, D2.1 (K), D3.1 (K), H1.1, H2.1, H3.1, H4.1, J1.2, J1.3, J2.2, R2.2, R4.2, R5.2, R6.2, R7.2, R9.2, U1.6 (GND), U1.7 (FSW), U1.8 (DEF), U1.15 (GND), U1.16 (GND), U1.17 (GND), U2.9 (GND), U2.13 (EP), U3.9 (GND), U3.13 (EP), U4.2 (GND); also elsewhere on the board
LDO_LNA_ILIM: R5.1, U2.6 (ILIM)
LDO_LNA_SET: C9.1, R4.1, U2.8 (SET)
LDO_NS_ILIM: R7.1, U3.6 (ILIM)
LDO_NS_SET: C14.1, R6.1, U3.8 (SET)
LED_CAL: D3.2 (A), R10.2
LED_PWR: D2.2 (A), R8.2
PG_5V6: R3.1, U1.4 (PG)
VIN_FUSED: D1.2 (A), F1.2
VIN_RAW: F1.1, J1.1

Notes on the sheet:
Power: 12 V in, 5.6 V buck, low-noise 5 V and 3.3 V
CAL_EN (from the digitizer/FPGA, 1.8-3.3 V logic): high = noise source on and all switches on RF1 (cal).

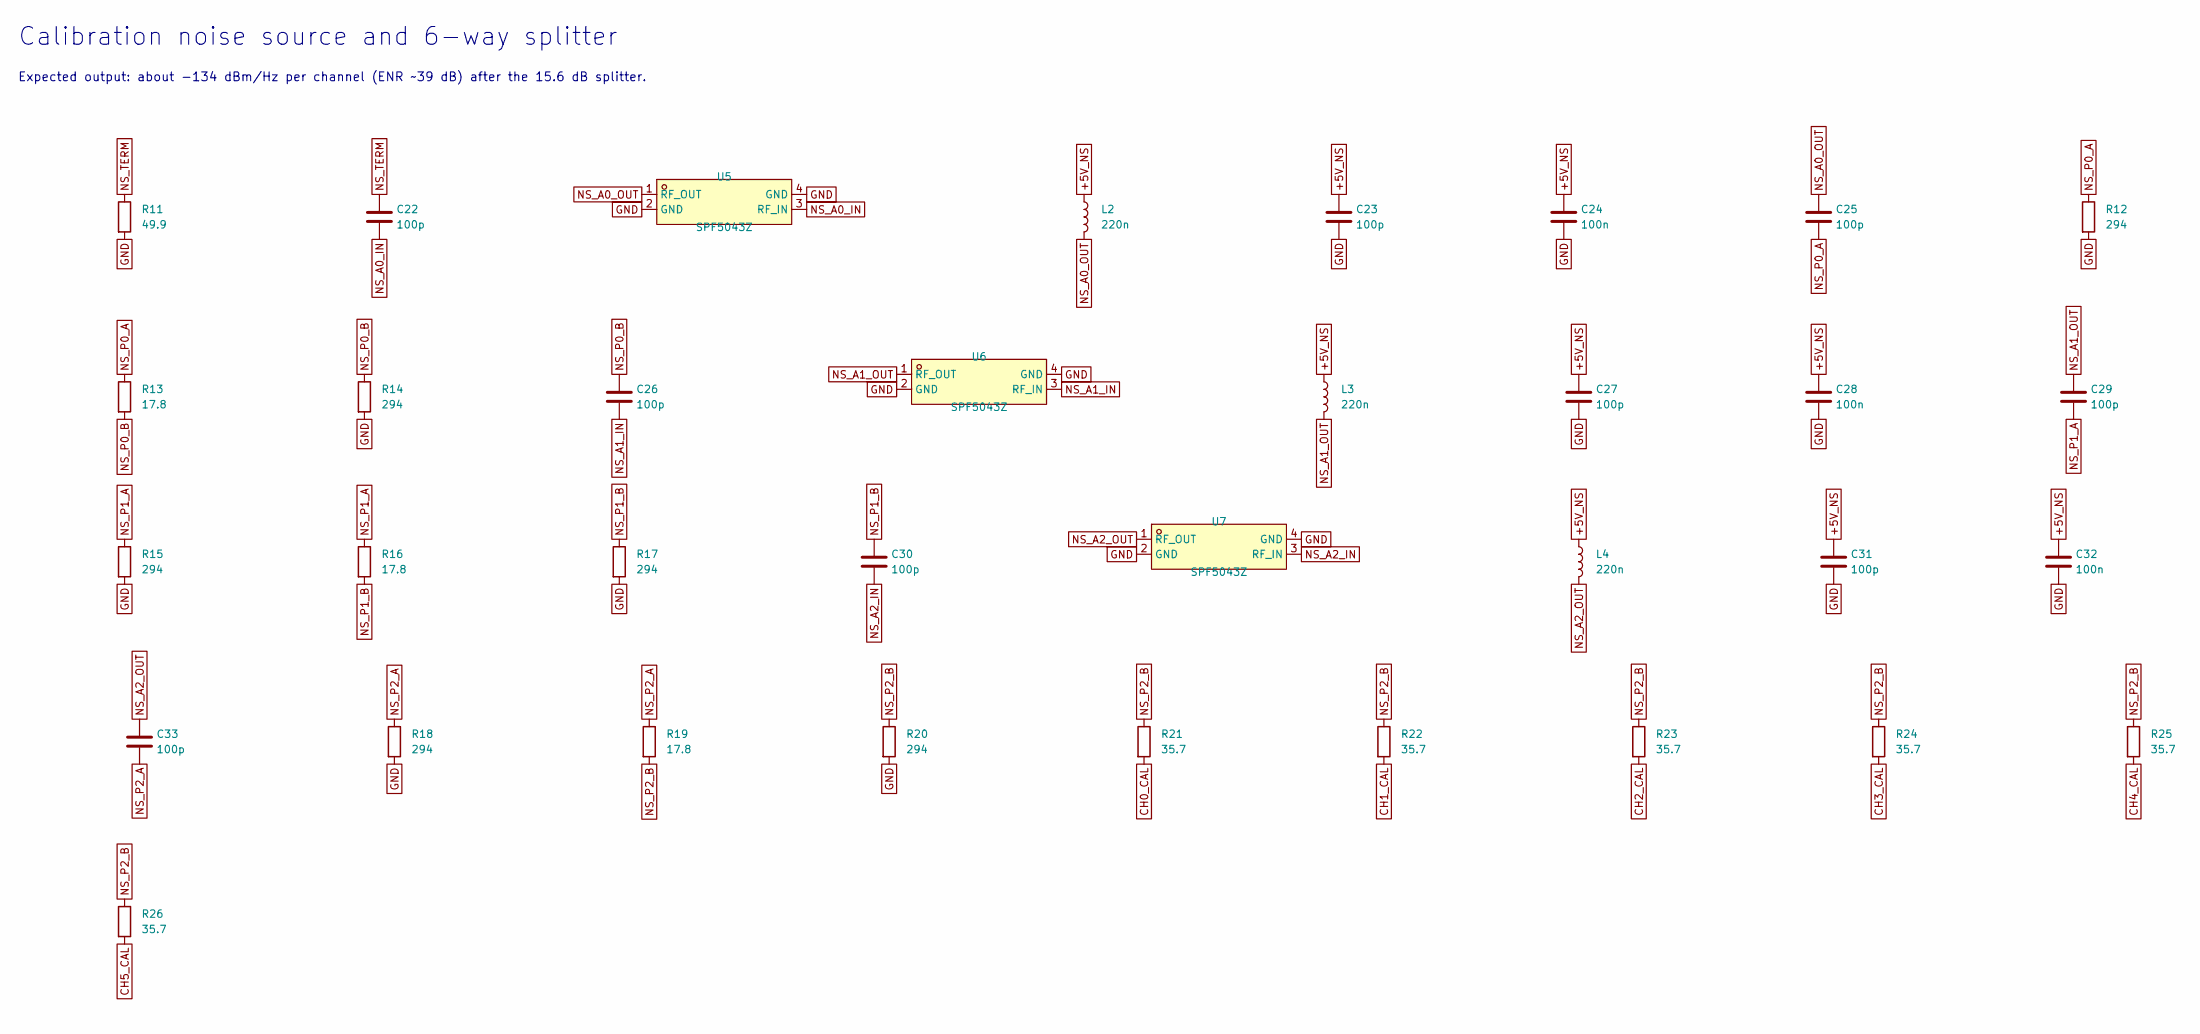
[picture p73: schematic noise_source.kicad_sch, Calibration noise source and 6-way splitter]

Parts:
C22, C23, C25, C26, C27, C29, C30, C31, C33: 100p; C_0402_1005Metric
C24, C28, C32: 100n; C_0402_1005Metric; LCSC C1525
L2, L3, L4: 220n; L_0603_1608Metric
R11: 49.9; R_0402_1005Metric
R12, R14, R15, R17, R18, R20: 294; R_0402_1005Metric
R13, R16, R19: 17.8; R_0402_1005Metric
R21, R22, R23, R24, R25, R26: 35.7; R_0402_1005Metric
U5, U6, U7: SPF5043Z; SOT343_L2.0-W1.3-P1.30-LS2.1-BL; MPN SPF5043Z; LCSC C470902

Connections:
+5V_NS: C23.1, C24.1, C27.1, C28.1, C31.1, C32.1, L2.1, L3.1, L4.1; also elsewhere on the board
CH0_CAL: R21.2; also elsewhere on the board
CH1_CAL: R22.2; also elsewhere on the board
CH2_CAL: R23.2; also elsewhere on the board
CH3_CAL: R24.2; also elsewhere on the board
CH4_CAL: R25.2; also elsewhere on the board
CH5_CAL: R26.2; also elsewhere on the board
GND: C23.2, C24.2, C27.2, C28.2, C31.2, C32.2, R11.2, R12.2, R14.2, R15.2, R17.2, R18.2, R20.2, U5.2 (GND), U5.4 (GND), U6.2 (GND), U6.4 (GND), U7.2 (GND), U7.4 (GND); also elsewhere on the board
NS_A0_IN: C22.2, U5.3 (RF_IN)
NS_A0_OUT: C25.1, L2.2, U5.1 (RF_OUT)
NS_A1_IN: C26.2, U6.3 (RF_IN)
NS_A1_OUT: C29.1, L3.2, U6.1 (RF_OUT)
NS_A2_IN: C30.2, U7.3 (RF_IN)
NS_A2_OUT: C33.1, L4.2, U7.1 (RF_OUT)
NS_P0_A: C25.2, R12.1, R13.1
NS_P0_B: C26.1, R13.2, R14.1
NS_P1_A: C29.2, R15.1, R16.1
NS_P1_B: C30.1, R16.2, R17.1
NS_P2_A: C33.2, R18.1, R19.1
NS_P2_B: R19.2, R20.1, R21.1, R22.1, R23.1, R24.1, R25.1, R26.1
NS_TERM: C22.1, R11.1

Notes on the sheet:
Calibration noise source and 6-way splitter
Expected output: about -134 dBm/Hz per channel (ENR ~39 dB) after the 15.6 dB splitter.

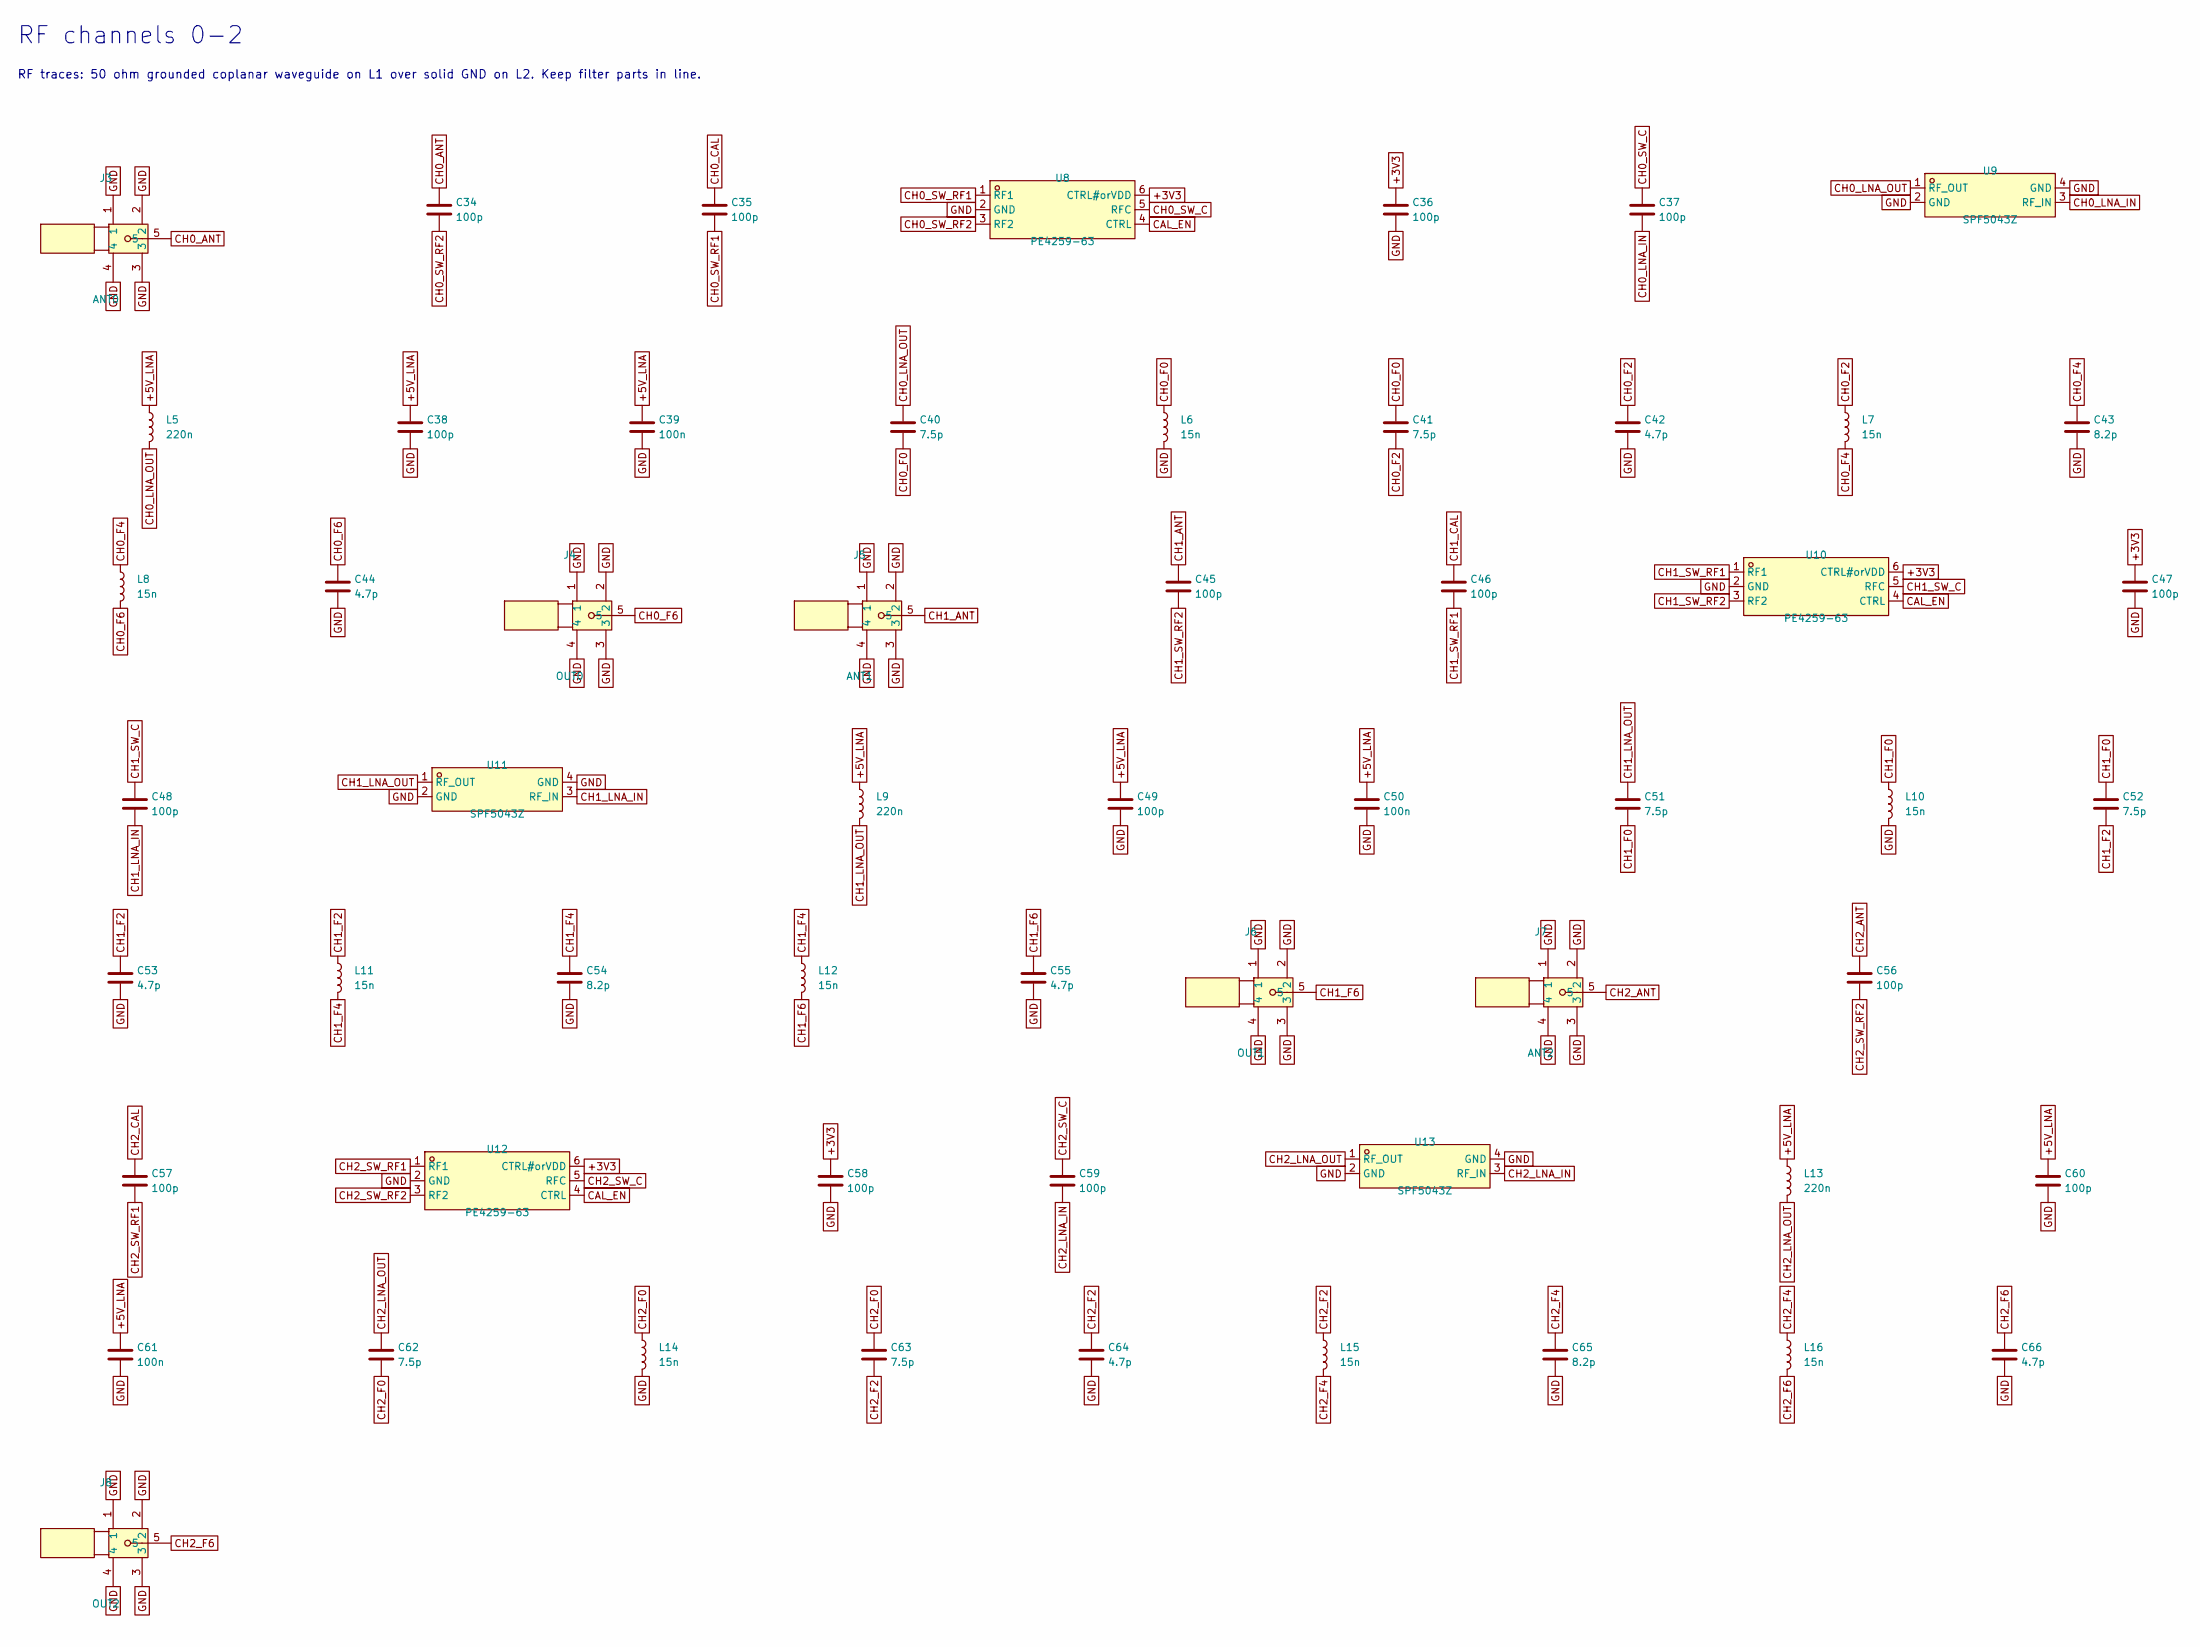
[picture p74: schematic channels_0.kicad_sch, RF channels 0-2]

Parts:
C34, C35, C36, C37, C38, C45, C46, C47, C48, C49, C56, C57, C58, C59, C60: 100p; C_0402_1005Metric
C39, C50, C61: 100n; C_0402_1005Metric; LCSC C1525
C40, C41, C51, C52, C62, C63: 7.5p; C_0402_1005Metric
C42, C44, C53, C55, C64, C66: 4.7p; C_0402_1005Metric
C43, C54, C65: 8.2p; C_0402_1005Metric
J3: ANT0; SMA-TH_BWSMA-KE-Z001; MPN BWSMA-KE-Z001; LCSC C496549
J4: OUT0; SMA-TH_BWSMA-KE-Z001; MPN BWSMA-KE-Z001; LCSC C496549
J5: ANT1; SMA-TH_BWSMA-KE-Z001; MPN BWSMA-KE-Z001; LCSC C496549
J6: OUT1; SMA-TH_BWSMA-KE-Z001; MPN BWSMA-KE-Z001; LCSC C496549
J7: ANT2; SMA-TH_BWSMA-KE-Z001; MPN BWSMA-KE-Z001; LCSC C496549
J8: OUT2; SMA-TH_BWSMA-KE-Z001; MPN BWSMA-KE-Z001; LCSC C496549
L5, L9, L13: 220n; L_0603_1608Metric
L6, L7, L8, L10, L11, L12, L14, L15, L16: 15n; L_0402_1005Metric
U8, U10, U12: PE4259-63; SC-70-6_L2.2-W1.3-P0.65-LS2.1-BL; MPN PE4259-63; LCSC C470892
U9, U11, U13: SPF5043Z; SOT343_L2.0-W1.3-P1.30-LS2.1-BL; MPN SPF5043Z; LCSC C470902

Connections:
+3V3: C36.1, C47.1, C58.1, U8.6 (CTRL#orVDD), U10.6 (CTRL#orVDD), U12.6 (CTRL#orVDD); also elsewhere on the board
+5V_LNA: C38.1, C39.1, C49.1, C50.1, C60.1, C61.1, L5.1, L9.1, L13.1; also elsewhere on the board
CAL_EN: U8.4 (CTRL), U10.4 (CTRL), U12.4 (CTRL); also elsewhere on the board
CH0_ANT: C34.1, J3.5
CH0_CAL: C35.1; also elsewhere on the board
CH0_F0: C40.2, C41.1, L6.1
CH0_F2: C41.2, C42.1, L7.1
CH0_F4: C43.1, L7.2, L8.1
CH0_F6: C44.1, J4.5, L8.2
CH0_LNA_IN: C37.2, U9.3 (RF_IN)
CH0_LNA_OUT: C40.1, L5.2, U9.1 (RF_OUT)
CH0_SW_C: C37.1, U8.5 (RFC)
CH0_SW_RF1: C35.2, U8.1 (RF1)
CH0_SW_RF2: C34.2, U8.3 (RF2)
CH1_ANT: C45.1, J5.5
CH1_CAL: C46.1; also elsewhere on the board
CH1_F0: C51.2, C52.1, L10.1
CH1_F2: C52.2, C53.1, L11.1
CH1_F4: C54.1, L11.2, L12.1
CH1_F6: C55.1, J6.5, L12.2
CH1_LNA_IN: C48.2, U11.3 (RF_IN)
CH1_LNA_OUT: C51.1, L9.2, U11.1 (RF_OUT)
CH1_SW_C: C48.1, U10.5 (RFC)
CH1_SW_RF1: C46.2, U10.1 (RF1)
CH1_SW_RF2: C45.2, U10.3 (RF2)
CH2_ANT: C56.1, J7.5
CH2_CAL: C57.1; also elsewhere on the board
CH2_F0: C62.2, C63.1, L14.1
CH2_F2: C63.2, C64.1, L15.1
CH2_F4: C65.1, L15.2, L16.1
CH2_F6: C66.1, J8.5, L16.2
CH2_LNA_IN: C59.2, U13.3 (RF_IN)
CH2_LNA_OUT: C62.1, L13.2, U13.1 (RF_OUT)
CH2_SW_C: C59.1, U12.5 (RFC)
CH2_SW_RF1: C57.2, U12.1 (RF1)
CH2_SW_RF2: C56.2, U12.3 (RF2)
GND: C36.2, C38.2, C39.2, C42.2, C43.2, C44.2, C47.2, C49.2, C50.2, C53.2, C54.2, C55.2, C58.2, C60.2, C61.2, C64.2, C65.2, C66.2, J3.1, J3.2, J3.3, J3.4, J4.1, J4.2, J4.3, J4.4, J5.1, J5.2, J5.3, J5.4, J6.1, J6.2, J6.3, J6.4, J7.1, J7.2, J7.3, J7.4, J8.1, J8.2, J8.3, J8.4, L6.2, L10.2, L14.2, U8.2 (GND), U9.2 (GND), U9.4 (GND), U10.2 (GND), U11.2 (GND), U11.4 (GND), U12.2 (GND), U13.2 (GND), U13.4 (GND); also elsewhere on the board

Notes on the sheet:
RF channels 0-2
RF traces: 50 ohm grounded coplanar waveguide on L1 over solid GND on L2. Keep filter parts in line.

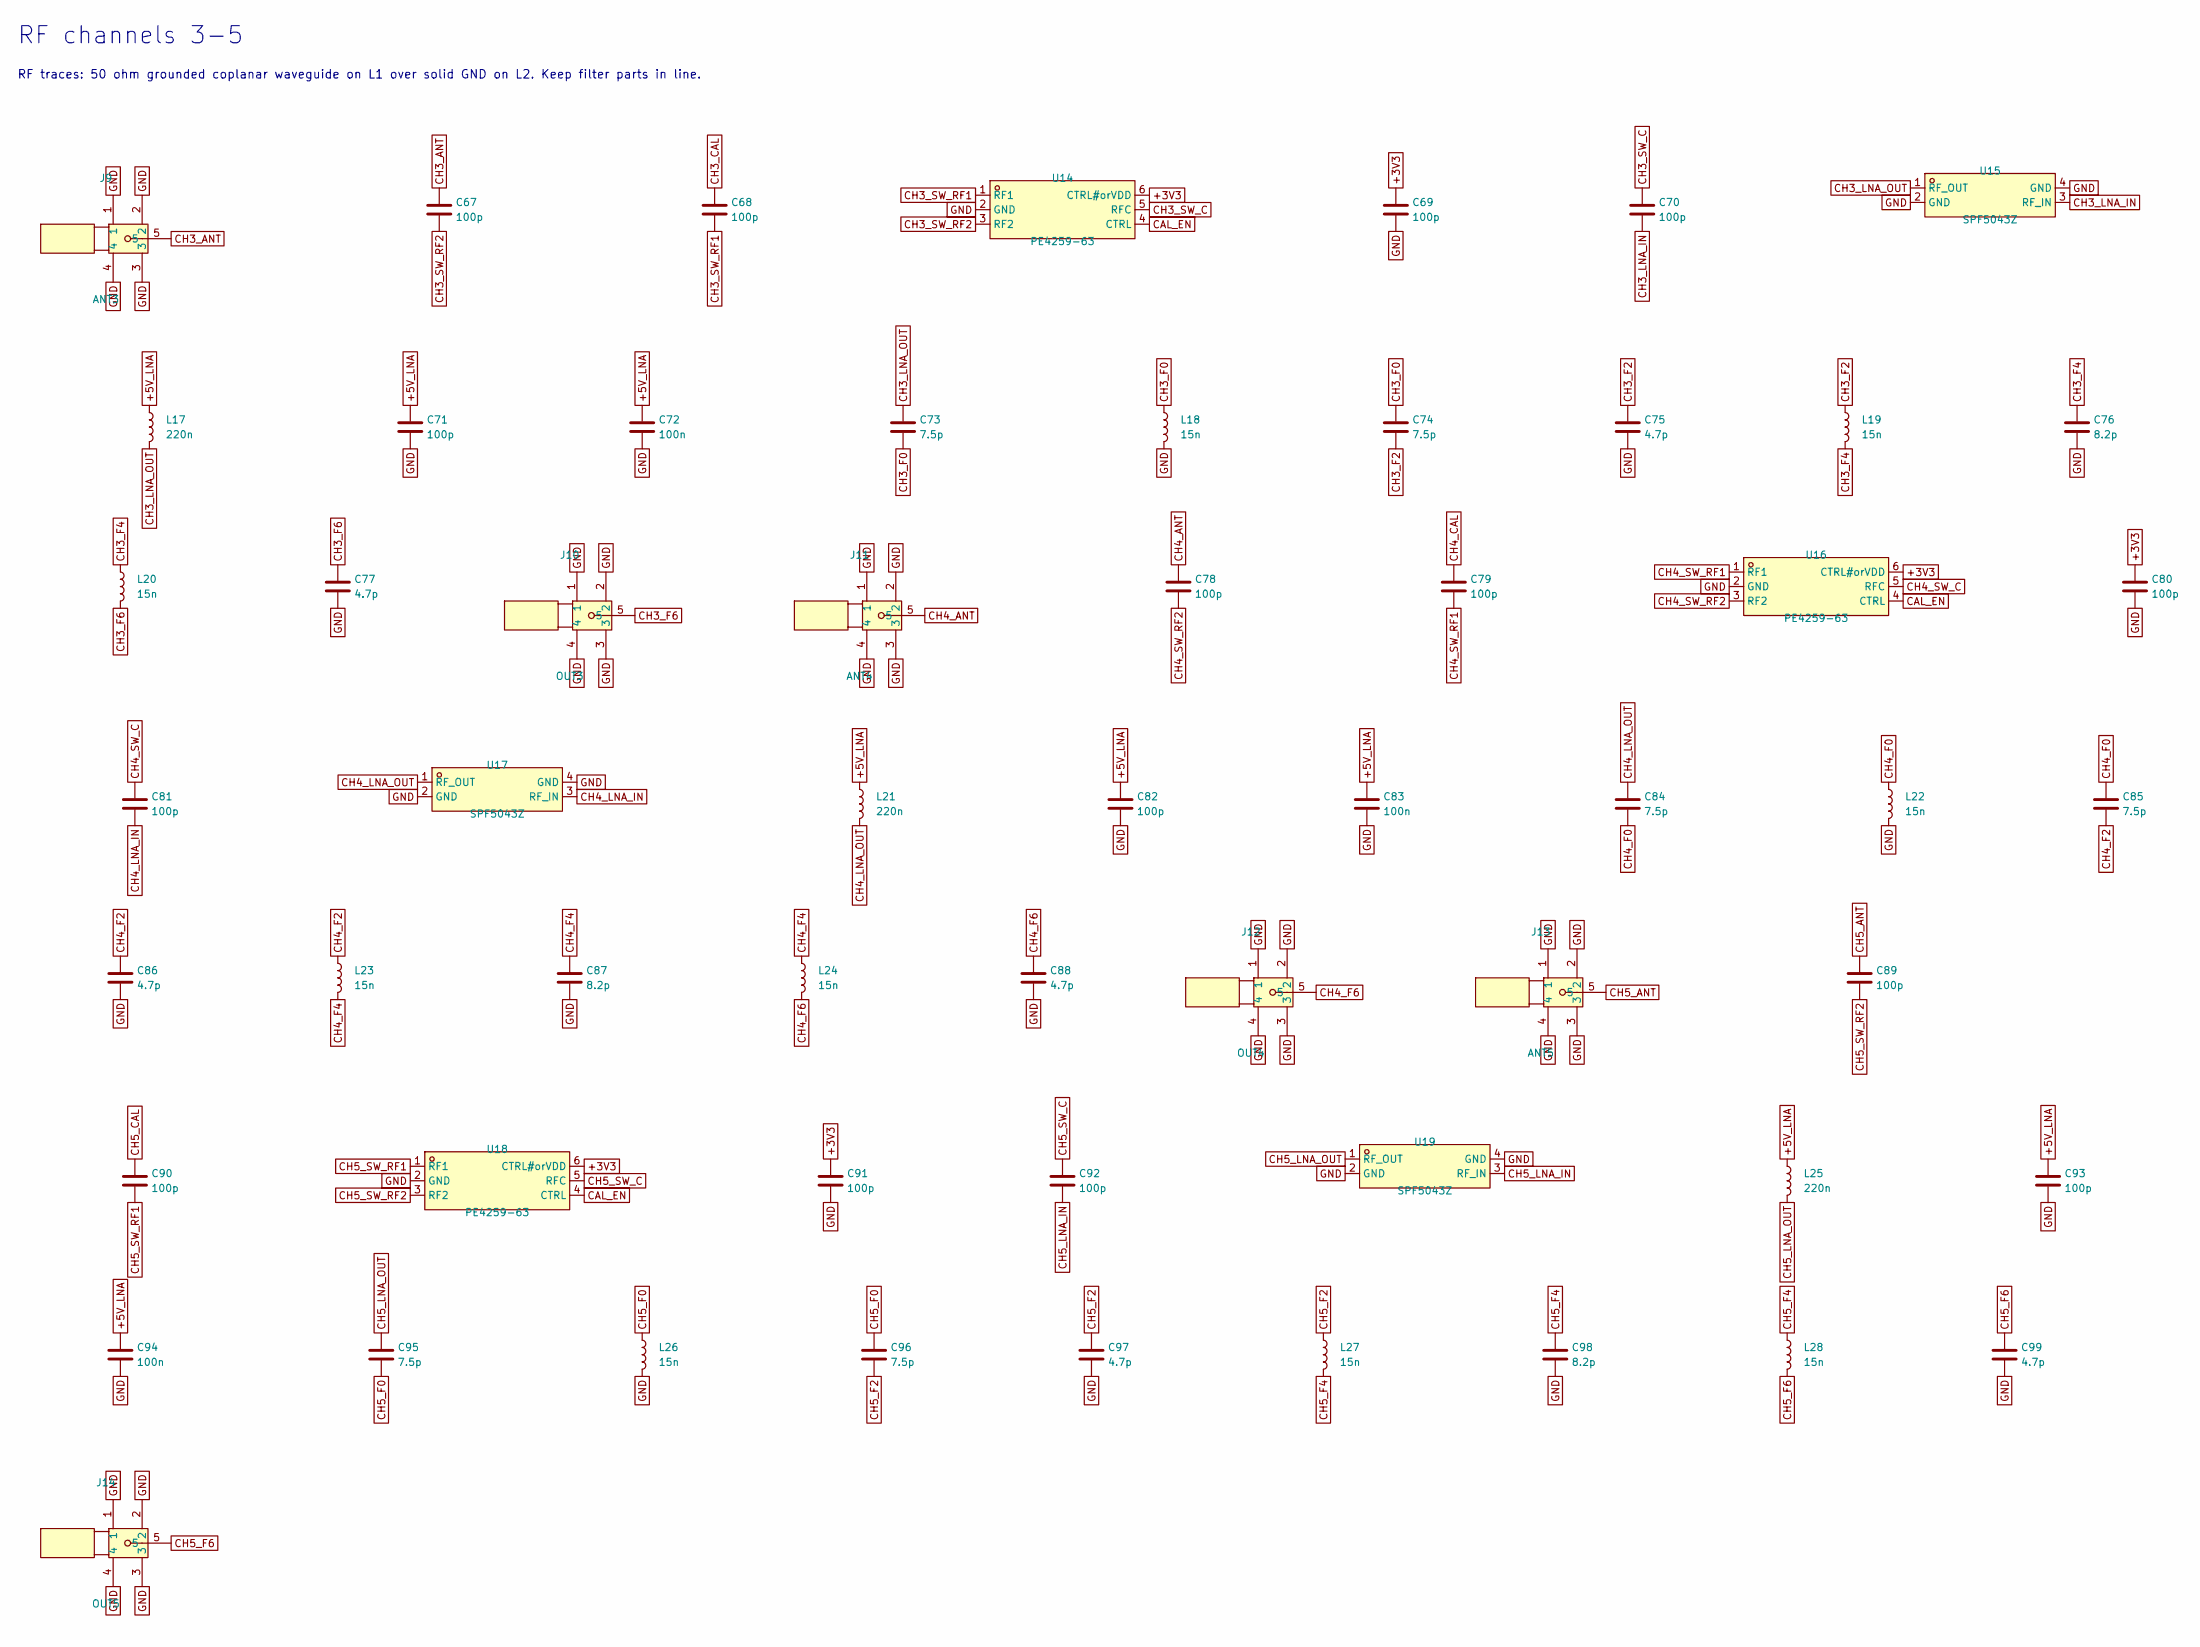
[picture p75: schematic channels_1.kicad_sch, RF channels 3-5]

Parts:
C67, C68, C69, C70, C71, C78, C79, C80, C81, C82, C89, C90, C91, C92, C93: 100p; C_0402_1005Metric
C72, C83, C94: 100n; C_0402_1005Metric; LCSC C1525
C73, C74, C84, C85, C95, C96: 7.5p; C_0402_1005Metric
C75, C77, C86, C88, C97, C99: 4.7p; C_0402_1005Metric
C76, C87, C98: 8.2p; C_0402_1005Metric
J9: ANT3; SMA-TH_BWSMA-KE-Z001; MPN BWSMA-KE-Z001; LCSC C496549
J10: OUT3; SMA-TH_BWSMA-KE-Z001; MPN BWSMA-KE-Z001; LCSC C496549
J11: ANT4; SMA-TH_BWSMA-KE-Z001; MPN BWSMA-KE-Z001; LCSC C496549
J12: OUT4; SMA-TH_BWSMA-KE-Z001; MPN BWSMA-KE-Z001; LCSC C496549
J13: ANT5; SMA-TH_BWSMA-KE-Z001; MPN BWSMA-KE-Z001; LCSC C496549
J14: OUT5; SMA-TH_BWSMA-KE-Z001; MPN BWSMA-KE-Z001; LCSC C496549
L17, L21, L25: 220n; L_0603_1608Metric
L18, L19, L20, L22, L23, L24, L26, L27, L28: 15n; L_0402_1005Metric
U14, U16, U18: PE4259-63; SC-70-6_L2.2-W1.3-P0.65-LS2.1-BL; MPN PE4259-63; LCSC C470892
U15, U17, U19: SPF5043Z; SOT343_L2.0-W1.3-P1.30-LS2.1-BL; MPN SPF5043Z; LCSC C470902

Connections:
+3V3: C69.1, C80.1, C91.1, U14.6 (CTRL#orVDD), U16.6 (CTRL#orVDD), U18.6 (CTRL#orVDD); also elsewhere on the board
+5V_LNA: C71.1, C72.1, C82.1, C83.1, C93.1, C94.1, L17.1, L21.1, L25.1; also elsewhere on the board
CAL_EN: U14.4 (CTRL), U16.4 (CTRL), U18.4 (CTRL); also elsewhere on the board
CH3_ANT: C67.1, J9.5
CH3_CAL: C68.1; also elsewhere on the board
CH3_F0: C73.2, C74.1, L18.1
CH3_F2: C74.2, C75.1, L19.1
CH3_F4: C76.1, L19.2, L20.1
CH3_F6: C77.1, J10.5, L20.2
CH3_LNA_IN: C70.2, U15.3 (RF_IN)
CH3_LNA_OUT: C73.1, L17.2, U15.1 (RF_OUT)
CH3_SW_C: C70.1, U14.5 (RFC)
CH3_SW_RF1: C68.2, U14.1 (RF1)
CH3_SW_RF2: C67.2, U14.3 (RF2)
CH4_ANT: C78.1, J11.5
CH4_CAL: C79.1; also elsewhere on the board
CH4_F0: C84.2, C85.1, L22.1
CH4_F2: C85.2, C86.1, L23.1
CH4_F4: C87.1, L23.2, L24.1
CH4_F6: C88.1, J12.5, L24.2
CH4_LNA_IN: C81.2, U17.3 (RF_IN)
CH4_LNA_OUT: C84.1, L21.2, U17.1 (RF_OUT)
CH4_SW_C: C81.1, U16.5 (RFC)
CH4_SW_RF1: C79.2, U16.1 (RF1)
CH4_SW_RF2: C78.2, U16.3 (RF2)
CH5_ANT: C89.1, J13.5
CH5_CAL: C90.1; also elsewhere on the board
CH5_F0: C95.2, C96.1, L26.1
CH5_F2: C96.2, C97.1, L27.1
CH5_F4: C98.1, L27.2, L28.1
CH5_F6: C99.1, J14.5, L28.2
CH5_LNA_IN: C92.2, U19.3 (RF_IN)
CH5_LNA_OUT: C95.1, L25.2, U19.1 (RF_OUT)
CH5_SW_C: C92.1, U18.5 (RFC)
CH5_SW_RF1: C90.2, U18.1 (RF1)
CH5_SW_RF2: C89.2, U18.3 (RF2)
GND: C69.2, C71.2, C72.2, C75.2, C76.2, C77.2, C80.2, C82.2, C83.2, C86.2, C87.2, C88.2, C91.2, C93.2, C94.2, C97.2, C98.2, C99.2, J9.1, J9.2, J9.3, J9.4, J10.1, J10.2, J10.3, J10.4, J11.1, J11.2, J11.3, J11.4, J12.1, J12.2, J12.3, J12.4, J13.1, J13.2, J13.3, J13.4, J14.1, J14.2, J14.3, J14.4, L18.2, L22.2, L26.2, U14.2 (GND), U15.2 (GND), U15.4 (GND), U16.2 (GND), U17.2 (GND), U17.4 (GND), U18.2 (GND), U19.2 (GND), U19.4 (GND); also elsewhere on the board

Notes on the sheet:
RF channels 3-5
RF traces: 50 ohm grounded coplanar waveguide on L1 over solid GND on L2. Keep filter parts in line.

Board: 4 copper layers, 194 parts (0 on the bottom side), 98 nets, no tracks yet.
