ajisrawi/passive-radar-counter-drone/hardware/board_c/board_c.kicad_pcb

## KiCad design hardware/board_c/board_c.kicad_pcb (2026-10-28)

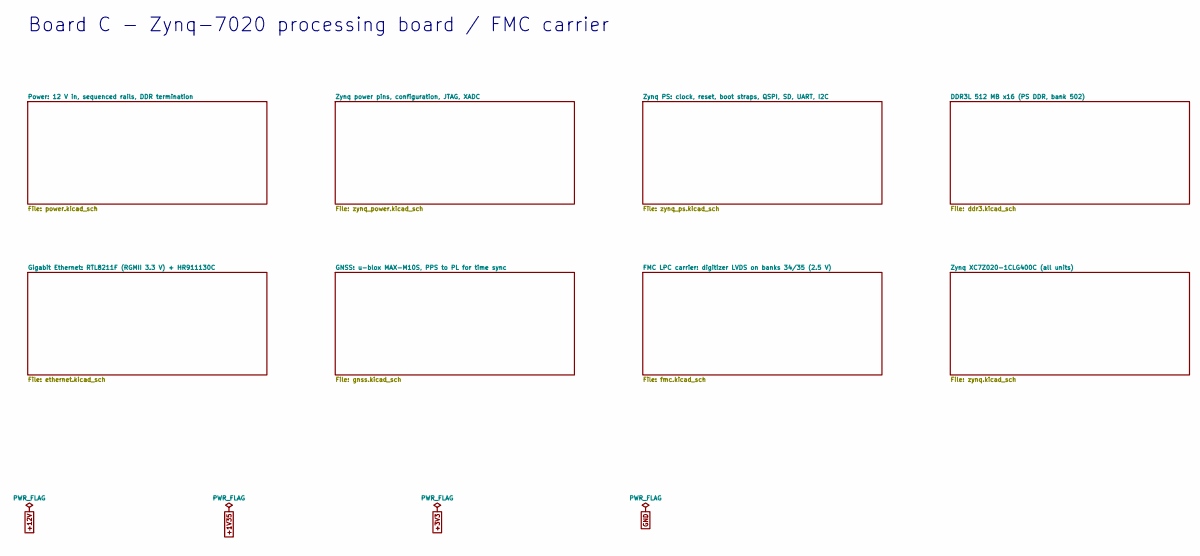
[picture p76: schematic board_c.kicad_sch, Board C - Zynq-7020 processing board / FMC carrier]

Notes on the sheet:
Board C - Zynq-7020 processing board / FMC carrier
