ajisrawi/passive-radar-counter-drone/hardware/board_c/board_c.kicad_pcb

## KiCad design hardware/board_c/board_c.kicad_pcb (continued)

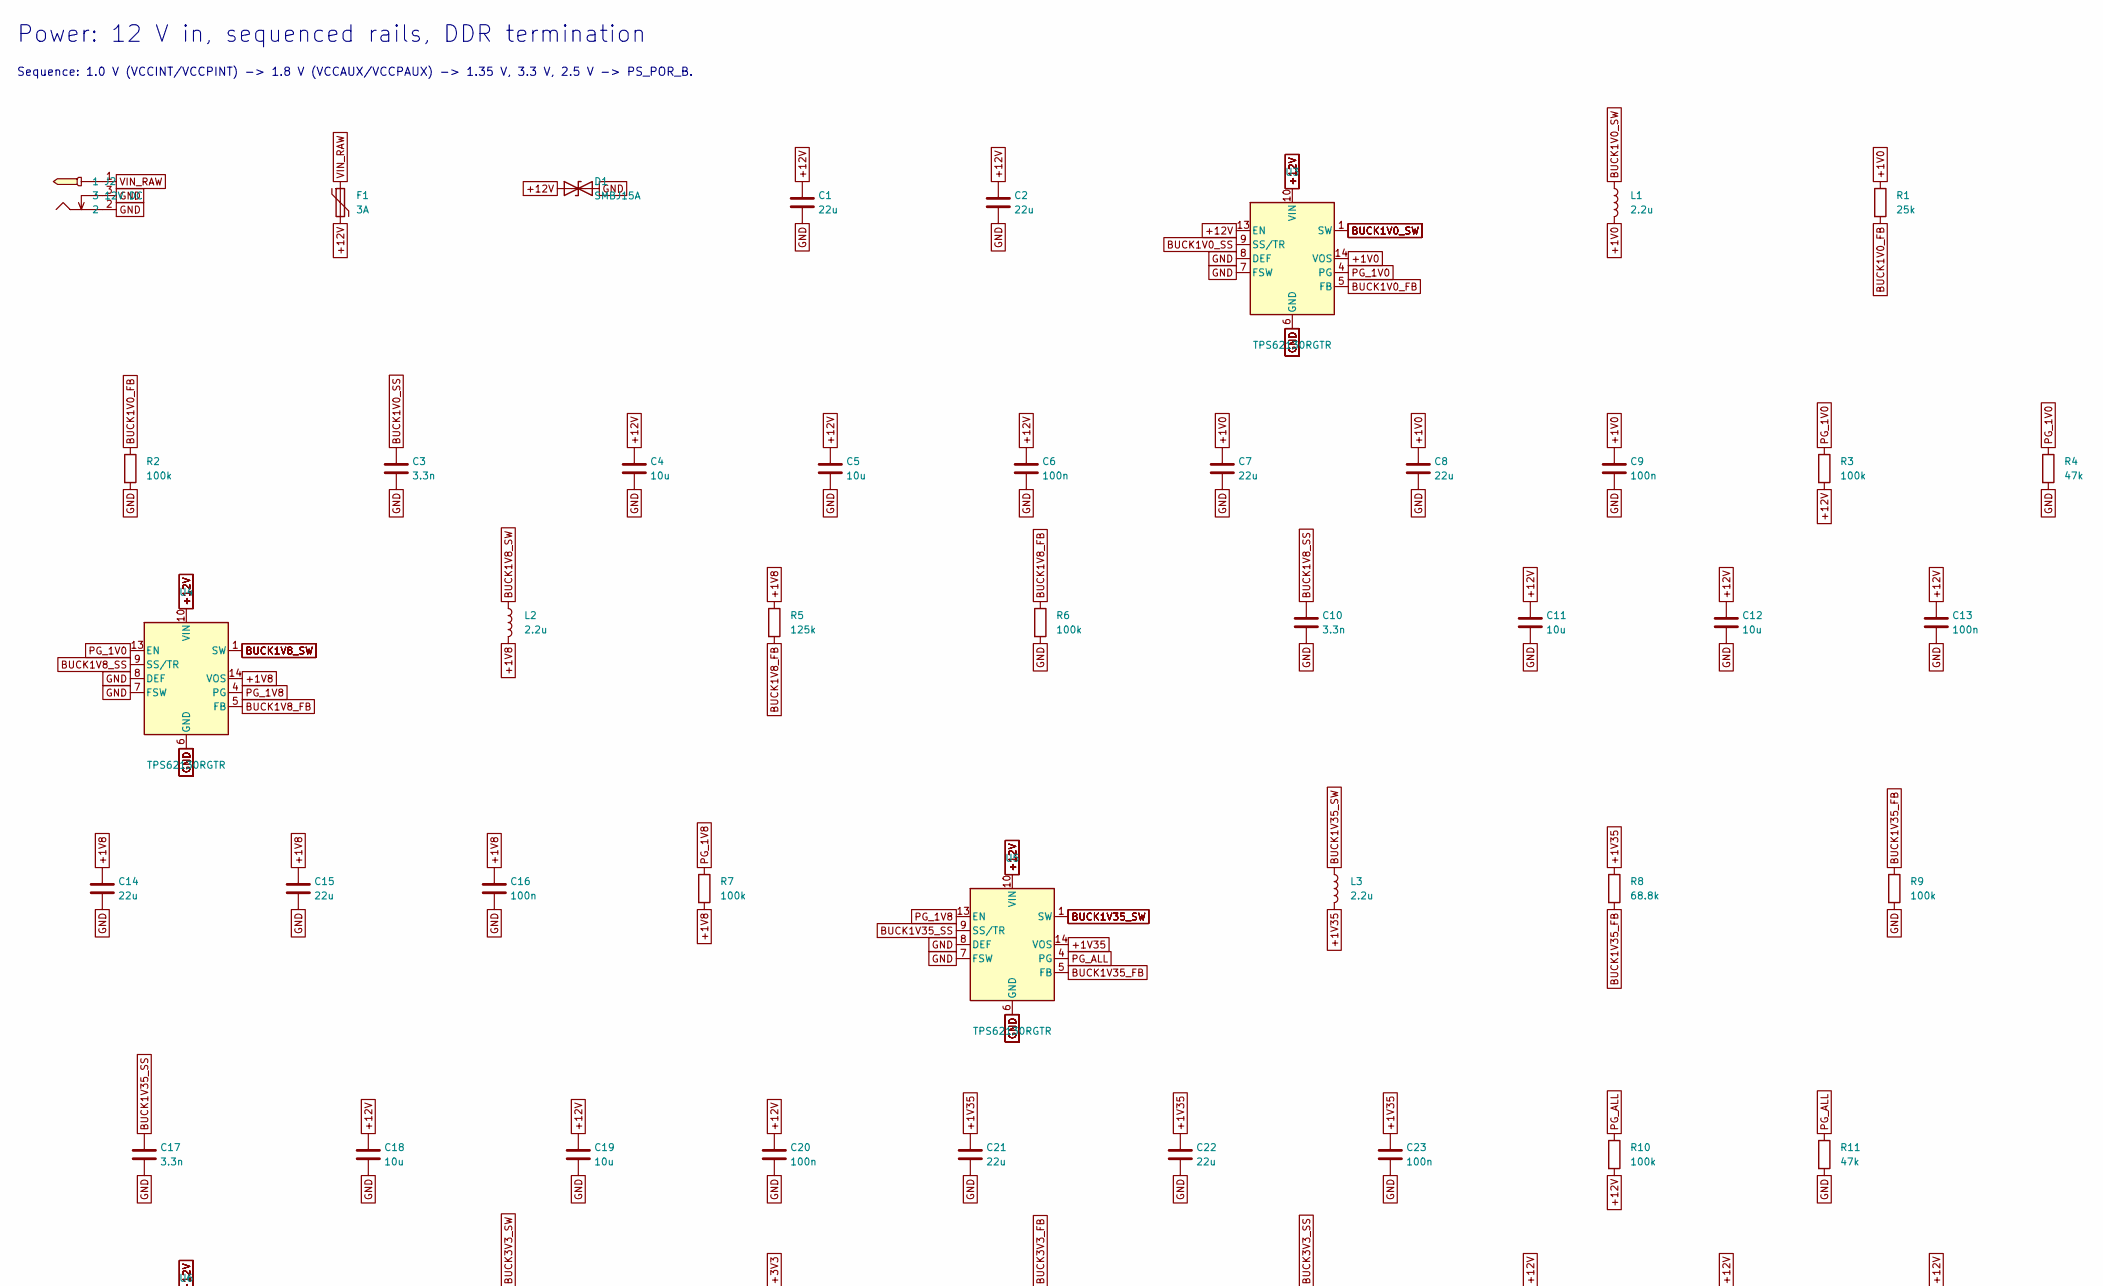
[picture p77: schematic power.kicad_sch, Power: 12 V in, sequenced rails, DDR termination, part in row 1, column 1]

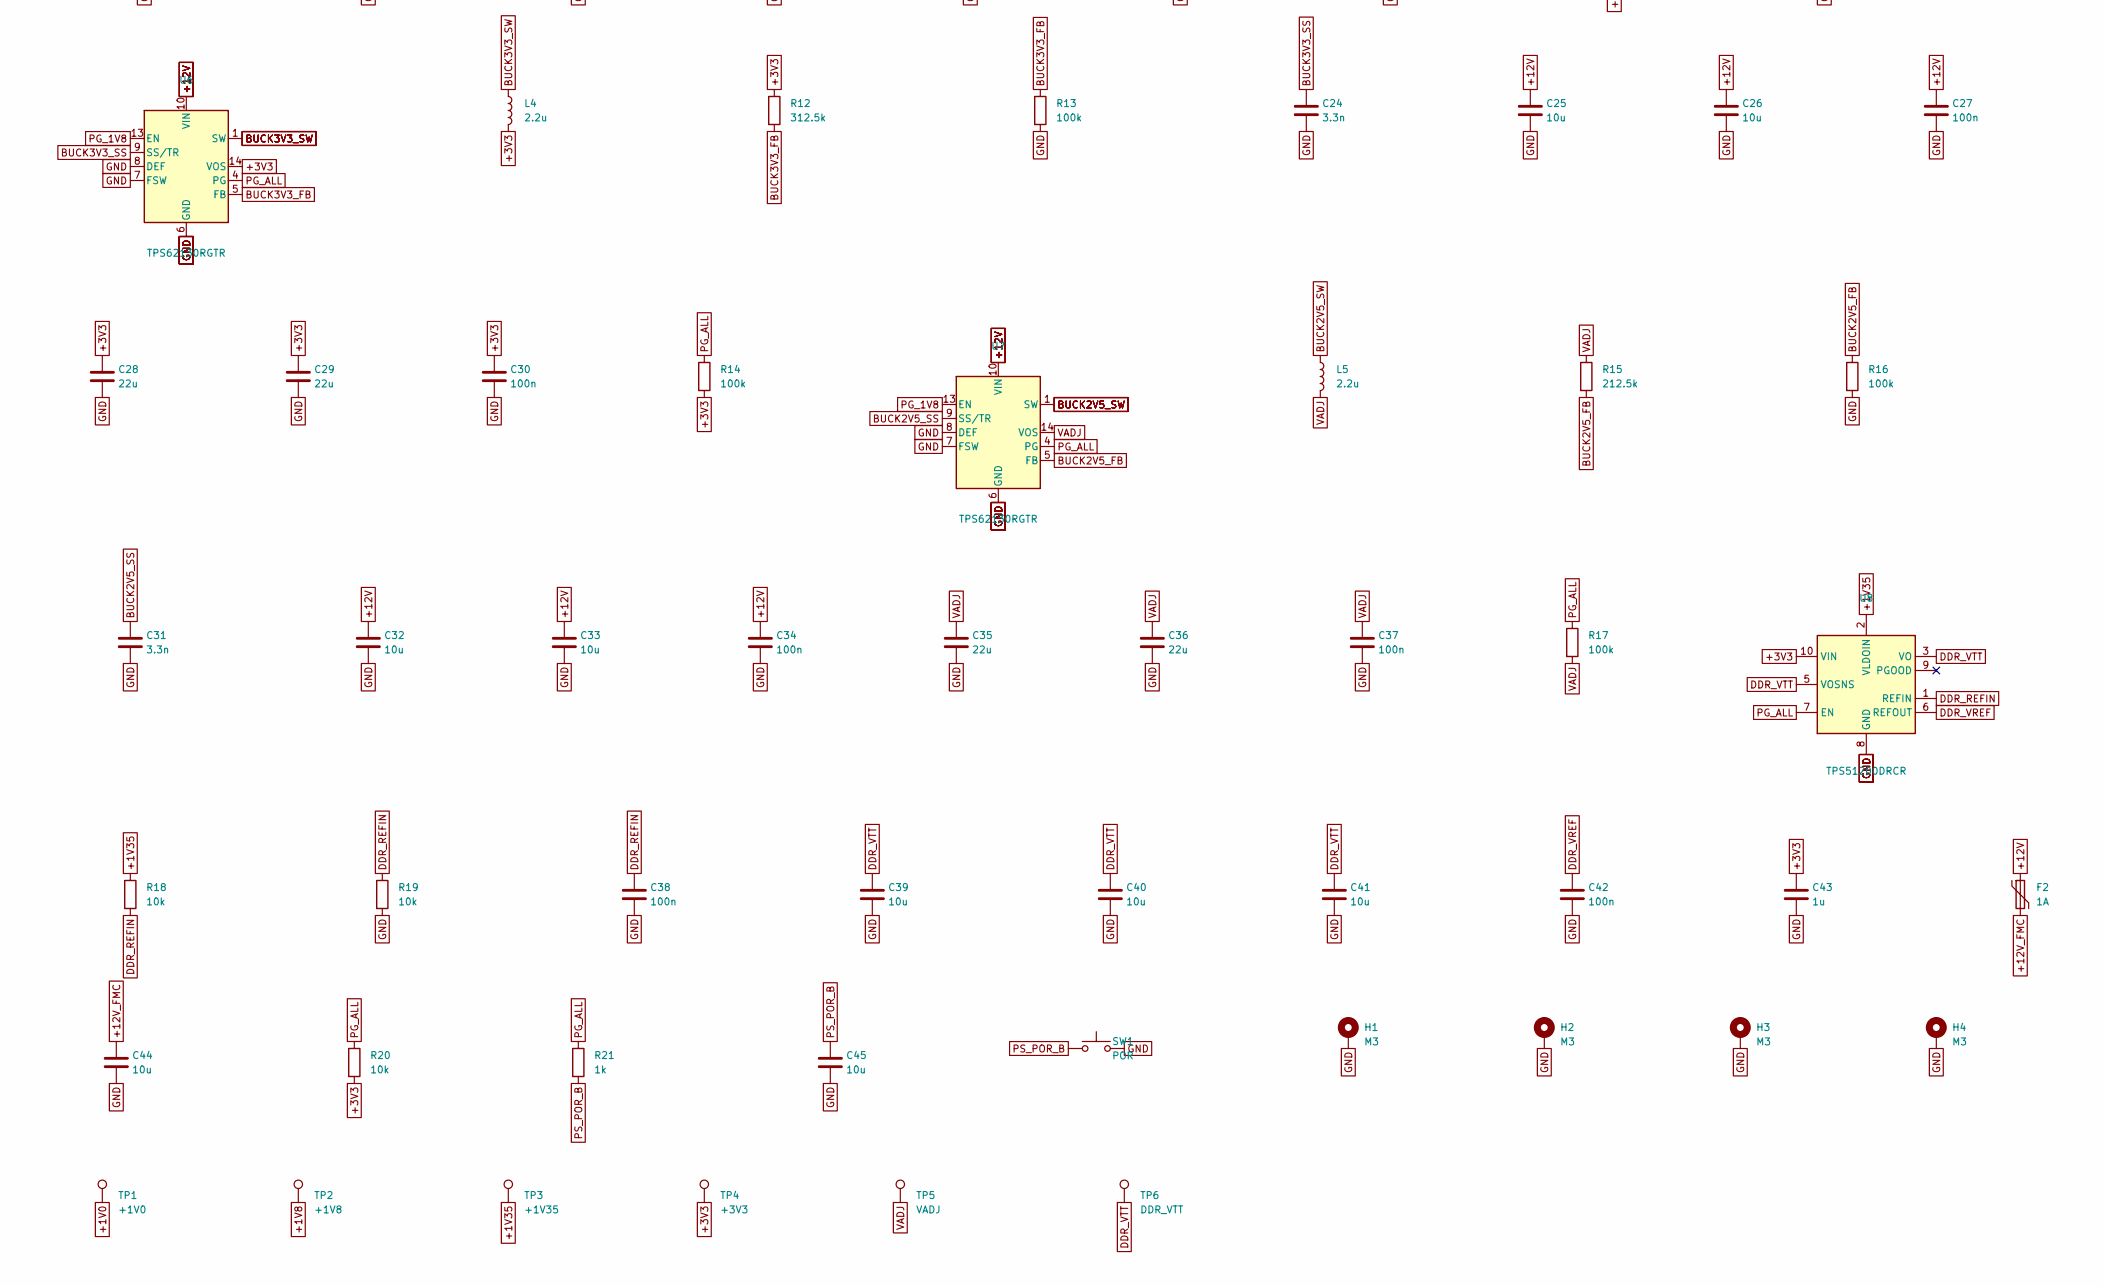
[picture p78: schematic power.kicad_sch, Power: 12 V in, sequenced rails, DDR termination, part in row 2, column 1]

Parts:
C1, C2: 22u; C_1206_3216Metric
C3, C10, C17, C24, C31: 3.3n; C_0402_1005Metric
C4, C5, C11, C12, C18, C19, C25, C26, C32, C33, C44: 10u; C_0805_2012Metric
C6, C9, C13, C16, C20, C23, C27, C30, C34, C37, C38, C42: 100n; C_0402_1005Metric; LCSC C1525
C7, C8, C14, C15, C21, C22, C28, C29, C35, C36: 22u; C_0805_2012Metric; LCSC C45783
C39, C40, C41, C45: 10u; C_0603_1608Metric; LCSC C19702
C43: 1u; C_0402_1005Metric; LCSC C52923
D1: SMBJ15A; D_SMB
F1: 3A; Fuse_1206_3216Metric
F2: 1A; Fuse_1206_3216Metric
H1, H2, H3, H4: M3; MountingHole_3.2mm_M3_Pad_Via
J2: 12V DC; DC-IN-TH_DC-005C-20A; MPN DC-005C-20A; LCSC C84007
L1, L2, L3, L4, L5: 2.2u; L_Bourns-SRN4018; MPN SRN4018-2R2M
R1: 25k; R_0402_1005Metric
R2, R3, R6, R7, R9, R10, R13, R14, R16, R17: 100k; R_0402_1005Metric; LCSC C25741
R4, R11: 47k; R_0402_1005Metric
R5: 125k; R_0402_1005Metric
R8: 68.8k; R_0402_1005Metric
R12: 312.5k; R_0402_1005Metric
R15: 212.5k; R_0402_1005Metric
R18, R19: 10k; R_0402_1005Metric; Tolerance 1%; LCSC C25744
R20: 10k; R_0402_1005Metric; LCSC C25744
R21: 1k; R_0402_1005Metric; LCSC C11702
SW1: POR; SW_SPST_TL3342
TP1: +1V0; TestPoint_Pad_D1.0mm
TP2: +1V8; TestPoint_Pad_D1.0mm
TP3: +1V35; TestPoint_Pad_D1.0mm
TP4: +3V3; TestPoint_Pad_D1.0mm
TP5: VADJ; TestPoint_Pad_D1.0mm
TP6: DDR_VTT; TestPoint_Pad_D1.0mm
U3, U4, U5, U6, U7: TPS62130RGTR; VQFN-16-1EP_3x3mm_P0.5mm_EP1.68x1.68mm; MPN TPS62130RGTR; LCSC C43590
U8: TPS51200DRCR; VSON-10-1EP_3x3mm_P0.5mm_EP1.65x2.4mm; LCSC C34771

Connections:
+1V0: C7.1, C8.1, C9.1, L1.2, R1.1, TP1.1, U3.14 (VOS); also elsewhere on the board
+1V8: C14.1, C15.1, C16.1, L2.2, R5.1, R7.2, TP2.1, U4.14 (VOS); also elsewhere on the board
+1V35: C21.1, C22.1, C23.1, L3.2, R8.1, R18.1, TP3.1, U5.14 (VOS), U8.2 (VLDOIN); also elsewhere on the board
+3V3: C28.1, C29.1, C30.1, C43.1, L4.2, R12.1, R14.2, R20.2, TP4.1, U6.14 (VOS), U8.10 (VIN); also elsewhere on the board
+12V: C1.1, C2.1, C4.1, C5.1, C6.1, C11.1, C12.1, C13.1, C18.1, C19.1, C20.1, C25.1, C26.1, C27.1, C32.1, C33.1, C34.1, D1.1 (A1), F1.2, F2.1, R3.2, R10.2, U3.10 (VIN), U3.11 (VIN), U3.12 (VIN), U3.13 (EN), U4.10 (VIN), U4.11 (VIN), U4.12 (VIN), U5.10 (VIN), U5.11 (VIN), U5.12 (VIN), U6.10 (VIN), U6.11 (VIN), U6.12 (VIN), U7.10 (VIN), U7.11 (VIN), U7.12 (VIN)
+12V_FMC: C44.1, F2.2; also elsewhere on the board
BUCK1V0_FB: R1.2, R2.1, U3.5 (FB)
BUCK1V0_SS: C3.1, U3.9 (SS/TR)
BUCK1V0_SW: L1.1, U3.1 (SW), U3.2 (SW), U3.3 (SW)
BUCK1V8_FB: R5.2, R6.1, U4.5 (FB)
BUCK1V8_SS: C10.1, U4.9 (SS/TR)
BUCK1V8_SW: L2.1, U4.1 (SW), U4.2 (SW), U4.3 (SW)
BUCK1V35_FB: R8.2, R9.1, U5.5 (FB)
BUCK1V35_SS: C17.1, U5.9 (SS/TR)
BUCK1V35_SW: L3.1, U5.1 (SW), U5.2 (SW), U5.3 (SW)
BUCK2V5_FB: R15.2, R16.1, U7.5 (FB)
BUCK2V5_SS: C31.1, U7.9 (SS/TR)
BUCK2V5_SW: L5.1, U7.1 (SW), U7.2 (SW), U7.3 (SW)
BUCK3V3_FB: R12.2, R13.1, U6.5 (FB)
BUCK3V3_SS: C24.1, U6.9 (SS/TR)
BUCK3V3_SW: L4.1, U6.1 (SW), U6.2 (SW), U6.3 (SW)
DDR_REFIN: C38.1, R18.2, R19.1, U8.1 (REFIN)
DDR_VREF: C42.1, U8.6 (REFOUT); also elsewhere on the board
DDR_VTT: C39.1, C40.1, C41.1, TP6.1, U8.3 (VO), U8.5 (VOSNS); also elsewhere on the board
GND: C1.2, C2.2, C3.2, C4.2, C5.2, C6.2, C7.2, C8.2, C9.2, C10.2, C11.2, C12.2, C13.2, C14.2, C15.2, C16.2, C17.2, C18.2, C19.2, C20.2, C21.2, C22.2, C23.2, C24.2, C25.2, C26.2, C27.2, C28.2, C29.2, C30.2, C31.2, C32.2, C33.2, C34.2, C35.2, C36.2, C37.2, C38.2, C39.2, C40.2, C41.2, C42.2, C43.2, C44.2, C45.2, D1.2 (A2), H1.1, H2.1, H3.1, H4.1, J2.2, J2.3, R2.2, R4.2, R6.2, R9.2, R11.2, R13.2, R16.2, R19.2, SW1.2, U3.6 (GND), U3.7 (FSW), U3.8 (DEF), U3.15 (GND), U3.16 (GND), U3.17 (GND), U4.6 (GND), U4.7 (FSW), U4.8 (DEF), U4.15 (GND), U4.16 (GND), U4.17 (GND), U5.6 (GND), U5.7 (FSW), U5.8 (DEF), U5.15 (GND), U5.16 (GND), U5.17 (GND), U6.6 (GND), U6.7 (FSW), U6.8 (DEF), U6.15 (GND), U6.16 (GND), U6.17 (GND), U7.6 (GND), U7.7 (FSW), U7.8 (DEF), U7.15 (GND), U7.16 (GND), U7.17 (GND), U8.4 (GND), U8.8 (GND), U8.11 (GND); also elsewhere on the board
PG_1V0: R3.1, R4.1, U3.4 (PG), U4.13 (EN)
PG_1V8: R7.1, U4.4 (PG), U5.13 (EN), U6.13 (EN), U7.13 (EN)
PG_ALL: R10.1, R11.1, R14.1, R17.1, R20.1, R21.1, U5.4 (PG), U6.4 (PG), U7.4 (PG), U8.7 (EN); also elsewhere on the board
PS_POR_B: C45.1, R21.2, SW1.1; also elsewhere on the board
VADJ: C35.1, C36.1, C37.1, L5.2, R15.1, R17.2, TP5.1, U7.14 (VOS); also elsewhere on the board
VIN_RAW: F1.1, J2.1

Notes on the sheet:
Power: 12 V in, sequenced rails, DDR termination
Sequence: 1.0 V (VCCINT/VCCPINT) -> 1.8 V (VCCAUX/VCCPAUX) -> 1.35 V, 3.3 V, 2.5 V -> PS_POR_B.

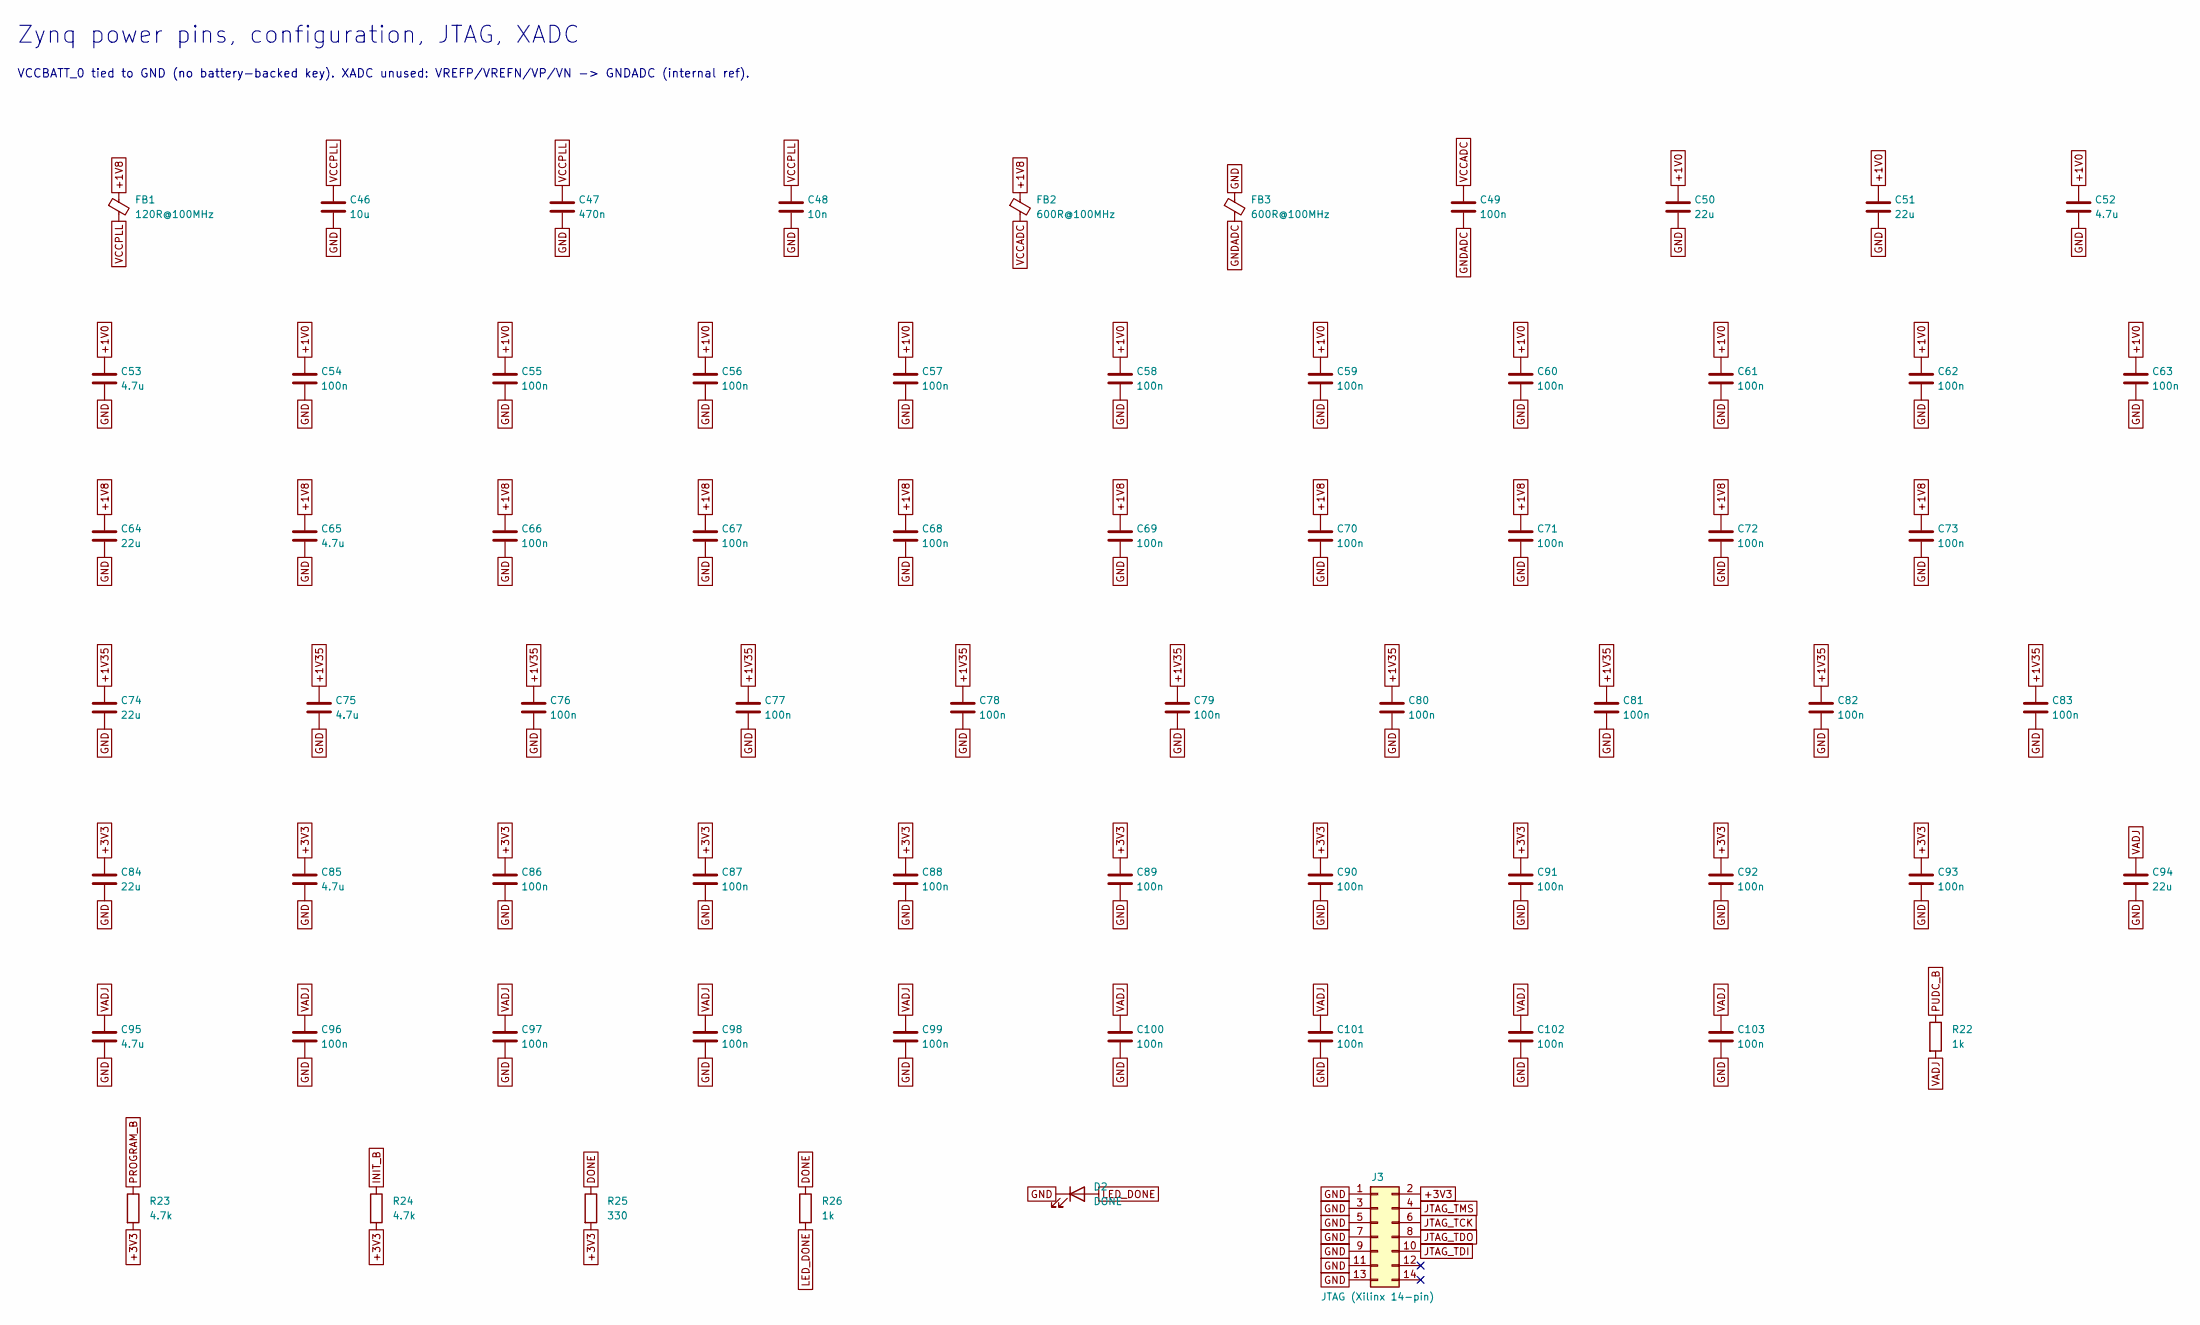
[picture p79: schematic zynq_power.kicad_sch, Zynq power pins, configuration, JTAG, XADC]

Parts:
C46: 10u; C_0603_1608Metric; LCSC C19702
C47: 470n; C_0402_1005Metric
C48: 10n; C_0402_1005Metric; LCSC C15195
C49, C54, C55, C56, C57, C58, C59, C60, C61, C62, C63, C66, C67, C68, C69, C70, C71, C72, C73, C76, C77, C78, C79, C80, C81, C82, C83, C86, C87, C88, C89, C90, C91, C92, C93, C96, C97, C98, C99, C100, C101, C102, C103: 100n; C_0402_1005Metric; LCSC C1525
C50, C51, C64, C74, C84, C94: 22u; C_0805_2012Metric; LCSC C45783
C52, C53, C65, C75, C85, C95: 4.7u; C_0603_1608Metric
D2: DONE; LED_0603_1608Metric
FB1: 120R@100MHz; L_0603_1608Metric
FB2, FB3: 600R@100MHz; L_0603_1608Metric
J3: JTAG (Xilinx 14-pin); PinHeader_2x07_P2.00mm_Vertical
R22, R26: 1k; R_0402_1005Metric; LCSC C11702
R23, R24: 4.7k; R_0402_1005Metric; LCSC C25900
R25: 330; R_0402_1005Metric

Connections:
+1V0: C50.1, C51.1, C52.1, C53.1, C54.1, C55.1, C56.1, C57.1, C58.1, C59.1, C60.1, C61.1, C62.1, C63.1; also elsewhere on the board
+1V8: C64.1, C65.1, C66.1, C67.1, C68.1, C69.1, C70.1, C71.1, C72.1, C73.1, FB1.1, FB2.1; also elsewhere on the board
+1V35: C74.1, C75.1, C76.1, C77.1, C78.1, C79.1, C80.1, C81.1, C82.1, C83.1; also elsewhere on the board
+3V3: C84.1, C85.1, C86.1, C87.1, C88.1, C89.1, C90.1, C91.1, C92.1, C93.1, J3.2, R23.2, R24.2, R25.2; also elsewhere on the board
DONE: R25.1, R26.1; also elsewhere on the board
GND: C46.2, C47.2, C48.2, C50.2, C51.2, C52.2, C53.2, C54.2, C55.2, C56.2, C57.2, C58.2, C59.2, C60.2, C61.2, C62.2, C63.2, C64.2, C65.2, C66.2, C67.2, C68.2, C69.2, C70.2, C71.2, C72.2, C73.2, C74.2, C75.2, C76.2, C77.2, C78.2, C79.2, C80.2, C81.2, C82.2, C83.2, C84.2, C85.2, C86.2, C87.2, C88.2, C89.2, C90.2, C91.2, C92.2, C93.2, C94.2, C95.2, C96.2, C97.2, C98.2, C99.2, C100.2, C101.2, C102.2, C103.2, D2.1 (K), FB3.1, J3.1, J3.3, J3.5, J3.7, J3.9, J3.11, J3.13; also elsewhere on the board
GNDADC: C49.2, FB3.2; also elsewhere on the board
INIT_B: R24.1; also elsewhere on the board
JTAG_TCK: J3.6; also elsewhere on the board
JTAG_TDI: J3.10; also elsewhere on the board
JTAG_TDO: J3.8; also elsewhere on the board
JTAG_TMS: J3.4; also elsewhere on the board
LED_DONE: D2.2 (A), R26.2
PROGRAM_B: R23.1; also elsewhere on the board
PUDC_B: R22.1; also elsewhere on the board
VADJ: C94.1, C95.1, C96.1, C97.1, C98.1, C99.1, C100.1, C101.1, C102.1, C103.1, R22.2; also elsewhere on the board
VCCADC: C49.1, FB2.2; also elsewhere on the board
VCCPLL: C46.1, C47.1, C48.1, FB1.2; also elsewhere on the board

Notes on the sheet:
Zynq power pins, configuration, JTAG, XADC
VCCBATT_0 tied to GND (no battery-backed key). XADC unused: VREFP/VREFN/VP/VN -> GNDADC (internal ref).

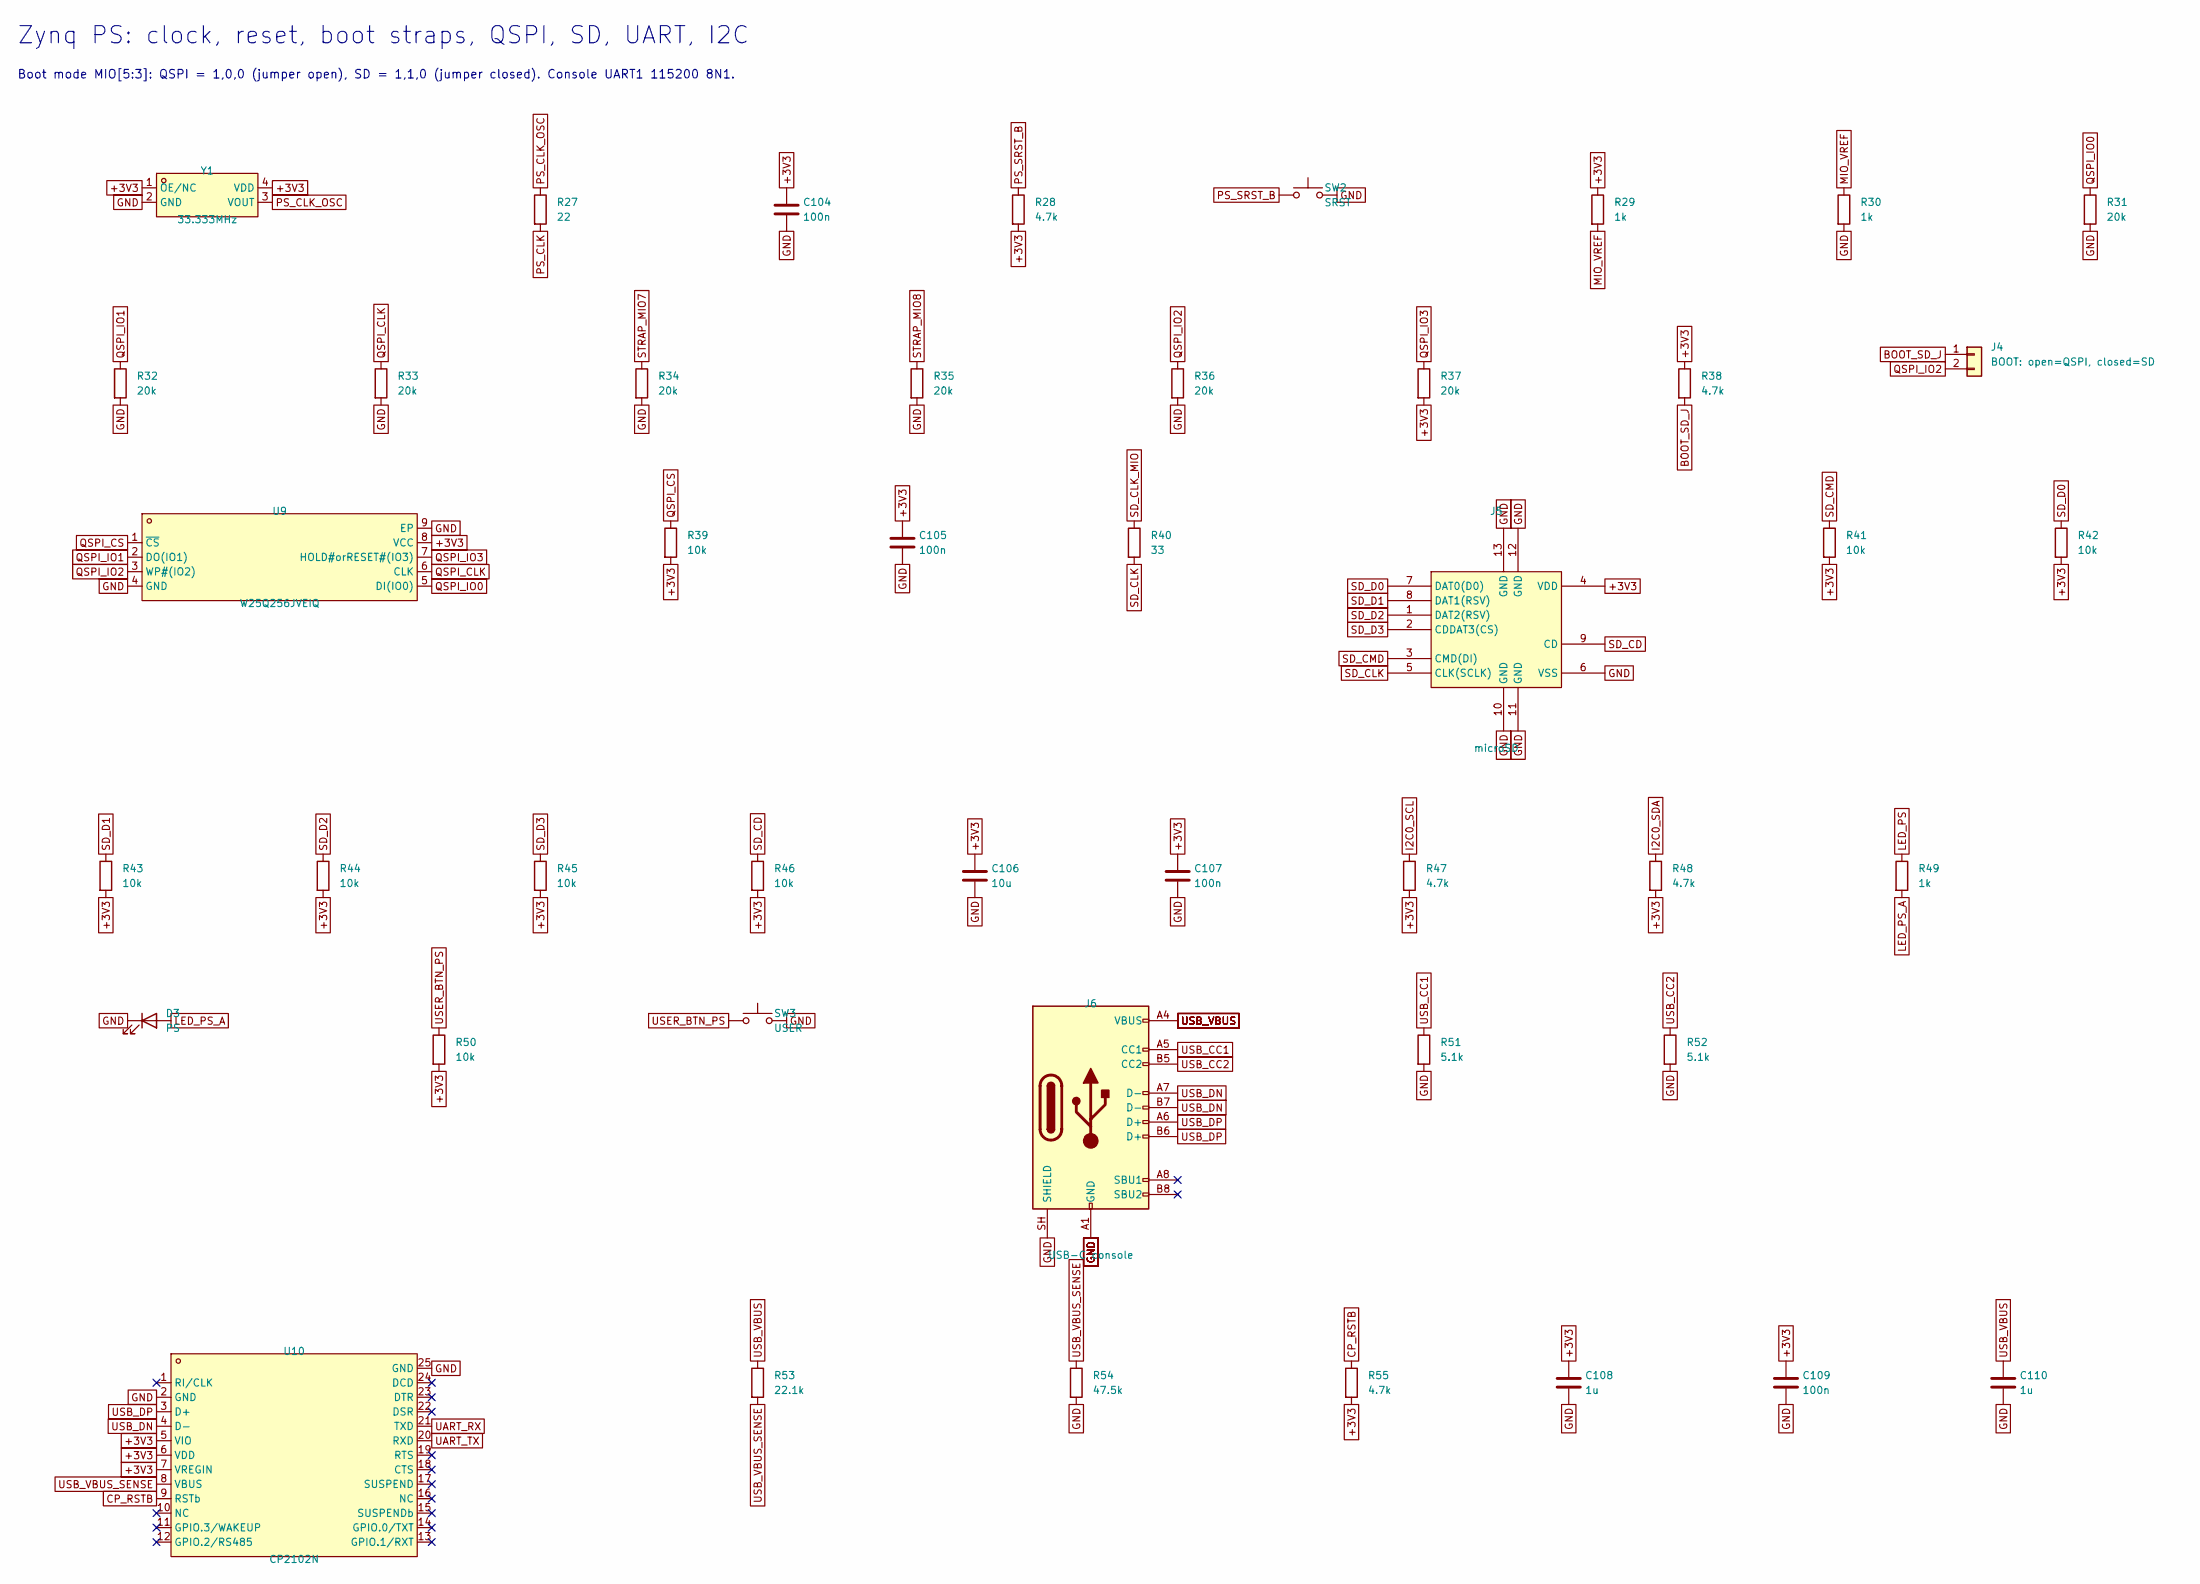
[picture p80: schematic zynq_ps.kicad_sch, Zynq PS: clock, reset, boot straps, QSPI, SD, UART, I2C]

Parts:
C104, C105, C107, C109: 100n; C_0402_1005Metric; LCSC C1525
C106: 10u; C_0603_1608Metric; LCSC C19702
C108, C110: 1u; C_0402_1005Metric; LCSC C52923
D3: PS; LED_0603_1608Metric
J4: BOOT: open=QSPI, closed=SD; PinHeader_1x02_P2.54mm_Vertical
J5: microSD; TF-SMD_TF-01A; MPN TF-01A; LCSC C91145
J6: USB-C console; USB_C_Receptacle_HRO_TYPE-C-31-M-12; LCSC C165948
R27: 22; R_0402_1005Metric
R28, R38, R47, R48, R55: 4.7k; R_0402_1005Metric; LCSC C25900
R29, R30, R49: 1k; R_0402_1005Metric; LCSC C11702
R31, R32, R33, R34, R35, R36, R37: 20k; R_0402_1005Metric
R39, R41, R42, R43, R44, R45, R46, R50: 10k; R_0402_1005Metric; LCSC C25744
R40: 33; R_0402_1005Metric
R51, R52: 5.1k; R_0402_1005Metric; LCSC C25905
R53: 22.1k; R_0402_1005Metric
R54: 47.5k; R_0402_1005Metric
SW2: SRST; SW_SPST_TL3342
SW3: USER; SW_SPST_TL3342
U9: W25Q256JVEIQ; WSON-8_L8.0-W6.10-P1.27-BL-EP; MPN W25Q256JVEIQ; LCSC C97522
U10: CP2102N; QFN-24_L4.0-W4.0-P0.50-TL-EP2.6; MPN CP2102N-A02-GQFN24R; LCSC C969151
Y1: 33.333MHz; OSC-SMD_4P-L5.0-W3.2-BL_OG8EL89CEI; MPN OG1EL89CEI-112YLC-33.333M; LCSC C5346412

Connections:
+3V3: C104.1, C105.1, C106.1, C107.1, C108.1, C109.1, J5.4 (VDD), R28.2, R29.1, R37.2, R38.1, R39.2, R41.2, R42.2, R43.2, R44.2, R45.2, R46.2, R47.2, R48.2, R50.2, R55.2, U9.8 (VCC), U10.5 (VIO), U10.6 (VDD), U10.7 (VREGIN), Y1.1 (OE/NC), Y1.4 (VDD); also elsewhere on the board
BOOT_SD_J: J4.1, R38.2
CP_RSTB: R55.1, U10.9 (RSTb)
GND: C104.2, C105.2, C106.2, C107.2, C108.2, C109.2, C110.2, D3.1 (K), J5.6 (VSS), J5.10 (GND), J5.11 (GND), J5.12 (GND), J5.13 (GND), J6.A1 (GND), J6.A12 (GND), J6.B1 (GND), J6.B12 (GND), J6.SH (SHIELD), R30.2, R31.2, R32.2, R33.2, R34.2, R35.2, R36.2, R51.2, R52.2, R54.2, SW2.2, SW3.2, U9.4 (GND), U9.9 (EP), U10.2 (GND), U10.25 (GND), Y1.2 (GND); also elsewhere on the board
I2C0_SCL: R47.1; also elsewhere on the board
I2C0_SDA: R48.1; also elsewhere on the board
LED_PS: R49.1; also elsewhere on the board
LED_PS_A: D3.2 (A), R49.2
MIO_VREF: R29.2, R30.1; also elsewhere on the board
PS_CLK: R27.2; also elsewhere on the board
PS_CLK_OSC: R27.1, Y1.3 (VOUT)
PS_SRST_B: R28.1, SW2.1; also elsewhere on the board
QSPI_CLK: R33.1, U9.6 (CLK); also elsewhere on the board
QSPI_CS: R39.1, U9.1 (~CS); also elsewhere on the board
QSPI_IO0: R31.1, U9.5 (DI(IO0)); also elsewhere on the board
QSPI_IO1: R32.1, U9.2 (DO(IO1)); also elsewhere on the board
QSPI_IO2: J4.2, R36.1, U9.3 (WP#(IO2)); also elsewhere on the board
QSPI_IO3: R37.1, U9.7 (HOLD#orRESET#(IO3)); also elsewhere on the board
SD_CD: J5.9 (CD), R46.1; also elsewhere on the board
SD_CLK: J5.5 (CLK(SCLK)), R40.2
SD_CLK_MIO: R40.1; also elsewhere on the board
SD_CMD: J5.3 (CMD(DI)), R41.1; also elsewhere on the board
SD_D0: J5.7 (DAT0(D0)), R42.1; also elsewhere on the board
SD_D1: J5.8 (DAT1(RSV)), R43.1; also elsewhere on the board
SD_D2: J5.1 (DAT2(RSV)), R44.1; also elsewhere on the board
SD_D3: J5.2 (CDDAT3(CS)), R45.1; also elsewhere on the board
STRAP_MIO7: R34.1; also elsewhere on the board
STRAP_MIO8: R35.1; also elsewhere on the board
UART_RX: U10.21 (TXD); also elsewhere on the board
UART_TX: U10.20 (RXD); also elsewhere on the board
USB_CC1: J6.A5 (CC1), R51.1
USB_CC2: J6.B5 (CC2), R52.1
USB_DN: J6.A7 (D-), J6.B7 (D-), U10.4 (D-)
USB_DP: J6.A6 (D+), J6.B6 (D+), U10.3 (D+)
USB_VBUS: C110.1, J6.A4 (VBUS), J6.A9 (VBUS), J6.B4 (VBUS), J6.B9 (VBUS), R53.1
USB_VBUS_SENSE: R53.2, R54.1, U10.8 (VBUS)
USER_BTN_PS: R50.1, SW3.1; also elsewhere on the board

Notes on the sheet:
Zynq PS: clock, reset, boot straps, QSPI, SD, UART, I2C
Boot mode MIO[5:3]: QSPI = 1,0,0 (jumper open), SD = 1,1,0 (jumper closed). Console UART1 115200 8N1.
