ajisrawi/passive-radar-counter-drone/hardware/board_c/board_c.kicad_pcb

## KiCad design hardware/board_c/board_c.kicad_pcb (continued)

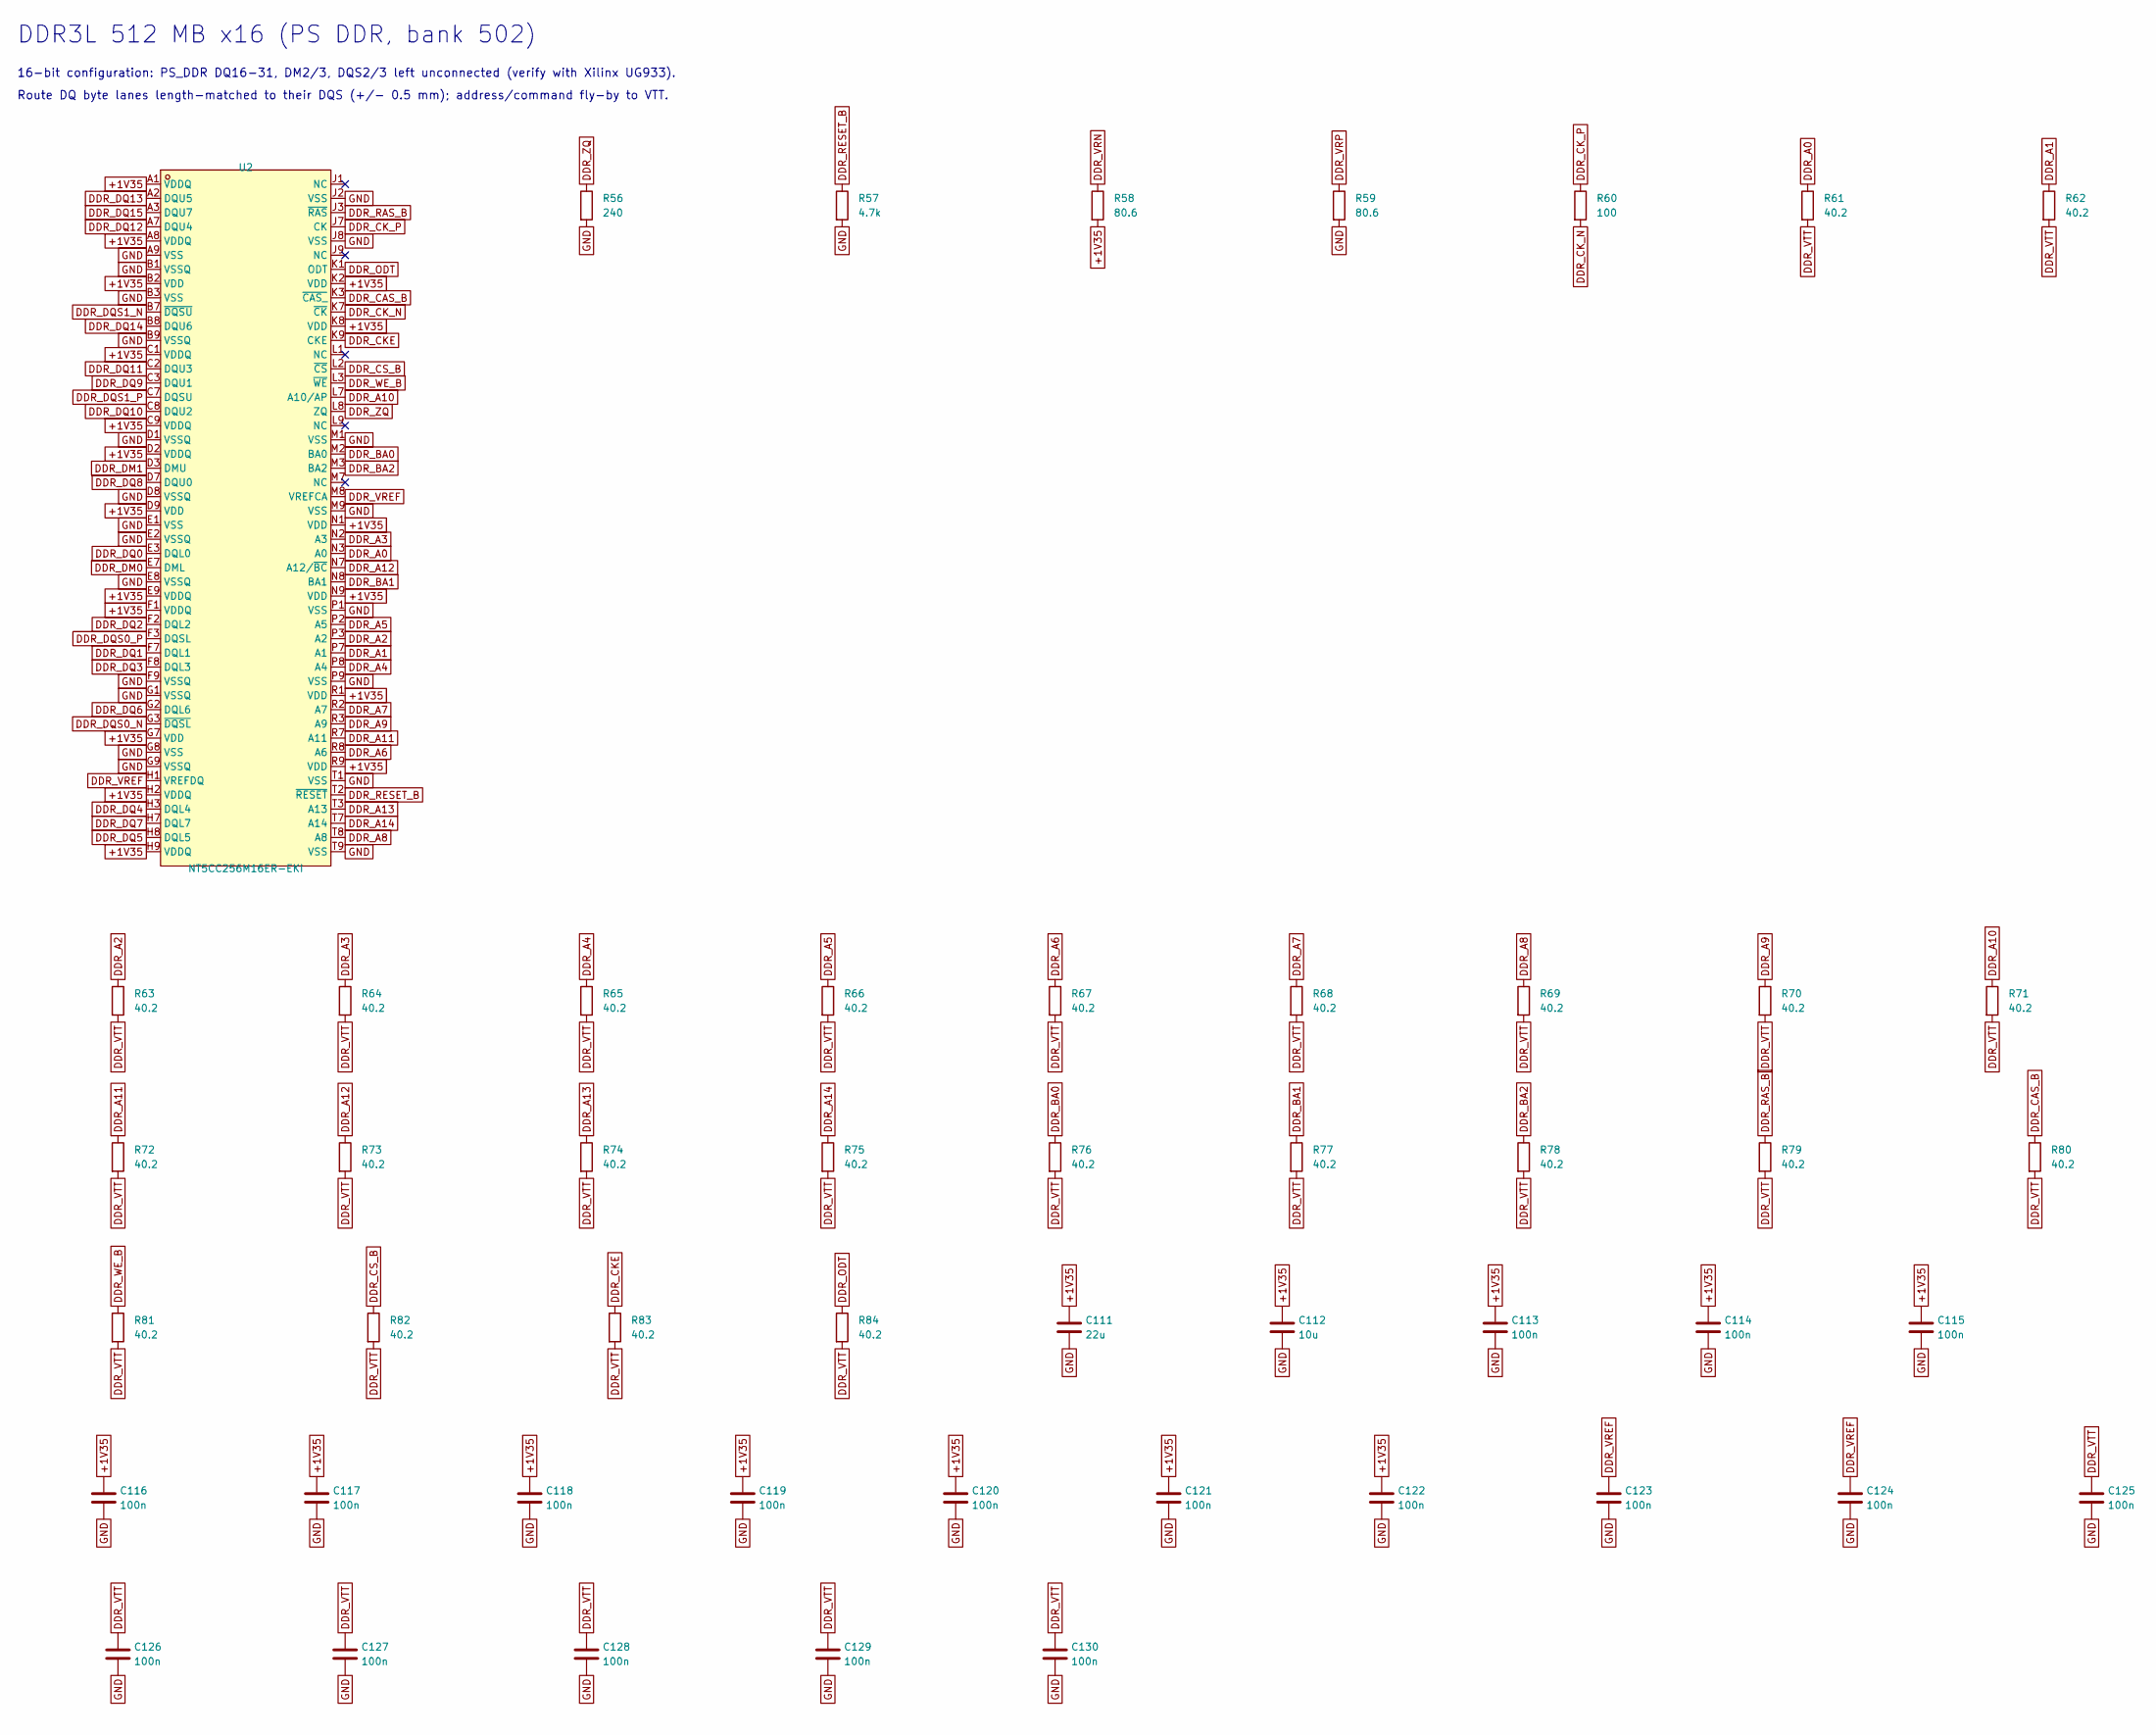
[picture p81: schematic ddr3.kicad_sch, DDR3L 512 MB x16 (PS DDR, bank 502)]

Parts:
C111: 22u; C_0805_2012Metric; LCSC C45783
C112: 10u; C_0603_1608Metric; LCSC C19702
C113, C114, C115, C116, C117, C118, C119, C120, C121, C122, C123, C124, C125, C126, C127, C128, C129, C130: 100n; C_0402_1005Metric; LCSC C1525
R56: 240; R_0402_1005Metric; Tolerance 1%
R57: 4.7k; R_0402_1005Metric; LCSC C25900
R58, R59: 80.6; R_0402_1005Metric; Tolerance 1%
R60: 100; R_0402_1005Metric
R61, R62, R63, R64, R65, R66, R67, R68, R69, R70, R71, R72, R73, R74, R75, R76, R77, R78, R79, R80, R81, R82, R83, R84: 40.2; R_0402_1005Metric
U2: NT5CC256M16ER-EKI; TFBGA-96_L13.0-W8.0-R16-C6-P0.80-TL; MPN NT5CC256M16ER-EKI; LCSC C2841153

Connections:
+1V35: C111.1, C112.1, C113.1, C114.1, C115.1, C116.1, C117.1, C118.1, C119.1, C120.1, C121.1, C122.1, R58.2, U2.A1 (VDDQ), U2.A8 (VDDQ), U2.B2 (VDD), U2.C1 (VDDQ), U2.C9 (VDDQ), U2.D2 (VDDQ), U2.D9 (VDD), U2.E9 (VDDQ), U2.F1 (VDDQ), U2.G7 (VDD), U2.H2 (VDDQ), U2.H9 (VDDQ), U2.K2 (VDD), U2.K8 (VDD), U2.N1 (VDD), U2.N9 (VDD), U2.R1 (VDD), U2.R9 (VDD); also elsewhere on the board
DDR_A0: R61.1, U2.N3 (A0); also elsewhere on the board
DDR_A1: R62.1, U2.P7 (A1); also elsewhere on the board
DDR_A2: R63.1, U2.P3 (A2); also elsewhere on the board
DDR_A3: R64.1, U2.N2 (A3); also elsewhere on the board
DDR_A4: R65.1, U2.P8 (A4); also elsewhere on the board
DDR_A5: R66.1, U2.P2 (A5); also elsewhere on the board
DDR_A6: R67.1, U2.R8 (A6); also elsewhere on the board
DDR_A7: R68.1, U2.R2 (A7); also elsewhere on the board
DDR_A8: R69.1, U2.T8 (A8); also elsewhere on the board
DDR_A9: R70.1, U2.R3 (A9); also elsewhere on the board
DDR_A10: R71.1, U2.L7 (A10/AP); also elsewhere on the board
DDR_A11: R72.1, U2.R7 (A11); also elsewhere on the board
DDR_A12: R73.1, U2.N7 (A12/~BC); also elsewhere on the board
DDR_A13: R74.1, U2.T3 (A13); also elsewhere on the board
DDR_A14: R75.1, U2.T7 (A14); also elsewhere on the board
DDR_BA0: R76.1, U2.M2 (BA0); also elsewhere on the board
DDR_BA1: R77.1, U2.N8 (BA1); also elsewhere on the board
DDR_BA2: R78.1, U2.M3 (BA2); also elsewhere on the board
DDR_CAS_B: R80.1, U2.K3 (~CAS_); also elsewhere on the board
DDR_CKE: R83.1, U2.K9 (CKE); also elsewhere on the board
DDR_CK_N: R60.2, U2.K7 (~CK); also elsewhere on the board
DDR_CK_P: R60.1, U2.J7 (CK); also elsewhere on the board
DDR_CS_B: R82.1, U2.L2 (~CS); also elsewhere on the board
DDR_DM0: U2.E7 (DML); also elsewhere on the board
DDR_DM1: U2.D3 (DMU); also elsewhere on the board
DDR_DQ0: U2.E3 (DQL0); also elsewhere on the board
DDR_DQ1: U2.F7 (DQL1); also elsewhere on the board
DDR_DQ2: U2.F2 (DQL2); also elsewhere on the board
DDR_DQ3: U2.F8 (DQL3); also elsewhere on the board
DDR_DQ4: U2.H3 (DQL4); also elsewhere on the board
DDR_DQ5: U2.H8 (DQL5); also elsewhere on the board
DDR_DQ6: U2.G2 (DQL6); also elsewhere on the board
DDR_DQ7: U2.H7 (DQL7); also elsewhere on the board
DDR_DQ8: U2.D7 (DQU0); also elsewhere on the board
DDR_DQ9: U2.C3 (DQU1); also elsewhere on the board
DDR_DQ10: U2.C8 (DQU2); also elsewhere on the board
DDR_DQ11: U2.C2 (DQU3); also elsewhere on the board
DDR_DQ12: U2.A7 (DQU4); also elsewhere on the board
DDR_DQ13: U2.A2 (DQU5); also elsewhere on the board
DDR_DQ14: U2.B8 (DQU6); also elsewhere on the board
DDR_DQ15: U2.A3 (DQU7); also elsewhere on the board
DDR_DQS0_N: U2.G3 (~DQSL); also elsewhere on the board
DDR_DQS0_P: U2.F3 (DQSL); also elsewhere on the board
DDR_DQS1_N: U2.B7 (~DQSU); also elsewhere on the board
DDR_DQS1_P: U2.C7 (DQSU); also elsewhere on the board
DDR_ODT: R84.1, U2.K1 (ODT); also elsewhere on the board
DDR_RAS_B: R79.1, U2.J3 (~RAS); also elsewhere on the board
DDR_RESET_B: R57.1, U2.T2 (~RESET); also elsewhere on the board
DDR_VREF: C123.1, C124.1, U2.H1 (VREFDQ), U2.M8 (VREFCA); also elsewhere on the board
DDR_VRN: R58.1; also elsewhere on the board
DDR_VRP: R59.1; also elsewhere on the board
DDR_VTT: C125.1, C126.1, C127.1, C128.1, C129.1, C130.1, R61.2, R62.2, R63.2, R64.2, R65.2, R66.2, R67.2, R68.2, R69.2, R70.2, R71.2, R72.2, R73.2, R74.2, R75.2, R76.2, R77.2, R78.2, R79.2, R80.2, R81.2, R82.2, R83.2, R84.2; also elsewhere on the board
DDR_WE_B: R81.1, U2.L3 (~WE); also elsewhere on the board
DDR_ZQ: R56.1, U2.L8 (ZQ)
GND: C111.2, C112.2, C113.2, C114.2, C115.2, C116.2, C117.2, C118.2, C119.2, C120.2, C121.2, C122.2, C123.2, C124.2, C125.2, C126.2, C127.2, C128.2, C129.2, C130.2, R56.2, R57.2, R59.2, U2.A9 (VSS), U2.B1 (VSSQ), U2.B3 (VSS), U2.B9 (VSSQ), U2.D1 (VSSQ), U2.D8 (VSSQ), U2.E1 (VSS), U2.E2 (VSSQ), U2.E8 (VSSQ), U2.F9 (VSSQ), U2.G1 (VSSQ), U2.G8 (VSS), U2.G9 (VSSQ), U2.J2 (VSS), U2.J8 (VSS), U2.M1 (VSS), U2.M9 (VSS), U2.P1 (VSS), U2.P9 (VSS), U2.T1 (VSS), U2.T9 (VSS); also elsewhere on the board

Notes on the sheet:
DDR3L 512 MB x16 (PS DDR, bank 502)
16-bit configuration: PS_DDR DQ16-31, DM2/3, DQS2/3 left unconnected (verify with Xilinx UG933).
Route DQ byte lanes length-matched to their DQS (+/- 0.5 mm); address/command fly-by to VTT.

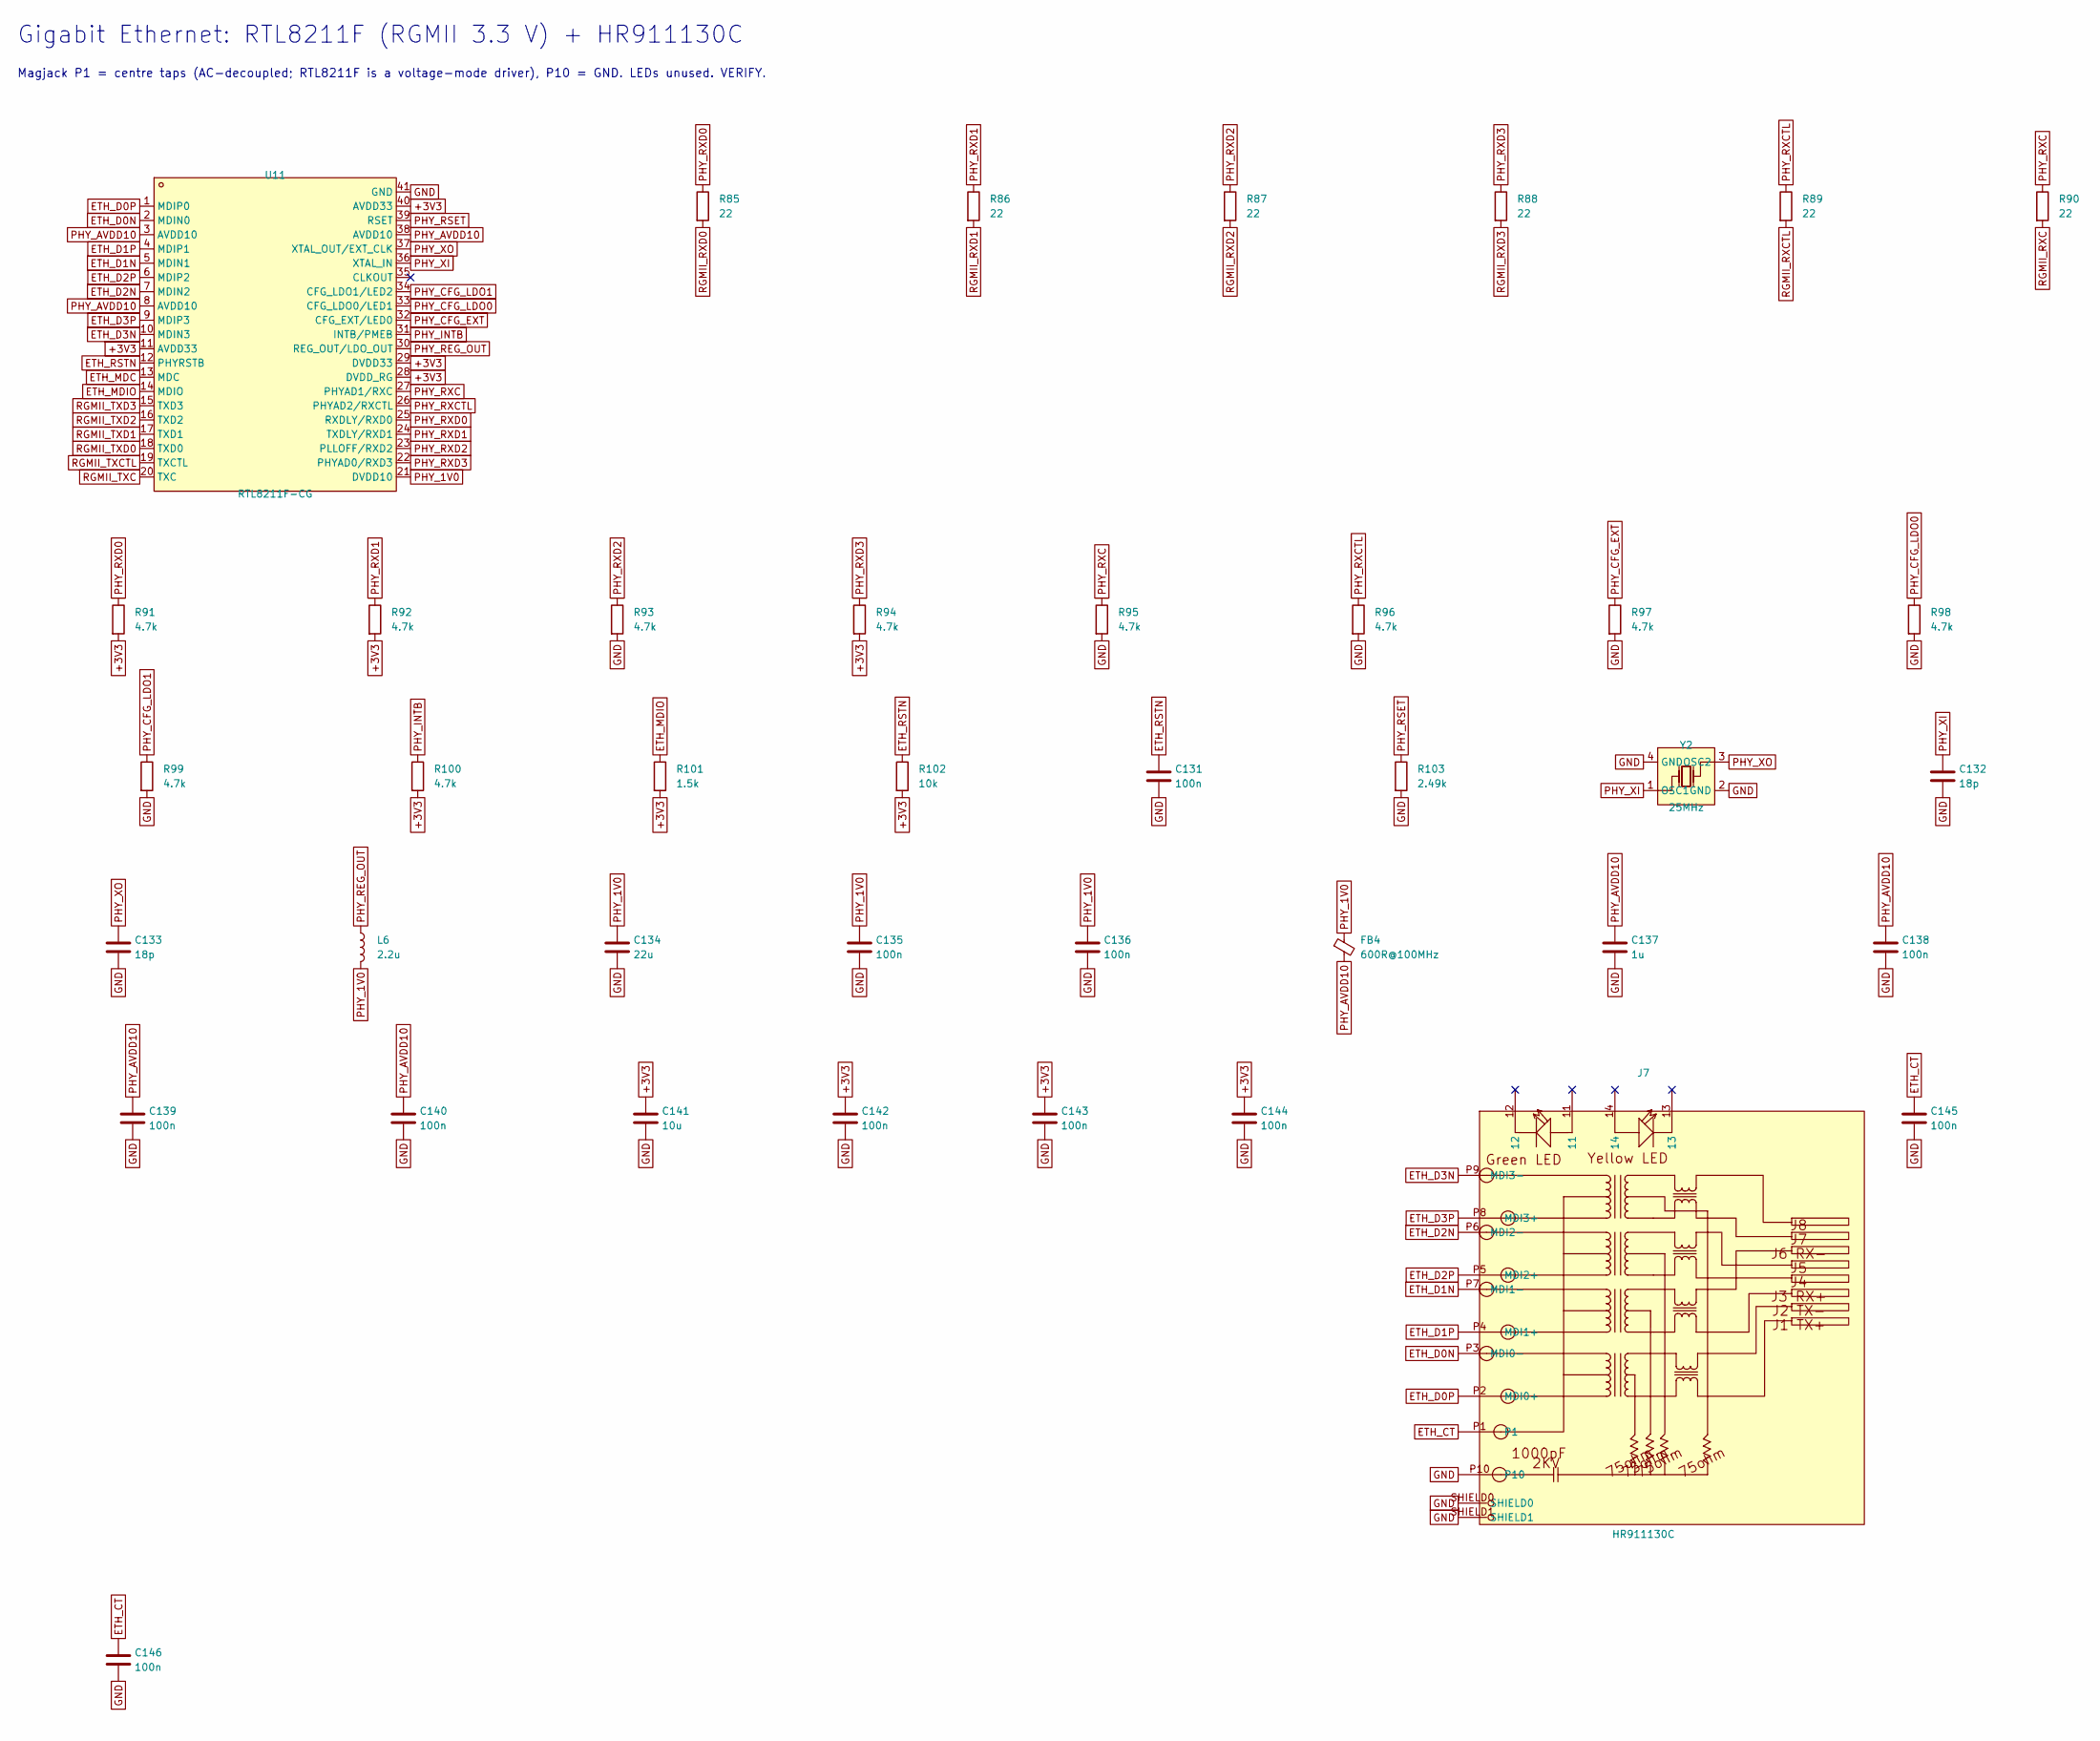
[picture p82: schematic ethernet.kicad_sch, Gigabit Ethernet: RTL8211F (RGMII 3.3 V) + HR911130C]

Parts:
C131, C135, C136, C138, C139, C140, C142, C143, C144, C145, C146: 100n; C_0402_1005Metric; LCSC C1525
C132, C133: 18p; C_0402_1005Metric
C134: 22u; C_0805_2012Metric; LCSC C45783
C137: 1u; C_0402_1005Metric; LCSC C52923
C141: 10u; C_0603_1608Metric; LCSC C19702
FB4: 600R@100MHz; L_0603_1608Metric
J7: HR911130C; RJ45-TH_HR911130C; MPN HR911130C; LCSC C50933
L6: 2.2u; L_0603_1608Metric
R85, R86, R87, R88, R89, R90: 22; R_0402_1005Metric
R91, R92, R93, R94, R95, R96, R97, R98, R99, R100: 4.7k; R_0402_1005Metric; LCSC C25900
R101: 1.5k; R_0402_1005Metric
R102: 10k; R_0402_1005Metric; LCSC C25744
R103: 2.49k; R_0402_1005Metric; Tolerance 1%
U11: RTL8211F-CG; WQFN-40_L5.0-W5.0-P0.4-BL-EP; MPN RTL8211F-CG; LCSC C187932
Y2: 25MHz; CRYSTAL-SMD_4P-L3.2-W2.5-BL; MPN X322525MOB4SI; LCSC C9006

Connections:
+3V3: C141.1, C142.1, C143.1, C144.1, R91.2, R92.2, R94.2, R100.2, R101.2, R102.2, U11.11 (AVDD33), U11.28 (DVDD_RG), U11.29 (DVDD33), U11.40 (AVDD33); also elsewhere on the board
ETH_CT: C145.1, C146.1, J7.P1
ETH_D0N: J7.P3 (MDI0-), U11.2 (MDIN0)
ETH_D0P: J7.P2 (MDI0+), U11.1 (MDIP0)
ETH_D1N: J7.P7 (MDI1-), U11.5 (MDIN1)
ETH_D1P: J7.P4 (MDI1+), U11.4 (MDIP1)
ETH_D2N: J7.P6 (MDI2-), U11.7 (MDIN2)
ETH_D2P: J7.P5 (MDI2+), U11.6 (MDIP2)
ETH_D3N: J7.P9 (MDI3-), U11.10 (MDIN3)
ETH_D3P: J7.P8 (MDI3+), U11.9 (MDIP3)
ETH_MDC: U11.13 (MDC); also elsewhere on the board
ETH_MDIO: R101.1, U11.14 (MDIO); also elsewhere on the board
ETH_RSTN: C131.1, R102.1, U11.12 (PHYRSTB); also elsewhere on the board
GND: C131.2, C132.2, C133.2, C134.2, C135.2, C136.2, C137.2, C138.2, C139.2, C140.2, C141.2, C142.2, C143.2, C144.2, C145.2, C146.2, J7.P10, J7.SHIELD0, J7.SHIELD1, R93.2, R95.2, R96.2, R97.2, R98.2, R99.2, R103.2, U11.41 (GND), Y2.2 (GND), Y2.4 (GND); also elsewhere on the board
PHY_1V0: C134.1, C135.1, C136.1, FB4.1, L6.2, U11.21 (DVDD10)
PHY_AVDD10: C137.1, C138.1, C139.1, C140.1, FB4.2, U11.3 (AVDD10), U11.8 (AVDD10), U11.38 (AVDD10)
PHY_CFG_EXT: R97.1, U11.32 (CFG_EXT/LED0)
PHY_CFG_LDO0: R98.1, U11.33 (CFG_LDO0/LED1)
PHY_CFG_LDO1: R99.1, U11.34 (CFG_LDO1/LED2)
PHY_INTB: R100.1, U11.31 (INTB/PMEB)
PHY_REG_OUT: L6.1, U11.30 (REG_OUT/LDO_OUT)
PHY_RSET: R103.1, U11.39 (RSET)
PHY_RXC: R90.1, R95.1, U11.27 (PHYAD1/RXC)
PHY_RXCTL: R89.1, R96.1, U11.26 (PHYAD2/RXCTL)
PHY_RXD0: R85.1, R91.1, U11.25 (RXDLY/RXD0)
PHY_RXD1: R86.1, R92.1, U11.24 (TXDLY/RXD1)
PHY_RXD2: R87.1, R93.1, U11.23 (PLLOFF/RXD2)
PHY_RXD3: R88.1, R94.1, U11.22 (PHYAD0/RXD3)
PHY_XI: C132.1, U11.36 (XTAL_IN), Y2.1 (OSC1)
PHY_XO: C133.1, U11.37 (XTAL_OUT/EXT_CLK), Y2.3 (OSC2)
RGMII_RXC: R90.2; also elsewhere on the board
RGMII_RXCTL: R89.2; also elsewhere on the board
RGMII_RXD0: R85.2; also elsewhere on the board
RGMII_RXD1: R86.2; also elsewhere on the board
RGMII_RXD2: R87.2; also elsewhere on the board
RGMII_RXD3: R88.2; also elsewhere on the board
RGMII_TXC: U11.20 (TXC); also elsewhere on the board
RGMII_TXCTL: U11.19 (TXCTL); also elsewhere on the board
RGMII_TXD0: U11.18 (TXD0); also elsewhere on the board
RGMII_TXD1: U11.17 (TXD1); also elsewhere on the board
RGMII_TXD2: U11.16 (TXD2); also elsewhere on the board
RGMII_TXD3: U11.15 (TXD3); also elsewhere on the board

Notes on the sheet:
Gigabit Ethernet: RTL8211F (RGMII 3.3 V) + HR911130C
Magjack P1 = centre taps (AC-decoupled; RTL8211F is a voltage-mode driver), P10 = GND. LEDs unused. VERIFY.

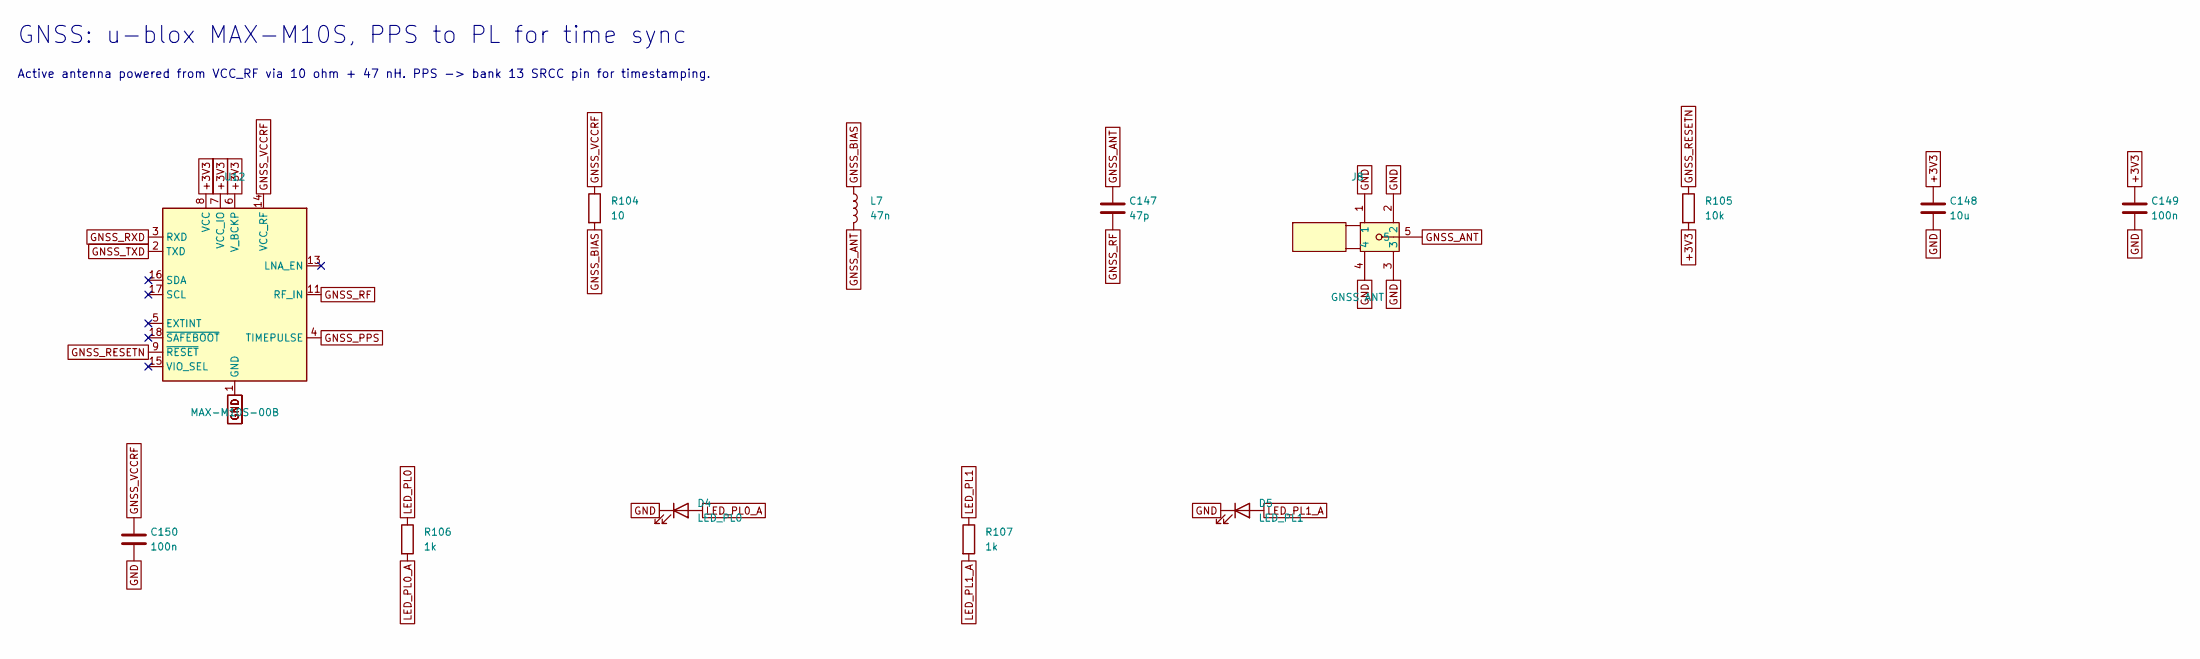
[picture p83: schematic gnss.kicad_sch, GNSS: u-blox MAX-M10S, PPS to PL for time sync]

Parts:
C147: 47p; C_0402_1005Metric
C148: 10u; C_0603_1608Metric; LCSC C19702
C149, C150: 100n; C_0402_1005Metric; LCSC C1525
D4: LED_PL0; LED_0603_1608Metric
D5: LED_PL1; LED_0603_1608Metric
J8: GNSS ANT; SMA-TH_BWSMA-KE-Z001; MPN BWSMA-KE-Z001; LCSC C496549
L7: 47n; L_0402_1005Metric
R104: 10; R_0402_1005Metric
R105: 10k; R_0402_1005Metric; LCSC C25744
R106, R107: 1k; R_0402_1005Metric; LCSC C11702
U12: MAX-M10S-00B; ublox_MAX; LCSC C4153167

Connections:
+3V3: C148.1, C149.1, R105.2, U12.6 (V_BCKP), U12.7 (VCC_IO), U12.8 (VCC); also elsewhere on the board
GND: C148.2, C149.2, C150.2, D4.1 (K), D5.1 (K), J8.1, J8.2, J8.3, J8.4, U12.1 (GND), U12.10 (GND), U12.12 (GND); also elsewhere on the board
GNSS_ANT: C147.1, J8.5, L7.2
GNSS_BIAS: L7.1, R104.2
GNSS_PPS: U12.4 (TIMEPULSE); also elsewhere on the board
GNSS_RESETN: R105.1, U12.9 (~RESET); also elsewhere on the board
GNSS_RF: C147.2, U12.11 (RF_IN)
GNSS_RXD: U12.3 (RXD); also elsewhere on the board
GNSS_TXD: U12.2 (TXD); also elsewhere on the board
GNSS_VCCRF: C150.1, R104.1, U12.14 (VCC_RF)
LED_PL0: R106.1; also elsewhere on the board
LED_PL0_A: D4.2 (A), R106.2
LED_PL1: R107.1; also elsewhere on the board
LED_PL1_A: D5.2 (A), R107.2

Notes on the sheet:
GNSS: u-blox MAX-M10S, PPS to PL for time sync
Active antenna powered from VCC_RF via 10 ohm + 47 nH. PPS -> bank 13 SRCC pin for timestamping.

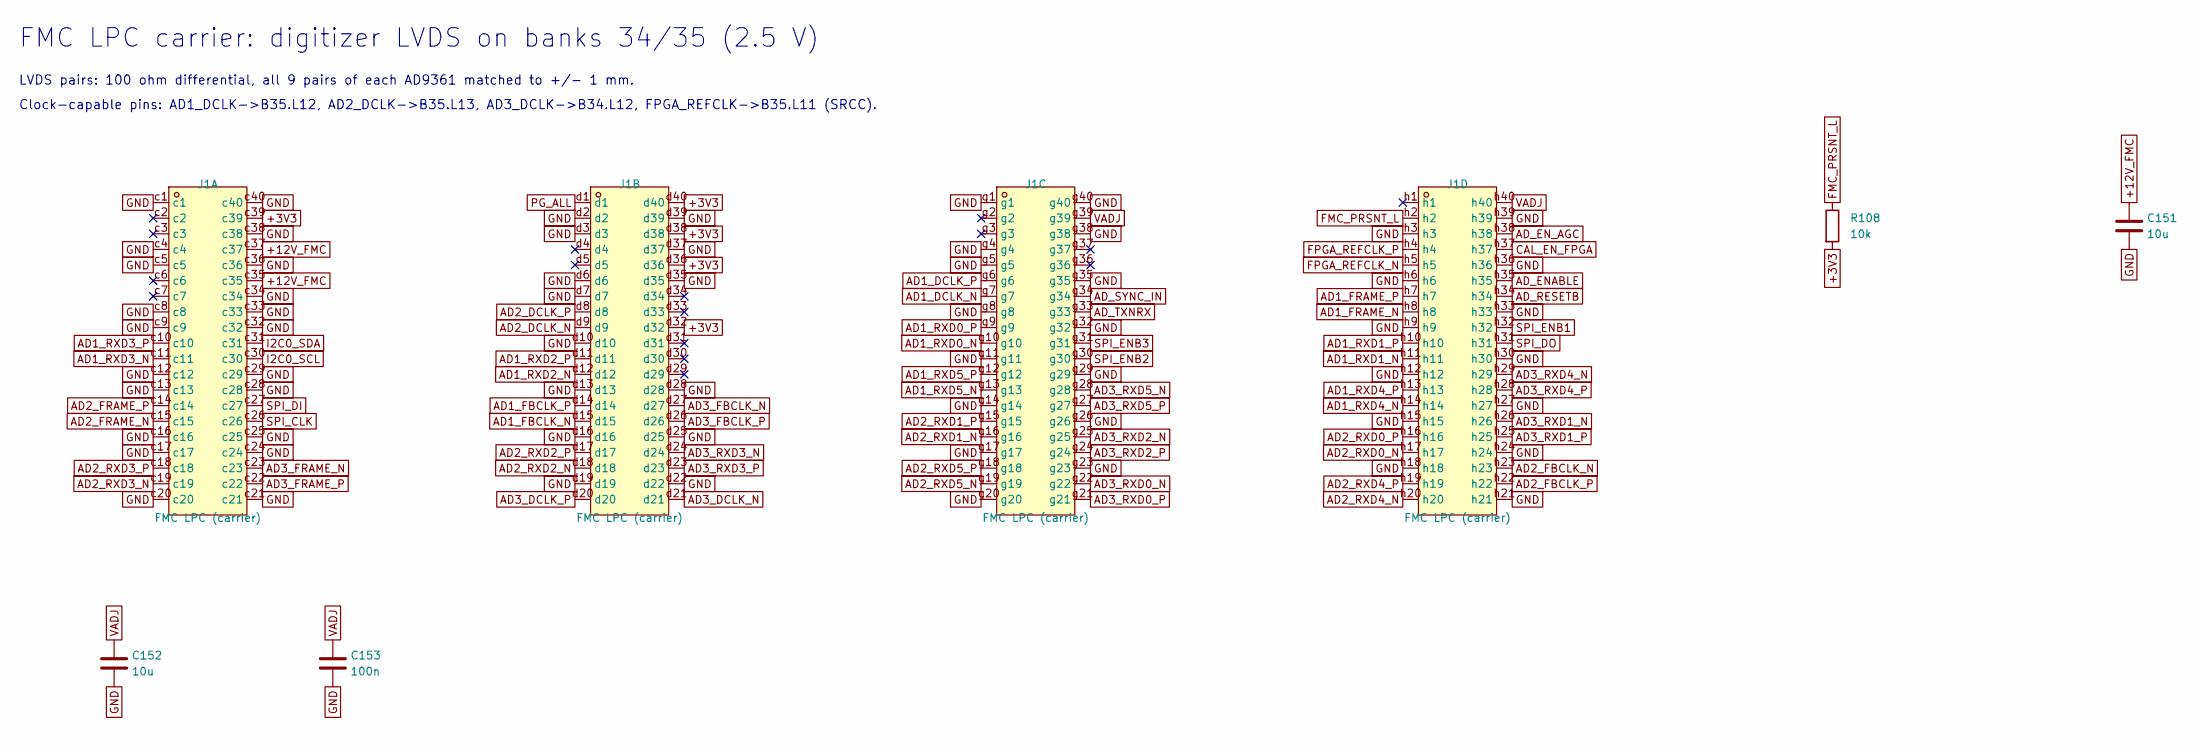
[picture p84: schematic fmc.kicad_sch, FMC LPC carrier: digitizer LVDS on banks 34/35 (2.5 V)]

Parts:
C151: 10u; C_0805_2012Metric
C152: 10u; C_0603_1608Metric; LCSC C19702
C153: 100n; C_0402_1005Metric; LCSC C1525
J1: FMC LPC (carrier); BGA-160_L56.6-W13.2-R4-C40-P1.27-BR; MPN ASP-134603-01; LCSC C2836665
R108: 10k; R_0402_1005Metric; LCSC C25744

Connections:
+3V3: J1.c39, J1.d32, J1.d36, J1.d38, J1.d40, R108.2; also elsewhere on the board
+12V_FMC: C151.1, J1.c35, J1.c37; also elsewhere on the board
AD1_DCLK_N: J1.g7; also elsewhere on the board
AD1_DCLK_P: J1.g6; also elsewhere on the board
AD1_FBCLK_N: J1.d15; also elsewhere on the board
AD1_FBCLK_P: J1.d14; also elsewhere on the board
AD1_FRAME_N: J1.h8; also elsewhere on the board
AD1_FRAME_P: J1.h7; also elsewhere on the board
AD1_RXD0_N: J1.g10; also elsewhere on the board
AD1_RXD0_P: J1.g9; also elsewhere on the board
AD1_RXD1_N: J1.h11; also elsewhere on the board
AD1_RXD1_P: J1.h10; also elsewhere on the board
AD1_RXD2_N: J1.d12; also elsewhere on the board
AD1_RXD2_P: J1.d11; also elsewhere on the board
AD1_RXD3_N: J1.c11; also elsewhere on the board
AD1_RXD3_P: J1.c10; also elsewhere on the board
AD1_RXD4_N: J1.h14; also elsewhere on the board
AD1_RXD4_P: J1.h13; also elsewhere on the board
AD1_RXD5_N: J1.g13; also elsewhere on the board
AD1_RXD5_P: J1.g12; also elsewhere on the board
AD2_DCLK_N: J1.d9; also elsewhere on the board
AD2_DCLK_P: J1.d8; also elsewhere on the board
AD2_FBCLK_N: J1.h23; also elsewhere on the board
AD2_FBCLK_P: J1.h22; also elsewhere on the board
AD2_FRAME_N: J1.c15; also elsewhere on the board
AD2_FRAME_P: J1.c14; also elsewhere on the board
AD2_RXD0_N: J1.h17; also elsewhere on the board
AD2_RXD0_P: J1.h16; also elsewhere on the board
AD2_RXD1_N: J1.g16; also elsewhere on the board
AD2_RXD1_P: J1.g15; also elsewhere on the board
AD2_RXD2_N: J1.d18; also elsewhere on the board
AD2_RXD2_P: J1.d17; also elsewhere on the board
AD2_RXD3_N: J1.c19; also elsewhere on the board
AD2_RXD3_P: J1.c18; also elsewhere on the board
AD2_RXD4_N: J1.h20; also elsewhere on the board
AD2_RXD4_P: J1.h19; also elsewhere on the board
AD2_RXD5_N: J1.g19; also elsewhere on the board
AD2_RXD5_P: J1.g18; also elsewhere on the board
AD3_DCLK_N: J1.d21; also elsewhere on the board
AD3_DCLK_P: J1.d20; also elsewhere on the board
AD3_FBCLK_N: J1.d27; also elsewhere on the board
AD3_FBCLK_P: J1.d26; also elsewhere on the board
AD3_FRAME_N: J1.c23; also elsewhere on the board
AD3_FRAME_P: J1.c22; also elsewhere on the board
AD3_RXD0_N: J1.g22; also elsewhere on the board
AD3_RXD0_P: J1.g21; also elsewhere on the board
AD3_RXD1_N: J1.h26; also elsewhere on the board
AD3_RXD1_P: J1.h25; also elsewhere on the board
AD3_RXD2_N: J1.g25; also elsewhere on the board
AD3_RXD2_P: J1.g24; also elsewhere on the board
AD3_RXD3_N: J1.d24; also elsewhere on the board
AD3_RXD3_P: J1.d23; also elsewhere on the board
AD3_RXD4_N: J1.h29; also elsewhere on the board
AD3_RXD4_P: J1.h28; also elsewhere on the board
AD3_RXD5_N: J1.g28; also elsewhere on the board
AD3_RXD5_P: J1.g27; also elsewhere on the board
AD_ENABLE: J1.h35; also elsewhere on the board
AD_EN_AGC: J1.h38; also elsewhere on the board
AD_RESETB: J1.h34; also elsewhere on the board
AD_SYNC_IN: J1.g34; also elsewhere on the board
AD_TXNRX: J1.g33; also elsewhere on the board
CAL_EN_FPGA: J1.h37; also elsewhere on the board
FMC_PRSNT_L: J1.h2, R108.1; also elsewhere on the board
FPGA_REFCLK_N: J1.h5; also elsewhere on the board
FPGA_REFCLK_P: J1.h4; also elsewhere on the board
GND: C151.2, C152.2, C153.2, J1.c1, J1.c4, J1.c5, J1.c8, J1.c9, J1.c12, J1.c13, J1.c16, J1.c17, J1.c20, J1.c21, J1.c24, J1.c25, J1.c28, J1.c29, J1.c32, J1.c33, J1.c34, J1.c36, J1.c38, J1.c40, J1.d2, J1.d3, J1.d6, J1.d7, J1.d10, J1.d13, J1.d16, J1.d19, J1.d22, J1.d25, J1.d28, J1.d35, J1.d37, J1.d39, J1.g1, J1.g4, J1.g5, J1.g8, J1.g11, J1.g14, J1.g17, J1.g20, J1.g23, J1.g26, J1.g29, J1.g32, J1.g35, J1.g38, J1.g40, J1.h3, J1.h6, J1.h9, J1.h12, J1.h15, J1.h18, J1.h21, J1.h24, J1.h27, J1.h30, J1.h33, J1.h36, J1.h39; also elsewhere on the board
I2C0_SCL: J1.c30; also elsewhere on the board
I2C0_SDA: J1.c31; also elsewhere on the board
PG_ALL: J1.d1; also elsewhere on the board
SPI_CLK: J1.c26; also elsewhere on the board
SPI_DI: J1.c27; also elsewhere on the board
SPI_DO: J1.h31; also elsewhere on the board
SPI_ENB1: J1.h32; also elsewhere on the board
SPI_ENB2: J1.g30; also elsewhere on the board
SPI_ENB3: J1.g31; also elsewhere on the board
VADJ: C152.1, C153.1, J1.g39, J1.h40; also elsewhere on the board

Notes on the sheet:
FMC LPC carrier: digitizer LVDS on banks 34/35 (2.5 V)
LVDS pairs: 100 ohm differential, all 9 pairs of each AD9361 matched to +/- 1 mm.
Clock-capable pins: AD1_DCLK->B35.L12, AD2_DCLK->B35.L13, AD3_DCLK->B34.L12, FPGA_REFCLK->B35.L11 (SRCC).
