ajisrawi/passive-radar-counter-drone/hardware/board_c/board_c.kicad_pcb

## KiCad design hardware/board_c/board_c.kicad_pcb (continued)

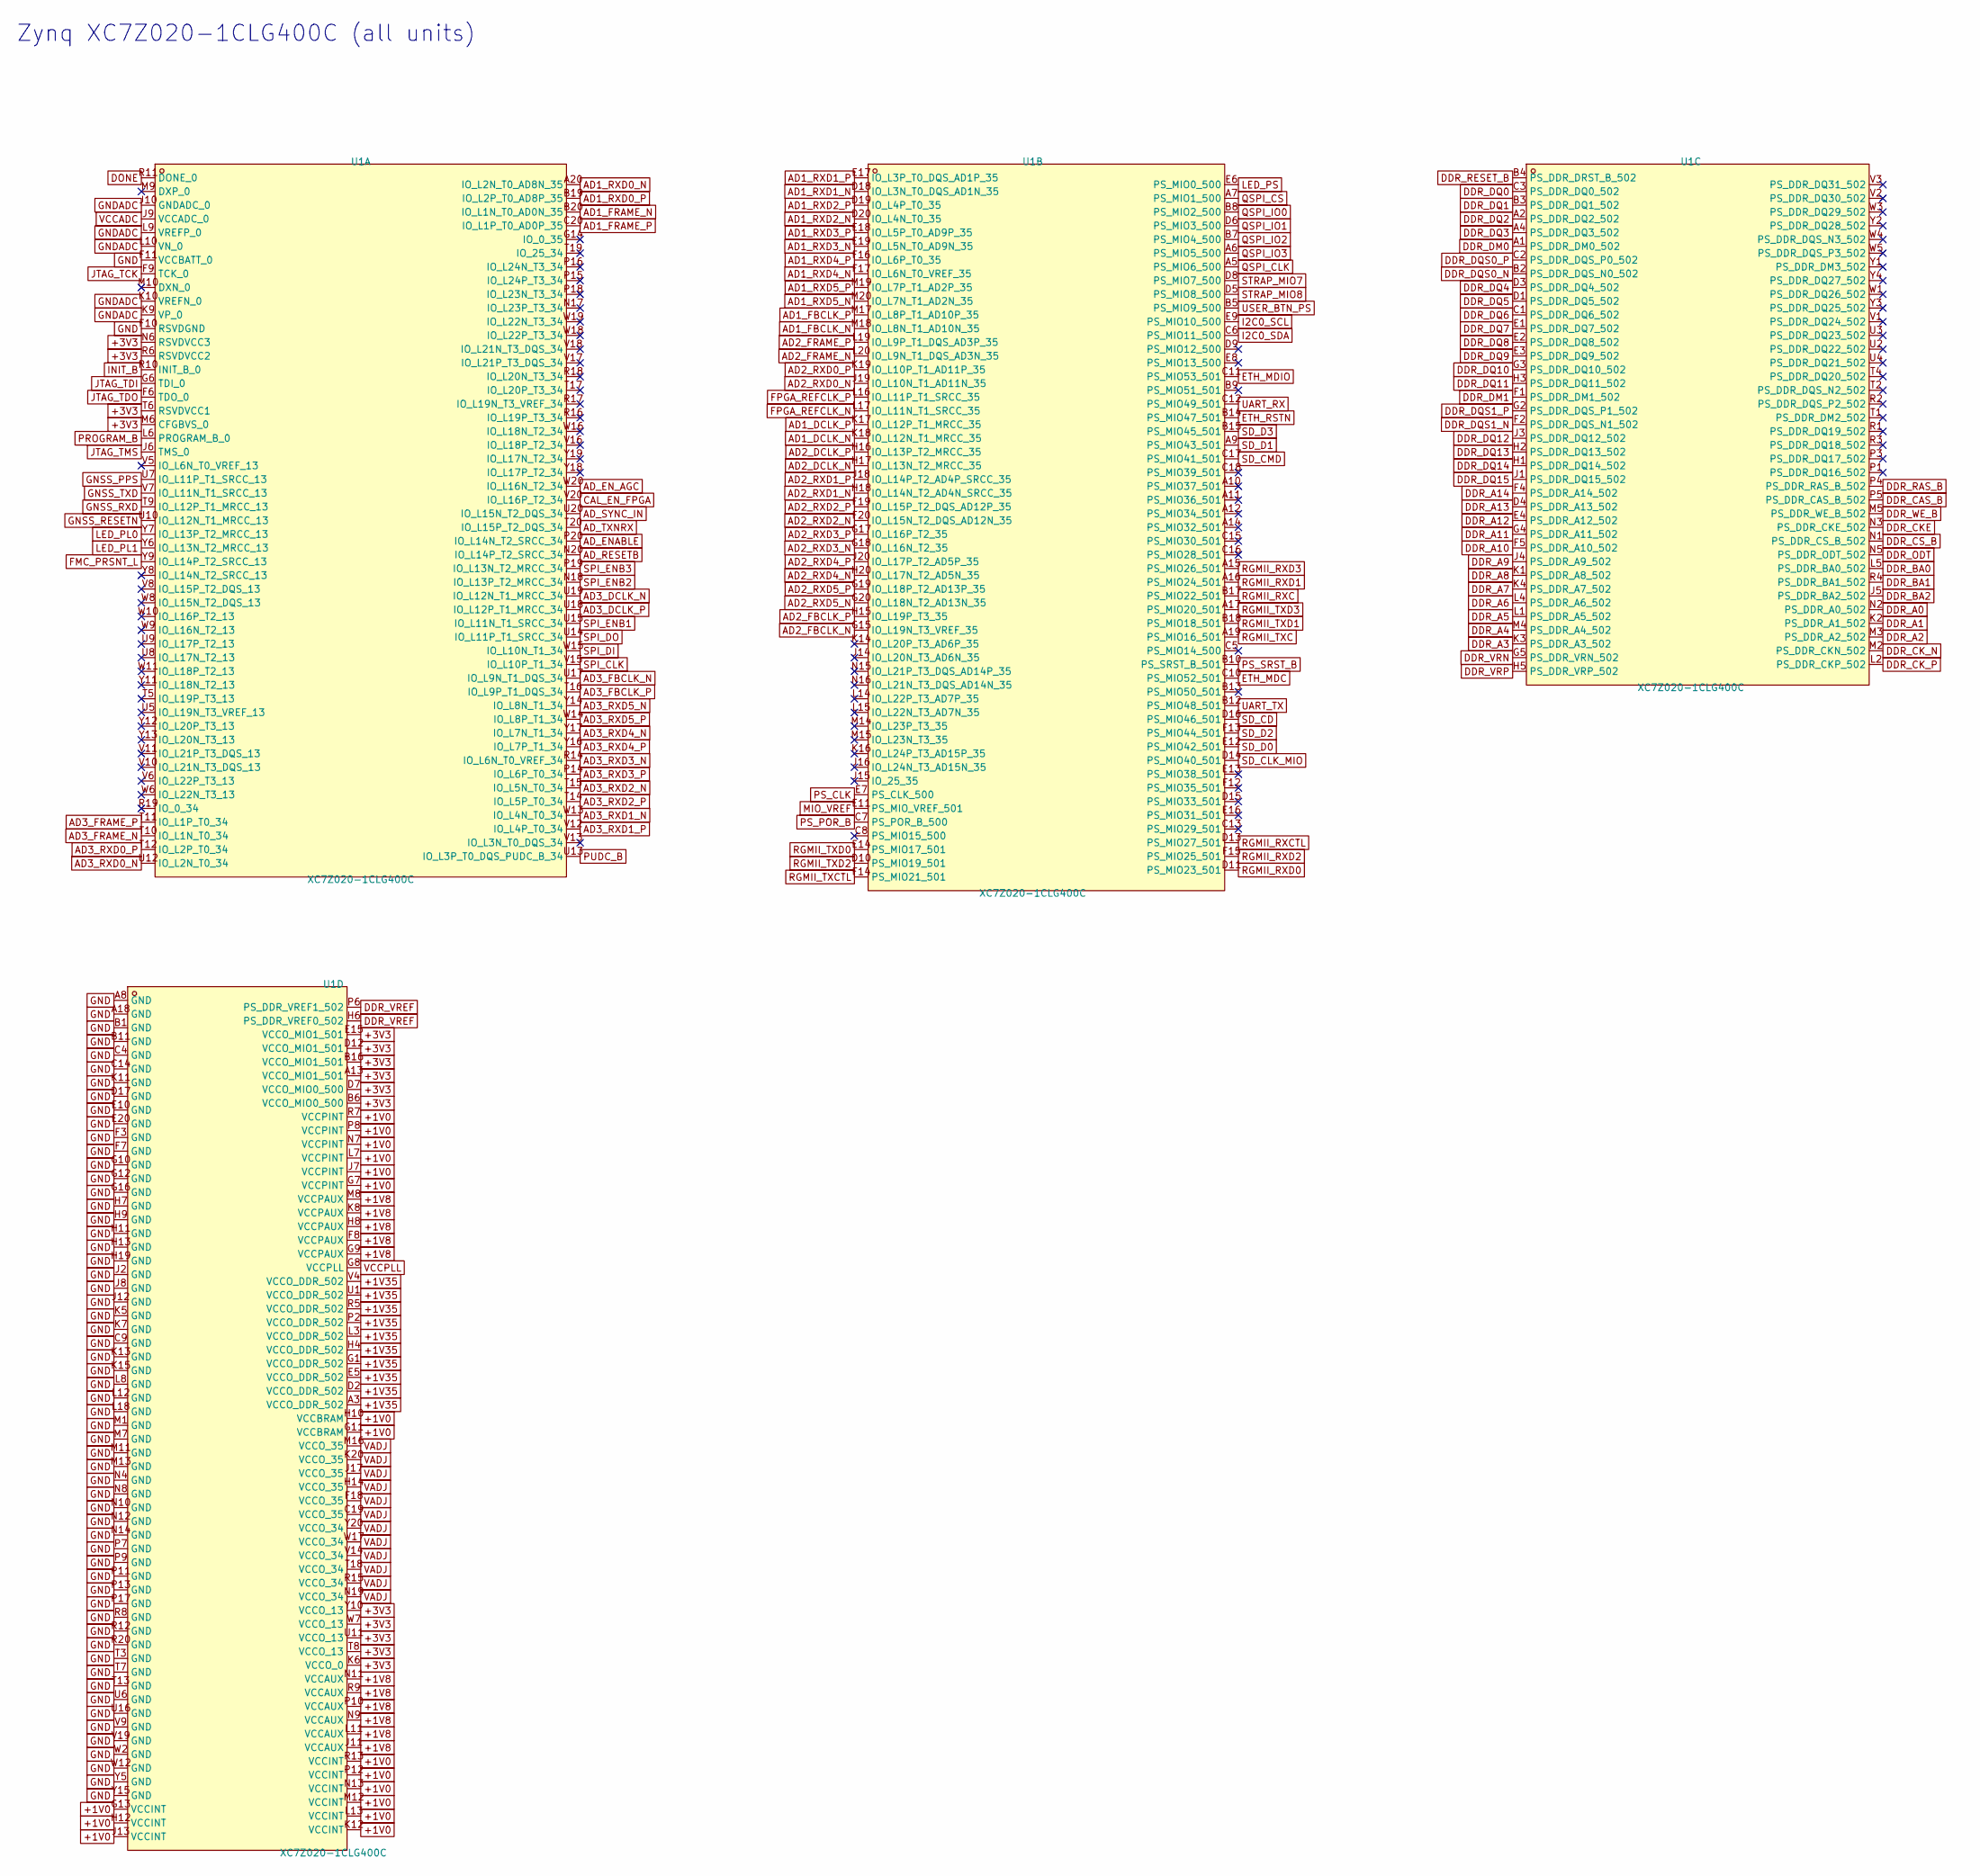
[picture p85: schematic zynq.kicad_sch, Zynq XC7Z020-1CLG400C (all units)]

Parts:
U1: XC7Z020-1CLG400C; FBGA-400_L17.0-W17.0-R20-C20-P0.80-TL; MPN XC7Z020-1CLG400C; LCSC C2988113

Connections:
+1V0: U1.G7 (VCCPINT), U1.G11 (VCCBRAM), U1.G13 (VCCINT), U1.H10 (VCCBRAM), U1.H12 (VCCINT), U1.J7 (VCCPINT), U1.J13 (VCCINT), U1.K12 (VCCINT), U1.L7 (VCCPINT), U1.L13 (VCCINT), U1.M12 (VCCINT), U1.N7 (VCCPINT), U1.N13 (VCCINT), U1.P8 (VCCPINT), U1.P12 (VCCINT), U1.R7 (VCCPINT), U1.R13 (VCCINT); also elsewhere on the board
+1V8: U1.F8 (VCCPAUX), U1.G9 (VCCPAUX), U1.H8 (VCCPAUX), U1.J11 (VCCAUX), U1.K8 (VCCPAUX), U1.L11 (VCCAUX), U1.M8 (VCCPAUX), U1.N9 (VCCAUX), U1.N11 (VCCAUX), U1.P10 (VCCAUX), U1.R9 (VCCAUX); also elsewhere on the board
+1V35: U1.A3 (VCCO_DDR_502), U1.D2 (VCCO_DDR_502), U1.E5 (VCCO_DDR_502), U1.G1 (VCCO_DDR_502), U1.H4 (VCCO_DDR_502), U1.L3 (VCCO_DDR_502), U1.P2 (VCCO_DDR_502), U1.R5 (VCCO_DDR_502), U1.U1 (VCCO_DDR_502), U1.V4 (VCCO_DDR_502); also elsewhere on the board
+3V3: U1.A13 (VCCO_MIO1_501), U1.B6 (VCCO_MIO0_500), U1.B16 (VCCO_MIO1_501), U1.D7 (VCCO_MIO0_500), U1.D12 (VCCO_MIO1_501), U1.E15 (VCCO_MIO1_501), U1.K6 (VCCO_0), U1.M6 (CFGBVS_0), U1.N6 (RSVDVCC3), U1.R6 (RSVDVCC2), U1.T6 (RSVDVCC1), U1.T8 (VCCO_13), U1.U11 (VCCO_13), U1.W7 (VCCO_13), U1.Y10 (VCCO_13); also elsewhere on the board
AD1_DCLK_N: U1.K18 (IO_L12N_T1_MRCC_35); also elsewhere on the board
AD1_DCLK_P: U1.K17 (IO_L12P_T1_MRCC_35); also elsewhere on the board
AD1_FBCLK_N: U1.M18 (IO_L8N_T1_AD10N_35); also elsewhere on the board
AD1_FBCLK_P: U1.M17 (IO_L8P_T1_AD10P_35); also elsewhere on the board
AD1_FRAME_N: U1.B20 (IO_L1N_T0_AD0N_35); also elsewhere on the board
AD1_FRAME_P: U1.C20 (IO_L1P_T0_AD0P_35); also elsewhere on the board
AD1_RXD0_N: U1.A20 (IO_L2N_T0_AD8N_35); also elsewhere on the board
AD1_RXD0_P: U1.B19 (IO_L2P_T0_AD8P_35); also elsewhere on the board
AD1_RXD1_N: U1.D18 (IO_L3N_T0_DQS_AD1N_35); also elsewhere on the board
AD1_RXD1_P: U1.E17 (IO_L3P_T0_DQS_AD1P_35); also elsewhere on the board
AD1_RXD2_N: U1.D20 (IO_L4N_T0_35); also elsewhere on the board
AD1_RXD2_P: U1.D19 (IO_L4P_T0_35); also elsewhere on the board
AD1_RXD3_N: U1.E19 (IO_L5N_T0_AD9N_35); also elsewhere on the board
AD1_RXD3_P: U1.E18 (IO_L5P_T0_AD9P_35); also elsewhere on the board
AD1_RXD4_N: U1.F17 (IO_L6N_T0_VREF_35); also elsewhere on the board
AD1_RXD4_P: U1.F16 (IO_L6P_T0_35); also elsewhere on the board
AD1_RXD5_N: U1.M20 (IO_L7N_T1_AD2N_35); also elsewhere on the board
AD1_RXD5_P: U1.M19 (IO_L7P_T1_AD2P_35); also elsewhere on the board
AD2_DCLK_N: U1.H17 (IO_L13N_T2_MRCC_35); also elsewhere on the board
AD2_DCLK_P: U1.H16 (IO_L13P_T2_MRCC_35); also elsewhere on the board
AD2_FBCLK_N: U1.G15 (IO_L19N_T3_VREF_35); also elsewhere on the board
AD2_FBCLK_P: U1.H15 (IO_L19P_T3_35); also elsewhere on the board
AD2_FRAME_N: U1.L20 (IO_L9N_T1_DQS_AD3N_35); also elsewhere on the board
AD2_FRAME_P: U1.L19 (IO_L9P_T1_DQS_AD3P_35); also elsewhere on the board
AD2_RXD0_N: U1.J19 (IO_L10N_T1_AD11N_35); also elsewhere on the board
AD2_RXD0_P: U1.K19 (IO_L10P_T1_AD11P_35); also elsewhere on the board
AD2_RXD1_N: U1.H18 (IO_L14N_T2_AD4N_SRCC_35); also elsewhere on the board
AD2_RXD1_P: U1.J18 (IO_L14P_T2_AD4P_SRCC_35); also elsewhere on the board
AD2_RXD2_N: U1.F20 (IO_L15N_T2_DQS_AD12N_35); also elsewhere on the board
AD2_RXD2_P: U1.F19 (IO_L15P_T2_DQS_AD12P_35); also elsewhere on the board
AD2_RXD3_N: U1.G18 (IO_L16N_T2_35); also elsewhere on the board
AD2_RXD3_P: U1.G17 (IO_L16P_T2_35); also elsewhere on the board
AD2_RXD4_N: U1.H20 (IO_L17N_T2_AD5N_35); also elsewhere on the board
AD2_RXD4_P: U1.J20 (IO_L17P_T2_AD5P_35); also elsewhere on the board
AD2_RXD5_N: U1.G20 (IO_L18N_T2_AD13N_35); also elsewhere on the board
AD2_RXD5_P: U1.G19 (IO_L18P_T2_AD13P_35); also elsewhere on the board
AD3_DCLK_N: U1.U19 (IO_L12N_T1_MRCC_34); also elsewhere on the board
AD3_DCLK_P: U1.U18 (IO_L12P_T1_MRCC_34); also elsewhere on the board
AD3_FBCLK_N: U1.U17 (IO_L9N_T1_DQS_34); also elsewhere on the board
AD3_FBCLK_P: U1.T16 (IO_L9P_T1_DQS_34); also elsewhere on the board
AD3_FRAME_N: U1.T10 (IO_L1N_T0_34); also elsewhere on the board
AD3_FRAME_P: U1.T11 (IO_L1P_T0_34); also elsewhere on the board
AD3_RXD0_N: U1.U12 (IO_L2N_T0_34); also elsewhere on the board
AD3_RXD0_P: U1.T12 (IO_L2P_T0_34); also elsewhere on the board
AD3_RXD1_N: U1.W13 (IO_L4N_T0_34); also elsewhere on the board
AD3_RXD1_P: U1.V12 (IO_L4P_T0_34); also elsewhere on the board
AD3_RXD2_N: U1.T15 (IO_L5N_T0_34); also elsewhere on the board
AD3_RXD2_P: U1.T14 (IO_L5P_T0_34); also elsewhere on the board
AD3_RXD3_N: U1.R14 (IO_L6N_T0_VREF_34); also elsewhere on the board
AD3_RXD3_P: U1.P14 (IO_L6P_T0_34); also elsewhere on the board
AD3_RXD4_N: U1.Y17 (IO_L7N_T1_34); also elsewhere on the board
AD3_RXD4_P: U1.Y16 (IO_L7P_T1_34); also elsewhere on the board
AD3_RXD5_N: U1.Y14 (IO_L8N_T1_34); also elsewhere on the board
AD3_RXD5_P: U1.W14 (IO_L8P_T1_34); also elsewhere on the board
AD_ENABLE: U1.P20 (IO_L14N_T2_SRCC_34); also elsewhere on the board
AD_EN_AGC: U1.W20 (IO_L16N_T2_34); also elsewhere on the board
AD_RESETB: U1.N20 (IO_L14P_T2_SRCC_34); also elsewhere on the board
AD_SYNC_IN: U1.U20 (IO_L15N_T2_DQS_34); also elsewhere on the board
AD_TXNRX: U1.T20 (IO_L15P_T2_DQS_34); also elsewhere on the board
CAL_EN_FPGA: U1.V20 (IO_L16P_T2_34); also elsewhere on the board
DDR_A0: U1.N2 (PS_DDR_A0_502); also elsewhere on the board
DDR_A1: U1.K2 (PS_DDR_A1_502); also elsewhere on the board
DDR_A2: U1.M3 (PS_DDR_A2_502); also elsewhere on the board
DDR_A3: U1.K3 (PS_DDR_A3_502); also elsewhere on the board
DDR_A4: U1.M4 (PS_DDR_A4_502); also elsewhere on the board
DDR_A5: U1.L1 (PS_DDR_A5_502); also elsewhere on the board
DDR_A6: U1.L4 (PS_DDR_A6_502); also elsewhere on the board
DDR_A7: U1.K4 (PS_DDR_A7_502); also elsewhere on the board
DDR_A8: U1.K1 (PS_DDR_A8_502); also elsewhere on the board
DDR_A9: U1.J4 (PS_DDR_A9_502); also elsewhere on the board
DDR_A10: U1.F5 (PS_DDR_A10_502); also elsewhere on the board
DDR_A11: U1.G4 (PS_DDR_A11_502); also elsewhere on the board
DDR_A12: U1.E4 (PS_DDR_A12_502); also elsewhere on the board
DDR_A13: U1.D4 (PS_DDR_A13_502); also elsewhere on the board
DDR_A14: U1.F4 (PS_DDR_A14_502); also elsewhere on the board
DDR_BA0: U1.L5 (PS_DDR_BA0_502); also elsewhere on the board
DDR_BA1: U1.R4 (PS_DDR_BA1_502); also elsewhere on the board
DDR_BA2: U1.J5 (PS_DDR_BA2_502); also elsewhere on the board
DDR_CAS_B: U1.P5 (PS_DDR_CAS_B_502); also elsewhere on the board
DDR_CKE: U1.N3 (PS_DDR_CKE_502); also elsewhere on the board
DDR_CK_N: U1.M2 (PS_DDR_CKN_502); also elsewhere on the board
DDR_CK_P: U1.L2 (PS_DDR_CKP_502); also elsewhere on the board
DDR_CS_B: U1.N1 (PS_DDR_CS_B_502); also elsewhere on the board
DDR_DM0: U1.A1 (PS_DDR_DM0_502); also elsewhere on the board
DDR_DM1: U1.F1 (PS_DDR_DM1_502); also elsewhere on the board
DDR_DQ0: U1.C3 (PS_DDR_DQ0_502); also elsewhere on the board
DDR_DQ1: U1.B3 (PS_DDR_DQ1_502); also elsewhere on the board
DDR_DQ2: U1.A2 (PS_DDR_DQ2_502); also elsewhere on the board
DDR_DQ3: U1.A4 (PS_DDR_DQ3_502); also elsewhere on the board
DDR_DQ4: U1.D3 (PS_DDR_DQ4_502); also elsewhere on the board
DDR_DQ5: U1.D1 (PS_DDR_DQ5_502); also elsewhere on the board
DDR_DQ6: U1.C1 (PS_DDR_DQ6_502); also elsewhere on the board
DDR_DQ7: U1.E1 (PS_DDR_DQ7_502); also elsewhere on the board
DDR_DQ8: U1.E2 (PS_DDR_DQ8_502); also elsewhere on the board
DDR_DQ9: U1.E3 (PS_DDR_DQ9_502); also elsewhere on the board
DDR_DQ10: U1.G3 (PS_DDR_DQ10_502); also elsewhere on the board
DDR_DQ11: U1.H3 (PS_DDR_DQ11_502); also elsewhere on the board
DDR_DQ12: U1.J3 (PS_DDR_DQ12_502); also elsewhere on the board
DDR_DQ13: U1.H2 (PS_DDR_DQ13_502); also elsewhere on the board
DDR_DQ14: U1.H1 (PS_DDR_DQ14_502); also elsewhere on the board
DDR_DQ15: U1.J1 (PS_DDR_DQ15_502); also elsewhere on the board
DDR_DQS0_N: U1.B2 (PS_DDR_DQS_N0_502); also elsewhere on the board
DDR_DQS0_P: U1.C2 (PS_DDR_DQS_P0_502); also elsewhere on the board
DDR_DQS1_N: U1.F2 (PS_DDR_DQS_N1_502); also elsewhere on the board
DDR_DQS1_P: U1.G2 (PS_DDR_DQS_P1_502); also elsewhere on the board
DDR_ODT: U1.N5 (PS_DDR_ODT_502); also elsewhere on the board
DDR_RAS_B: U1.P4 (PS_DDR_RAS_B_502); also elsewhere on the board
DDR_RESET_B: U1.B4 (PS_DDR_DRST_B_502); also elsewhere on the board
DDR_VREF: U1.H6 (PS_DDR_VREF0_502), U1.P6 (PS_DDR_VREF1_502); also elsewhere on the board
DDR_VRN: U1.G5 (PS_DDR_VRN_502); also elsewhere on the board
DDR_VRP: U1.H5 (PS_DDR_VRP_502); also elsewhere on the board
DDR_WE_B: U1.M5 (PS_DDR_WE_B_502); also elsewhere on the board
DONE: U1.R11 (DONE_0); also elsewhere on the board
ETH_MDC: U1.C10 (PS_MIO52_501); also elsewhere on the board
ETH_MDIO: U1.C11 (PS_MIO53_501); also elsewhere on the board
ETH_RSTN: U1.B14 (PS_MIO47_501); also elsewhere on the board
FMC_PRSNT_L: U1.Y9 (IO_L14P_T2_SRCC_13); also elsewhere on the board
FPGA_REFCLK_N: U1.L17 (IO_L11N_T1_SRCC_35); also elsewhere on the board
FPGA_REFCLK_P: U1.L16 (IO_L11P_T1_SRCC_35); also elsewhere on the board
GND: U1.A8 (GND), U1.A18 (GND), U1.B1 (GND), U1.B11 (GND), U1.C4 (GND), U1.C9 (GND), U1.C14 (GND), U1.D17 (GND), U1.E10 (GND), U1.E20 (GND), U1.F3 (GND), U1.F7 (GND), U1.F10 (RSVDGND), U1.F11 (VCCBATT_0), U1.G10 (GND), U1.G12 (GND), U1.G16 (GND), U1.H7 (GND), U1.H9 (GND), U1.H11 (GND), U1.H13 (GND), U1.H19 (GND), U1.J2 (GND), U1.J8 (GND), U1.J12 (GND), U1.K5 (GND), U1.K7 (GND), U1.K11 (GND), U1.K13 (GND), U1.K15 (GND), U1.L8 (GND), U1.L12 (GND), U1.L18 (GND), U1.M1 (GND), U1.M7 (GND), U1.M11 (GND), U1.M13 (GND), U1.N4 (GND), U1.N8 (GND), U1.N10 (GND), U1.N12 (GND), U1.N14 (GND), U1.P7 (GND), U1.P9 (GND), U1.P11 (GND), U1.P13 (GND), U1.P17 (GND), U1.R8 (GND), U1.R12 (GND), U1.R20 (GND), U1.T3 (GND), U1.T7 (GND), U1.T13 (GND), U1.U6 (GND), U1.U16 (GND), U1.V9 (GND), U1.V19 (GND), U1.W2 (GND), U1.W12 (GND), U1.Y5 (GND), U1.Y15 (GND); also elsewhere on the board
GNDADC: U1.J10 (GNDADC_0), U1.K9 (VP_0), U1.K10 (VREFN_0), U1.L9 (VREFP_0), U1.L10 (VN_0); also elsewhere on the board
GNSS_PPS: U1.U7 (IO_L11P_T1_SRCC_13); also elsewhere on the board
GNSS_RESETN: U1.U10 (IO_L12N_T1_MRCC_13); also elsewhere on the board
GNSS_RXD: U1.T9 (IO_L12P_T1_MRCC_13); also elsewhere on the board
GNSS_TXD: U1.V7 (IO_L11N_T1_SRCC_13); also elsewhere on the board
I2C0_SCL: U1.E9 (PS_MIO10_500); also elsewhere on the board
I2C0_SDA: U1.C6 (PS_MIO11_500); also elsewhere on the board
INIT_B: U1.R10 (INIT_B_0); also elsewhere on the board
JTAG_TCK: U1.F9 (TCK_0); also elsewhere on the board
JTAG_TDI: U1.G6 (TDI_0); also elsewhere on the board
JTAG_TDO: U1.F6 (TDO_0); also elsewhere on the board
JTAG_TMS: U1.J6 (TMS_0); also elsewhere on the board
LED_PL0: U1.Y7 (IO_L13P_T2_MRCC_13); also elsewhere on the board
LED_PL1: U1.Y6 (IO_L13N_T2_MRCC_13); also elsewhere on the board
LED_PS: U1.E6 (PS_MIO0_500); also elsewhere on the board
MIO_VREF: U1.E11 (PS_MIO_VREF_501); also elsewhere on the board
PROGRAM_B: U1.L6 (PROGRAM_B_0); also elsewhere on the board
PS_CLK: U1.E7 (PS_CLK_500); also elsewhere on the board
PS_POR_B: U1.C7 (PS_POR_B_500); also elsewhere on the board
PS_SRST_B: U1.B10 (PS_SRST_B_501); also elsewhere on the board
PUDC_B: U1.U13 (IO_L3P_T0_DQS_PUDC_B_34); also elsewhere on the board
QSPI_CLK: U1.A5 (PS_MIO6_500); also elsewhere on the board
QSPI_CS: U1.A7 (PS_MIO1_500); also elsewhere on the board
QSPI_IO0: U1.B8 (PS_MIO2_500); also elsewhere on the board
QSPI_IO1: U1.D6 (PS_MIO3_500); also elsewhere on the board
QSPI_IO2: U1.B7 (PS_MIO4_500); also elsewhere on the board
QSPI_IO3: U1.A6 (PS_MIO5_500); also elsewhere on the board
RGMII_RXC: U1.B17 (PS_MIO22_501); also elsewhere on the board
RGMII_RXCTL: U1.D13 (PS_MIO27_501); also elsewhere on the board
RGMII_RXD0: U1.D11 (PS_MIO23_501); also elsewhere on the board
RGMII_RXD1: U1.A16 (PS_MIO24_501); also elsewhere on the board
RGMII_RXD2: U1.F15 (PS_MIO25_501); also elsewhere on the board
RGMII_RXD3: U1.A15 (PS_MIO26_501); also elsewhere on the board
RGMII_TXC: U1.A19 (PS_MIO16_501); also elsewhere on the board
RGMII_TXCTL: U1.F14 (PS_MIO21_501); also elsewhere on the board
RGMII_TXD0: U1.E14 (PS_MIO17_501); also elsewhere on the board
RGMII_TXD1: U1.B18 (PS_MIO18_501); also elsewhere on the board
RGMII_TXD2: U1.D10 (PS_MIO19_501); also elsewhere on the board
RGMII_TXD3: U1.A17 (PS_MIO20_501); also elsewhere on the board
SD_CD: U1.D16 (PS_MIO46_501); also elsewhere on the board
SD_CLK_MIO: U1.D14 (PS_MIO40_501); also elsewhere on the board
SD_CMD: U1.C17 (PS_MIO41_501); also elsewhere on the board
SD_D0: U1.E12 (PS_MIO42_501); also elsewhere on the board
SD_D1: U1.A9 (PS_MIO43_501); also elsewhere on the board
SD_D2: U1.F13 (PS_MIO44_501); also elsewhere on the board
SD_D3: U1.B15 (PS_MIO45_501); also elsewhere on the board
SPI_CLK: U1.V15 (IO_L10P_T1_34); also elsewhere on the board
SPI_DI: U1.W15 (IO_L10N_T1_34); also elsewhere on the board
SPI_DO: U1.U14 (IO_L11P_T1_SRCC_34); also elsewhere on the board
SPI_ENB1: U1.U15 (IO_L11N_T1_SRCC_34); also elsewhere on the board
SPI_ENB2: U1.N18 (IO_L13P_T2_MRCC_34); also elsewhere on the board
SPI_ENB3: U1.P19 (IO_L13N_T2_MRCC_34); also elsewhere on the board
STRAP_MIO7: U1.D8 (PS_MIO7_500); also elsewhere on the board
STRAP_MIO8: U1.D5 (PS_MIO8_500); also elsewhere on the board
UART_RX: U1.C12 (PS_MIO49_501); also elsewhere on the board
UART_TX: U1.B12 (PS_MIO48_501); also elsewhere on the board
USER_BTN_PS: U1.B5 (PS_MIO9_500); also elsewhere on the board
VADJ: U1.C19 (VCCO_35), U1.F18 (VCCO_35), U1.H14 (VCCO_35), U1.J17 (VCCO_35), U1.K20 (VCCO_35), U1.M16 (VCCO_35), U1.N19 (VCCO_34), U1.R15 (VCCO_34), U1.T18 (VCCO_34), U1.V14 (VCCO_34), U1.W17 (VCCO_34), U1.Y20 (VCCO_34); also elsewhere on the board
VCCADC: U1.J9 (VCCADC_0); also elsewhere on the board
VCCPLL: U1.G8 (VCCPLL); also elsewhere on the board

Notes on the sheet:
Zynq XC7Z020-1CLG400C (all units)

Board: 8 copper layers, 314 parts (55 on the bottom side), 251 nets, no tracks yet.
