ajisrawi/passive-radar-counter-drone/hardware/board_a2/high/power.kicad_sch

## KiCad design hardware/board_a2/high/power.kicad_sch (2026-10-28)

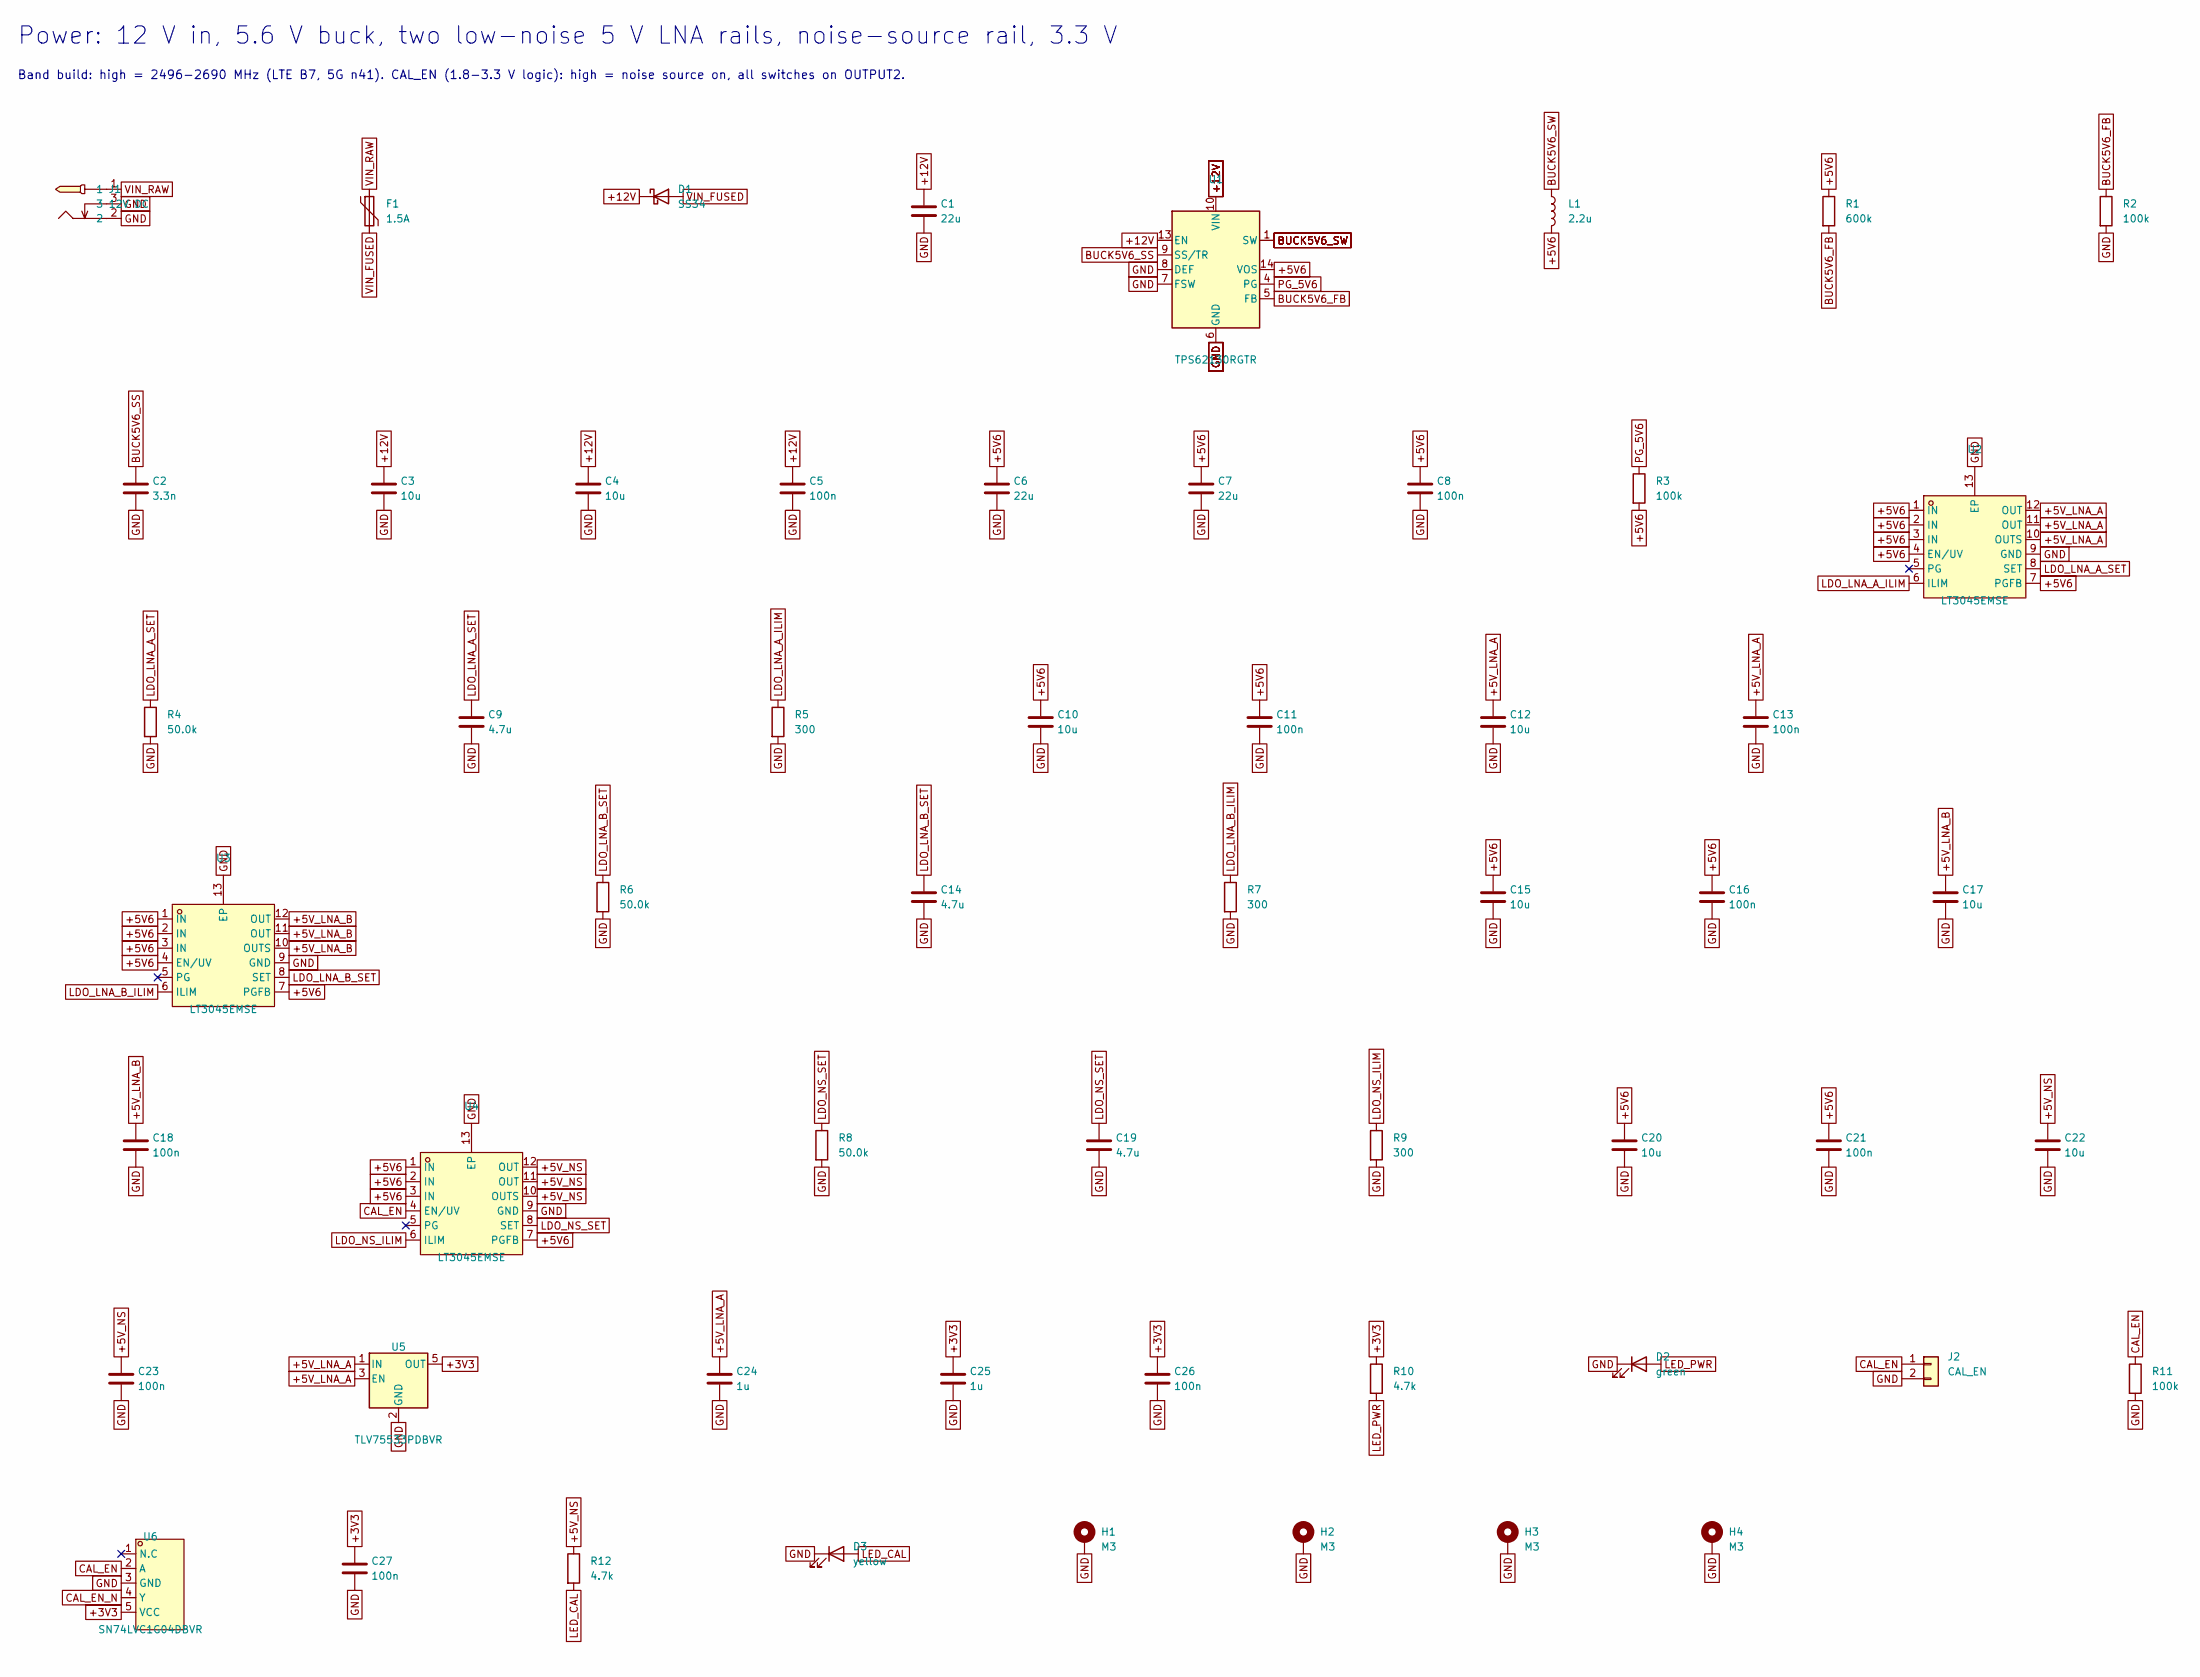
[picture p89: schematic power.kicad_sch]

Parts:
C1: 22u; C_1206_3216Metric
C2: 3.3n; C_0402_1005Metric
C3, C4: 10u; C_0805_2012Metric
C5, C8, C11, C13, C16, C18, C21, C23, C26, C27: 100n; C_0402_1005Metric; LCSC C1525
C6, C7: 22u; C_0805_2012Metric; LCSC C45783
C9, C14, C19: 4.7u; C_0603_1608Metric
C10, C12, C15, C17, C20, C22: 10u; C_0603_1608Metric; LCSC C19702
C24, C25: 1u; C_0402_1005Metric; LCSC C52923
D1: SS34; D_SMA; MPN SS34; LCSC C8678
D2: green; LED_0603_1608Metric
D3: yellow; LED_0603_1608Metric
F1: 1.5A; Fuse_1206_3216Metric
H1, H2, H3, H4: M3; MountingHole_3.2mm_M3_Pad_Via
J1: 12V DC; DC-IN-TH_DC-005C-20A; MPN DC-005C-20A; LCSC C84007
J2: CAL_EN; PinHeader_1x02_P2.54mm_Vertical
L1: 2.2u; L_Bourns-SRN4018; MPN SRN4018-2R2M
R1: 600k; R_0402_1005Metric
R2, R3, R11: 100k; R_0402_1005Metric; LCSC C25741
R4, R6, R8: 50.0k; R_0402_1005Metric; Tolerance 0.1%
R5, R7, R9: 300; R_0402_1005Metric
R10, R12: 4.7k; R_0402_1005Metric; LCSC C25900
U1: TPS62130RGTR; VQFN-16-1EP_3x3mm_P0.5mm_EP1.68x1.68mm; MPN TPS62130RGTR; LCSC C43590
U2, U3, U4: LT3045EMSE; MSOP-12_L4.0-W3.0-P0.65-LS4.9-BL-EP; MPN LT3045EMSE#PBF; LCSC C580012
U5: TLV75533PDBVR; SOT-23-5; LCSC C404027
U6: SN74LVC1G04DBVR; SOT-23-5_L3.0-W1.7-P0.95-LS2.8-BR; MPN SN74LVC1G04DBVR; LCSC C7827

Connections:
+3V3: C25.1, C26.1, C27.1, R10.1, U5.5 (OUT), U6.5 (VCC)
+5V6: C6.1, C7.1, C8.1, C10.1, C11.1, C15.1, C16.1, C20.1, C21.1, L1.2, R1.1, R3.2, U1.14 (VOS), U2.1 (IN), U2.2 (IN), U2.3 (IN), U2.4 (EN/UV), U2.7 (PGFB), U3.1 (IN), U3.2 (IN), U3.3 (IN), U3.4 (EN/UV), U3.7 (PGFB), U4.1 (IN), U4.2 (IN), U4.3 (IN), U4.7 (PGFB)
+5V_LNA_A: C12.1, C13.1, C24.1, U2.10 (OUTS), U2.11 (OUT), U2.12 (OUT), U5.1 (IN), U5.3 (EN)
+5V_LNA_B: C17.1, C18.1, U3.10 (OUTS), U3.11 (OUT), U3.12 (OUT)
+5V_NS: C22.1, C23.1, R12.1, U4.10 (OUTS), U4.11 (OUT), U4.12 (OUT)
+12V: C1.1, C3.1, C4.1, C5.1, D1.1 (K), U1.10 (VIN), U1.11 (VIN), U1.12 (VIN), U1.13 (EN)
BUCK5V6_FB: R1.2, R2.1, U1.5 (FB)
BUCK5V6_SS: C2.1, U1.9 (SS/TR)
BUCK5V6_SW: L1.1, U1.1 (SW), U1.2 (SW), U1.3 (SW)
CAL_EN: J2.1, R11.1, U4.4 (EN/UV), U6.2 (A)
CAL_EN_N: U6.4 (Y)
GND: C1.2, C2.2, C3.2, C4.2, C5.2, C6.2, C7.2, C8.2, C9.2, C10.2, C11.2, C12.2, C13.2, C14.2, C15.2, C16.2, C17.2, C18.2, C19.2, C20.2, C21.2, C22.2, C23.2, C24.2, C25.2, C26.2, C27.2, D2.1 (K), D3.1 (K), H1.1, H2.1, H3.1, H4.1, J1.2, J1.3, J2.2, R2.2, R4.2, R5.2, R6.2, R7.2, R8.2, R9.2, R11.2, U1.6 (GND), U1.7 (FSW), U1.8 (DEF), U1.15 (GND), U1.16 (GND), U1.17 (GND), U2.9 (GND), U2.13 (EP), U3.9 (GND), U3.13 (EP), U4.9 (GND), U4.13 (EP), U5.2 (GND), U6.3 (GND)
LDO_LNA_A_ILIM: R5.1, U2.6 (ILIM)
LDO_LNA_A_SET: C9.1, R4.1, U2.8 (SET)
LDO_LNA_B_ILIM: R7.1, U3.6 (ILIM)
LDO_LNA_B_SET: C14.1, R6.1, U3.8 (SET)
LDO_NS_ILIM: R9.1, U4.6 (ILIM)
LDO_NS_SET: C19.1, R8.1, U4.8 (SET)
LED_CAL: D3.2 (A), R12.2
LED_PWR: D2.2 (A), R10.2
PG_5V6: R3.1, U1.4 (PG)
VIN_FUSED: D1.2 (A), F1.2
VIN_RAW: F1.1, J1.1

Notes on the sheet:
Power: 12 V in, 5.6 V buck, two low-noise 5 V LNA rails, noise-source rail, 3.3 V
Band build: high = 2496-2690 MHz (LTE B7, 5G n41). CAL_EN (1.8-3.3 V logic): high = noise source on, all switches on OUTPUT2.
