ajisrawi/passive-radar-counter-drone/hardware/board_a2/mid/channels_1.kicad_sch

## KiCad design hardware/board_a2/mid/channels_1.kicad_sch (2026-10-28)

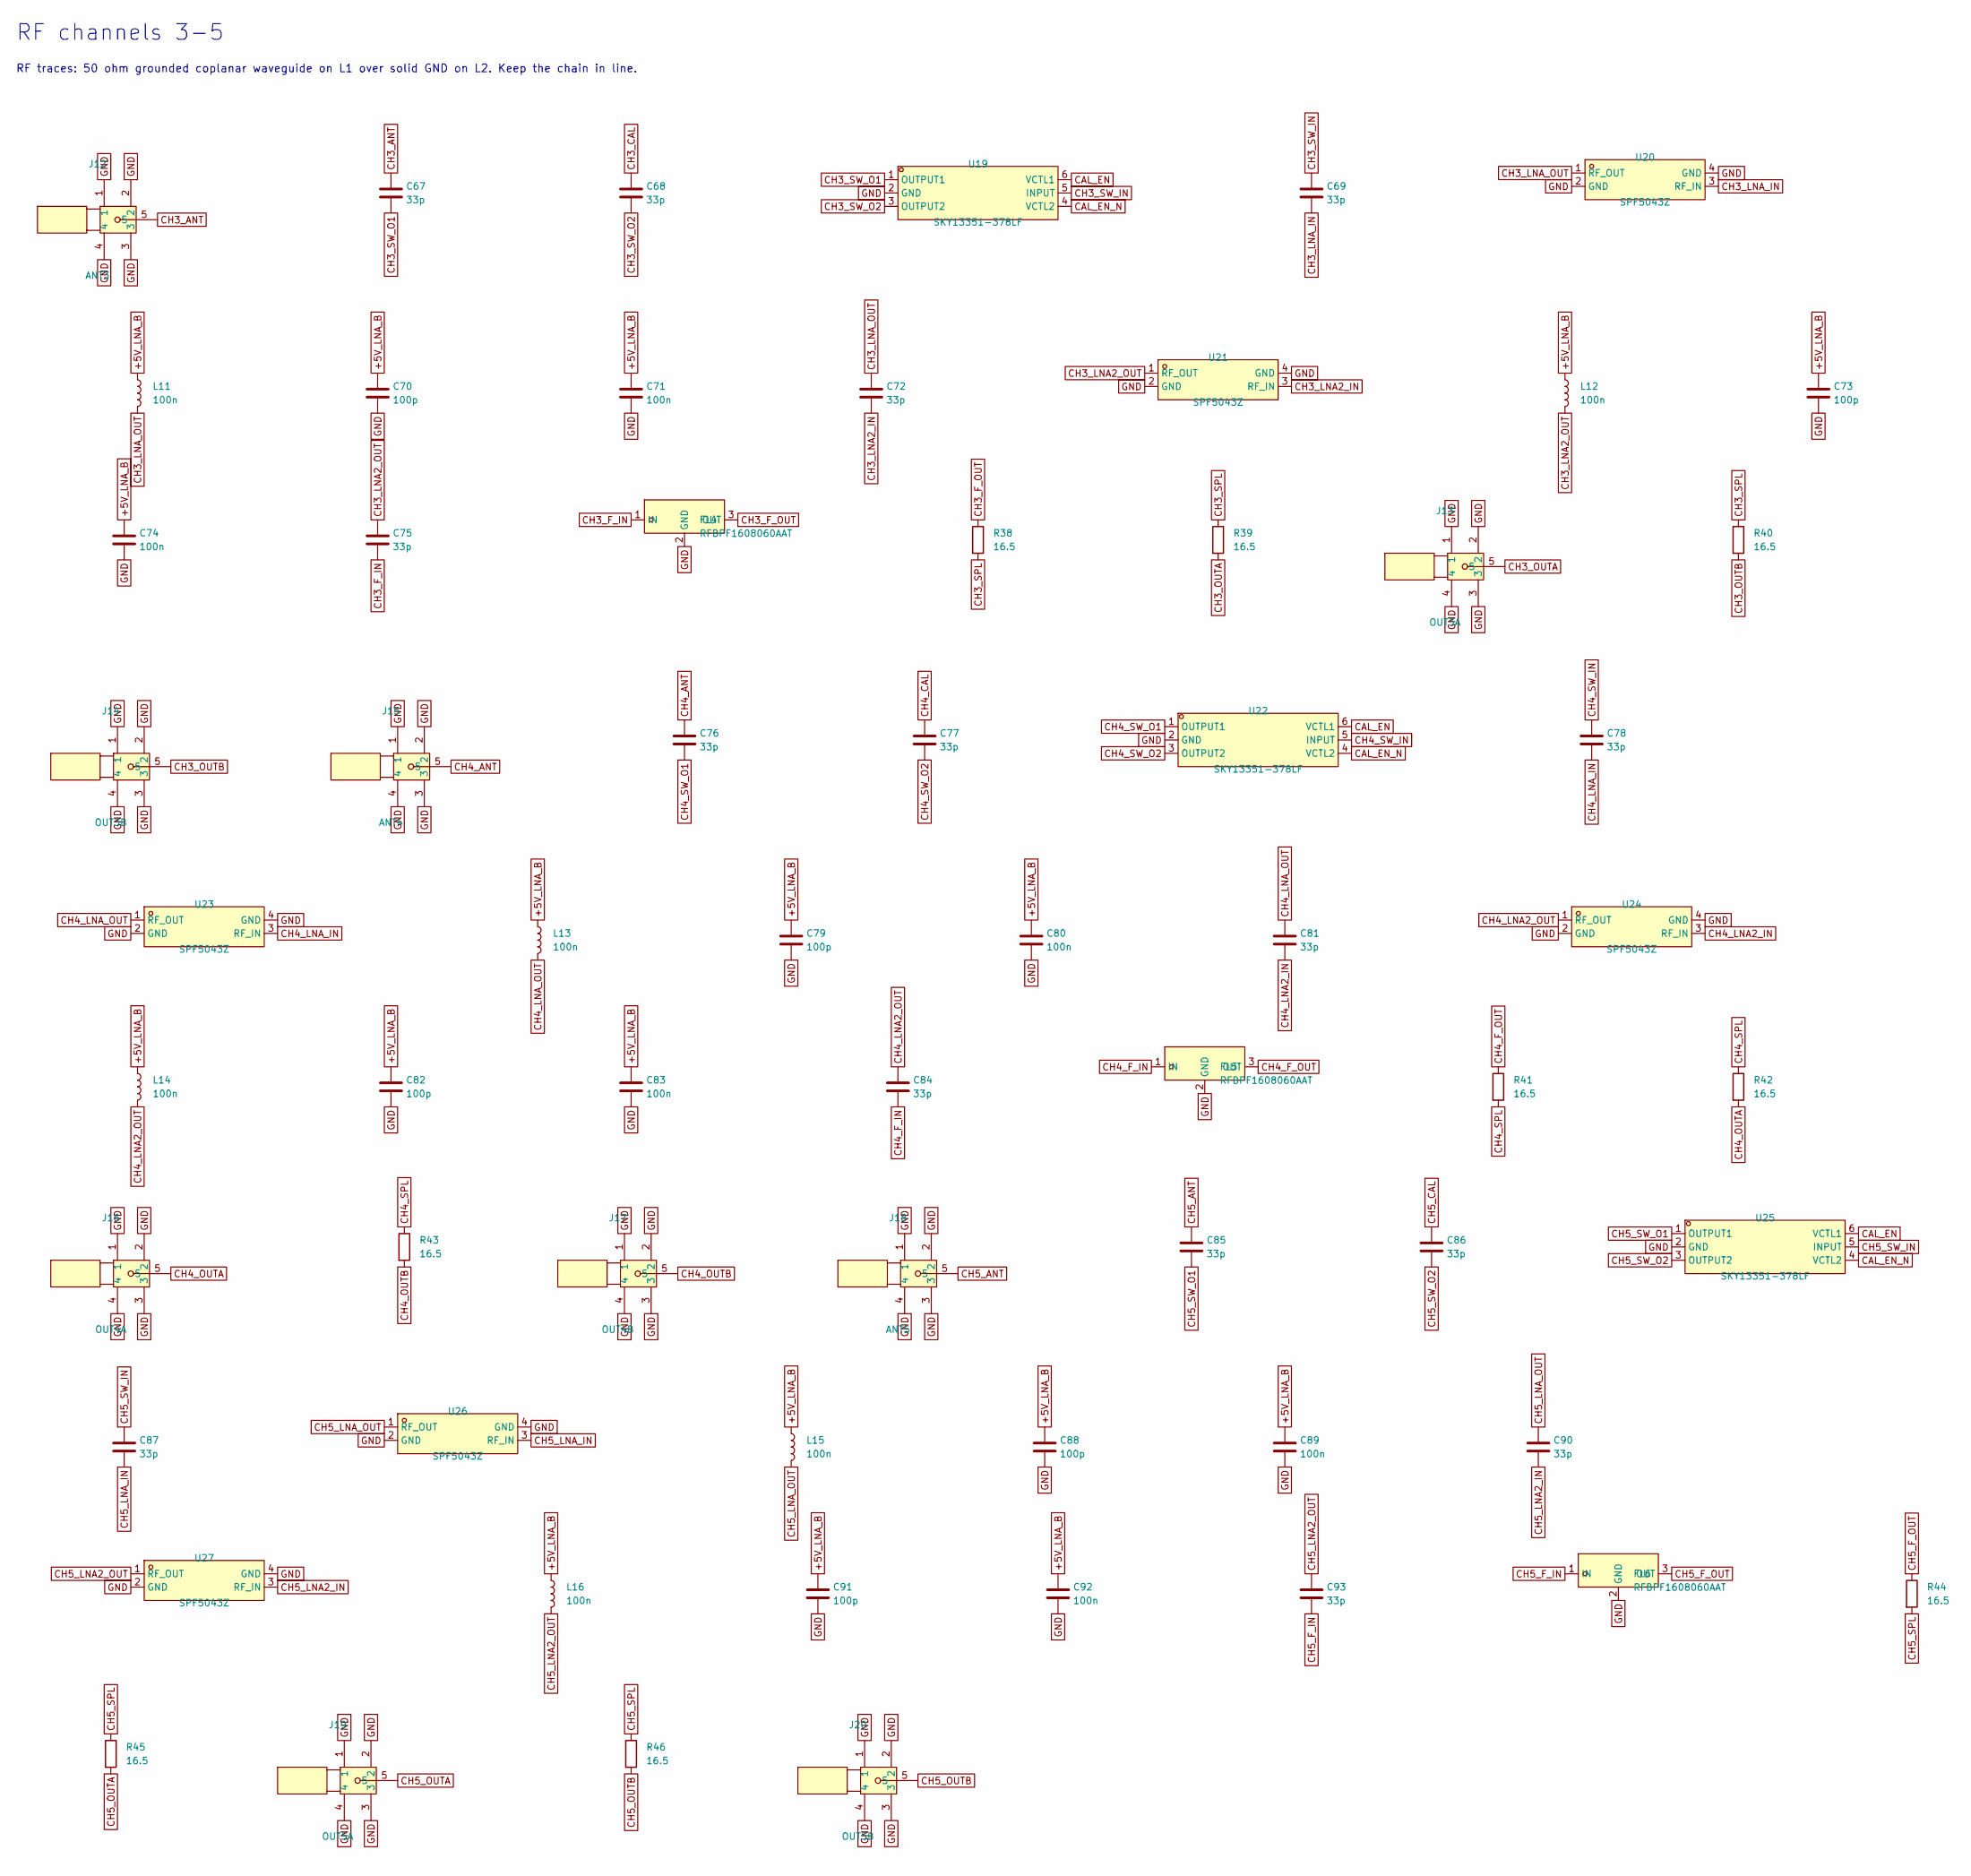
[picture p91: schematic channels_1.kicad_sch]

Parts:
C67, C68, C69, C72, C75, C76, C77, C78, C81, C84, C85, C86, C87, C90, C93: 33p; C_0402_1005Metric
C70, C73, C79, C82, C88, C91: 100p; C_0402_1005Metric
C71, C74, C80, C83, C89, C92: 100n; C_0402_1005Metric; LCSC C1525
FL4, FL5, FL6: RFBPF1608060AAT; FILTER-SMD_0603-3P-L1.6-W0.8-L-2; MPN RFBPF1608060AAT; LCSC C474007
J12: ANT3; SMA-TH_BWSMA-KE-Z001; MPN BWSMA-KE-Z001; LCSC C496549
J13: OUT3A; SMA-TH_BWSMA-KE-Z001; MPN BWSMA-KE-Z001; LCSC C496549
J14: OUT3B; SMA-TH_BWSMA-KE-Z001; MPN BWSMA-KE-Z001; LCSC C496549
J15: ANT4; SMA-TH_BWSMA-KE-Z001; MPN BWSMA-KE-Z001; LCSC C496549
J16: OUT4A; SMA-TH_BWSMA-KE-Z001; MPN BWSMA-KE-Z001; LCSC C496549
J17: OUT4B; SMA-TH_BWSMA-KE-Z001; MPN BWSMA-KE-Z001; LCSC C496549
J18: ANT5; SMA-TH_BWSMA-KE-Z001; MPN BWSMA-KE-Z001; LCSC C496549
J19: OUT5A; SMA-TH_BWSMA-KE-Z001; MPN BWSMA-KE-Z001; LCSC C496549
J20: OUT5B; SMA-TH_BWSMA-KE-Z001; MPN BWSMA-KE-Z001; LCSC C496549
L11, L12, L13, L14, L15, L16: 100n; L_0603_1608Metric
R38, R39, R40, R41, R42, R43, R44, R45, R46: 16.5; R_0402_1005Metric
U19, U22, U25: SKY13351-378LF; DFN-6_L1.0-W1.0-P0.35-BL-EP0.15; MPN SKY13351-378LF; LCSC C129189
U20, U21, U23, U24, U26, U27: SPF5043Z; SOT343_L2.0-W1.3-P1.30-LS2.1-BL; MPN SPF5043Z; LCSC C470902

Connections:
+5V_LNA_B: C70.1, C71.1, C73.1, C74.1, C79.1, C80.1, C82.1, C83.1, C88.1, C89.1, C91.1, C92.1, L11.1, L12.1, L13.1, L14.1, L15.1, L16.1
CAL_EN: U19.6 (VCTL1), U22.6 (VCTL1), U25.6 (VCTL1)
CAL_EN_N: U19.4 (VCTL2), U22.4 (VCTL2), U25.4 (VCTL2)
CH3_ANT: C67.1, J12.5
CH3_CAL: C68.1
CH3_F_IN: C75.2, FL4.1 (IN)
CH3_F_OUT: FL4.3 (OUT), R38.1
CH3_LNA2_IN: C72.2, U21.3 (RF_IN)
CH3_LNA2_OUT: C75.1, L12.2, U21.1 (RF_OUT)
CH3_LNA_IN: C69.2, U20.3 (RF_IN)
CH3_LNA_OUT: C72.1, L11.2, U20.1 (RF_OUT)
CH3_OUTA: J13.5, R39.2
CH3_OUTB: J14.5, R40.2
CH3_SPL: R38.2, R39.1, R40.1
CH3_SW_IN: C69.1, U19.5 (INPUT)
CH3_SW_O1: C67.2, U19.1 (OUTPUT1)
CH3_SW_O2: C68.2, U19.3 (OUTPUT2)
CH4_ANT: C76.1, J15.5
CH4_CAL: C77.1
CH4_F_IN: C84.2, FL5.1 (IN)
CH4_F_OUT: FL5.3 (OUT), R41.1
CH4_LNA2_IN: C81.2, U24.3 (RF_IN)
CH4_LNA2_OUT: C84.1, L14.2, U24.1 (RF_OUT)
CH4_LNA_IN: C78.2, U23.3 (RF_IN)
CH4_LNA_OUT: C81.1, L13.2, U23.1 (RF_OUT)
CH4_OUTA: J16.5, R42.2
CH4_OUTB: J17.5, R43.2
CH4_SPL: R41.2, R42.1, R43.1
CH4_SW_IN: C78.1, U22.5 (INPUT)
CH4_SW_O1: C76.2, U22.1 (OUTPUT1)
CH4_SW_O2: C77.2, U22.3 (OUTPUT2)
CH5_ANT: C85.1, J18.5
CH5_CAL: C86.1
CH5_F_IN: C93.2, FL6.1 (IN)
CH5_F_OUT: FL6.3 (OUT), R44.1
CH5_LNA2_IN: C90.2, U27.3 (RF_IN)
CH5_LNA2_OUT: C93.1, L16.2, U27.1 (RF_OUT)
CH5_LNA_IN: C87.2, U26.3 (RF_IN)
CH5_LNA_OUT: C90.1, L15.2, U26.1 (RF_OUT)
CH5_OUTA: J19.5, R45.2
CH5_OUTB: J20.5, R46.2
CH5_SPL: R44.2, R45.1, R46.1
CH5_SW_IN: C87.1, U25.5 (INPUT)
CH5_SW_O1: C85.2, U25.1 (OUTPUT1)
CH5_SW_O2: C86.2, U25.3 (OUTPUT2)
GND: C70.2, C71.2, C73.2, C74.2, C79.2, C80.2, C82.2, C83.2, C88.2, C89.2, C91.2, C92.2, FL4.2 (GND), FL5.2 (GND), FL6.2 (GND), J12.1, J12.2, J12.3, J12.4, J13.1, J13.2, J13.3, J13.4, J14.1, J14.2, J14.3, J14.4, J15.1, J15.2, J15.3, J15.4, J16.1, J16.2, J16.3, J16.4, J17.1, J17.2, J17.3, J17.4, J18.1, J18.2, J18.3, J18.4, J19.1, J19.2, J19.3, J19.4, J20.1, J20.2, J20.3, J20.4, U19.2 (GND), U20.2 (GND), U20.4 (GND), U21.2 (GND), U21.4 (GND), U22.2 (GND), U23.2 (GND), U23.4 (GND), U24.2 (GND), U24.4 (GND), U25.2 (GND), U26.2 (GND), U26.4 (GND), U27.2 (GND), U27.4 (GND)

Notes on the sheet:
RF channels 3-5
RF traces: 50 ohm grounded coplanar waveguide on L1 over solid GND on L2. Keep the chain in line.
