ajisrawi/passive-radar-counter-drone/hardware/board_a2/n78/channels_0.kicad_sch

## KiCad design hardware/board_a2/n78/channels_0.kicad_sch (2026-10-28)

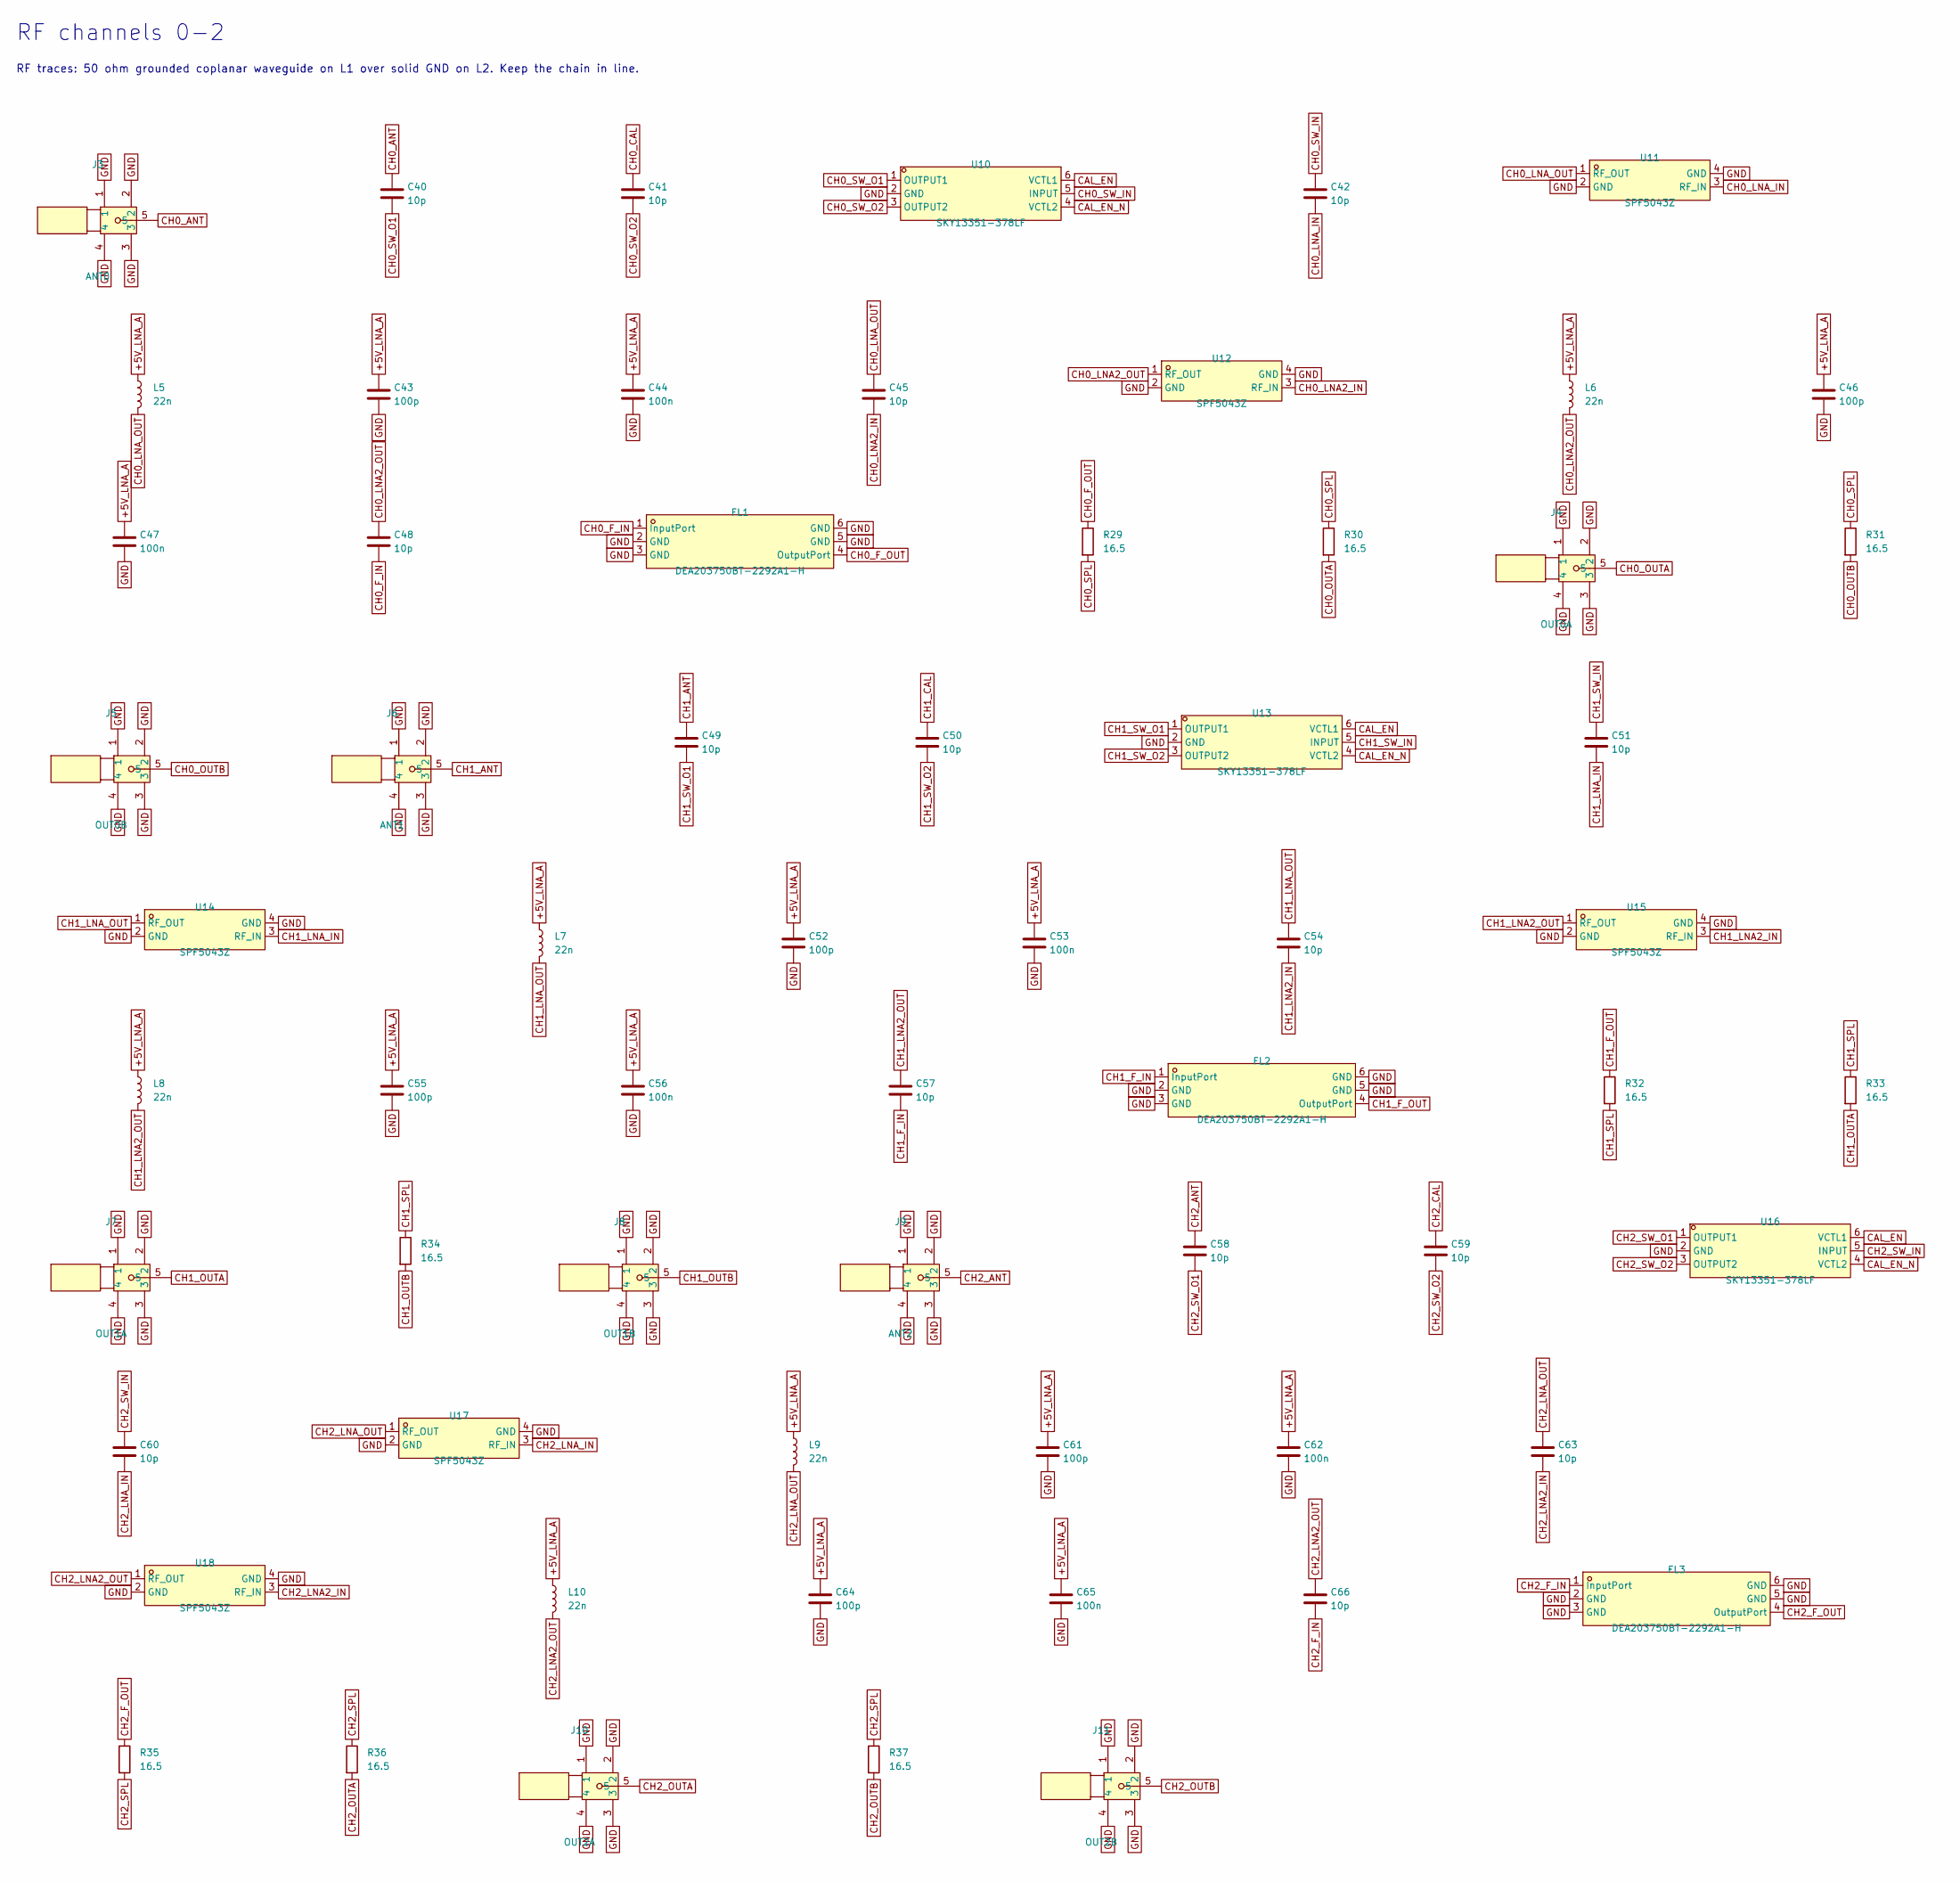
[picture p93: schematic channels_0.kicad_sch]

Parts:
C40, C41, C42, C45, C48, C49, C50, C51, C54, C57, C58, C59, C60, C63, C66: 10p; C_0402_1005Metric
C43, C46, C52, C55, C61, C64: 100p; C_0402_1005Metric
C44, C47, C53, C56, C62, C65: 100n; C_0402_1005Metric; LCSC C1525
FL1, FL2, FL3: DEA203750BT-2292A1-H; FILTER-SMD_0805-6P-L2.0-W1.3_DEA203600BT-2224A1-H; MPN DEA203750BT-2292A1-H; LCSC C3156235
J3: ANT0; SMA-TH_BWSMA-KE-Z001; MPN BWSMA-KE-Z001; LCSC C496549
J4: OUT0A; SMA-TH_BWSMA-KE-Z001; MPN BWSMA-KE-Z001; LCSC C496549
J5: OUT0B; SMA-TH_BWSMA-KE-Z001; MPN BWSMA-KE-Z001; LCSC C496549
J6: ANT1; SMA-TH_BWSMA-KE-Z001; MPN BWSMA-KE-Z001; LCSC C496549
J7: OUT1A; SMA-TH_BWSMA-KE-Z001; MPN BWSMA-KE-Z001; LCSC C496549
J8: OUT1B; SMA-TH_BWSMA-KE-Z001; MPN BWSMA-KE-Z001; LCSC C496549
J9: ANT2; SMA-TH_BWSMA-KE-Z001; MPN BWSMA-KE-Z001; LCSC C496549
J10: OUT2A; SMA-TH_BWSMA-KE-Z001; MPN BWSMA-KE-Z001; LCSC C496549
J11: OUT2B; SMA-TH_BWSMA-KE-Z001; MPN BWSMA-KE-Z001; LCSC C496549
L5, L6, L7, L8, L9, L10: 22n; L_0402_1005Metric
R29, R30, R31, R32, R33, R34, R35, R36, R37: 16.5; R_0402_1005Metric
U10, U13, U16: SKY13351-378LF; DFN-6_L1.0-W1.0-P0.35-BL-EP0.15; MPN SKY13351-378LF; LCSC C129189
U11, U12, U14, U15, U17, U18: SPF5043Z; SOT343_L2.0-W1.3-P1.30-LS2.1-BL; MPN SPF5043Z; LCSC C470902

Connections:
+5V_LNA_A: C43.1, C44.1, C46.1, C47.1, C52.1, C53.1, C55.1, C56.1, C61.1, C62.1, C64.1, C65.1, L5.1, L6.1, L7.1, L8.1, L9.1, L10.1
CAL_EN: U10.6 (VCTL1), U13.6 (VCTL1), U16.6 (VCTL1)
CAL_EN_N: U10.4 (VCTL2), U13.4 (VCTL2), U16.4 (VCTL2)
CH0_ANT: C40.1, J3.5
CH0_CAL: C41.1
CH0_F_IN: C48.2, FL1.1 (InputPort)
CH0_F_OUT: FL1.4 (OutputPort), R29.1
CH0_LNA2_IN: C45.2, U12.3 (RF_IN)
CH0_LNA2_OUT: C48.1, L6.2, U12.1 (RF_OUT)
CH0_LNA_IN: C42.2, U11.3 (RF_IN)
CH0_LNA_OUT: C45.1, L5.2, U11.1 (RF_OUT)
CH0_OUTA: J4.5, R30.2
CH0_OUTB: J5.5, R31.2
CH0_SPL: R29.2, R30.1, R31.1
CH0_SW_IN: C42.1, U10.5 (INPUT)
CH0_SW_O1: C40.2, U10.1 (OUTPUT1)
CH0_SW_O2: C41.2, U10.3 (OUTPUT2)
CH1_ANT: C49.1, J6.5
CH1_CAL: C50.1
CH1_F_IN: C57.2, FL2.1 (InputPort)
CH1_F_OUT: FL2.4 (OutputPort), R32.1
CH1_LNA2_IN: C54.2, U15.3 (RF_IN)
CH1_LNA2_OUT: C57.1, L8.2, U15.1 (RF_OUT)
CH1_LNA_IN: C51.2, U14.3 (RF_IN)
CH1_LNA_OUT: C54.1, L7.2, U14.1 (RF_OUT)
CH1_OUTA: J7.5, R33.2
CH1_OUTB: J8.5, R34.2
CH1_SPL: R32.2, R33.1, R34.1
CH1_SW_IN: C51.1, U13.5 (INPUT)
CH1_SW_O1: C49.2, U13.1 (OUTPUT1)
CH1_SW_O2: C50.2, U13.3 (OUTPUT2)
CH2_ANT: C58.1, J9.5
CH2_CAL: C59.1
CH2_F_IN: C66.2, FL3.1 (InputPort)
CH2_F_OUT: FL3.4 (OutputPort), R35.1
CH2_LNA2_IN: C63.2, U18.3 (RF_IN)
CH2_LNA2_OUT: C66.1, L10.2, U18.1 (RF_OUT)
CH2_LNA_IN: C60.2, U17.3 (RF_IN)
CH2_LNA_OUT: C63.1, L9.2, U17.1 (RF_OUT)
CH2_OUTA: J10.5, R36.2
CH2_OUTB: J11.5, R37.2
CH2_SPL: R35.2, R36.1, R37.1
CH2_SW_IN: C60.1, U16.5 (INPUT)
CH2_SW_O1: C58.2, U16.1 (OUTPUT1)
CH2_SW_O2: C59.2, U16.3 (OUTPUT2)
GND: C43.2, C44.2, C46.2, C47.2, C52.2, C53.2, C55.2, C56.2, C61.2, C62.2, C64.2, C65.2, FL1.2 (GND), FL1.3 (GND), FL1.5 (GND), FL1.6 (GND), FL2.2 (GND), FL2.3 (GND), FL2.5 (GND), FL2.6 (GND), FL3.2 (GND), FL3.3 (GND), FL3.5 (GND), FL3.6 (GND), J3.1, J3.2, J3.3, J3.4, J4.1, J4.2, J4.3, J4.4, J5.1, J5.2, J5.3, J5.4, J6.1, J6.2, J6.3, J6.4, J7.1, J7.2, J7.3, J7.4, J8.1, J8.2, J8.3, J8.4, J9.1, J9.2, J9.3, J9.4, J10.1, J10.2, J10.3, J10.4, J11.1, J11.2, J11.3, J11.4, U10.2 (GND), U11.2 (GND), U11.4 (GND), U12.2 (GND), U12.4 (GND), U13.2 (GND), U14.2 (GND), U14.4 (GND), U15.2 (GND), U15.4 (GND), U16.2 (GND), U17.2 (GND), U17.4 (GND), U18.2 (GND), U18.4 (GND)

Notes on the sheet:
RF channels 0-2
RF traces: 50 ohm grounded coplanar waveguide on L1 over solid GND on L2. Keep the chain in line.
