ajisrawi/passive-radar-counter-drone/hardware/board_a2/n78/noise_source.kicad_sch

## KiCad design hardware/board_a2/n78/noise_source.kicad_sch (2026-10-28)

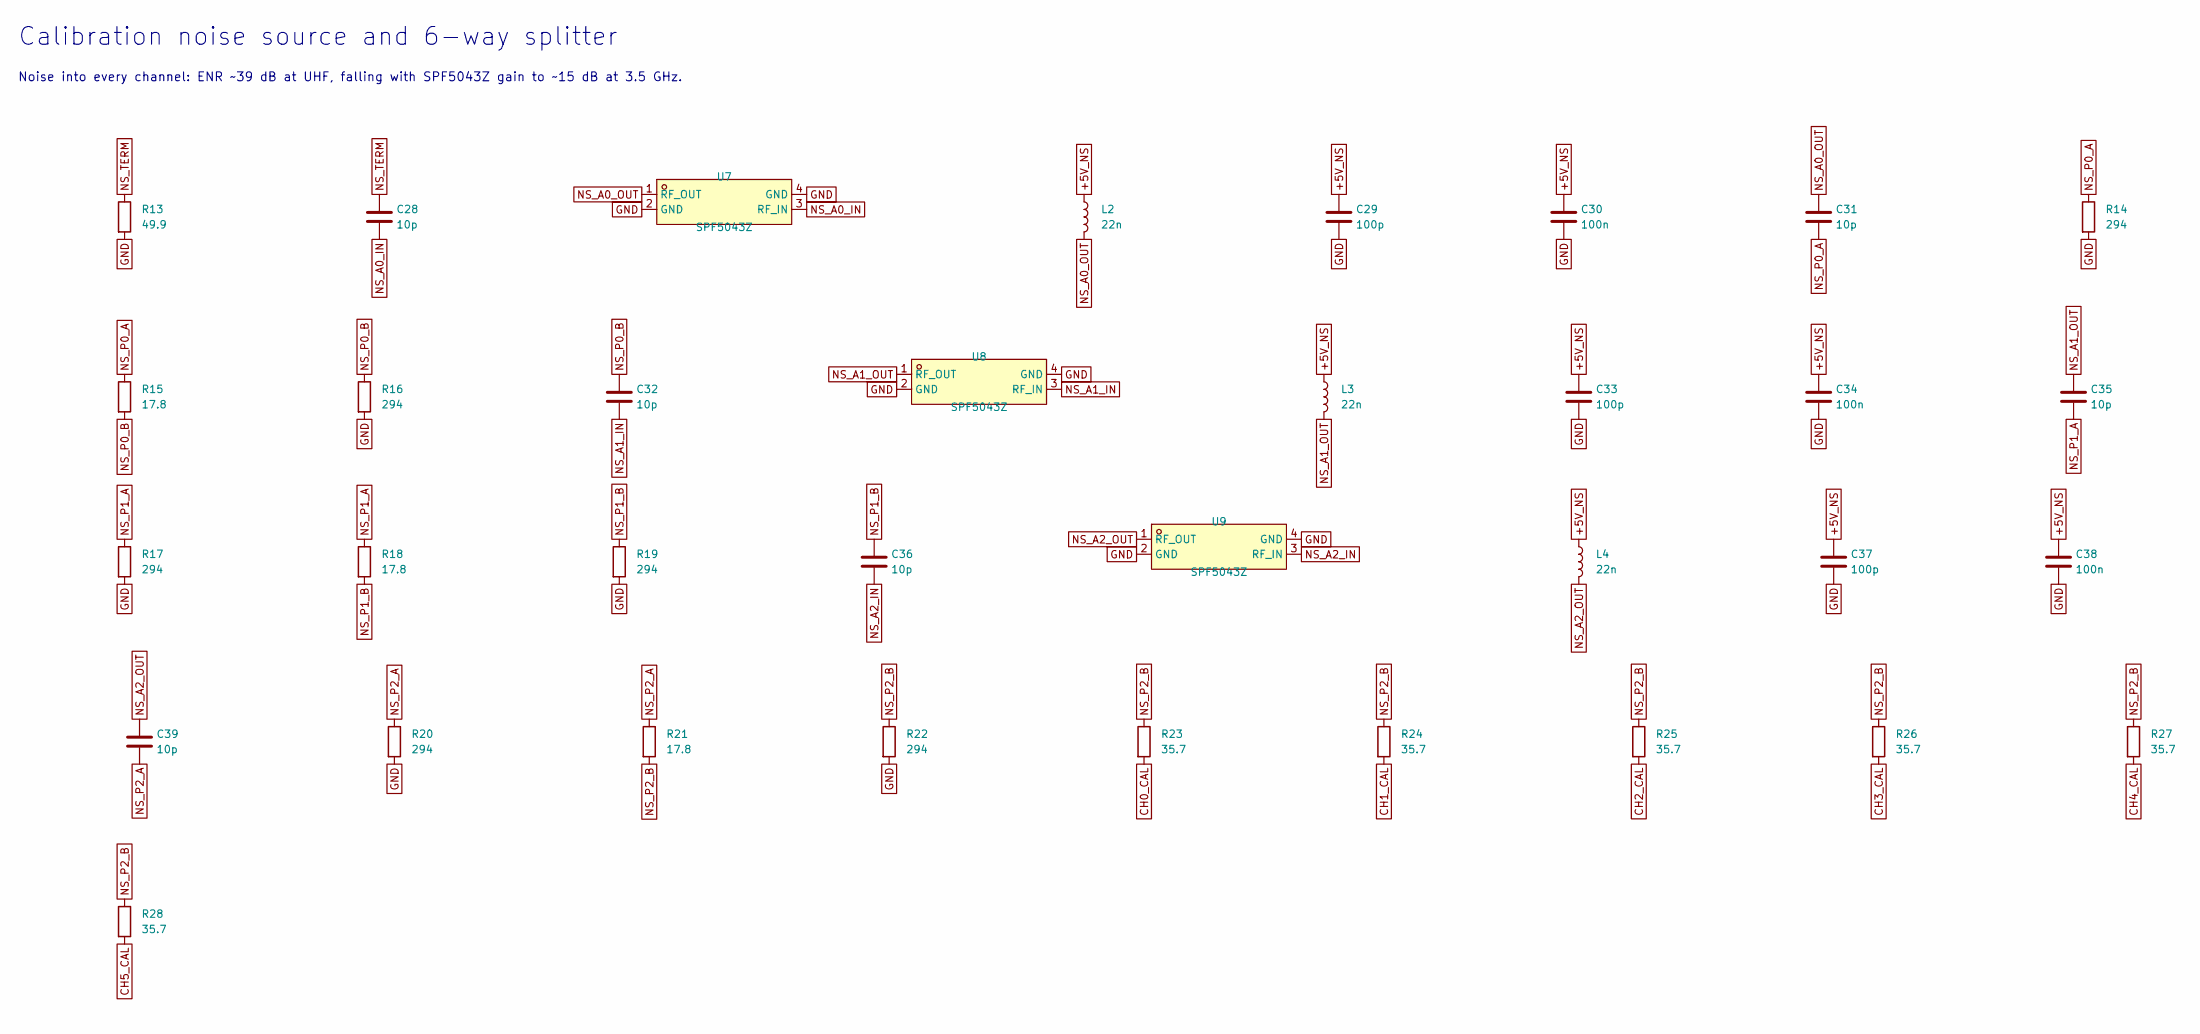
[picture p95: schematic noise_source.kicad_sch]

Parts:
C28, C31, C32, C35, C36, C39: 10p; C_0402_1005Metric
C29, C33, C37: 100p; C_0402_1005Metric
C30, C34, C38: 100n; C_0402_1005Metric; LCSC C1525
L2, L3, L4: 22n; L_0402_1005Metric
R13: 49.9; R_0402_1005Metric
R14, R16, R17, R19, R20, R22: 294; R_0402_1005Metric
R15, R18, R21: 17.8; R_0402_1005Metric
R23, R24, R25, R26, R27, R28: 35.7; R_0402_1005Metric
U7, U8, U9: SPF5043Z; SOT343_L2.0-W1.3-P1.30-LS2.1-BL; MPN SPF5043Z; LCSC C470902

Connections:
+5V_NS: C29.1, C30.1, C33.1, C34.1, C37.1, C38.1, L2.1, L3.1, L4.1
CH0_CAL: R23.2
CH1_CAL: R24.2
CH2_CAL: R25.2
CH3_CAL: R26.2
CH4_CAL: R27.2
CH5_CAL: R28.2
GND: C29.2, C30.2, C33.2, C34.2, C37.2, C38.2, R13.2, R14.2, R16.2, R17.2, R19.2, R20.2, R22.2, U7.2 (GND), U7.4 (GND), U8.2 (GND), U8.4 (GND), U9.2 (GND), U9.4 (GND)
NS_A0_IN: C28.2, U7.3 (RF_IN)
NS_A0_OUT: C31.1, L2.2, U7.1 (RF_OUT)
NS_A1_IN: C32.2, U8.3 (RF_IN)
NS_A1_OUT: C35.1, L3.2, U8.1 (RF_OUT)
NS_A2_IN: C36.2, U9.3 (RF_IN)
NS_A2_OUT: C39.1, L4.2, U9.1 (RF_OUT)
NS_P0_A: C31.2, R14.1, R15.1
NS_P0_B: C32.1, R15.2, R16.1
NS_P1_A: C35.2, R17.1, R18.1
NS_P1_B: C36.1, R18.2, R19.1
NS_P2_A: C39.2, R20.1, R21.1
NS_P2_B: R21.2, R22.1, R23.1, R24.1, R25.1, R26.1, R27.1, R28.1
NS_TERM: C28.1, R13.1

Notes on the sheet:
Calibration noise source and 6-way splitter
Noise into every channel: ENR ~39 dB at UHF, falling with SPF5043Z gain to ~15 dB at 3.5 GHz.
