ajisrawi/passive-radar-counter-drone/hardware/board_a2/uhf/channels_1.kicad_sch

## KiCad design hardware/board_a2/uhf/channels_1.kicad_sch (2026-10-28)

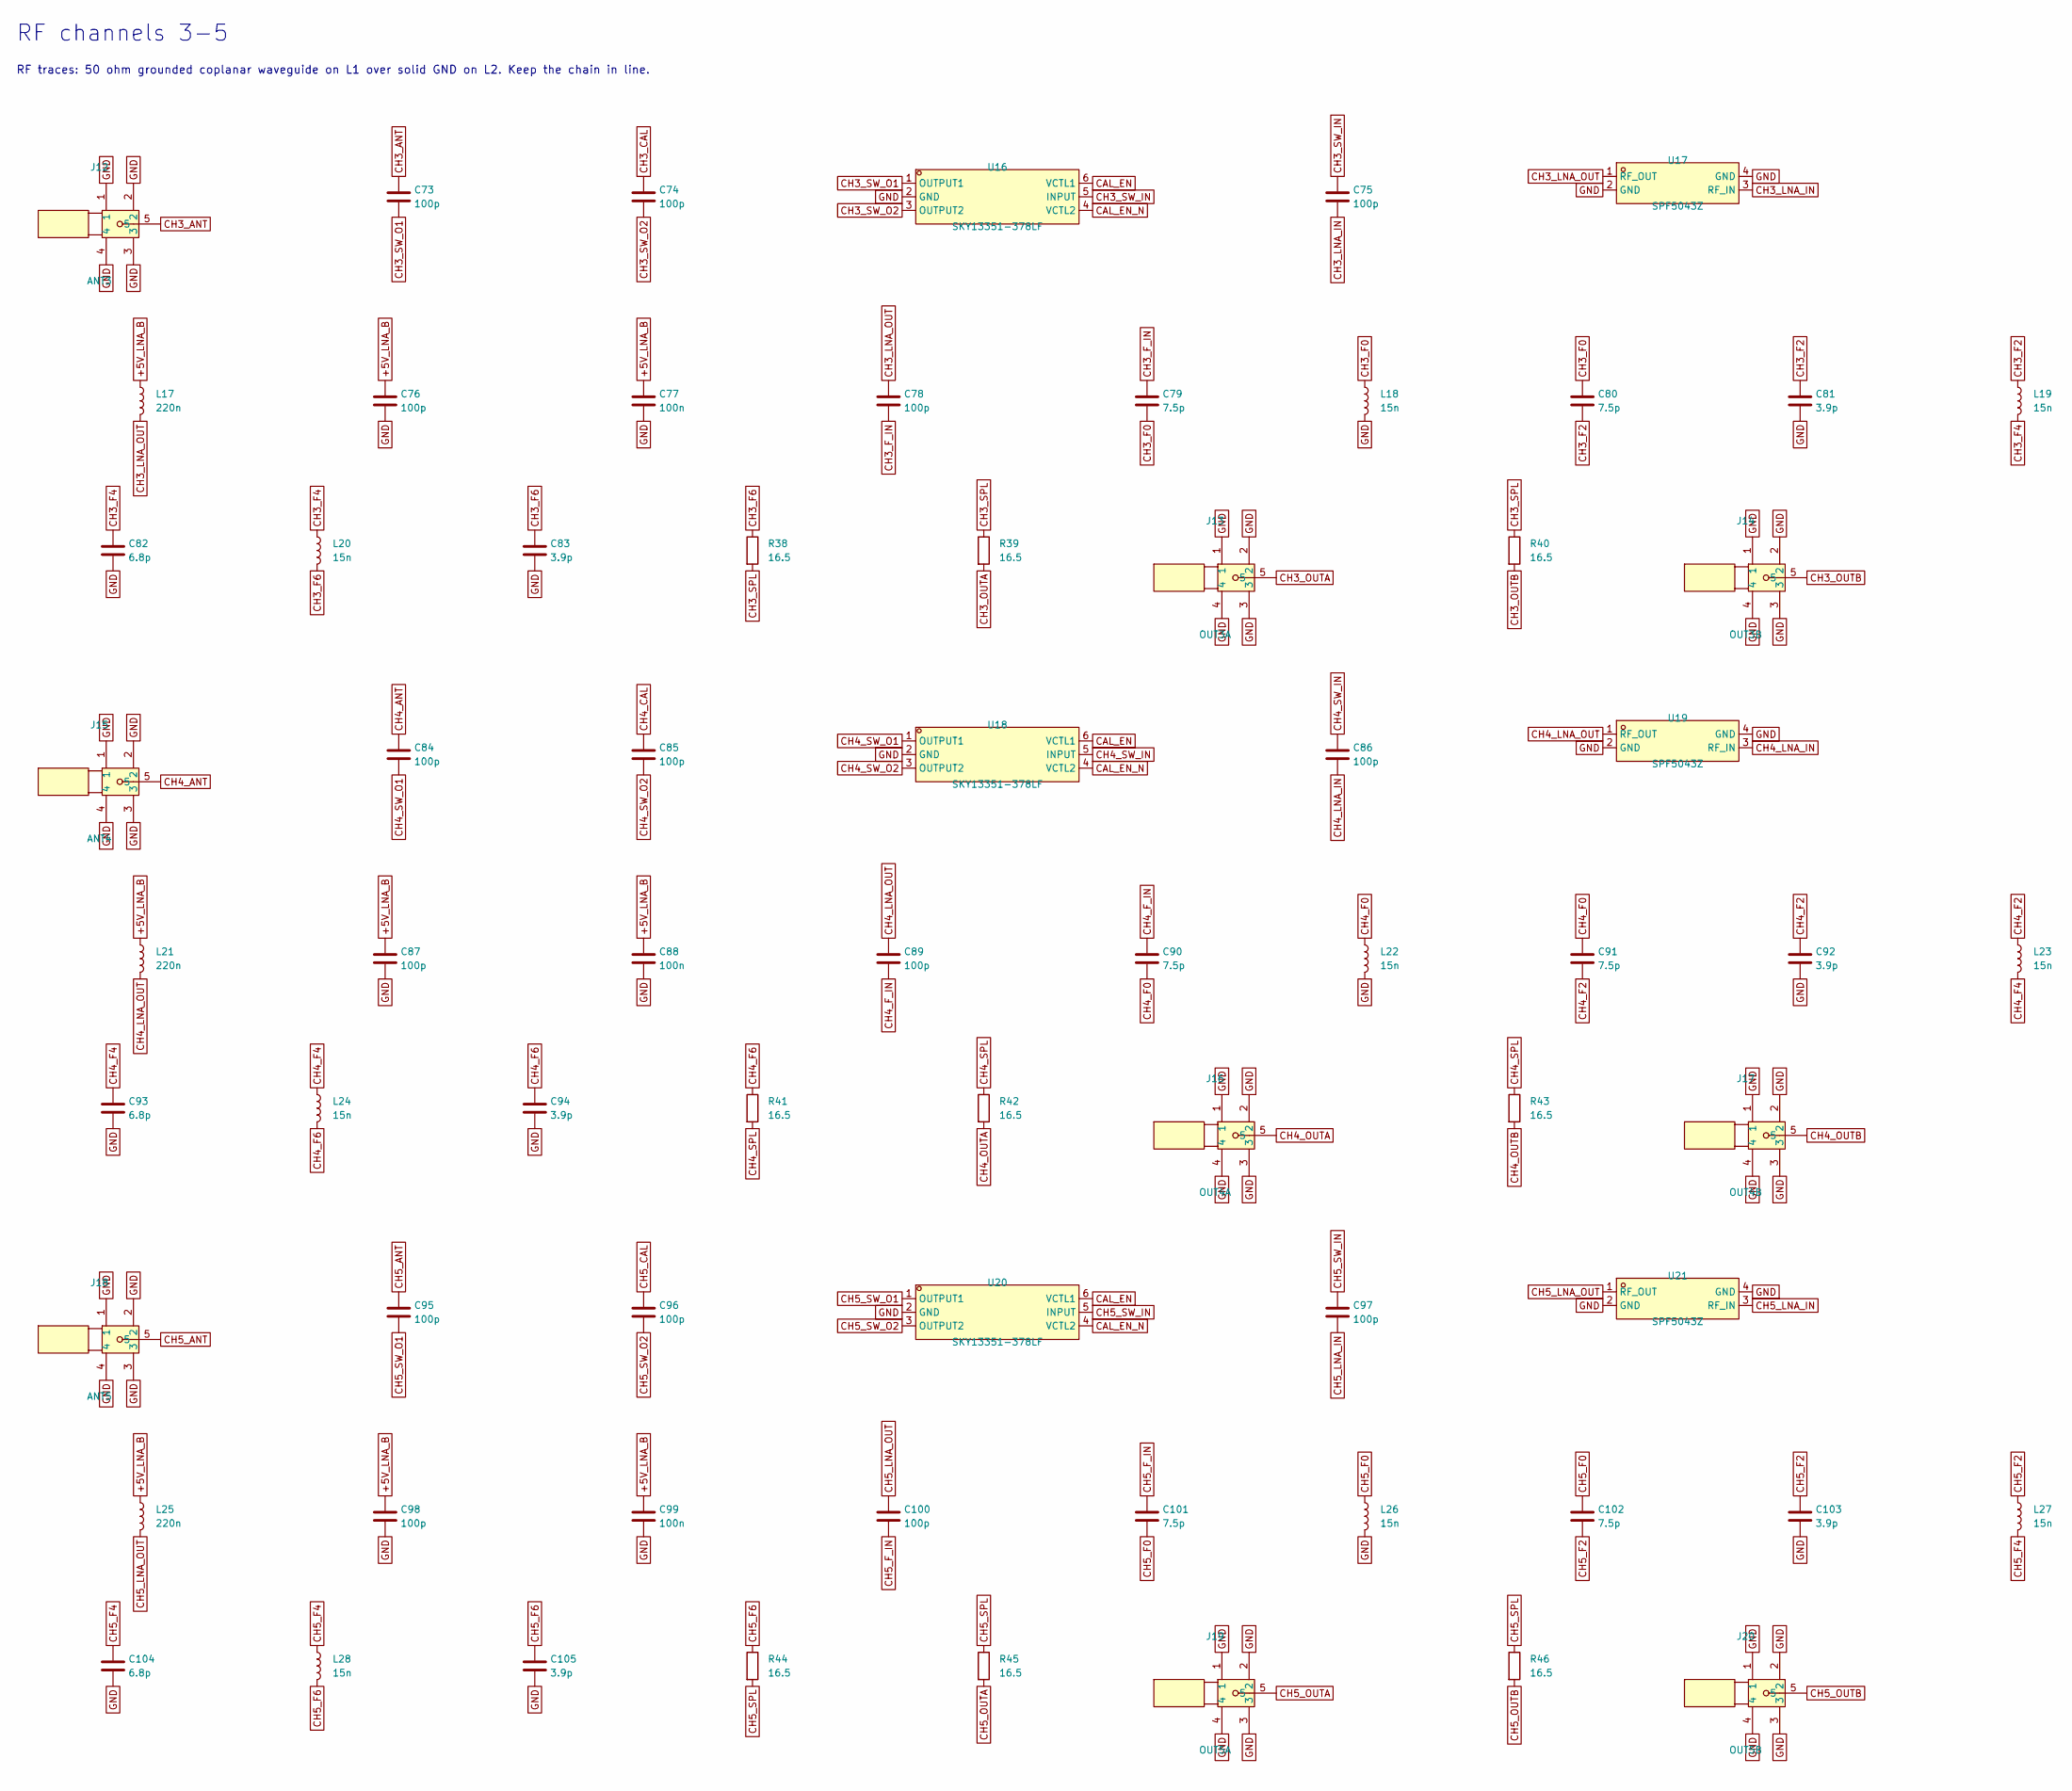
[picture p97: schematic channels_1.kicad_sch]

Parts:
C73, C74, C75, C76, C78, C84, C85, C86, C87, C89, C95, C96, C97, C98, C100: 100p; C_0402_1005Metric
C77, C88, C99: 100n; C_0402_1005Metric; LCSC C1525
C79, C80, C90, C91, C101, C102: 7.5p; C_0402_1005Metric
C81, C83, C92, C94, C103, C105: 3.9p; C_0402_1005Metric
C82, C93, C104: 6.8p; C_0402_1005Metric
J12: ANT3; SMA-TH_BWSMA-KE-Z001; MPN BWSMA-KE-Z001; LCSC C496549
J13: OUT3A; SMA-TH_BWSMA-KE-Z001; MPN BWSMA-KE-Z001; LCSC C496549
J14: OUT3B; SMA-TH_BWSMA-KE-Z001; MPN BWSMA-KE-Z001; LCSC C496549
J15: ANT4; SMA-TH_BWSMA-KE-Z001; MPN BWSMA-KE-Z001; LCSC C496549
J16: OUT4A; SMA-TH_BWSMA-KE-Z001; MPN BWSMA-KE-Z001; LCSC C496549
J17: OUT4B; SMA-TH_BWSMA-KE-Z001; MPN BWSMA-KE-Z001; LCSC C496549
J18: ANT5; SMA-TH_BWSMA-KE-Z001; MPN BWSMA-KE-Z001; LCSC C496549
J19: OUT5A; SMA-TH_BWSMA-KE-Z001; MPN BWSMA-KE-Z001; LCSC C496549
J20: OUT5B; SMA-TH_BWSMA-KE-Z001; MPN BWSMA-KE-Z001; LCSC C496549
L17, L21, L25: 220n; L_0603_1608Metric
L18, L19, L20, L22, L23, L24, L26, L27, L28: 15n; L_0402_1005Metric
R38, R39, R40, R41, R42, R43, R44, R45, R46: 16.5; R_0402_1005Metric
U16, U18, U20: SKY13351-378LF; DFN-6_L1.0-W1.0-P0.35-BL-EP0.15; MPN SKY13351-378LF; LCSC C129189
U17, U19, U21: SPF5043Z; SOT343_L2.0-W1.3-P1.30-LS2.1-BL; MPN SPF5043Z; LCSC C470902

Connections:
+5V_LNA_B: C76.1, C77.1, C87.1, C88.1, C98.1, C99.1, L17.1, L21.1, L25.1
CAL_EN: U16.6 (VCTL1), U18.6 (VCTL1), U20.6 (VCTL1)
CAL_EN_N: U16.4 (VCTL2), U18.4 (VCTL2), U20.4 (VCTL2)
CH3_ANT: C73.1, J12.5
CH3_CAL: C74.1
CH3_F0: C79.2, C80.1, L18.1
CH3_F2: C80.2, C81.1, L19.1
CH3_F4: C82.1, L19.2, L20.1
CH3_F6: C83.1, L20.2, R38.1
CH3_F_IN: C78.2, C79.1
CH3_LNA_IN: C75.2, U17.3 (RF_IN)
CH3_LNA_OUT: C78.1, L17.2, U17.1 (RF_OUT)
CH3_OUTA: J13.5, R39.2
CH3_OUTB: J14.5, R40.2
CH3_SPL: R38.2, R39.1, R40.1
CH3_SW_IN: C75.1, U16.5 (INPUT)
CH3_SW_O1: C73.2, U16.1 (OUTPUT1)
CH3_SW_O2: C74.2, U16.3 (OUTPUT2)
CH4_ANT: C84.1, J15.5
CH4_CAL: C85.1
CH4_F0: C90.2, C91.1, L22.1
CH4_F2: C91.2, C92.1, L23.1
CH4_F4: C93.1, L23.2, L24.1
CH4_F6: C94.1, L24.2, R41.1
CH4_F_IN: C89.2, C90.1
CH4_LNA_IN: C86.2, U19.3 (RF_IN)
CH4_LNA_OUT: C89.1, L21.2, U19.1 (RF_OUT)
CH4_OUTA: J16.5, R42.2
CH4_OUTB: J17.5, R43.2
CH4_SPL: R41.2, R42.1, R43.1
CH4_SW_IN: C86.1, U18.5 (INPUT)
CH4_SW_O1: C84.2, U18.1 (OUTPUT1)
CH4_SW_O2: C85.2, U18.3 (OUTPUT2)
CH5_ANT: C95.1, J18.5
CH5_CAL: C96.1
CH5_F0: C101.2, C102.1, L26.1
CH5_F2: C102.2, C103.1, L27.1
CH5_F4: C104.1, L27.2, L28.1
CH5_F6: C105.1, L28.2, R44.1
CH5_F_IN: C100.2, C101.1
CH5_LNA_IN: C97.2, U21.3 (RF_IN)
CH5_LNA_OUT: C100.1, L25.2, U21.1 (RF_OUT)
CH5_OUTA: J19.5, R45.2
CH5_OUTB: J20.5, R46.2
CH5_SPL: R44.2, R45.1, R46.1
CH5_SW_IN: C97.1, U20.5 (INPUT)
CH5_SW_O1: C95.2, U20.1 (OUTPUT1)
CH5_SW_O2: C96.2, U20.3 (OUTPUT2)
GND: C76.2, C77.2, C81.2, C82.2, C83.2, C87.2, C88.2, C92.2, C93.2, C94.2, C98.2, C99.2, C103.2, C104.2, C105.2, J12.1, J12.2, J12.3, J12.4, J13.1, J13.2, J13.3, J13.4, J14.1, J14.2, J14.3, J14.4, J15.1, J15.2, J15.3, J15.4, J16.1, J16.2, J16.3, J16.4, J17.1, J17.2, J17.3, J17.4, J18.1, J18.2, J18.3, J18.4, J19.1, J19.2, J19.3, J19.4, J20.1, J20.2, J20.3, J20.4, L18.2, L22.2, L26.2, U16.2 (GND), U17.2 (GND), U17.4 (GND), U18.2 (GND), U19.2 (GND), U19.4 (GND), U20.2 (GND), U21.2 (GND), U21.4 (GND)

Notes on the sheet:
RF channels 3-5
RF traces: 50 ohm grounded coplanar waveguide on L1 over solid GND on L2. Keep the chain in line.
