ajisrawi/passive-radar-counter-drone/hardware/board_b_bands/high/ad9361_1.kicad_sch

## KiCad design hardware/board_b_bands/high/ad9361_1.kicad_sch (2026-10-28)


Parts:
C1, C7, C12, C14, C17, C19: 1u; C_0402_1005Metric; LCSC C52923
C2, C3, C4, C5, C6, C8, C9, C10, C11, C13, C15, C16, C18, C20, C21, C22: 100n; C_0402_1005Metric; LCSC C1525
FB1, FB2, FB3, FB4: 600R@100MHz; L_0603_1608Metric
R1: 14.3k; R_0402_1005Metric; Tolerance 1%
R2: 22; R_0402_1005Metric
R3, R4, R5, R6, R7: 10k; R_0402_1005Metric; LCSC C25744
U1: AD9361BBCZ; CSPBGA-144_L10.0-W10.0-R12-C12-P0.80-BL; MPN AD9361BBCZ; LCSC C515884

Connections:
+3V3: C22.1, U1.B8 (VDD_GPO)
AD1_1V3: FB1.1, FB2.1, FB3.1, FB4.1
AD1_1V3_BB: C12.1, C13.1, FB3.2, U1.K4 (VDDA1P3_BB)
AD1_1V3_DIG: C14.1, C15.1, C16.1, FB4.2, U1.F12 (VDDD1P3_DIG)
AD1_1V3_RF: C1.1, C2.1, C3.1, C4.1, C5.1, C6.1, FB1.2, U1.B9 (VDDA1P3_TX_LO), U1.D2 (VDDA1P3_RX_RF), U1.D3 (VDDA1P3_RX_TX), U1.E2 (VDDA1P3_RX_LO), U1.E3 (VDDA1P3_TX_LO_BUFFER)
AD1_1V3_SYN: C7.1, C8.1, C9.1, C10.1, C11.1, FB2.2, U1.B10 (VDDA1P3_TX_VCO_LDO), U1.F2 (VDDA1P3_RX_VCO_LDO), U1.J3 (VDDA1P3_RX_SYNTH), U1.K3 (VDDA1P3_TX_SYNTH)
AD1_DCLK_N: U1.H11 (DATA_CLK_N)
AD1_DCLK_P: U1.G11 (DATA_CLK_P)
AD1_FBCLK_N: U1.G10 (FB_CLK_N)
AD1_FBCLK_P: U1.F10 (FB_CLK_P)
AD1_FRAME_N: U1.G7 (RX_FRAME_N)
AD1_FRAME_P: U1.G8 (RX_FRAME_P)
AD1_RBIAS: R1.1, U1.L4 (RBIAS)
AD1_RXD0_N: U1.K11 (P1_D0/RX_D0_N)
AD1_RXD0_P: U1.J12 (P1_D1/RX_D0_P)
AD1_RXD1_N: U1.K10 (P1_D2/RX_D1_N)
AD1_RXD1_P: U1.J11 (P1_D3/RX_D1_P)
AD1_RXD2_N: U1.K9 (P1_D4/RX_D2_N)
AD1_RXD2_P: U1.J10 (P1_D5/RX_D2_P)
AD1_RXD3_N: U1.K8 (P1_D6/RX_D3_N)
AD1_RXD3_P: U1.J9 (P1_D7/RX_D3_P)
AD1_RXD4_N: U1.K7 (P1_D8/RX_D4_N)
AD1_RXD4_P: U1.J8 (P1_D9/RX_D4_P)
AD1_RXD5_N: U1.J7 (P1_D10/RX_D5_N)
AD1_RXD5_P: U1.H8 (P1_D11/RX_D5_P)
AD1_RXVCO_1V1: C17.1, C18.1, U1.G2 (RX_VCO_LDO_OUT), U1.G3 (VDDA1P1_RX_VCO)
AD1_SYNC: R2.2, U1.H5 (SYNC_IN)
AD1_TXVCO_1V1: C19.1, C20.1, U1.A11 (VDDA1P1_TX_VCO), U1.B11 (TX_VCO_LDO_OUT)
AD1_XTALN: U1.M12 (XTALN)
AD_ENABLE: R6.1, U1.G6 (ENABLE)
AD_EN_AGC: R5.1, U1.G5 (EN_AGC)
AD_RESETB: R4.1, U1.K5 (RESETB)
AD_SYNC_IN: R2.1
AD_TXNRX: R7.1, U1.H4 (TXNRX)
CH0_RXN: U1.M2 (RX1A_N)
CH0_RXP: U1.M1 (RX1A_P)
CH1_RXN: U1.A1 (RX2A_N)
CH1_RXP: U1.A2 (RX2A_P)
GND: C1.2, C2.2, C3.2, C4.2, C5.2, C6.2, C7.2, C8.2, C9.2, C10.2, C11.2, C12.2, C13.2, C14.2, C15.2, C16.2, C17.2, C18.2, C19.2, C20.2, C21.2, C22.2, R1.2, R5.2, R6.2, R7.2, U1.A4 (VSSA), U1.A6 (VSSA), U1.B1 (VSSA), U1.B2 (VSSA), U1.B12 (VSSA), U1.C2 (VSSA), U1.C4 (TEST/ENABLE), U1.C5 (CTRL_IN0), U1.C6 (CTRL_IN1), U1.C7 (VSSA), U1.C8 (VSSA), U1.C9 (VSSA), U1.C10 (VSSA), U1.C11 (VSSA), U1.C12 (VSSA), U1.D5 (CTRL_IN3), U1.D6 (CTRL_IN2), U1.D12 (VSSD), U1.F3 (VSSA), U1.F7 (VSSD), U1.F9 (VSSD), U1.F11 (VSSD), U1.G12 (VSSD), U1.H2 (VSSA), U1.H3 (VSSA), U1.H6 (VSSA), U1.H7 (VSSD), U1.H10 (VSSD), U1.J2 (VSSA), U1.K2 (VSSA), U1.K12 (VSSD), U1.L2 (VSSA), U1.L3 (VSSA), U1.L7 (VSSA), U1.L8 (VSSA), U1.L9 (VSSA), U1.L10 (VSSA), U1.L11 (VSSA), U1.L12 (VSSA), U1.M4 (VSSA), U1.M6 (VSSA)
SPI_CLK: U1.J5 (SPI_CLK)
SPI_DI: U1.J4 (SPI_DI)
SPI_DO: U1.L6 (SPI_DO)
SPI_ENB1: R3.1, U1.K6 (SPI_ENB)
VADJ: C21.1, R3.2, R4.2, U1.H12 (VDD_INTERFACE)

Notes on the sheet:
AD9361 #1 (CH0, CH1)
Pin-strap/unused-pin handling follows ADI UG-570 and the AD-FMCOMMS2 reference design; verify.
