ajisrawi/passive-radar-counter-drone/hardware/board_b_bands/high/ad9361_2.kicad_sch

## KiCad design hardware/board_b_bands/high/ad9361_2.kicad_sch (2026-10-28)


Parts:
C23, C29, C34, C36, C39, C41: 1u; C_0402_1005Metric; LCSC C52923
C24, C25, C26, C27, C28, C30, C31, C32, C33, C35, C37, C38, C40, C42, C43, C44: 100n; C_0402_1005Metric; LCSC C1525
FB5, FB6, FB7, FB8: 600R@100MHz; L_0603_1608Metric
R8: 14.3k; R_0402_1005Metric; Tolerance 1%
R9: 22; R_0402_1005Metric
R10: 10k; R_0402_1005Metric; LCSC C25744
U2: AD9361BBCZ; CSPBGA-144_L10.0-W10.0-R12-C12-P0.80-BL; MPN AD9361BBCZ; LCSC C515884

Connections:
+3V3: C44.1, U2.B8 (VDD_GPO)
AD2_1V3: FB5.1, FB6.1, FB7.1, FB8.1
AD2_1V3_BB: C34.1, C35.1, FB7.2, U2.K4 (VDDA1P3_BB)
AD2_1V3_DIG: C36.1, C37.1, C38.1, FB8.2, U2.F12 (VDDD1P3_DIG)
AD2_1V3_RF: C23.1, C24.1, C25.1, C26.1, C27.1, C28.1, FB5.2, U2.B9 (VDDA1P3_TX_LO), U2.D2 (VDDA1P3_RX_RF), U2.D3 (VDDA1P3_RX_TX), U2.E2 (VDDA1P3_RX_LO), U2.E3 (VDDA1P3_TX_LO_BUFFER)
AD2_1V3_SYN: C29.1, C30.1, C31.1, C32.1, C33.1, FB6.2, U2.B10 (VDDA1P3_TX_VCO_LDO), U2.F2 (VDDA1P3_RX_VCO_LDO), U2.J3 (VDDA1P3_RX_SYNTH), U2.K3 (VDDA1P3_TX_SYNTH)
AD2_DCLK_N: U2.H11 (DATA_CLK_N)
AD2_DCLK_P: U2.G11 (DATA_CLK_P)
AD2_FBCLK_N: U2.G10 (FB_CLK_N)
AD2_FBCLK_P: U2.F10 (FB_CLK_P)
AD2_FRAME_N: U2.G7 (RX_FRAME_N)
AD2_FRAME_P: U2.G8 (RX_FRAME_P)
AD2_RBIAS: R8.1, U2.L4 (RBIAS)
AD2_RXD0_N: U2.K11 (P1_D0/RX_D0_N)
AD2_RXD0_P: U2.J12 (P1_D1/RX_D0_P)
AD2_RXD1_N: U2.K10 (P1_D2/RX_D1_N)
AD2_RXD1_P: U2.J11 (P1_D3/RX_D1_P)
AD2_RXD2_N: U2.K9 (P1_D4/RX_D2_N)
AD2_RXD2_P: U2.J10 (P1_D5/RX_D2_P)
AD2_RXD3_N: U2.K8 (P1_D6/RX_D3_N)
AD2_RXD3_P: U2.J9 (P1_D7/RX_D3_P)
AD2_RXD4_N: U2.K7 (P1_D8/RX_D4_N)
AD2_RXD4_P: U2.J8 (P1_D9/RX_D4_P)
AD2_RXD5_N: U2.J7 (P1_D10/RX_D5_N)
AD2_RXD5_P: U2.H8 (P1_D11/RX_D5_P)
AD2_RXVCO_1V1: C39.1, C40.1, U2.G2 (RX_VCO_LDO_OUT), U2.G3 (VDDA1P1_RX_VCO)
AD2_SYNC: R9.2, U2.H5 (SYNC_IN)
AD2_TXVCO_1V1: C41.1, C42.1, U2.A11 (VDDA1P1_TX_VCO), U2.B11 (TX_VCO_LDO_OUT)
AD2_XTALN: U2.M12 (XTALN)
AD_ENABLE: U2.G6 (ENABLE)
AD_EN_AGC: U2.G5 (EN_AGC)
AD_RESETB: U2.K5 (RESETB)
AD_SYNC_IN: R9.1
AD_TXNRX: U2.H4 (TXNRX)
CH2_RXN: U2.M2 (RX1A_N)
CH2_RXP: U2.M1 (RX1A_P)
CH3_RXN: U2.A1 (RX2A_N)
CH3_RXP: U2.A2 (RX2A_P)
GND: C23.2, C24.2, C25.2, C26.2, C27.2, C28.2, C29.2, C30.2, C31.2, C32.2, C33.2, C34.2, C35.2, C36.2, C37.2, C38.2, C39.2, C40.2, C41.2, C42.2, C43.2, C44.2, R8.2, U2.A4 (VSSA), U2.A6 (VSSA), U2.B1 (VSSA), U2.B2 (VSSA), U2.B12 (VSSA), U2.C2 (VSSA), U2.C4 (TEST/ENABLE), U2.C5 (CTRL_IN0), U2.C6 (CTRL_IN1), U2.C7 (VSSA), U2.C8 (VSSA), U2.C9 (VSSA), U2.C10 (VSSA), U2.C11 (VSSA), U2.C12 (VSSA), U2.D5 (CTRL_IN3), U2.D6 (CTRL_IN2), U2.D12 (VSSD), U2.F3 (VSSA), U2.F7 (VSSD), U2.F9 (VSSD), U2.F11 (VSSD), U2.G12 (VSSD), U2.H2 (VSSA), U2.H3 (VSSA), U2.H6 (VSSA), U2.H7 (VSSD), U2.H10 (VSSD), U2.J2 (VSSA), U2.K2 (VSSA), U2.K12 (VSSD), U2.L2 (VSSA), U2.L3 (VSSA), U2.L7 (VSSA), U2.L8 (VSSA), U2.L9 (VSSA), U2.L10 (VSSA), U2.L11 (VSSA), U2.L12 (VSSA), U2.M4 (VSSA), U2.M6 (VSSA)
SPI_CLK: U2.J5 (SPI_CLK)
SPI_DI: U2.J4 (SPI_DI)
SPI_DO: U2.L6 (SPI_DO)
SPI_ENB2: R10.1, U2.K6 (SPI_ENB)
VADJ: C43.1, R10.2, U2.H12 (VDD_INTERFACE)

Notes on the sheet:
AD9361 #2 (CH2, CH3)
Pin-strap/unused-pin handling follows ADI UG-570 and the AD-FMCOMMS2 reference design; verify.
