ajisrawi/passive-radar-counter-drone/hardware/board_b_bands/high/ad9361_3.kicad_sch

## KiCad design hardware/board_b_bands/high/ad9361_3.kicad_sch (2026-10-28)


Parts:
C45, C51, C56, C58, C61, C63: 1u; C_0402_1005Metric; LCSC C52923
C46, C47, C48, C49, C50, C52, C53, C54, C55, C57, C59, C60, C62, C64, C65, C66: 100n; C_0402_1005Metric; LCSC C1525
FB9, FB10, FB11, FB12: 600R@100MHz; L_0603_1608Metric
R11: 14.3k; R_0402_1005Metric; Tolerance 1%
R12: 22; R_0402_1005Metric
R13: 10k; R_0402_1005Metric; LCSC C25744
U3: AD9361BBCZ; CSPBGA-144_L10.0-W10.0-R12-C12-P0.80-BL; MPN AD9361BBCZ; LCSC C515884

Connections:
+3V3: C66.1, U3.B8 (VDD_GPO)
AD3_1V3: FB9.1, FB10.1, FB11.1, FB12.1
AD3_1V3_BB: C56.1, C57.1, FB11.2, U3.K4 (VDDA1P3_BB)
AD3_1V3_DIG: C58.1, C59.1, C60.1, FB12.2, U3.F12 (VDDD1P3_DIG)
AD3_1V3_RF: C45.1, C46.1, C47.1, C48.1, C49.1, C50.1, FB9.2, U3.B9 (VDDA1P3_TX_LO), U3.D2 (VDDA1P3_RX_RF), U3.D3 (VDDA1P3_RX_TX), U3.E2 (VDDA1P3_RX_LO), U3.E3 (VDDA1P3_TX_LO_BUFFER)
AD3_1V3_SYN: C51.1, C52.1, C53.1, C54.1, C55.1, FB10.2, U3.B10 (VDDA1P3_TX_VCO_LDO), U3.F2 (VDDA1P3_RX_VCO_LDO), U3.J3 (VDDA1P3_RX_SYNTH), U3.K3 (VDDA1P3_TX_SYNTH)
AD3_DCLK_N: U3.H11 (DATA_CLK_N)
AD3_DCLK_P: U3.G11 (DATA_CLK_P)
AD3_FBCLK_N: U3.G10 (FB_CLK_N)
AD3_FBCLK_P: U3.F10 (FB_CLK_P)
AD3_FRAME_N: U3.G7 (RX_FRAME_N)
AD3_FRAME_P: U3.G8 (RX_FRAME_P)
AD3_RBIAS: R11.1, U3.L4 (RBIAS)
AD3_RXD0_N: U3.K11 (P1_D0/RX_D0_N)
AD3_RXD0_P: U3.J12 (P1_D1/RX_D0_P)
AD3_RXD1_N: U3.K10 (P1_D2/RX_D1_N)
AD3_RXD1_P: U3.J11 (P1_D3/RX_D1_P)
AD3_RXD2_N: U3.K9 (P1_D4/RX_D2_N)
AD3_RXD2_P: U3.J10 (P1_D5/RX_D2_P)
AD3_RXD3_N: U3.K8 (P1_D6/RX_D3_N)
AD3_RXD3_P: U3.J9 (P1_D7/RX_D3_P)
AD3_RXD4_N: U3.K7 (P1_D8/RX_D4_N)
AD3_RXD4_P: U3.J8 (P1_D9/RX_D4_P)
AD3_RXD5_N: U3.J7 (P1_D10/RX_D5_N)
AD3_RXD5_P: U3.H8 (P1_D11/RX_D5_P)
AD3_RXVCO_1V1: C61.1, C62.1, U3.G2 (RX_VCO_LDO_OUT), U3.G3 (VDDA1P1_RX_VCO)
AD3_SYNC: R12.2, U3.H5 (SYNC_IN)
AD3_TXVCO_1V1: C63.1, C64.1, U3.A11 (VDDA1P1_TX_VCO), U3.B11 (TX_VCO_LDO_OUT)
AD3_XTALN: U3.M12 (XTALN)
AD_ENABLE: U3.G6 (ENABLE)
AD_EN_AGC: U3.G5 (EN_AGC)
AD_RESETB: U3.K5 (RESETB)
AD_SYNC_IN: R12.1
AD_TXNRX: U3.H4 (TXNRX)
CH4_RXN: U3.M2 (RX1A_N)
CH4_RXP: U3.M1 (RX1A_P)
CH5_RXN: U3.A1 (RX2A_N)
CH5_RXP: U3.A2 (RX2A_P)
GND: C45.2, C46.2, C47.2, C48.2, C49.2, C50.2, C51.2, C52.2, C53.2, C54.2, C55.2, C56.2, C57.2, C58.2, C59.2, C60.2, C61.2, C62.2, C63.2, C64.2, C65.2, C66.2, R11.2, U3.A4 (VSSA), U3.A6 (VSSA), U3.B1 (VSSA), U3.B2 (VSSA), U3.B12 (VSSA), U3.C2 (VSSA), U3.C4 (TEST/ENABLE), U3.C5 (CTRL_IN0), U3.C6 (CTRL_IN1), U3.C7 (VSSA), U3.C8 (VSSA), U3.C9 (VSSA), U3.C10 (VSSA), U3.C11 (VSSA), U3.C12 (VSSA), U3.D5 (CTRL_IN3), U3.D6 (CTRL_IN2), U3.D12 (VSSD), U3.F3 (VSSA), U3.F7 (VSSD), U3.F9 (VSSD), U3.F11 (VSSD), U3.G12 (VSSD), U3.H2 (VSSA), U3.H3 (VSSA), U3.H6 (VSSA), U3.H7 (VSSD), U3.H10 (VSSD), U3.J2 (VSSA), U3.K2 (VSSA), U3.K12 (VSSD), U3.L2 (VSSA), U3.L3 (VSSA), U3.L7 (VSSA), U3.L8 (VSSA), U3.L9 (VSSA), U3.L10 (VSSA), U3.L11 (VSSA), U3.L12 (VSSA), U3.M4 (VSSA), U3.M6 (VSSA)
SPI_CLK: U3.J5 (SPI_CLK)
SPI_DI: U3.J4 (SPI_DI)
SPI_DO: U3.L6 (SPI_DO)
SPI_ENB3: R13.1, U3.K6 (SPI_ENB)
VADJ: C65.1, R13.2, U3.H12 (VDD_INTERFACE)

Notes on the sheet:
AD9361 #3 (CH4, CH5)
Pin-strap/unused-pin handling follows ADI UG-570 and the AD-FMCOMMS2 reference design; verify.
