ajisrawi/passive-radar-counter-drone/hardware/board_b_bands/high/clock.kicad_sch

## KiCad design hardware/board_b_bands/high/clock.kicad_sch (2026-10-28)


Parts:
C85, C89, C90, C92, C93, C94: 100n; C_0402_1005Metric; LCSC C1525
C86: 10u; C_0603_1608Metric; LCSC C19702
C87, C88, C91: 1u; C_0402_1005Metric; LCSC C52923
J8: EXT_REF; SMA-TH_BWSMA-KE-Z001; MPN BWSMA-KE-Z001; LCSC C496549
R32, R33: 10k; R_0402_1005Metric; LCSC C25744
R34: 470; R_0402_1005Metric
R35: DNP; R_0402_1005Metric; not fitted
R36: 1.5k; R_0402_1005Metric
R37, R40, R43, R46: 33; R_0402_1005Metric
R38, R41, R44: 120; R_0402_1005Metric
R39, R42, R45: 100; R_0402_1005Metric
U4: TLV75525PDBVR; SOT-23-5
U5: LMK1C1104PWR; TSSOP-8_L4.4-W3.0-P0.65-LS6.4-TL; MPN LMK1C1104PWR; LCSC C1855734
Y1: 40MHz TCXO 0.5ppm; OSC-SMD_10P-L7.0-W5.0-BL; MPN BT0507BH3I507BN40B; LCSC C516506

Connections:
+2V5_CLK: C88.1, C89.1, C90.1, C91.1, U4.5 (OUT), U5.2 (1G), U5.6 (VDD)
+3V3: C85.1, C86.1, C87.1, R32.1, U4.1 (IN), U4.3 (EN), Y1.4 (VDD)
AD1_CK_A: R37.2, R38.1
AD1_CK_B: C92.1, R38.2, R39.1
AD1_XTALN: C92.2
AD2_CK_A: R40.2, R41.1
AD2_CK_B: C93.1, R41.2, R42.1
AD2_XTALN: C93.2
AD3_CK_A: R43.2, R44.1
AD3_CK_B: C94.1, R44.2, R45.1
AD3_XTALN: C94.2
CLK_Y0: R37.1, U5.3 (Y0)
CLK_Y1: R40.1, U5.8 (Y1)
CLK_Y2: R43.1, U5.5 (Y2)
CLK_Y3: R46.1, U5.7 (Y3)
EXT_REF: J8.5, R35.1
FPGA_REFCLK: R46.2
GND: C85.2, C86.2, C87.2, C88.2, C89.2, C90.2, C91.2, J8.1, J8.2, J8.3, J8.4, R33.2, R36.2, R39.2, R42.2, R45.2, U4.2 (GND), U5.4 (GND), Y1.2 (GND)
REF_SEL: R34.2, R35.2, R36.1, U5.1 (CLKIN)
TCXO_OUT: R34.1, Y1.3 (FO)
TCXO_VC: R32.2, R33.1, Y1.1 (VCON)

Notes on the sheet:
40 MHz reference distribution
All three XTALN traces must be length-matched (< 1 mm). FPGA_REFCLK -> FMC CLK0_M2C_P.
