ajisrawi/passive-radar-counter-drone/hardware/board_b_bands/high/fmc.kicad_sch

## KiCad design hardware/board_b_bands/high/fmc.kicad_sch (2026-10-28)


Parts:
J1: FMC LPC (mezzanine); FPC_SMD_ASP-134604-01; MPN ASP-134604-01; LCSC C2830435
J9: CAL_EN to board A; PinHeader_1x02_P2.54mm_Vertical
R57: 33; R_0402_1005Metric
R58: 100k; R_0402_1005Metric; LCSC C25741

Connections:
+3V3: J1.C39, J1.D36, J1.D38, J1.D40
+12V_FMC: J1.C35, J1.C37
AD1_DCLK_N: J1.G07
AD1_DCLK_P: J1.G06
AD1_FBCLK_N: J1.D15
AD1_FBCLK_P: J1.D14
AD1_FRAME_N: J1.H08
AD1_FRAME_P: J1.H07
AD1_RXD0_N: J1.G10
AD1_RXD0_P: J1.G09
AD1_RXD1_N: J1.H11
AD1_RXD1_P: J1.H10
AD1_RXD2_N: J1.D12
AD1_RXD2_P: J1.D11
AD1_RXD3_N: J1.C11
AD1_RXD3_P: J1.C10
AD1_RXD4_N: J1.H14
AD1_RXD4_P: J1.H13
AD1_RXD5_N: J1.G13
AD1_RXD5_P: J1.G12
AD2_DCLK_N: J1.D09
AD2_DCLK_P: J1.D08
AD2_FBCLK_N: J1.H23
AD2_FBCLK_P: J1.H22
AD2_FRAME_N: J1.C15
AD2_FRAME_P: J1.C14
AD2_RXD0_N: J1.H17
AD2_RXD0_P: J1.H16
AD2_RXD1_N: J1.G16
AD2_RXD1_P: J1.G15
AD2_RXD2_N: J1.D18
AD2_RXD2_P: J1.D17
AD2_RXD3_N: J1.C19
AD2_RXD3_P: J1.C18
AD2_RXD4_N: J1.H20
AD2_RXD4_P: J1.H19
AD2_RXD5_N: J1.G19
AD2_RXD5_P: J1.G18
AD3_DCLK_N: J1.D21
AD3_DCLK_P: J1.D20
AD3_FBCLK_N: J1.D27
AD3_FBCLK_P: J1.D26
AD3_FRAME_N: J1.C23
AD3_FRAME_P: J1.C22
AD3_RXD0_N: J1.G22
AD3_RXD0_P: J1.G21
AD3_RXD1_N: J1.H26
AD3_RXD1_P: J1.H25
AD3_RXD2_N: J1.G25
AD3_RXD2_P: J1.G24
AD3_RXD3_N: J1.D24
AD3_RXD3_P: J1.D23
AD3_RXD4_N: J1.H29
AD3_RXD4_P: J1.H28
AD3_RXD5_N: J1.G28
AD3_RXD5_P: J1.G27
AD_ENABLE: J1.H35
AD_EN_AGC: J1.H38
AD_RESETB: J1.H34
AD_SYNC_IN: J1.G34
AD_TXNRX: J1.G33
CAL_EN: J9.1, R57.2, R58.1
CAL_EN_FPGA: J1.H37, R57.1
FMC_TDI_TDO: J1.D30, J1.D31
FPGA_REFCLK: J1.H04
GND: J1.C01, J1.C04, J1.C05, J1.C08, J1.C09, J1.C12, J1.C13, J1.C16, J1.C17, J1.C20, J1.C21, J1.C24, J1.C25, J1.C28, J1.C29, J1.C32, J1.C33, J1.C36, J1.C38, J1.C40, J1.D02, J1.D03, J1.D06, J1.D07, J1.D10, J1.D13, J1.D16, J1.D19, J1.D22, J1.D25, J1.D28, J1.D37, J1.D39, J1.G01, J1.G04, J1.G05, J1.G08, J1.G11, J1.G14, J1.G17, J1.G20, J1.G23, J1.G26, J1.G29, J1.G32, J1.G35, J1.G38, J1.G40, J1.H02, J1.H03, J1.H06, J1.H09, J1.H12, J1.H15, J1.H18, J1.H21, J1.H24, J1.H27, J1.H30, J1.H33, J1.H36, J1.H39, J9.2, R58.2
PG_C2M: J1.D01
SPI_CLK: J1.C26
SPI_DI: J1.C27
SPI_DO: J1.H31
SPI_ENB1: J1.H32
SPI_ENB2: J1.G30
SPI_ENB3: J1.G31
VADJ: J1.G39, J1.H40

Notes on the sheet:
FMC LPC mezzanine connector
VADJ must be set to 2.5 V by the carrier (LVDS_25 banks). LA pair plan: tools/fmc.py.
