ajisrawi/passive-radar-counter-drone/hardware/board_b_bands/high/power.kicad_sch

## KiCad design hardware/board_b_bands/high/power.kicad_sch (2026-10-28)


Parts:
C95: 3.3n; C_0402_1005Metric
C96, C97, C120: 10u; C_0805_2012Metric
C98, C101, C104, C107, C110, C113, C116, C119: 100n; C_0402_1005Metric; LCSC C1525
C99, C100: 22u; C_0805_2012Metric; LCSC C45783
C102, C108, C114: 10n; C_0402_1005Metric; LCSC C15195
C103, C105, C109, C111, C115, C117, C121, C123: 10u; C_0603_1608Metric; LCSC C19702
C106, C112, C118, C122, C124: 1u; C_0402_1005Metric; LCSC C52923
H1, H2, H3, H4: M3; MountingHole_3.2mm_M3_Pad_Via
L1: 2.2u; L_Bourns-SRN4018; MPN SRN4018-2R2M
R47: 125k; R_0402_1005Metric
R48, R49, R56: 100k; R_0402_1005Metric; LCSC C25741
R50, R52, R54: 16k; R_0402_1005Metric; Tolerance 1%
R51, R53, R55: 10k; R_0402_1005Metric; Tolerance 1%; LCSC C25744
TP1: AD1_1V3; TestPoint_Pad_D1.0mm
TP2: AD2_1V3; TestPoint_Pad_D1.0mm
TP3: AD3_1V3; TestPoint_Pad_D1.0mm
TP4: +1V8; TestPoint_Pad_D1.0mm
U6: TPS62130RGTR; VQFN-16-1EP_3x3mm_P0.5mm_EP1.68x1.68mm; MPN TPS62130RGTR; LCSC C43590
U7, U8, U9: ADP1755ACPZ-R7; LFCSP-16_L4.0-W4.0-P0.65-BL-EP2.2; MPN ADP1755ACPZ-R7; LCSC C403695

Connections:
+1V8: C99.1, C100.1, C101.1, C103.1, C104.1, C109.1, C110.1, C115.1, C116.1, L1.2, R47.1, R49.2, TP4.1, U6.14 (VOS), U7.1 (VIN), U7.2 (VIN), U7.3 (VIN), U7.15 (VIN), U7.16 (VIN), U8.1 (VIN), U8.2 (VIN), U8.3 (VIN), U8.15 (VIN), U8.16 (VIN), U9.1 (VIN), U9.2 (VIN), U9.3 (VIN), U9.15 (VIN), U9.16 (VIN)
+3V3: C123.1, C124.1
+12V_FMC: C96.1, C97.1, C98.1, C120.1, U6.10 (VIN), U6.11 (VIN), U6.12 (VIN)
AD1_1V3: C105.1, C106.1, C107.1, R50.1, TP1.1, U7.10 (VOUT), U7.11 (VOUT), U7.12 (VOUT), U7.13 (VOUT), U7.14 (VOUT)
AD2_1V3: C111.1, C112.1, C113.1, R52.1, TP2.1, U8.10 (VOUT), U8.11 (VOUT), U8.12 (VOUT), U8.13 (VOUT), U8.14 (VOUT)
AD3_1V3: C117.1, C118.1, C119.1, R54.1, TP3.1, U9.10 (VOUT), U9.11 (VOUT), U9.12 (VOUT), U9.13 (VOUT), U9.14 (VOUT)
BUCK1V8_FB: R47.2, R48.1, U6.5 (FB)
BUCK1V8_SS: C95.1, U6.9 (SS/TR)
BUCK1V8_SW: L1.1, U6.1 (SW), U6.2 (SW), U6.3 (SW)
GND: C95.2, C96.2, C97.2, C98.2, C99.2, C100.2, C101.2, C102.2, C103.2, C104.2, C105.2, C106.2, C107.2, C108.2, C109.2, C110.2, C111.2, C112.2, C113.2, C114.2, C115.2, C116.2, C117.2, C118.2, C119.2, C120.2, C121.2, C122.2, C123.2, C124.2, H1.1, H2.1, H3.1, H4.1, R48.2, R51.2, R53.2, R55.2, R56.2, U6.6 (GND), U6.7 (FSW), U6.8 (DEF), U6.15 (GND), U6.16 (GND), U6.17 (GND), U7.6 (GND), U7.17 (EP), U8.6 (GND), U8.17 (EP), U9.6 (GND), U9.17 (EP)
LDO_AD1_ADJ: R50.2, R51.1, U7.9 (ADJ)
LDO_AD1_SS: C102.1, U7.7 (SS)
LDO_AD2_ADJ: R52.2, R53.1, U8.9 (ADJ)
LDO_AD2_SS: C108.1, U8.7 (SS)
LDO_AD3_ADJ: R54.2, R55.1, U9.9 (ADJ)
LDO_AD3_SS: C114.1, U9.7 (SS)
PG_1V8: R49.1, U6.4 (PG), U7.4 (EN), U8.4 (EN), U9.4 (EN)
PG_C2M: R56.1, U6.13 (EN)
VADJ: C121.1, C122.1

Notes on the sheet:
Power: 12 V -> 1.8 V -> 3 x 1.3 V low-noise LDOs
