ajisrawi/passive-radar-counter-drone/hardware/board_b_bands/n78/rf_inputs.kicad_sch

## KiCad design hardware/board_b_bands/n78/rf_inputs.kicad_sch (2026-10-28)

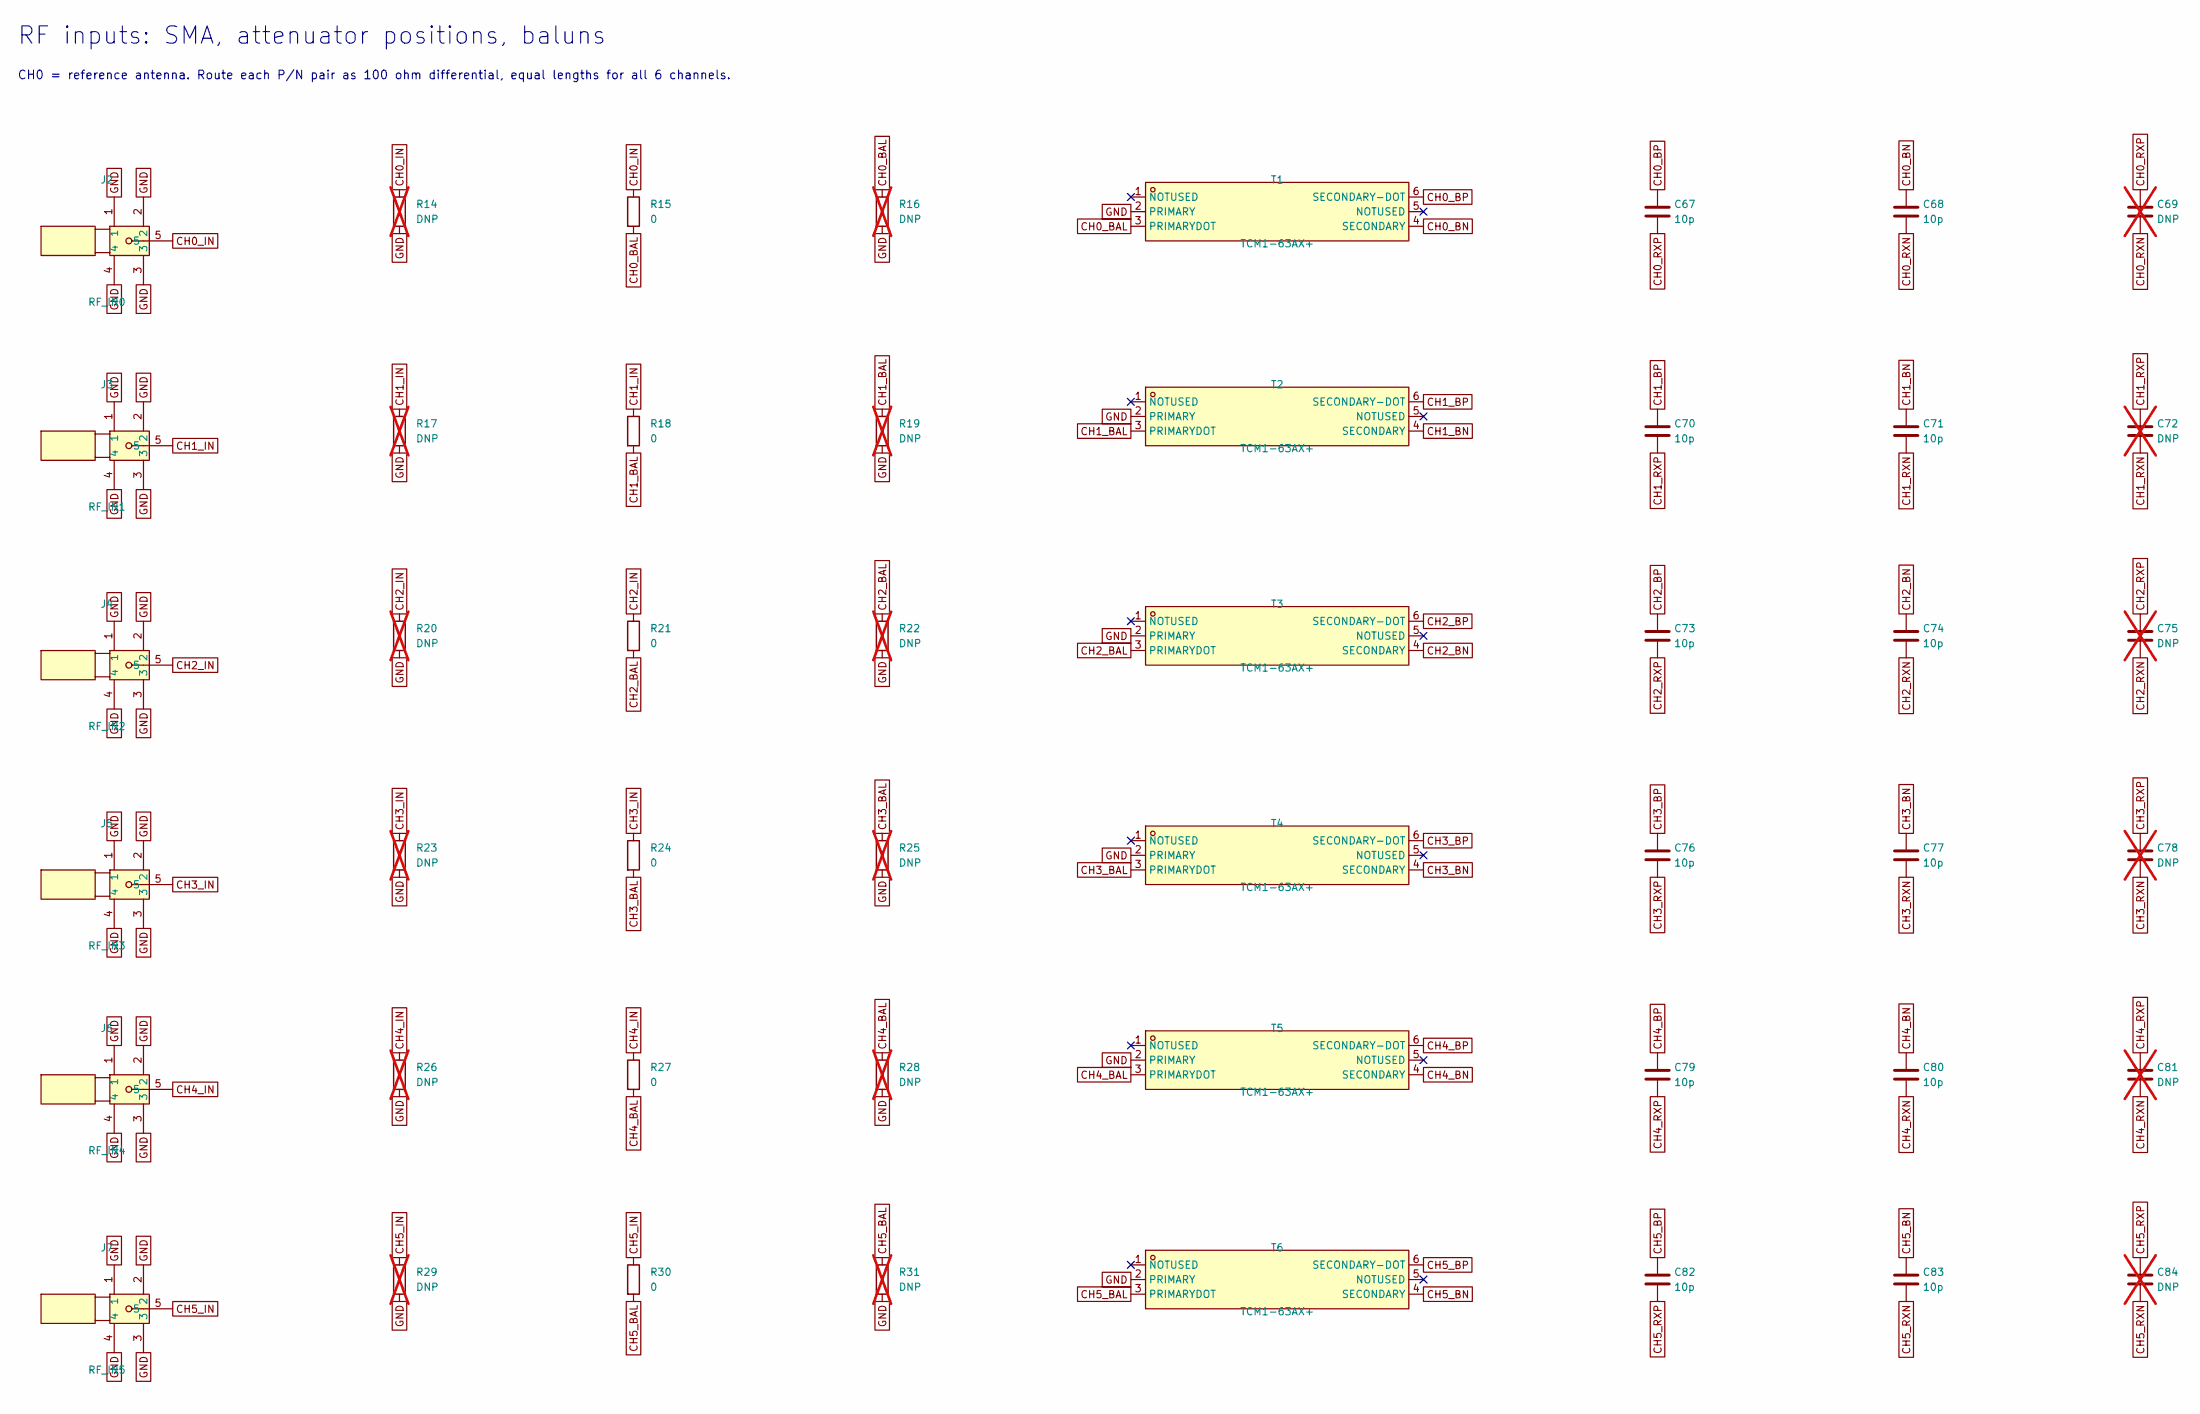
[picture p101: schematic rf_inputs.kicad_sch]

Parts:
C67, C68, C70, C71, C73, C74, C76, C77, C79, C80, C82, C83: 10p; C_0402_1005Metric
C69, C72, C75, C78, C81, C84: DNP; C_0402_1005Metric; not fitted
J2: RF_IN0; SMA-TH_BWSMA-KE-Z001; MPN BWSMA-KE-Z001; LCSC C496549
J3: RF_IN1; SMA-TH_BWSMA-KE-Z001; MPN BWSMA-KE-Z001; LCSC C496549
J4: RF_IN2; SMA-TH_BWSMA-KE-Z001; MPN BWSMA-KE-Z001; LCSC C496549
J5: RF_IN3; SMA-TH_BWSMA-KE-Z001; MPN BWSMA-KE-Z001; LCSC C496549
J6: RF_IN4; SMA-TH_BWSMA-KE-Z001; MPN BWSMA-KE-Z001; LCSC C496549
J7: RF_IN5; SMA-TH_BWSMA-KE-Z001; MPN BWSMA-KE-Z001; LCSC C496549
R14, R16, R17, R19, R20, R22, R23, R25, R26, R28, R29, R31: DNP; R_0402_1005Metric; not fitted
R15, R18, R21, R24, R27, R30: 0; R_0402_1005Metric; LCSC C17168
T1, T2, T3, T4, T5, T6: TCM1-63AX+; XFMR-SMD_TCM1-63AX; MPN TCM1-63AX+; LCSC C494678

Connections:
CH0_BAL: R15.2, R16.1, T1.3 (PRIMARYDOT)
CH0_BN: C68.1, T1.4 (SECONDARY)
CH0_BP: C67.1, T1.6 (SECONDARY-DOT)
CH0_IN: J2.5, R14.1, R15.1
CH0_RXN: C68.2, C69.2
CH0_RXP: C67.2, C69.1
CH1_BAL: R18.2, R19.1, T2.3 (PRIMARYDOT)
CH1_BN: C71.1, T2.4 (SECONDARY)
CH1_BP: C70.1, T2.6 (SECONDARY-DOT)
CH1_IN: J3.5, R17.1, R18.1
CH1_RXN: C71.2, C72.2
CH1_RXP: C70.2, C72.1
CH2_BAL: R21.2, R22.1, T3.3 (PRIMARYDOT)
CH2_BN: C74.1, T3.4 (SECONDARY)
CH2_BP: C73.1, T3.6 (SECONDARY-DOT)
CH2_IN: J4.5, R20.1, R21.1
CH2_RXN: C74.2, C75.2
CH2_RXP: C73.2, C75.1
CH3_BAL: R24.2, R25.1, T4.3 (PRIMARYDOT)
CH3_BN: C77.1, T4.4 (SECONDARY)
CH3_BP: C76.1, T4.6 (SECONDARY-DOT)
CH3_IN: J5.5, R23.1, R24.1
CH3_RXN: C77.2, C78.2
CH3_RXP: C76.2, C78.1
CH4_BAL: R27.2, R28.1, T5.3 (PRIMARYDOT)
CH4_BN: C80.1, T5.4 (SECONDARY)
CH4_BP: C79.1, T5.6 (SECONDARY-DOT)
CH4_IN: J6.5, R26.1, R27.1
CH4_RXN: C80.2, C81.2
CH4_RXP: C79.2, C81.1
CH5_BAL: R30.2, R31.1, T6.3 (PRIMARYDOT)
CH5_BN: C83.1, T6.4 (SECONDARY)
CH5_BP: C82.1, T6.6 (SECONDARY-DOT)
CH5_IN: J7.5, R29.1, R30.1
CH5_RXN: C83.2, C84.2
CH5_RXP: C82.2, C84.1
GND: J2.1, J2.2, J2.3, J2.4, J3.1, J3.2, J3.3, J3.4, J4.1, J4.2, J4.3, J4.4, J5.1, J5.2, J5.3, J5.4, J6.1, J6.2, J6.3, J6.4, J7.1, J7.2, J7.3, J7.4, R14.2, R16.2, R17.2, R19.2, R20.2, R22.2, R23.2, R25.2, R26.2, R28.2, R29.2, R31.2, T1.2 (PRIMARY), T2.2 (PRIMARY), T3.2 (PRIMARY), T4.2 (PRIMARY), T5.2 (PRIMARY), T6.2 (PRIMARY)

Notes on the sheet:
RF inputs: SMA, attenuator positions, baluns
CH0 = reference antenna. Route each P/N pair as 100 ohm differential, equal lengths for all 6 channels.
