ajisrawi/passive-radar-counter-drone/firmware/vivado/board_c.xdc

# board_c: PL pins generated from board_c/board_c.netlist.json by firmware/vivado/gen_xdc.py - do not edit
# FPGA U1 = prc:XC7Z020-1CLG400C

set_property PACKAGE_PIN K18 [get_ports {ad1_dclk_n}]   ;# IO_L12N_T1_MRCC_35
set_property IOSTANDARD LVDS_25 [get_ports {ad1_dclk_n}]
set_property DIFF_TERM TRUE [get_ports {ad1_dclk_n}]
set_property PACKAGE_PIN K17 [get_ports {ad1_dclk_p}]   ;# IO_L12P_T1_MRCC_35
set_property IOSTANDARD LVDS_25 [get_ports {ad1_dclk_p}]
set_property DIFF_TERM TRUE [get_ports {ad1_dclk_p}]
set_property PACKAGE_PIN M18 [get_ports {ad1_fbclk_n}]   ;# IO_L8N_T1_AD10N_35
set_property IOSTANDARD LVDS_25 [get_ports {ad1_fbclk_n}]
set_property PACKAGE_PIN M17 [get_ports {ad1_fbclk_p}]   ;# IO_L8P_T1_AD10P_35
set_property IOSTANDARD LVDS_25 [get_ports {ad1_fbclk_p}]
set_property PACKAGE_PIN B20 [get_ports {ad1_frame_n}]   ;# IO_L1N_T0_AD0N_35
set_property IOSTANDARD LVDS_25 [get_ports {ad1_frame_n}]
set_property DIFF_TERM TRUE [get_ports {ad1_frame_n}]
set_property PACKAGE_PIN C20 [get_ports {ad1_frame_p}]   ;# IO_L1P_T0_AD0P_35
set_property IOSTANDARD LVDS_25 [get_ports {ad1_frame_p}]
set_property DIFF_TERM TRUE [get_ports {ad1_frame_p}]
set_property PACKAGE_PIN A20 [get_ports {ad1_rxd0_n}]   ;# IO_L2N_T0_AD8N_35
set_property IOSTANDARD LVDS_25 [get_ports {ad1_rxd0_n}]
set_property DIFF_TERM TRUE [get_ports {ad1_rxd0_n}]
set_property PACKAGE_PIN B19 [get_ports {ad1_rxd0_p}]   ;# IO_L2P_T0_AD8P_35
set_property IOSTANDARD LVDS_25 [get_ports {ad1_rxd0_p}]
set_property DIFF_TERM TRUE [get_ports {ad1_rxd0_p}]
set_property PACKAGE_PIN D18 [get_ports {ad1_rxd1_n}]   ;# IO_L3N_T0_DQS_AD1N_35
set_property IOSTANDARD LVDS_25 [get_ports {ad1_rxd1_n}]
set_property DIFF_TERM TRUE [get_ports {ad1_rxd1_n}]
set_property PACKAGE_PIN E17 [get_ports {ad1_rxd1_p}]   ;# IO_L3P_T0_DQS_AD1P_35
set_property IOSTANDARD LVDS_25 [get_ports {ad1_rxd1_p}]
set_property DIFF_TERM TRUE [get_ports {ad1_rxd1_p}]
set_property PACKAGE_PIN D20 [get_ports {ad1_rxd2_n}]   ;# IO_L4N_T0_35
set_property IOSTANDARD LVDS_25 [get_ports {ad1_rxd2_n}]
set_property DIFF_TERM TRUE [get_ports {ad1_rxd2_n}]
set_property PACKAGE_PIN D19 [get_ports {ad1_rxd2_p}]   ;# IO_L4P_T0_35
set_property IOSTANDARD LVDS_25 [get_ports {ad1_rxd2_p}]
set_property DIFF_TERM TRUE [get_ports {ad1_rxd2_p}]
set_property PACKAGE_PIN E19 [get_ports {ad1_rxd3_n}]   ;# IO_L5N_T0_AD9N_35
set_property IOSTANDARD LVDS_25 [get_ports {ad1_rxd3_n}]
set_property DIFF_TERM TRUE [get_ports {ad1_rxd3_n}]
set_property PACKAGE_PIN E18 [get_ports {ad1_rxd3_p}]   ;# IO_L5P_T0_AD9P_35
set_property IOSTANDARD LVDS_25 [get_ports {ad1_rxd3_p}]
set_property DIFF_TERM TRUE [get_ports {ad1_rxd3_p}]
set_property PACKAGE_PIN F17 [get_ports {ad1_rxd4_n}]   ;# IO_L6N_T0_VREF_35
set_property IOSTANDARD LVDS_25 [get_ports {ad1_rxd4_n}]
set_property DIFF_TERM TRUE [get_ports {ad1_rxd4_n}]
set_property PACKAGE_PIN F16 [get_ports {ad1_rxd4_p}]   ;# IO_L6P_T0_35
set_property IOSTANDARD LVDS_25 [get_ports {ad1_rxd4_p}]
set_property DIFF_TERM TRUE [get_ports {ad1_rxd4_p}]
set_property PACKAGE_PIN M20 [get_ports {ad1_rxd5_n}]   ;# IO_L7N_T1_AD2N_35
set_property IOSTANDARD LVDS_25 [get_ports {ad1_rxd5_n}]
set_property DIFF_TERM TRUE [get_ports {ad1_rxd5_n}]
set_property PACKAGE_PIN M19 [get_ports {ad1_rxd5_p}]   ;# IO_L7P_T1_AD2P_35
set_property IOSTANDARD LVDS_25 [get_ports {ad1_rxd5_p}]
set_property DIFF_TERM TRUE [get_ports {ad1_rxd5_p}]
set_property PACKAGE_PIN H17 [get_ports {ad2_dclk_n}]   ;# IO_L13N_T2_MRCC_35
set_property IOSTANDARD LVDS_25 [get_ports {ad2_dclk_n}]
set_property DIFF_TERM TRUE [get_ports {ad2_dclk_n}]
set_property PACKAGE_PIN H16 [get_ports {ad2_dclk_p}]   ;# IO_L13P_T2_MRCC_35
set_property IOSTANDARD LVDS_25 [get_ports {ad2_dclk_p}]
set_property DIFF_TERM TRUE [get_ports {ad2_dclk_p}]
set_property PACKAGE_PIN G15 [get_ports {ad2_fbclk_n}]   ;# IO_L19N_T3_VREF_35
set_property IOSTANDARD LVDS_25 [get_ports {ad2_fbclk_n}]
set_property PACKAGE_PIN H15 [get_ports {ad2_fbclk_p}]   ;# IO_L19P_T3_35
set_property IOSTANDARD LVDS_25 [get_ports {ad2_fbclk_p}]
set_property PACKAGE_PIN L20 [get_ports {ad2_frame_n}]   ;# IO_L9N_T1_DQS_AD3N_35
set_property IOSTANDARD LVDS_25 [get_ports {ad2_frame_n}]
set_property DIFF_TERM TRUE [get_ports {ad2_frame_n}]
set_property PACKAGE_PIN L19 [get_ports {ad2_frame_p}]   ;# IO_L9P_T1_DQS_AD3P_35
set_property IOSTANDARD LVDS_25 [get_ports {ad2_frame_p}]
set_property DIFF_TERM TRUE [get_ports {ad2_frame_p}]
set_property PACKAGE_PIN J19 [get_ports {ad2_rxd0_n}]   ;# IO_L10N_T1_AD11N_35
set_property IOSTANDARD LVDS_25 [get_ports {ad2_rxd0_n}]
set_property DIFF_TERM TRUE [get_ports {ad2_rxd0_n}]
set_property PACKAGE_PIN K19 [get_ports {ad2_rxd0_p}]   ;# IO_L10P_T1_AD11P_35
set_property IOSTANDARD LVDS_25 [get_ports {ad2_rxd0_p}]
set_property DIFF_TERM TRUE [get_ports {ad2_rxd0_p}]
set_property PACKAGE_PIN H18 [get_ports {ad2_rxd1_n}]   ;# IO_L14N_T2_AD4N_SRCC_35
set_property IOSTANDARD LVDS_25 [get_ports {ad2_rxd1_n}]
set_property DIFF_TERM TRUE [get_ports {ad2_rxd1_n}]
set_property PACKAGE_PIN J18 [get_ports {ad2_rxd1_p}]   ;# IO_L14P_T2_AD4P_SRCC_35
set_property IOSTANDARD LVDS_25 [get_ports {ad2_rxd1_p}]
set_property DIFF_TERM TRUE [get_ports {ad2_rxd1_p}]
set_property PACKAGE_PIN F20 [get_ports {ad2_rxd2_n}]   ;# IO_L15N_T2_DQS_AD12N_35
set_property IOSTANDARD LVDS_25 [get_ports {ad2_rxd2_n}]
set_property DIFF_TERM TRUE [get_ports {ad2_rxd2_n}]
set_property PACKAGE_PIN F19 [get_ports {ad2_rxd2_p}]   ;# IO_L15P_T2_DQS_AD12P_35
set_property IOSTANDARD LVDS_25 [get_ports {ad2_rxd2_p}]
set_property DIFF_TERM TRUE [get_ports {ad2_rxd2_p}]
set_property PACKAGE_PIN G18 [get_ports {ad2_rxd3_n}]   ;# IO_L16N_T2_35
set_property IOSTANDARD LVDS_25 [get_ports {ad2_rxd3_n}]
set_property DIFF_TERM TRUE [get_ports {ad2_rxd3_n}]
set_property PACKAGE_PIN G17 [get_ports {ad2_rxd3_p}]   ;# IO_L16P_T2_35
set_property IOSTANDARD LVDS_25 [get_ports {ad2_rxd3_p}]
set_property DIFF_TERM TRUE [get_ports {ad2_rxd3_p}]
set_property PACKAGE_PIN H20 [get_ports {ad2_rxd4_n}]   ;# IO_L17N_T2_AD5N_35
set_property IOSTANDARD LVDS_25 [get_ports {ad2_rxd4_n}]
set_property DIFF_TERM TRUE [get_ports {ad2_rxd4_n}]
set_property PACKAGE_PIN J20 [get_ports {ad2_rxd4_p}]   ;# IO_L17P_T2_AD5P_35
set_property IOSTANDARD LVDS_25 [get_ports {ad2_rxd4_p}]
set_property DIFF_TERM TRUE [get_ports {ad2_rxd4_p}]
set_property PACKAGE_PIN G20 [get_ports {ad2_rxd5_n}]   ;# IO_L18N_T2_AD13N_35
set_property IOSTANDARD LVDS_25 [get_ports {ad2_rxd5_n}]
set_property DIFF_TERM TRUE [get_ports {ad2_rxd5_n}]
set_property PACKAGE_PIN G19 [get_ports {ad2_rxd5_p}]   ;# IO_L18P_T2_AD13P_35
set_property IOSTANDARD LVDS_25 [get_ports {ad2_rxd5_p}]
set_property DIFF_TERM TRUE [get_ports {ad2_rxd5_p}]
set_property PACKAGE_PIN U19 [get_ports {ad3_dclk_n}]   ;# IO_L12N_T1_MRCC_34
set_property IOSTANDARD LVDS_25 [get_ports {ad3_dclk_n}]
set_property DIFF_TERM TRUE [get_ports {ad3_dclk_n}]
set_property PACKAGE_PIN U18 [get_ports {ad3_dclk_p}]   ;# IO_L12P_T1_MRCC_34
set_property IOSTANDARD LVDS_25 [get_ports {ad3_dclk_p}]
set_property DIFF_TERM TRUE [get_ports {ad3_dclk_p}]
set_property PACKAGE_PIN U17 [get_ports {ad3_fbclk_n}]   ;# IO_L9N_T1_DQS_34
set_property IOSTANDARD LVDS_25 [get_ports {ad3_fbclk_n}]
set_property PACKAGE_PIN T16 [get_ports {ad3_fbclk_p}]   ;# IO_L9P_T1_DQS_34
set_property IOSTANDARD LVDS_25 [get_ports {ad3_fbclk_p}]
set_property PACKAGE_PIN T10 [get_ports {ad3_frame_n}]   ;# IO_L1N_T0_34
set_property IOSTANDARD LVDS_25 [get_ports {ad3_frame_n}]
set_property DIFF_TERM TRUE [get_ports {ad3_frame_n}]
set_property PACKAGE_PIN T11 [get_ports {ad3_frame_p}]   ;# IO_L1P_T0_34
set_property IOSTANDARD LVDS_25 [get_ports {ad3_frame_p}]
set_property DIFF_TERM TRUE [get_ports {ad3_frame_p}]
set_property PACKAGE_PIN U12 [get_ports {ad3_rxd0_n}]   ;# IO_L2N_T0_34
set_property IOSTANDARD LVDS_25 [get_ports {ad3_rxd0_n}]
set_property DIFF_TERM TRUE [get_ports {ad3_rxd0_n}]
set_property PACKAGE_PIN T12 [get_ports {ad3_rxd0_p}]   ;# IO_L2P_T0_34
set_property IOSTANDARD LVDS_25 [get_ports {ad3_rxd0_p}]
set_property DIFF_TERM TRUE [get_ports {ad3_rxd0_p}]
set_property PACKAGE_PIN W13 [get_ports {ad3_rxd1_n}]   ;# IO_L4N_T0_34
set_property IOSTANDARD LVDS_25 [get_ports {ad3_rxd1_n}]
set_property DIFF_TERM TRUE [get_ports {ad3_rxd1_n}]
set_property PACKAGE_PIN V12 [get_ports {ad3_rxd1_p}]   ;# IO_L4P_T0_34
set_property IOSTANDARD LVDS_25 [get_ports {ad3_rxd1_p}]
set_property DIFF_TERM TRUE [get_ports {ad3_rxd1_p}]
set_property PACKAGE_PIN T15 [get_ports {ad3_rxd2_n}]   ;# IO_L5N_T0_34
set_property IOSTANDARD LVDS_25 [get_ports {ad3_rxd2_n}]
set_property DIFF_TERM TRUE [get_ports {ad3_rxd2_n}]
set_property PACKAGE_PIN T14 [get_ports {ad3_rxd2_p}]   ;# IO_L5P_T0_34
set_property IOSTANDARD LVDS_25 [get_ports {ad3_rxd2_p}]
set_property DIFF_TERM TRUE [get_ports {ad3_rxd2_p}]
set_property PACKAGE_PIN R14 [get_ports {ad3_rxd3_n}]   ;# IO_L6N_T0_VREF_34
set_property IOSTANDARD LVDS_25 [get_ports {ad3_rxd3_n}]
set_property DIFF_TERM TRUE [get_ports {ad3_rxd3_n}]
set_property PACKAGE_PIN P14 [get_ports {ad3_rxd3_p}]   ;# IO_L6P_T0_34
set_property IOSTANDARD LVDS_25 [get_ports {ad3_rxd3_p}]
set_property DIFF_TERM TRUE [get_ports {ad3_rxd3_p}]
set_property PACKAGE_PIN Y17 [get_ports {ad3_rxd4_n}]   ;# IO_L7N_T1_34
set_property IOSTANDARD LVDS_25 [get_ports {ad3_rxd4_n}]
set_property DIFF_TERM TRUE [get_ports {ad3_rxd4_n}]
set_property PACKAGE_PIN Y16 [get_ports {ad3_rxd4_p}]   ;# IO_L7P_T1_34
set_property IOSTANDARD LVDS_25 [get_ports {ad3_rxd4_p}]
set_property DIFF_TERM TRUE [get_ports {ad3_rxd4_p}]
set_property PACKAGE_PIN Y14 [get_ports {ad3_rxd5_n}]   ;# IO_L8N_T1_34
set_property IOSTANDARD LVDS_25 [get_ports {ad3_rxd5_n}]
set_property DIFF_TERM TRUE [get_ports {ad3_rxd5_n}]
set_property PACKAGE_PIN W14 [get_ports {ad3_rxd5_p}]   ;# IO_L8P_T1_34
set_property IOSTANDARD LVDS_25 [get_ports {ad3_rxd5_p}]
set_property DIFF_TERM TRUE [get_ports {ad3_rxd5_p}]
set_property PACKAGE_PIN P20 [get_ports {ad_enable}]   ;# IO_L14N_T2_SRCC_34
set_property IOSTANDARD LVCMOS25 [get_ports {ad_enable}]
set_property PACKAGE_PIN W20 [get_ports {ad_en_agc}]   ;# IO_L16N_T2_34
set_property IOSTANDARD LVCMOS25 [get_ports {ad_en_agc}]
set_property PACKAGE_PIN N20 [get_ports {ad_resetb}]   ;# IO_L14P_T2_SRCC_34
set_property IOSTANDARD LVCMOS25 [get_ports {ad_resetb}]
set_property PACKAGE_PIN U20 [get_ports {ad_sync_in}]   ;# IO_L15N_T2_DQS_34
set_property IOSTANDARD LVCMOS25 [get_ports {ad_sync_in}]
set_property PACKAGE_PIN T20 [get_ports {ad_txnrx}]   ;# IO_L15P_T2_DQS_34
set_property IOSTANDARD LVCMOS25 [get_ports {ad_txnrx}]
set_property PACKAGE_PIN V20 [get_ports {cal_en_fpga}]   ;# IO_L16P_T2_34
set_property IOSTANDARD LVCMOS25 [get_ports {cal_en_fpga}]
set_property PACKAGE_PIN Y9 [get_ports {fmc_prsnt_l}]   ;# IO_L14P_T2_SRCC_13
set_property IOSTANDARD LVCMOS33 [get_ports {fmc_prsnt_l}]
set_property PACKAGE_PIN L17 [get_ports {fpga_refclk_n}]   ;# IO_L11N_T1_SRCC_35
set_property IOSTANDARD LVDS_25 [get_ports {fpga_refclk_n}]
set_property PACKAGE_PIN L16 [get_ports {fpga_refclk_p}]   ;# IO_L11P_T1_SRCC_35
set_property IOSTANDARD LVDS_25 [get_ports {fpga_refclk_p}]
set_property PACKAGE_PIN U7 [get_ports {gnss_pps}]   ;# IO_L11P_T1_SRCC_13
set_property IOSTANDARD LVCMOS33 [get_ports {gnss_pps}]
set_property PACKAGE_PIN U10 [get_ports {gnss_resetn}]   ;# IO_L12N_T1_MRCC_13
set_property IOSTANDARD LVCMOS33 [get_ports {gnss_resetn}]
set_property PACKAGE_PIN T9 [get_ports {gnss_rxd}]   ;# IO_L12P_T1_MRCC_13
set_property IOSTANDARD LVCMOS33 [get_ports {gnss_rxd}]
set_property PACKAGE_PIN V7 [get_ports {gnss_txd}]   ;# IO_L11N_T1_SRCC_13
set_property IOSTANDARD LVCMOS33 [get_ports {gnss_txd}]
set_property PACKAGE_PIN Y7 [get_ports {led_pl0}]   ;# IO_L13P_T2_MRCC_13
set_property IOSTANDARD LVCMOS33 [get_ports {led_pl0}]
set_property PACKAGE_PIN Y6 [get_ports {led_pl1}]   ;# IO_L13N_T2_MRCC_13
set_property IOSTANDARD LVCMOS33 [get_ports {led_pl1}]
set_property PACKAGE_PIN V15 [get_ports {spi_clk}]   ;# IO_L10P_T1_34
set_property IOSTANDARD LVCMOS25 [get_ports {spi_clk}]
set_property PACKAGE_PIN W15 [get_ports {spi_di}]   ;# IO_L10N_T1_34
set_property IOSTANDARD LVCMOS25 [get_ports {spi_di}]
set_property PACKAGE_PIN U14 [get_ports {spi_do}]   ;# IO_L11P_T1_SRCC_34
set_property IOSTANDARD LVCMOS25 [get_ports {spi_do}]
set_property PACKAGE_PIN U15 [get_ports {spi_enb1}]   ;# IO_L11N_T1_SRCC_34
set_property IOSTANDARD LVCMOS25 [get_ports {spi_enb1}]
set_property PACKAGE_PIN N18 [get_ports {spi_enb2}]   ;# IO_L13P_T2_MRCC_34
set_property IOSTANDARD LVCMOS25 [get_ports {spi_enb2}]
set_property PACKAGE_PIN P19 [get_ports {spi_enb3}]   ;# IO_L13N_T2_MRCC_34
set_property IOSTANDARD LVCMOS25 [get_ports {spi_enb3}]

# clocks: AD9361 DATA_CLK (LVDS, up to 245.76 MHz on C2 / 32 MHz on C at 8 MS/s x 4 in 2R2T DDR)
create_clock -name ad1_dclk -period 4.069 [get_ports {ad1_dclk_p}]
create_clock -name ad2_dclk -period 4.069 [get_ports {ad2_dclk_p}]
create_clock -name ad3_dclk -period 4.069 [get_ports {ad3_dclk_p}]
set_clock_groups -asynchronous -group [get_clocks -include_generated_clocks clk_fpga_0] -group [get_clocks -include_generated_clocks ad1_dclk] -group [get_clocks -include_generated_clocks ad2_dclk] -group [get_clocks -include_generated_clocks ad3_dclk]
