ajisrawi/passive-radar-counter-drone/hardware/tools/sexp.py

"""Minimal S-expression reader/writer for KiCad files."""
import re

_TOKEN = re.compile(r'\s*(?:(\()|(\))|"((?:[^"\\]|\\.)*)"|([^\s()"]+))', re.S)


class Sym(str):
    """Unquoted atom (keyword or number) as opposed to a quoted string."""


def parse(text):
    stack, cur = [], []
    pos = 0
    n = len(text)
    while pos < n:
        m = _TOKEN.match(text, pos)
        if not m:
            if text[pos:].strip() == "":
                break
            raise ValueError(f"parse error at {pos}: {text[pos:pos+40]!r}")
        pos = m.end()
        if m.group(1):
            stack.append(cur)
            cur = []
        elif m.group(2):
            done = cur
            cur = stack.pop()
            cur.append(done)
        elif m.group(3) is not None:
            cur.append(m.group(3).replace('\\"', '"').replace("\\\\", "\\"))
        else:
            cur.append(Sym(m.group(4)))
    return cur[0] if len(cur) == 1 else cur


def dumps(node, indent=0):
    if isinstance(node, list):
        if not node:
            return "()"
        simple = all(not isinstance(x, list) for x in node)
        if simple and len(node) < 12:
            return "(" + " ".join(dumps(x) for x in node) + ")"
        pad = "  " * (indent + 1)
        head = dumps(node[0])
        body = "\n".join(pad + dumps(x, indent + 1) for x in node[1:])
        return f"({head}\n{body}\n{'  ' * indent})"
    if isinstance(node, Sym):
        return str(node)
    if isinstance(node, bool):
        return "yes" if node else "no"
    if isinstance(node, (int, float)):
        return fmt_num(node)
    s = str(node).replace("\\", "\\\\").replace('"', '\\"')
    return f'"{s}"'


def fmt_num(v):
    if isinstance(v, int):
        return str(v)
    s = f"{v:.4f}".rstrip("0").rstrip(".")
    return "0" if s in ("-0", "") else s


def find(node, key):
    """Children lists whose head == key."""
    return [c for c in node if isinstance(c, list) and c and c[0] == key]


def find1(node, key):
    r = find(node, key)
    return r[0] if r else None


def prop(node, name):
    for p in find(node, "property"):
        if len(p) > 2 and p[1] == name:
            return p[2]
    return None
