ajisrawi/passive-radar-counter-drone/(commit log)

2026-10-28 Passive radar for counter-drone: TV + 4G + 5G
    Design document and Python simulation of the full passive-radar chain;
    receiver hardware (Board A2 front end in four band builds, Board B
    digitizer, Board C/C2 Zynq processor) with schematics, layouts and fab
    files; FPGA/ARM firmware with on-board micro-Doppler classification,
    verified in simulation; antenna arrays, LPDA references and their PCBs;
    combined radome and all-in-one receiver enclosure with Blender models.
    [ad9361_1.kicad_sch, ad9361_2.kicad_sch, ad9361_3.kicad_sch, board_a.dsn, board_a.kicad_pcb, board_a.kicad_sch, board_a.pcbdoc, board_a.schdoc]
2026-10-28 Illustrated README: logo, banner, PCB snapshots, renders, results
    Adds a logo and banner, rendered snapshots of Boards C2, B, A2 and C
    (hardware/tools/pcb_render.py), and a README that walks through the
    system with simulation plots, firmware results, antennas, radome and
    enclosure renders.
