ajisrawi/passive-radar-counter-drone/(notices)

Notices in the files:
README.md:
License: all rights reserved
